matt-lewton9/ME-463-Can-Crusher/C104-005 Panel_twocan_smol_smol200.png

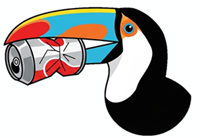
C104-005 Panel_twocan_smol_smol200.png
