matt-lewton9/ME-463-Can-Crusher/PRE-RELEASE DWG/C103-004_PISTON PRE-RELEASE.pdf

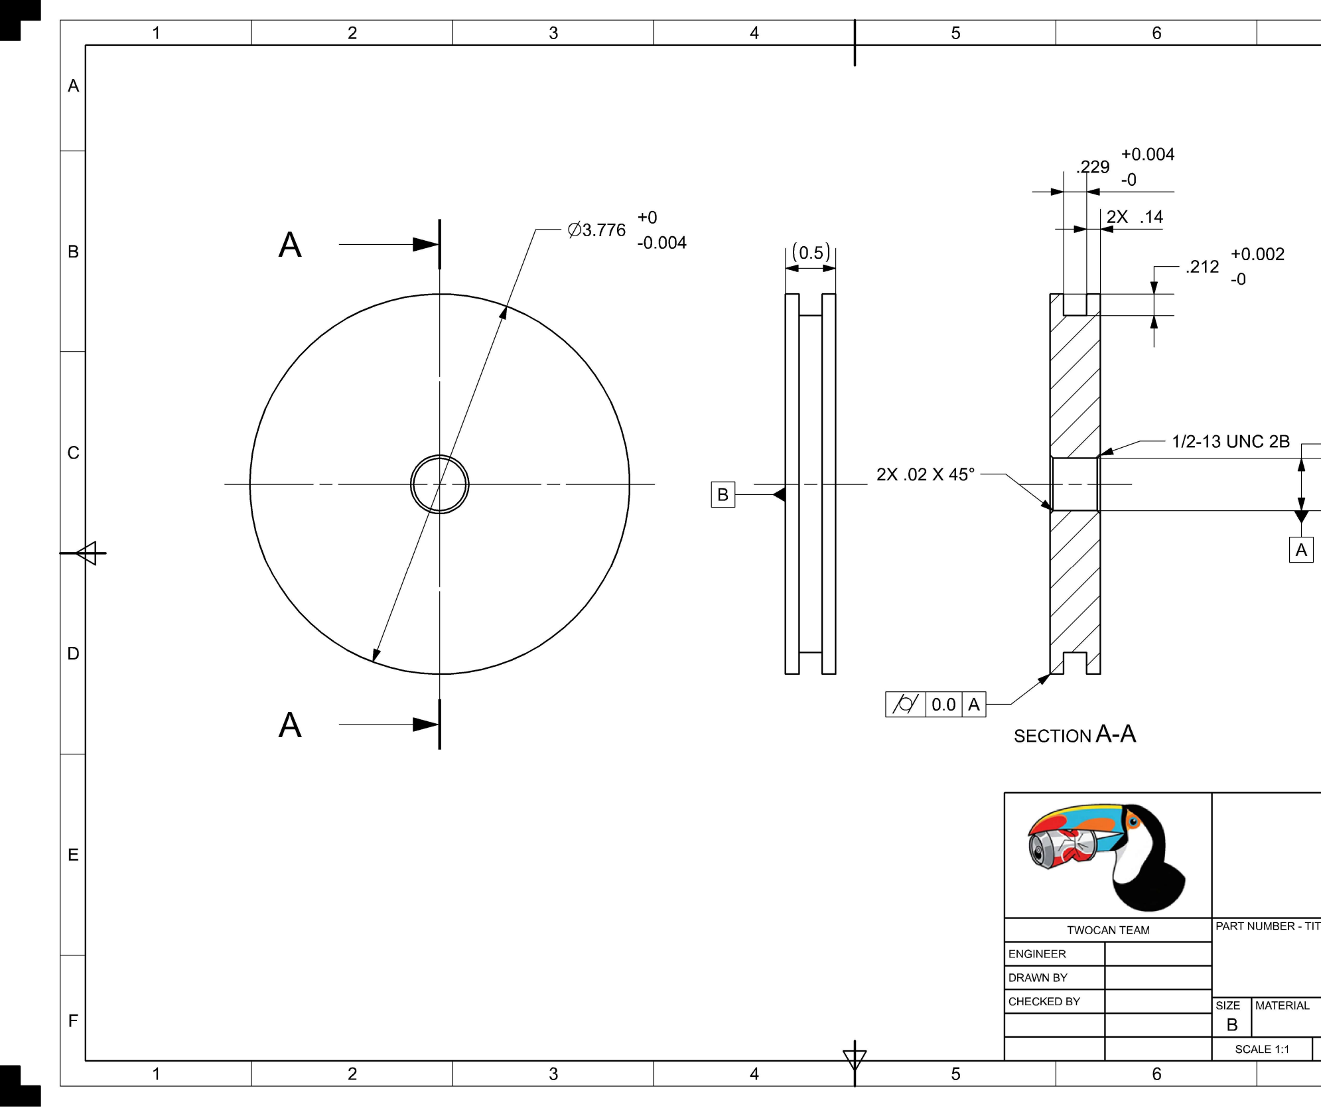
[picture p18: page 1]
