matt-lewton9/ME-463-Can-Crusher/PRE-RELEASE DWG/C104-001 REGULATOR PLATE_dwg1_PRE-RELEASE.pdf

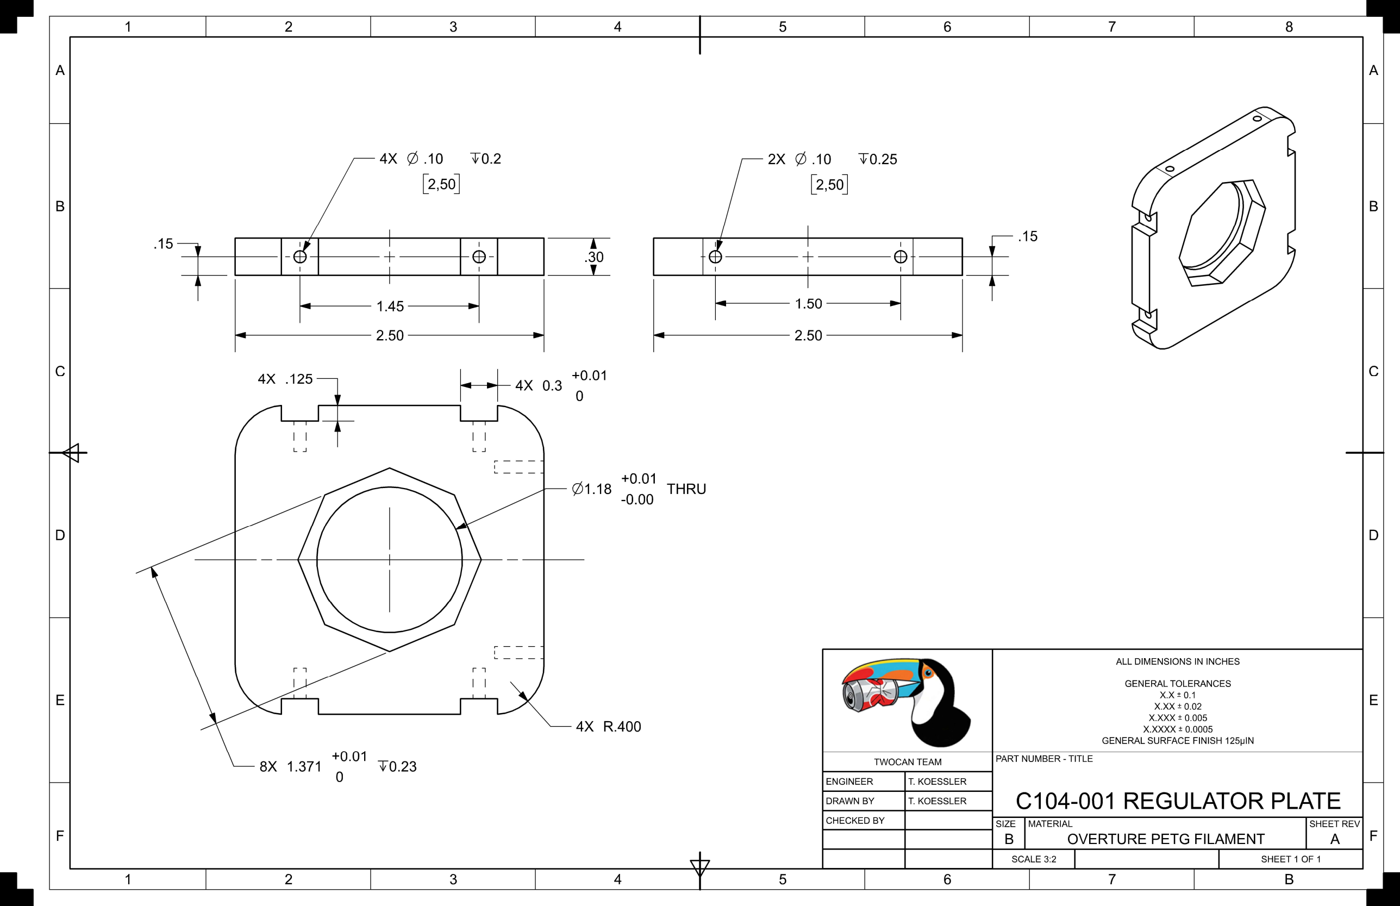
[picture p19: page 1]
