matt-lewton9/ME-463-Can-Crusher/PRE-RELEASE DWG/C104-002 STEPPER PLATE_dwg1_PRE-RELEASE.pdf

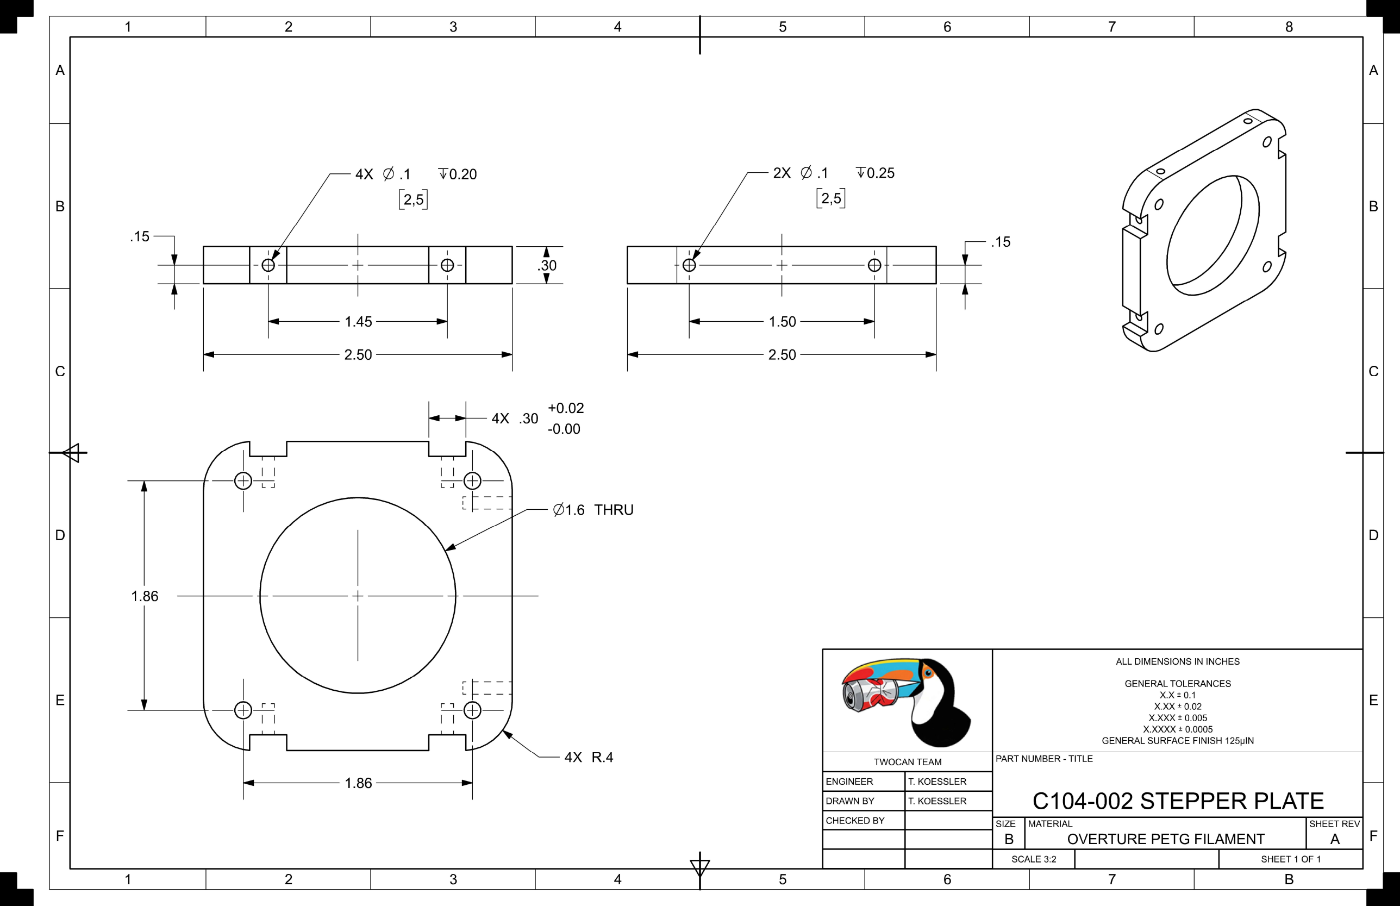
[picture p20: page 1]
