matt-lewton9/ME-463-Can-Crusher/PRE-RELEASE DWG/C104-003 FRAME MONTING_dwg1.pdf

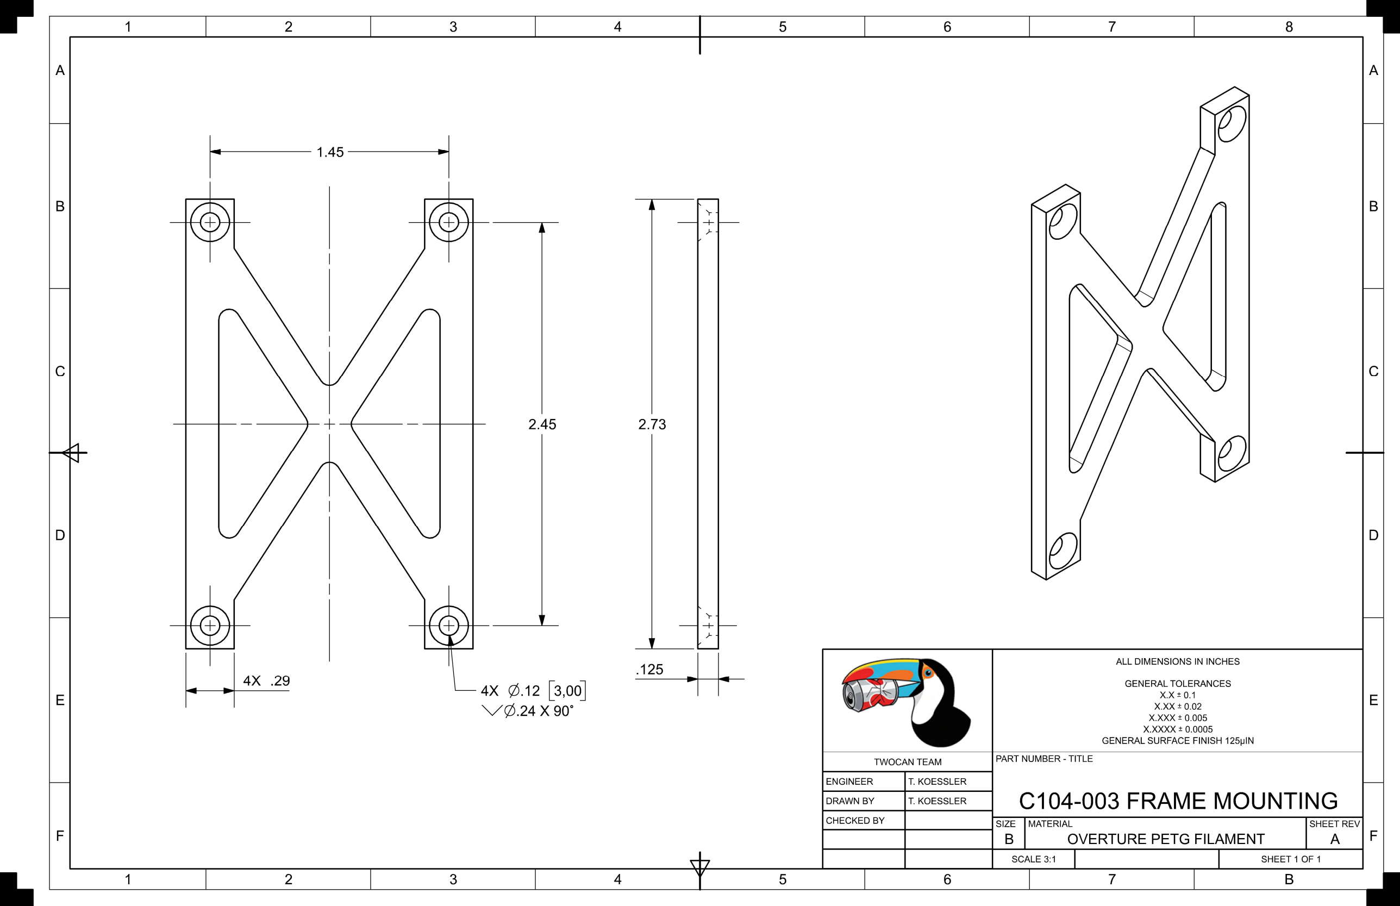
[picture p21: page 1]
