matt-lewton9/ME-463-Can-Crusher/PRE-RELEASE DWG/C104-004 COG_dwg1.pdf

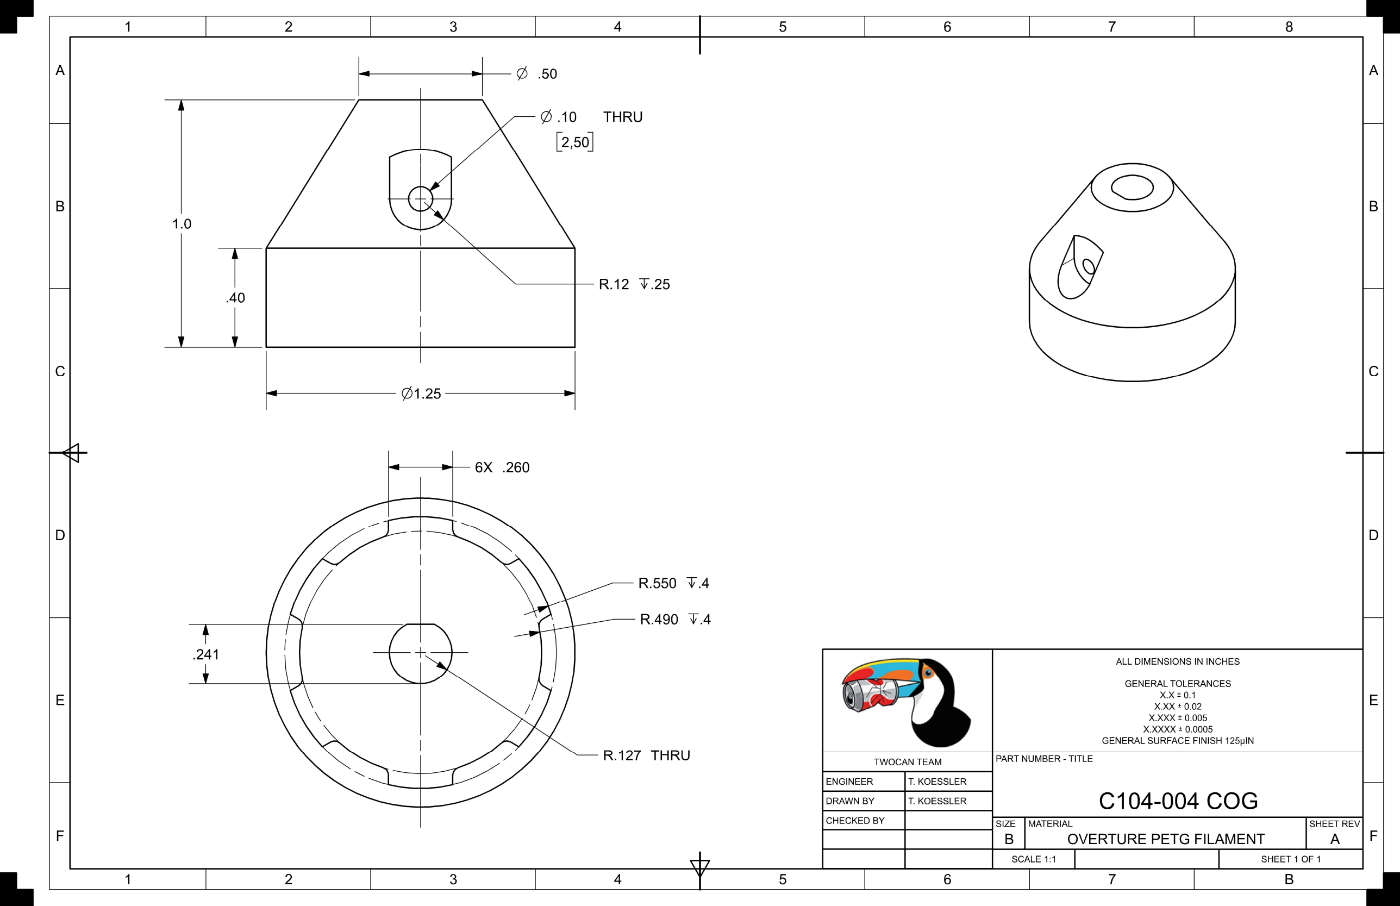
[picture p22: page 1]
