matt-lewton9/ME-463-Can-Crusher/Controller/controller_V3_matlab/FSM_DRAFT/IMG_4139.jpg

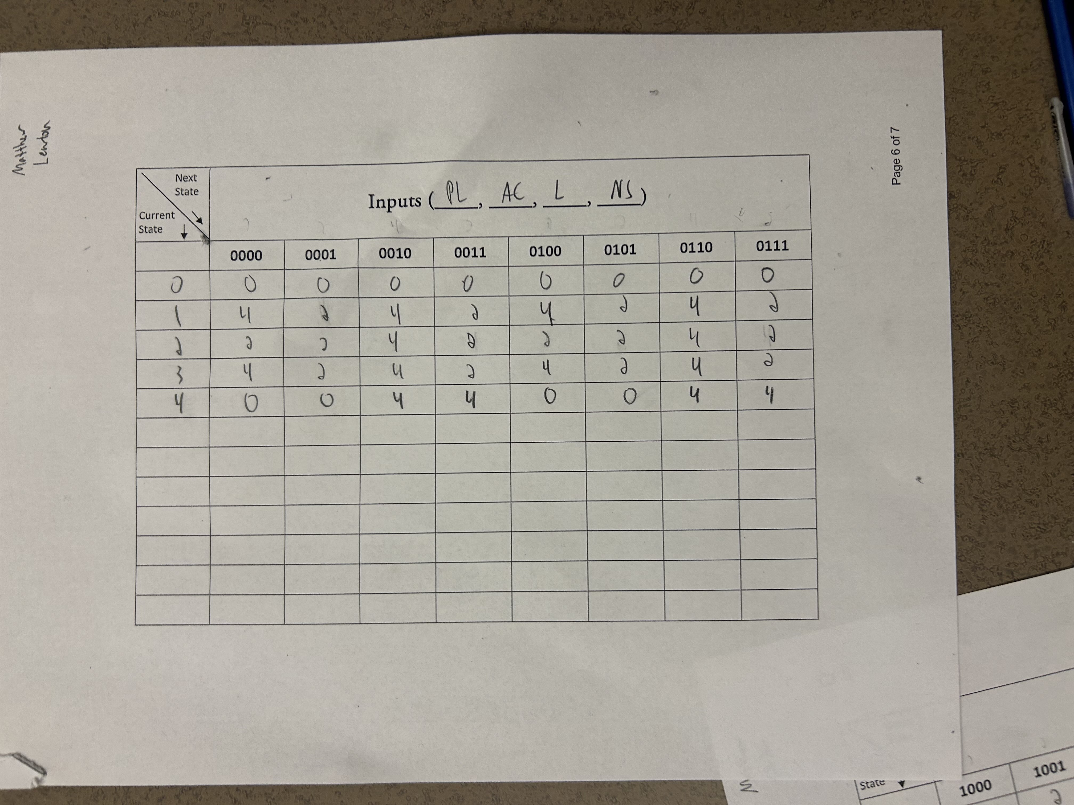
Controller/controller_V3_matlab/FSM_DRAFT/IMG_4139.jpg
