matt-lewton9/ME-463-Can-Crusher/pelim proto/C101-501 BOTTOM STRUCTURE ASSEMBLY.3mf

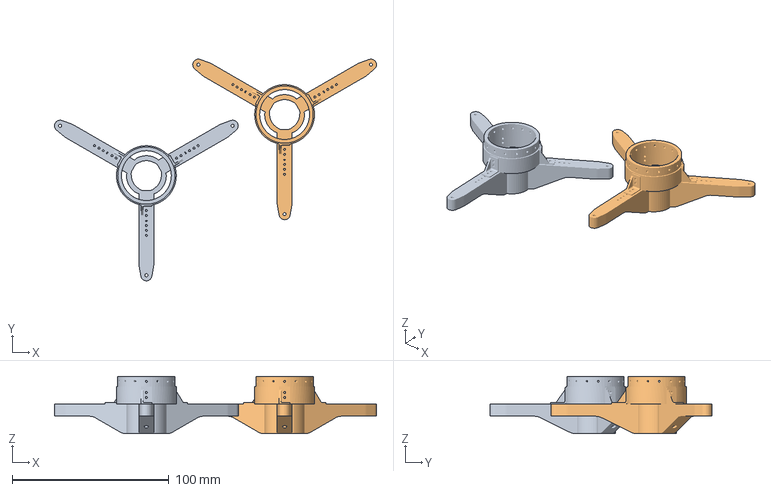
[picture p25: CAD file, 2025-09-25]
pelim proto/C101-501 BOTTOM STRUCTURE ASSEMBLY.3mf
205.2 x 141.3 x 36.5 mm
C101-501 BOTTOM STRUCTURE ASSEMBLY x 2
