matt-lewton9/ME-463-Can-Crusher/pelim proto/C102-501 TOP STRUCTURE ASSEMBLY.3mf

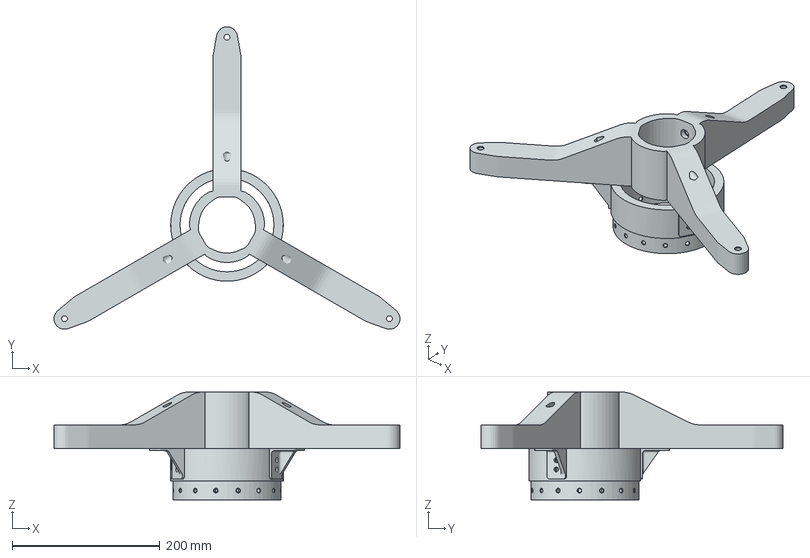
[picture p26: CAD file, 2025-09-25]
pelim proto/C102-501 TOP STRUCTURE ASSEMBLY.3mf
468.4 x 409.5 x 146.0 mm
