matt-lewton9/ME-463-Can-Crusher/MFG_Files/pulley_plates.dxf

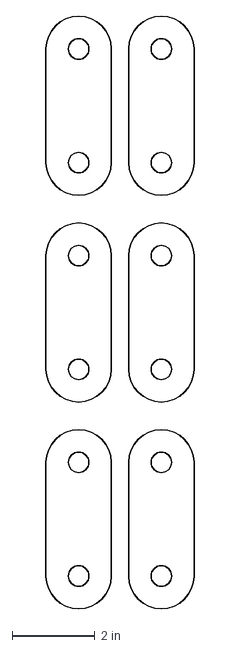
[picture p27: CAD file, 2025-11-15]
MFG_Files/pulley_plates.dxf
3.58 x 14.3 in
