matt-lewton9/ME-463-Can-Crusher/pelim proto/toob.3mf

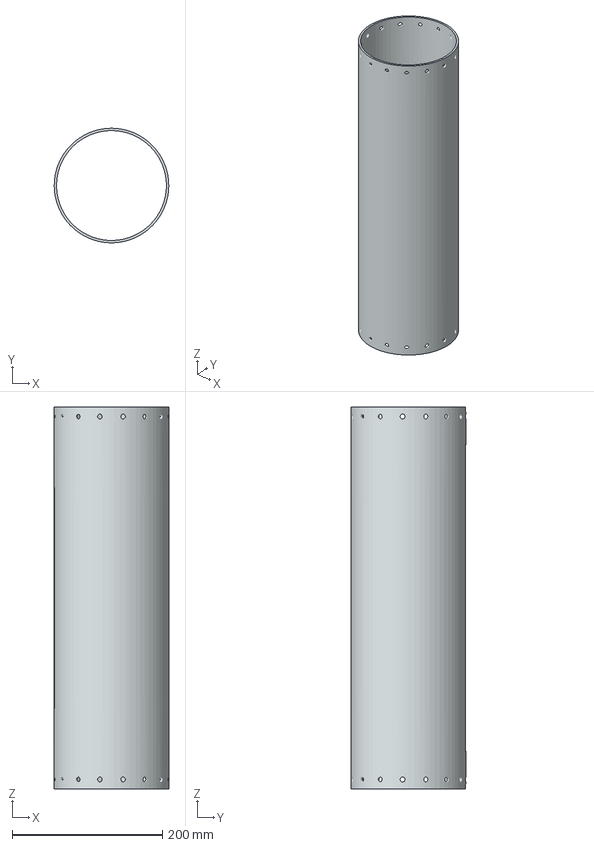
[picture p28: CAD file, 2025-09-25]
pelim proto/toob.3mf
152.4 x 152.3 x 508.0 mm
