matt-lewton9/ME-463-Can-Crusher/STL/C104-004 COG.3mf

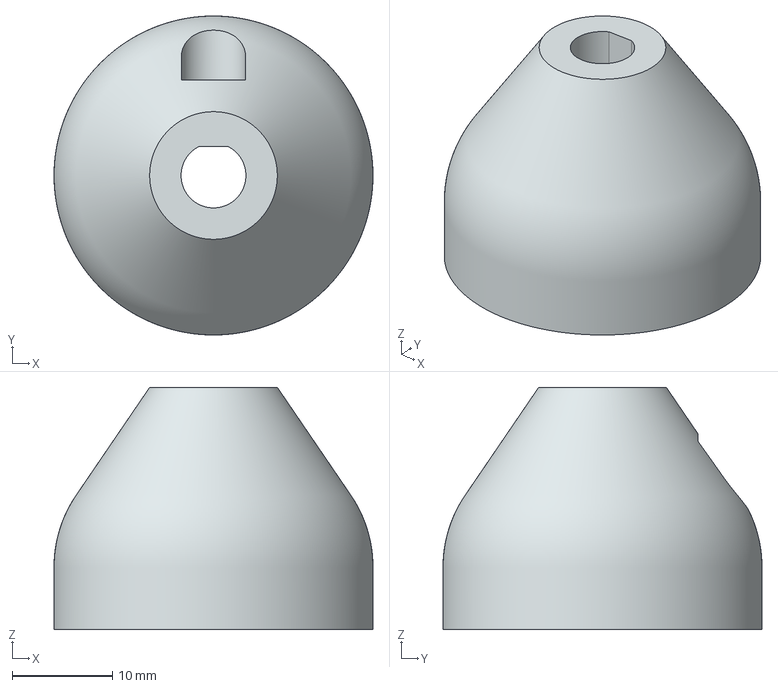
[picture p29: CAD file, 2025-11-19]
STL/C104-004 COG.3mf
31.8 x 31.7 x 24.1 mm
