matt-lewton9/ME-463-Can-Crusher/MFG_Files/R00-003 Customer Jig Connector.3mf

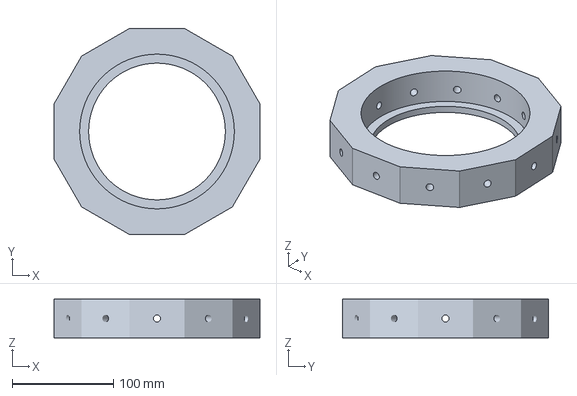
[picture p30: CAD file, 2025-11-15]
MFG_Files/R00-003 Customer Jig Connector.3mf
203.6 x 203.6 x 38.1 mm
