matt-lewton9/ME-463-Can-Crusher/STL/R00-003 Customer Jig Connector.stl

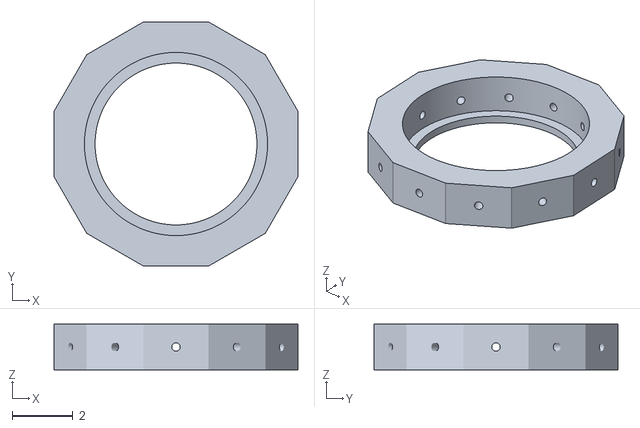
[picture p31: CAD file, 2025-11-15]
STL/R00-003 Customer Jig Connector.stl
8.02 x 8.02 x 1.50
