matt-lewton9/ME-463-Can-Crusher/MFG_Files/STRUT_DXF.dxf

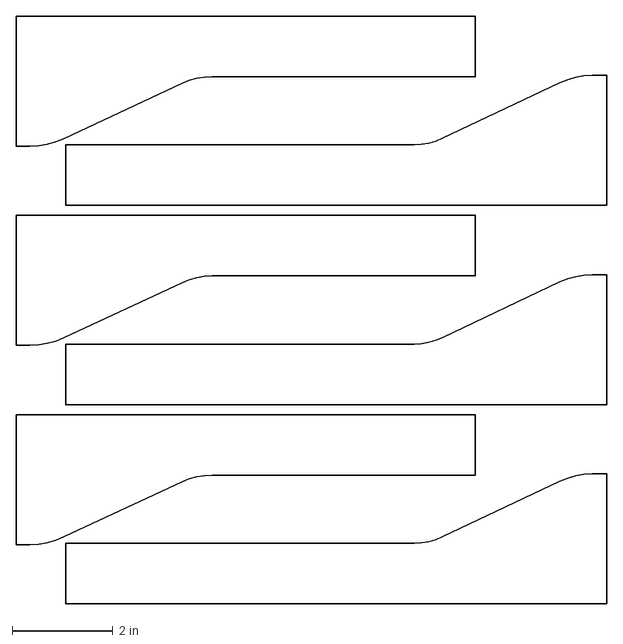
[picture p32: CAD file, 2025-10-31]
MFG_Files/STRUT_DXF.dxf
11.7 x 11.7 in
