matt-lewton9/ME-463-Can-Crusher/STL/C104-001 REGULATOR PLATE_22-5_DEG.stl

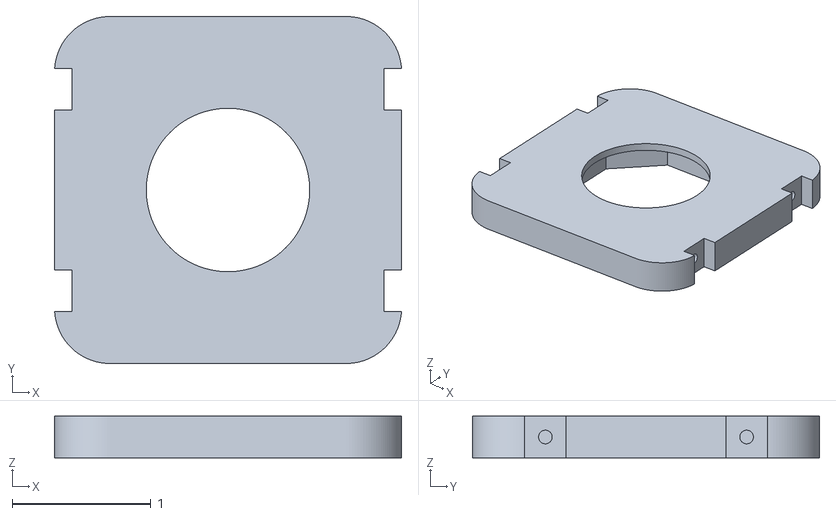
[picture p33: CAD file, 2025-11-05]
STL/C104-001 REGULATOR PLATE_22-5_DEG.stl
2.50 x 2.50 x 0.3
