matt-lewton9/ME-463-Can-Crusher/STL/C104-003 FRAME MOUNTING.stl

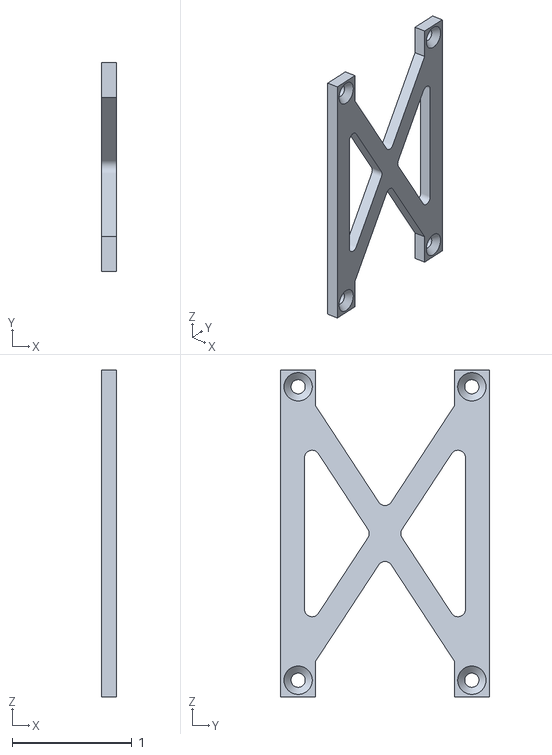
[picture p34: CAD file, 2025-11-05]
STL/C104-003 FRAME MOUNTING.stl
0.125 x 1.74 x 2.73
