matt-lewton9/ME-463-Can-Crusher/STL/C104-002 STEPPER PLATE.stl

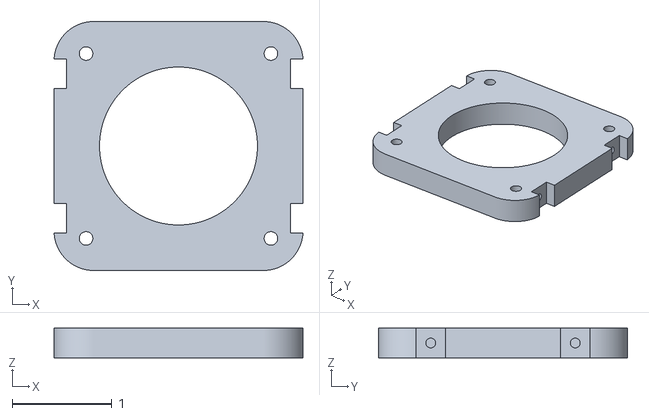
[picture p35: CAD file, 2025-11-02]
STL/C104-002 STEPPER PLATE.stl
2.50 x 2.50 x 0.3
