matt-lewton9/ME-463-Can-Crusher/COTS Bodies/23HS22-2804S-Nema 23 Stepper Motor.STEP

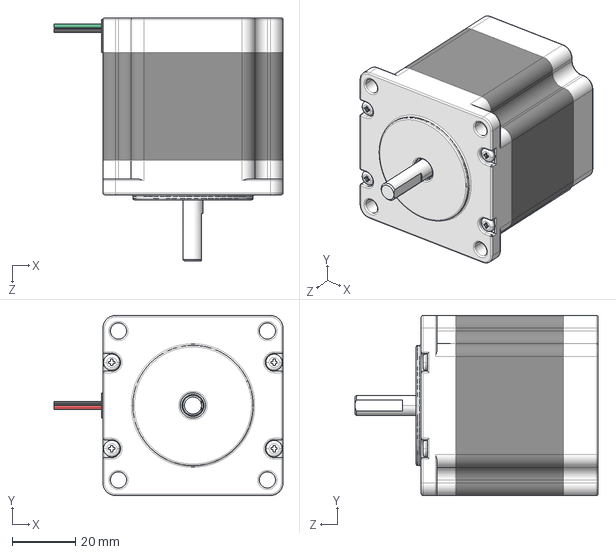
[picture p36: CAD file, 2025-10-09]
COTS Bodies/23HS22-2804S-Nema 23 Stepper Motor.STEP
72.5 x 57.0 x 77.0 mm
