matt-lewton9/ME-463-Can-Crusher/COTS Bodies/17HS15-1504S-Nema 17 Stepper Motor.STEP

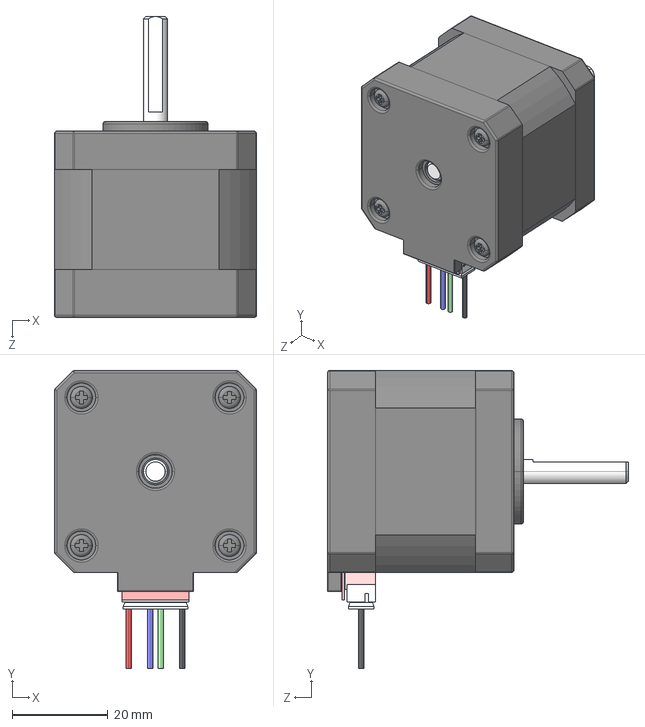
[picture p37: CAD file, 2025-09-29]
COTS Bodies/17HS15-1504S-Nema 17 Stepper Motor.STEP
42.3 x 62.4 x 63.0 mm
