matt-lewton9/ME-463-Can-Crusher/COTS Bodies/92196A268_18-8 Stainless Steel Socket Head Screw.STEP

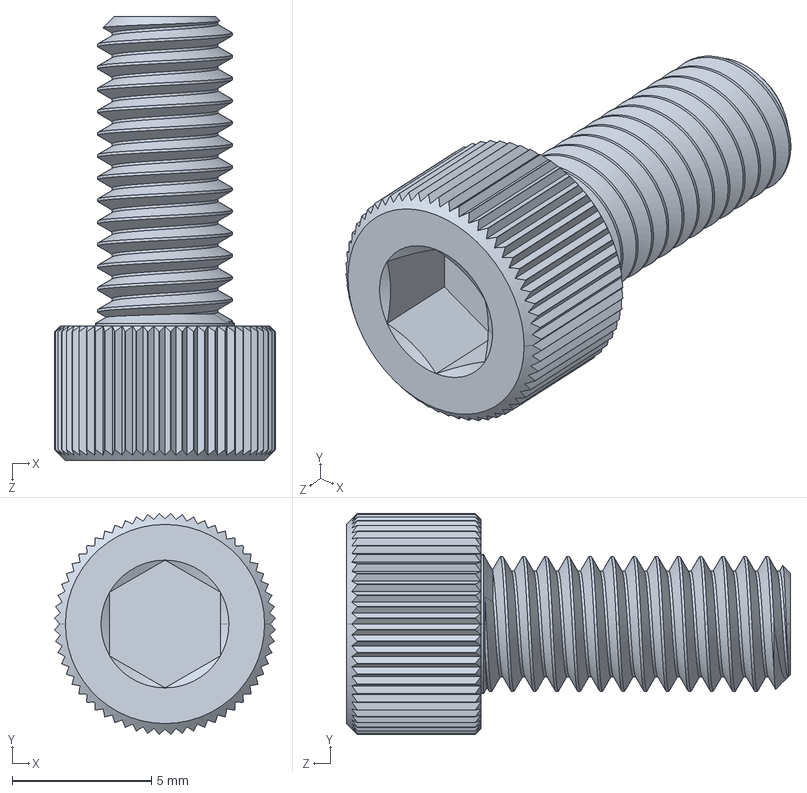
[picture p38: CAD file, 2025-10-15]
COTS Bodies/92196A268_18-8 Stainless Steel Socket Head Screw.STEP
7.93 x 7.93 x 15.9 mm
