matt-lewton9/ME-463-Can-Crusher/94846A209_NUT-1-2-13_THIN.STEP

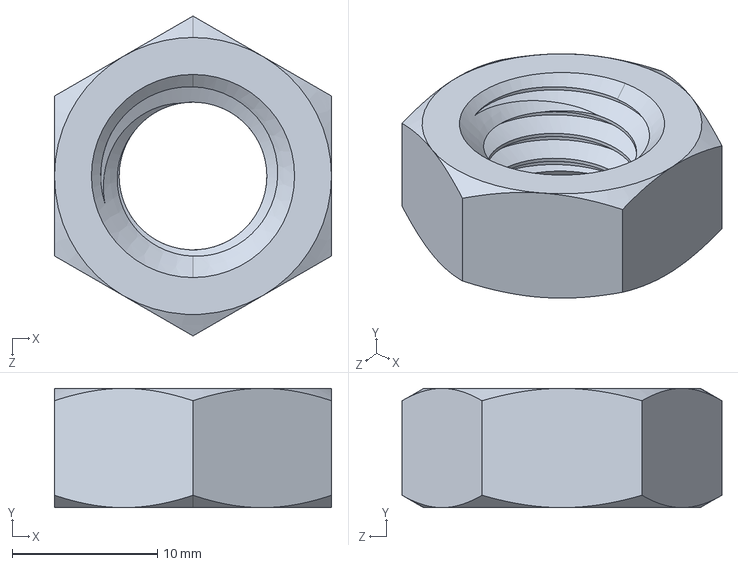
[picture p39: CAD file, 2025-10-22]
94846A209_NUT-1-2-13_THIN.STEP
19.1 x 8.20 x 22.0 mm
