matt-lewton9/ME-463-Can-Crusher/COTS Bodies/92010A118_Passivated 18-8 Stainless Steel Phillips Flat Head Screw.STEP

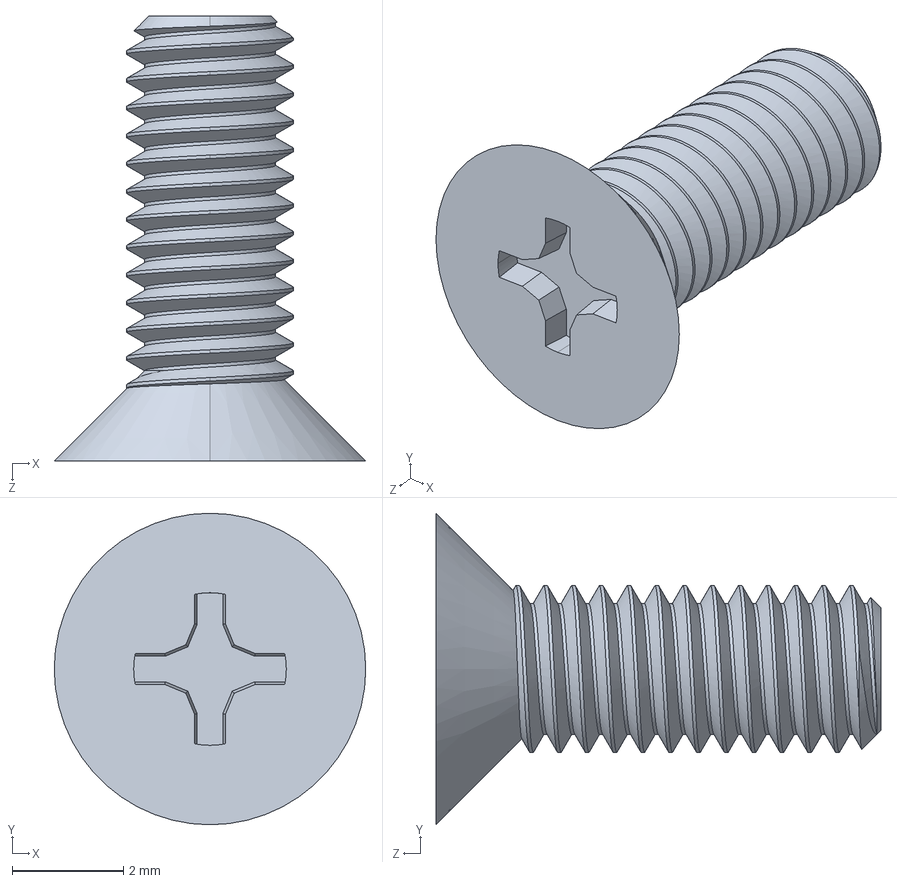
[picture p40: CAD file, 2025-10-15]
COTS Bodies/92010A118_Passivated 18-8 Stainless Steel Phillips Flat Head Screw.STEP
5.60 x 5.60 x 8.00 mm
