matt-lewton9/ME-463-Can-Crusher/(list of files, cad)

Other CAD files:
C104-005 Panel.dwg
STL/C104-001 REGULATOR PLATE_0_DEG.stl
8-24_SPHERICAL_ROD.prt
94846A207-thin-jam-nut.prt
C100-000 LAYOUT.prt
C100-501 CAN CRUSHER ASSEMBLY.prt
C101-000 BOTTOM LAYOUT.prt
C101-001 STRUT.prt
C101-001 STRUT_dwg1.prt
C101-001M10 STRUT WATERJET.prt
C101-001M10 STRUT.prt
C101-002 HUB.prt
C101-002 HUB_dwg1.prt
C101-501 BOTTOM STRUCTURE ASSEMBLY.prt
C102-000 TOP LAYOUT.prt
C102-001 TOP STRUT.prt
C102-001 TOP STRUT_dwg1.prt
C102-501 TOP STRUCTURE ASSEMBLY.prt
C103-000 ACTUATOR LAYOUT.prt
C103-001 CYLINDER TOP CAP.prt
C103-002 CYLINDER WALL PRE-RELEASE.prt
C103-002 CYLINDER WALL.prt
C103-003 CYLINDER BOTTOM CAP.prt
C103-004 CYLINDER PISTON.prt
C103-004 PISTON PRE-RELEASE.prt
C103-005 CYLINDER SHAFT.prt
C103-005 CYLINDER SHAFT_dwg.prt
C103-006 CABLE NUT.prt
C103-006 MANIFOLD.prt
C103-006 MANIFOLD_PRE-RELEASE.prt
C103-501 ACTUATOR ASSEMBLY.prt
C104-000 FLUIDS PANEL LAYOUT.prt
C104-001 REGULATOR PLATE.prt
C104-001 REGULATOR PLATE_dwg1.prt
C104-002 STEPPER PLATE.prt
C104-002 STEPPER PLATE_dwg1.prt
C104-003 FRAME MOUNTING.prt
C104-003 FRAME MOUNTING_dwg1.prt
C104-004 COG.prt
C104-004 COG_dwg1.prt
C104-005 Panel.prt
C104-006 Manifold.prt
C104-007 NC TO MANIFOLD TUBE.prt
C104-008 MANIFOLD TO RV1.prt
C104-009 NC VALVE.prt
C104-010 MANIFOLD TO RV2.prt
C104-011 MANIFOLD TO RV3.prt
C104-501 FLUIDS PANEL ASSEMBLY.prt
C105-000 CUSTOMER HARDWARE LAYOUT.prt
C105-001 CUSTOMER AIRFRAME.prt
C105-001 CUSTOMER AIRFRAME_dwg1.prt
C105-002 CUSTOMER CONNECTOR.prt
C105-002 CUSTOMER CONNECTOR_dwg1.prt
C105-003 CONNECTOR BRACKET.prt
C105-003 CONNECTOR BRACKET_dwg1.prt
C105-501 CUSTOMER HARDWARE ASSEMBLY.prt
C106-000 PULLEY CHAIN LAYOUT.prt
C106-001 PULLEY.prt
C106-001 PULLEY_dwg1.prt
C106-002 PULLEY PLATE.prt
C106-002 PULLEY PLATE_dwg1.prt
C106-003 PULLEY BUSHING.prt
C106-004 CABLE.prt
C106-501 PULLEY CHAN ASSEMBLY.prt
C107-000 ESTOP BOX LAYOUT.prt
C107-001 ESTOP LID.prt
C107-001 ESTOP LID_dwg1.prt
C107-002 ESTOP BOX.prt
C107-002 ESTOP BOX_dwg1.prt
C107-501 ESTOP BOX ASSEMBLY.prt
C108-000 PT BOX LAYOUT.prt
C109-000 SG BOX LAYOUT.prt
C110-000 DRIVER 8020 MOUNT.prt
COTS Bodies/3014T491_Steel Eyebolt with Shoulder - for Lifting.STEP
COTS Bodies/5905K502_Needle-Roller Bearing.STEP
COTS Bodies/60645K161_Ball Joint Rod End.STEP
COTS Bodies/8947T18_Oval-Shaped Threaded Connecting Link.STEP
COTS Bodies/90128A242__1-4-20_Zinc-Plated Alloy Steel Socket Head Screw.STEP
COTS Bodies/90128A365_1-4-28_Zinc-Plated Alloy Steel Socket Head Screw.STEP
COTS Bodies/90128A844_1-2-20_Zinc-Plated Alloy Steel Socket Head Screw.STEP
COTS Bodies/92844A147_1-2_Stainless Steel Washer for Soft Material.STEP
COTS Bodies/94744A516_1-4_WASHER_Zinc-Plated Steel Washer for Soft Material.STEP
COTS Bodies/94846A210_1-2-20_JAM_NUT_Medium-Strength Steel Thin Hex Nut.STEP
COTS Bodies/94846A210_NO THREADS_Medium-Strength Steel Thin Hex Nut.STEP
COTS Bodies/98306A951_1004-1045 0.5in Carbon Steel Clevis Pin.STEP
COTS Bodies/C104-008 Tube4NCValveToManifold.prt
FW-LOCK-NUT.prt
MCM-3014T491_1-2-14_EYE_BOLT.prt
MCM-94846A209 1-2-13 JAM NUT.prt
MCM-94846A209_1-2-20 JAM NUT.prt
MCM_3494T11_THIMBLE.prt
MCM_5905K502_NEEDLE_BEARING.prt
MCM_60645K16_1-2_SPHERICAL_ROD_END.prt
MCM_8947T18_QUICK_LINK.prt
MCM_90128A242_1-4-20 SOCKET HEAD.prt
MCM_90128A365_1-4-28_SOCKET_HEAD.prt
MCM_90128A844_1-2-20_SOCKET_HEAD.prt
MCM_91251A346_10-32_7_8.prt
MCM_92196A268_10-32_7-16_SOCKET_HEAD_SCREW.prt
MCM_92196A268_M3-8_PHILLIPS_SCREW.prt
MCM_92844A147_1-2_WASHER.prt
MCM_92865A250_PNE_MAIN_BOLT.prt
MCM_94744A516_1-4+WASHER.prt
MCM_94744A516_1-4_WASHER.prt
MCM_95505A601_PNE_MAIN_NUT.prt
MCM_96144A256_10-32_1.5_Length Screw.prt
MCM_98023A115_PNE_MAIN_WASHER.prt
MCM_98306A951_1-2_CLEVIS PIN.prt
PRE-RELEASE DWG/C103-002 CYLINDER WALL PRE-RELEASE.prt
PRE-RELEASE DWG/C103-004 PISTON PRE-RELEASE.prt
PRE-RELEASE DWG/C103-006 MANIFOLD_PRE-RELEASE.prt
R00-003 Customer Jig Connector.prt
R00-01R Regulator.prt
R00-02R union.prt
R101 BOT STR FEA EXPORT.prt
R102 TOP STR FEA EXPORT.prt
R103 INTEGRATED FEA EXPORT.prt
R201 Pneumatic FEA Assembly.prt
SO_23HS22-2804S_NEMA23.prt
STL/C104-004 COG.stl
TEMPLATE.prt
YW-CN(-N).prt
YW-Exx(R).prt
YW1B-V4-BODY.prt
