matt-lewton9/ME-463-Can-Crusher/RELEASED DWG/E100-001 ELECTRICAL SCHEMATIC.pdf

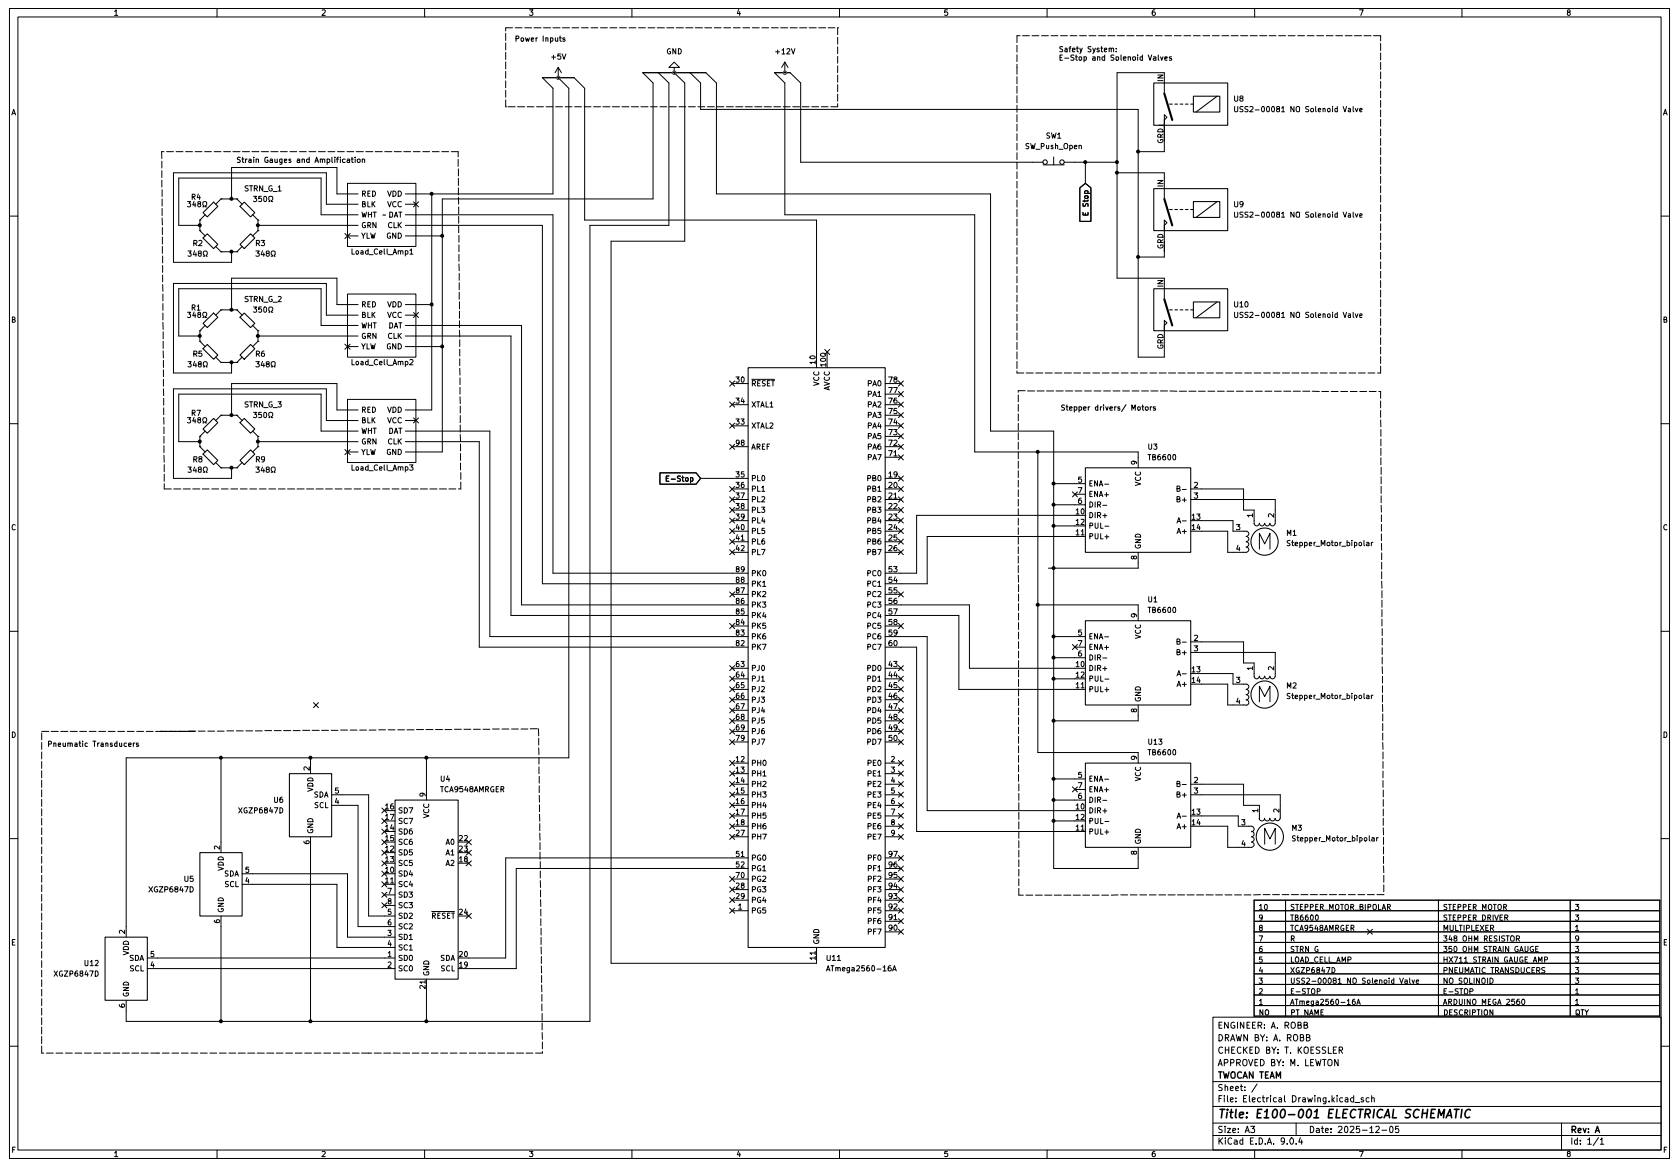
[picture p41: page 1]
