matt-lewton9/ME-463-Can-Crusher/PRE-RELEASE DWG/C107-501 ESTOP BOX ASSEMBLY_PRE-RELEASE.pdf

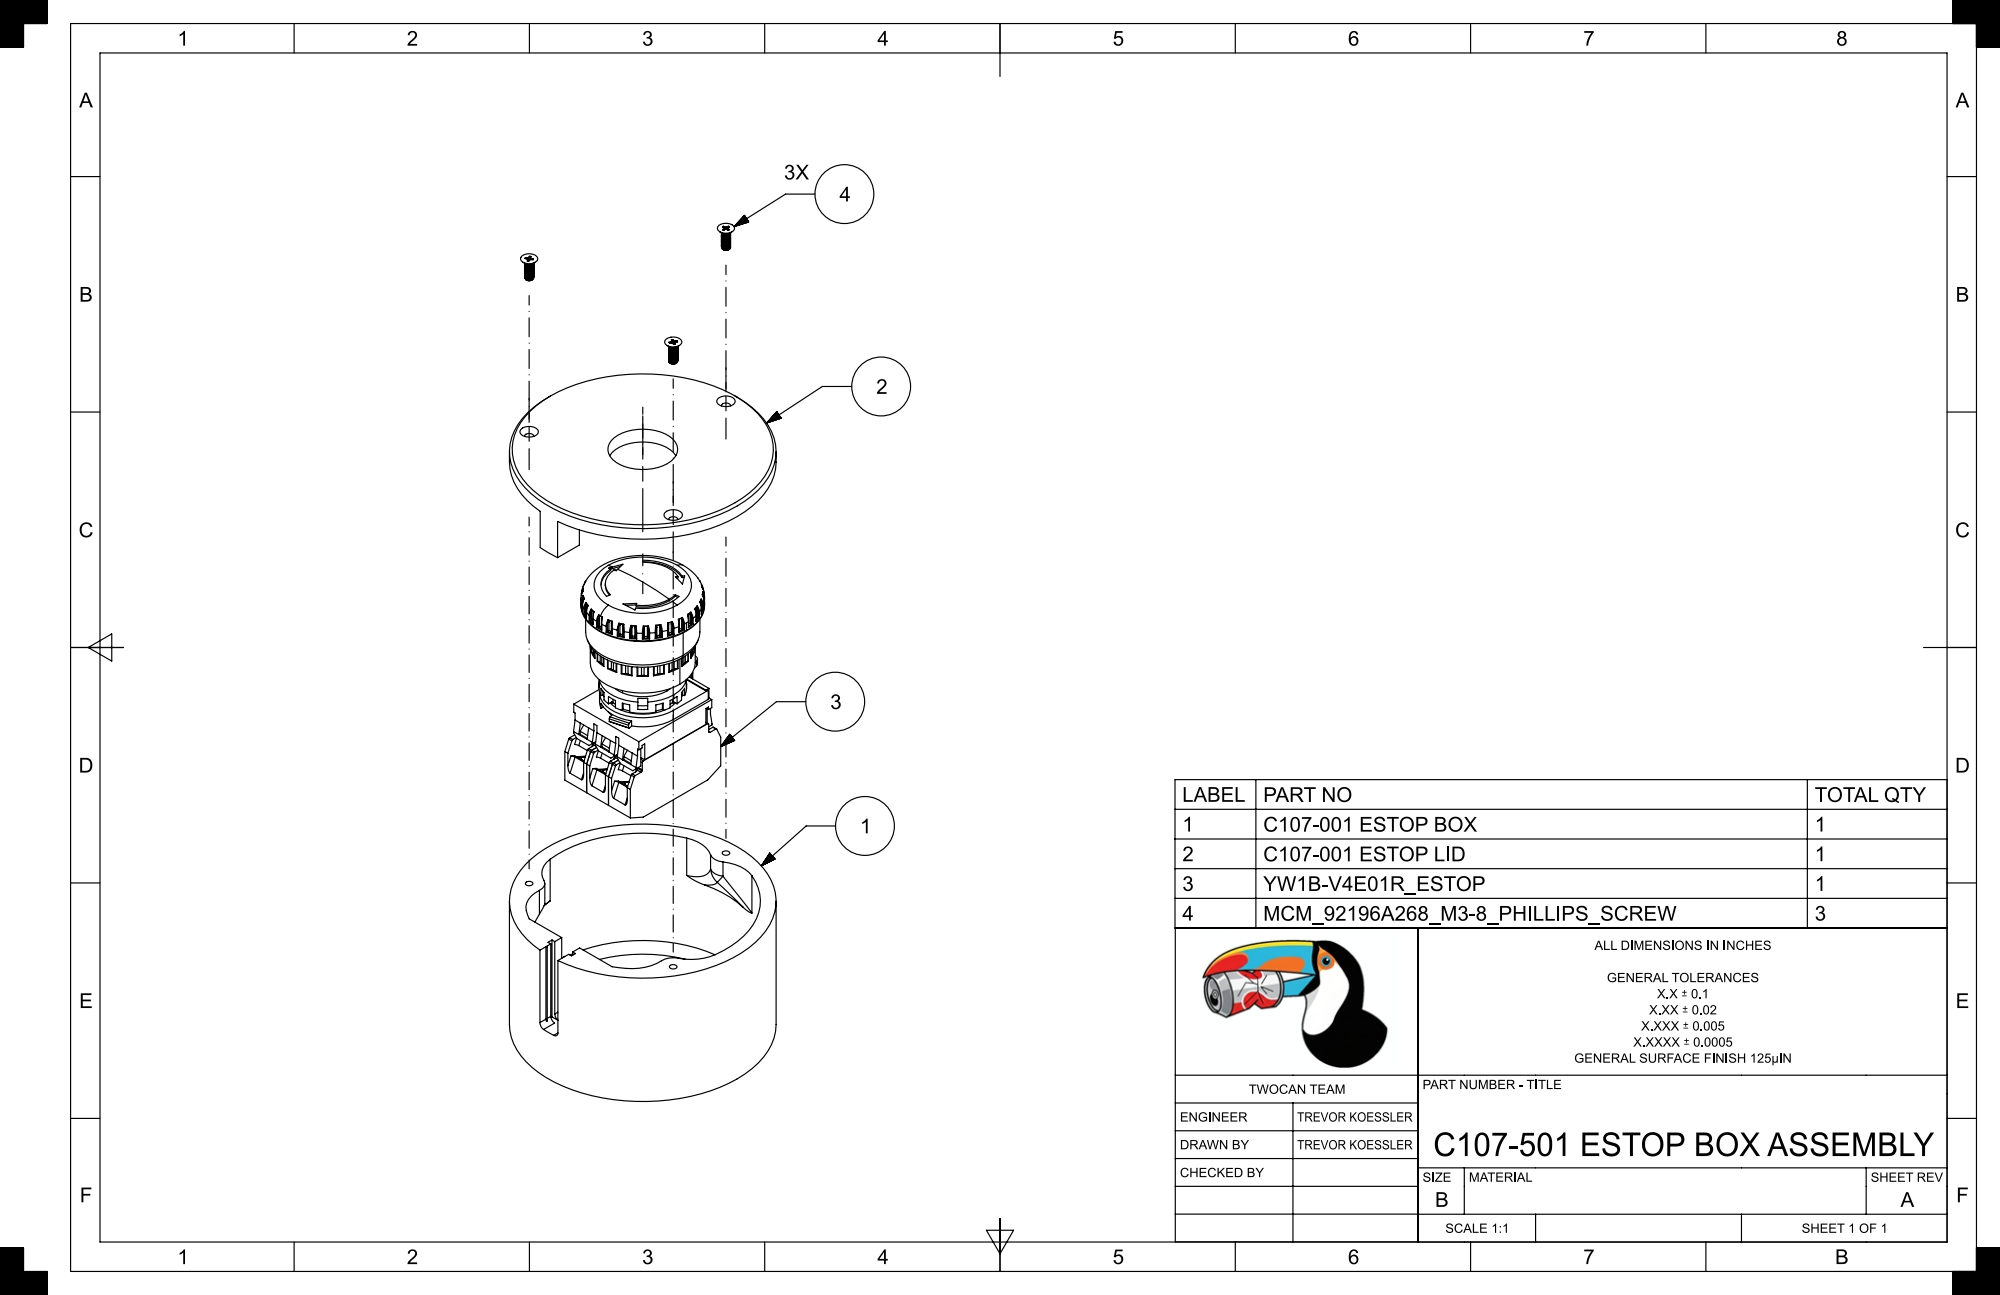
[picture p42: page 1]
