matt-lewton9/ME-463-Can-Crusher/RELEASED DWG/C100-501 CAN CRUSHER ASSEMBLY.pdf

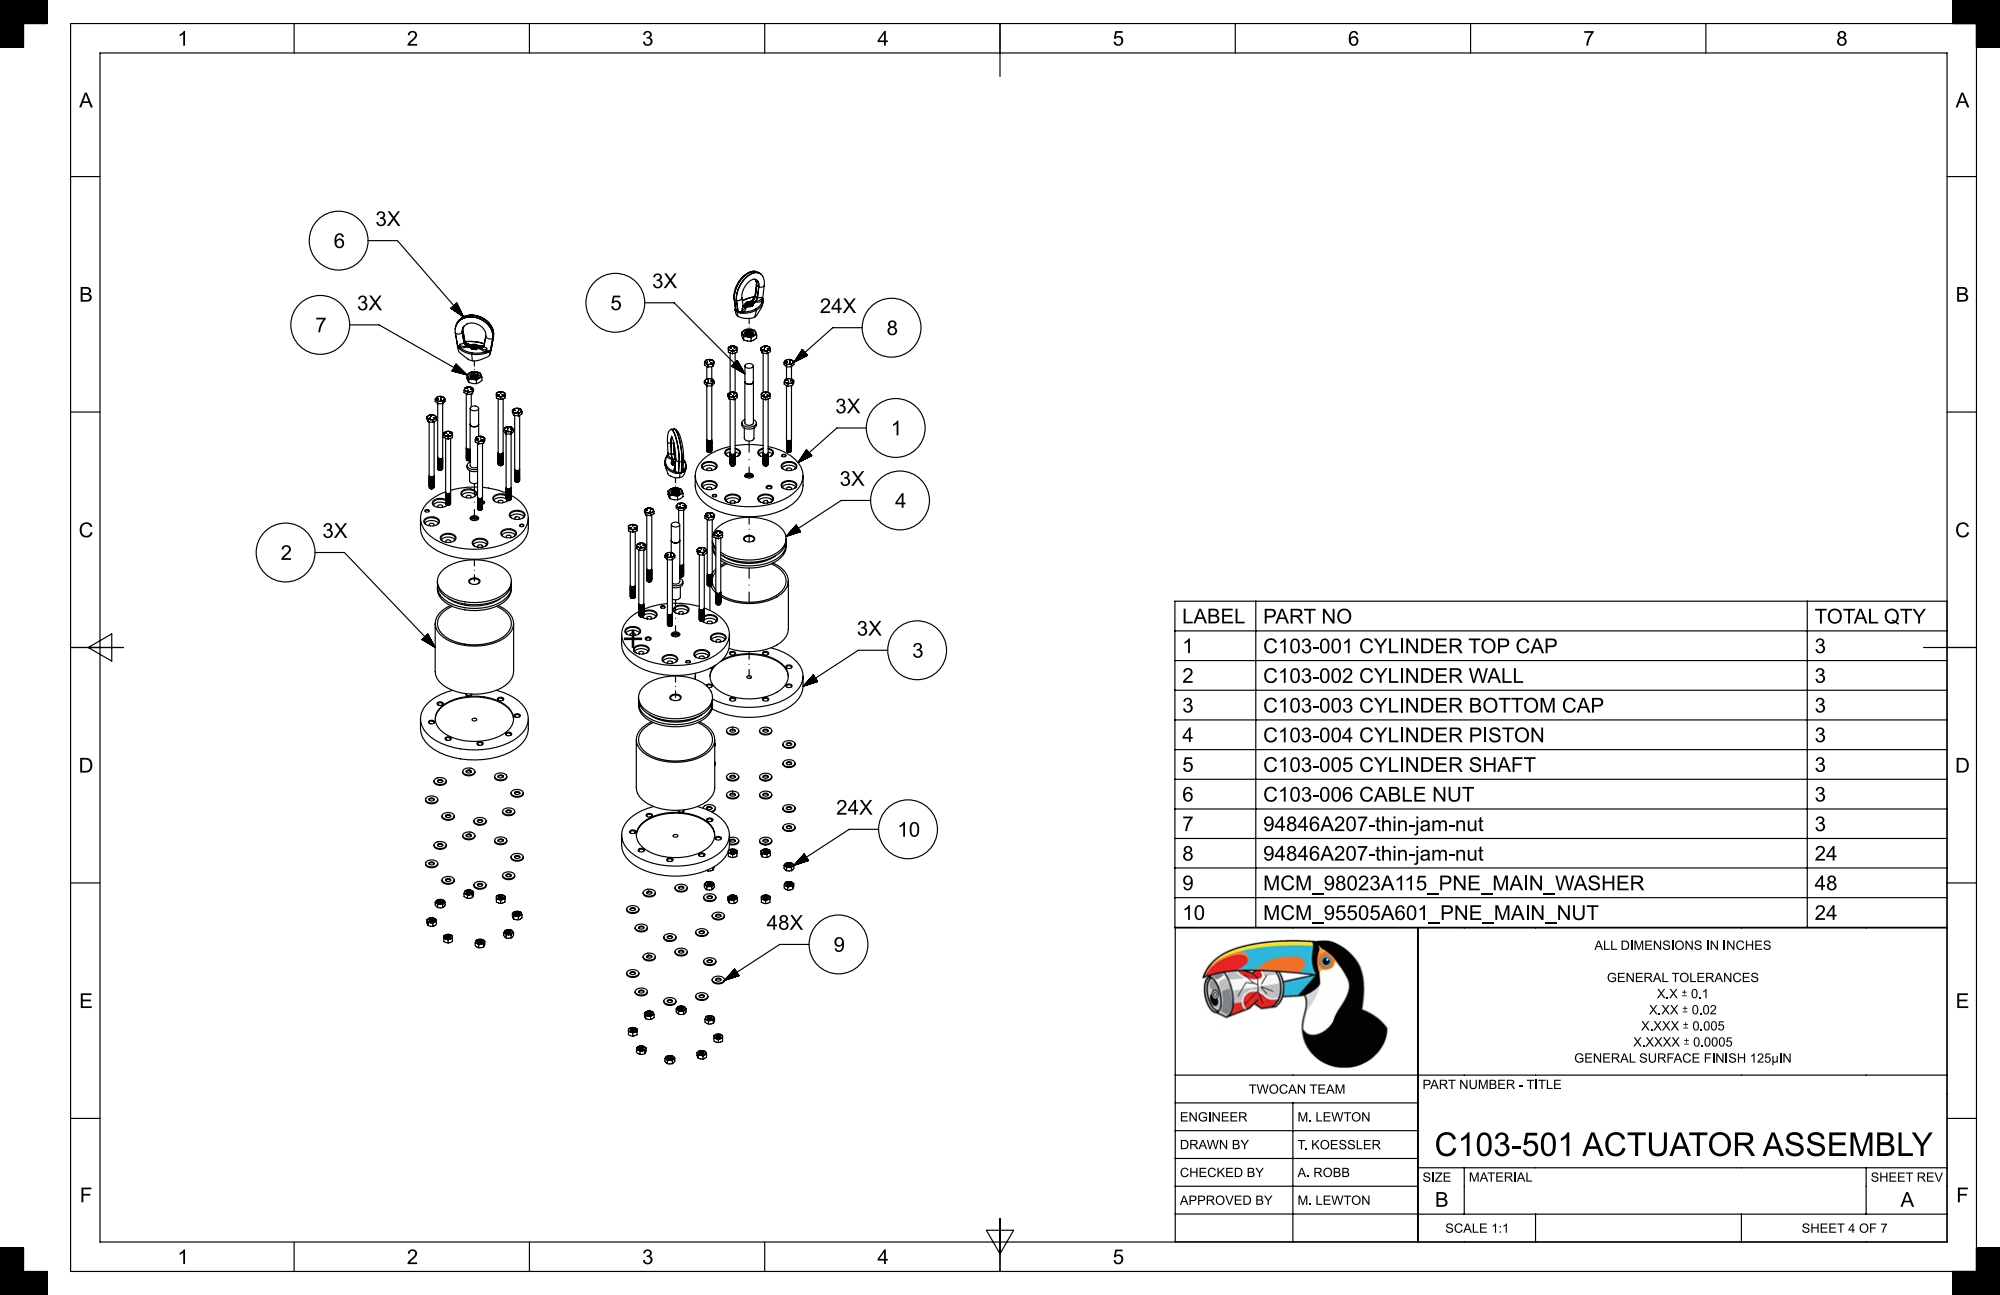
[picture p43: page 1]

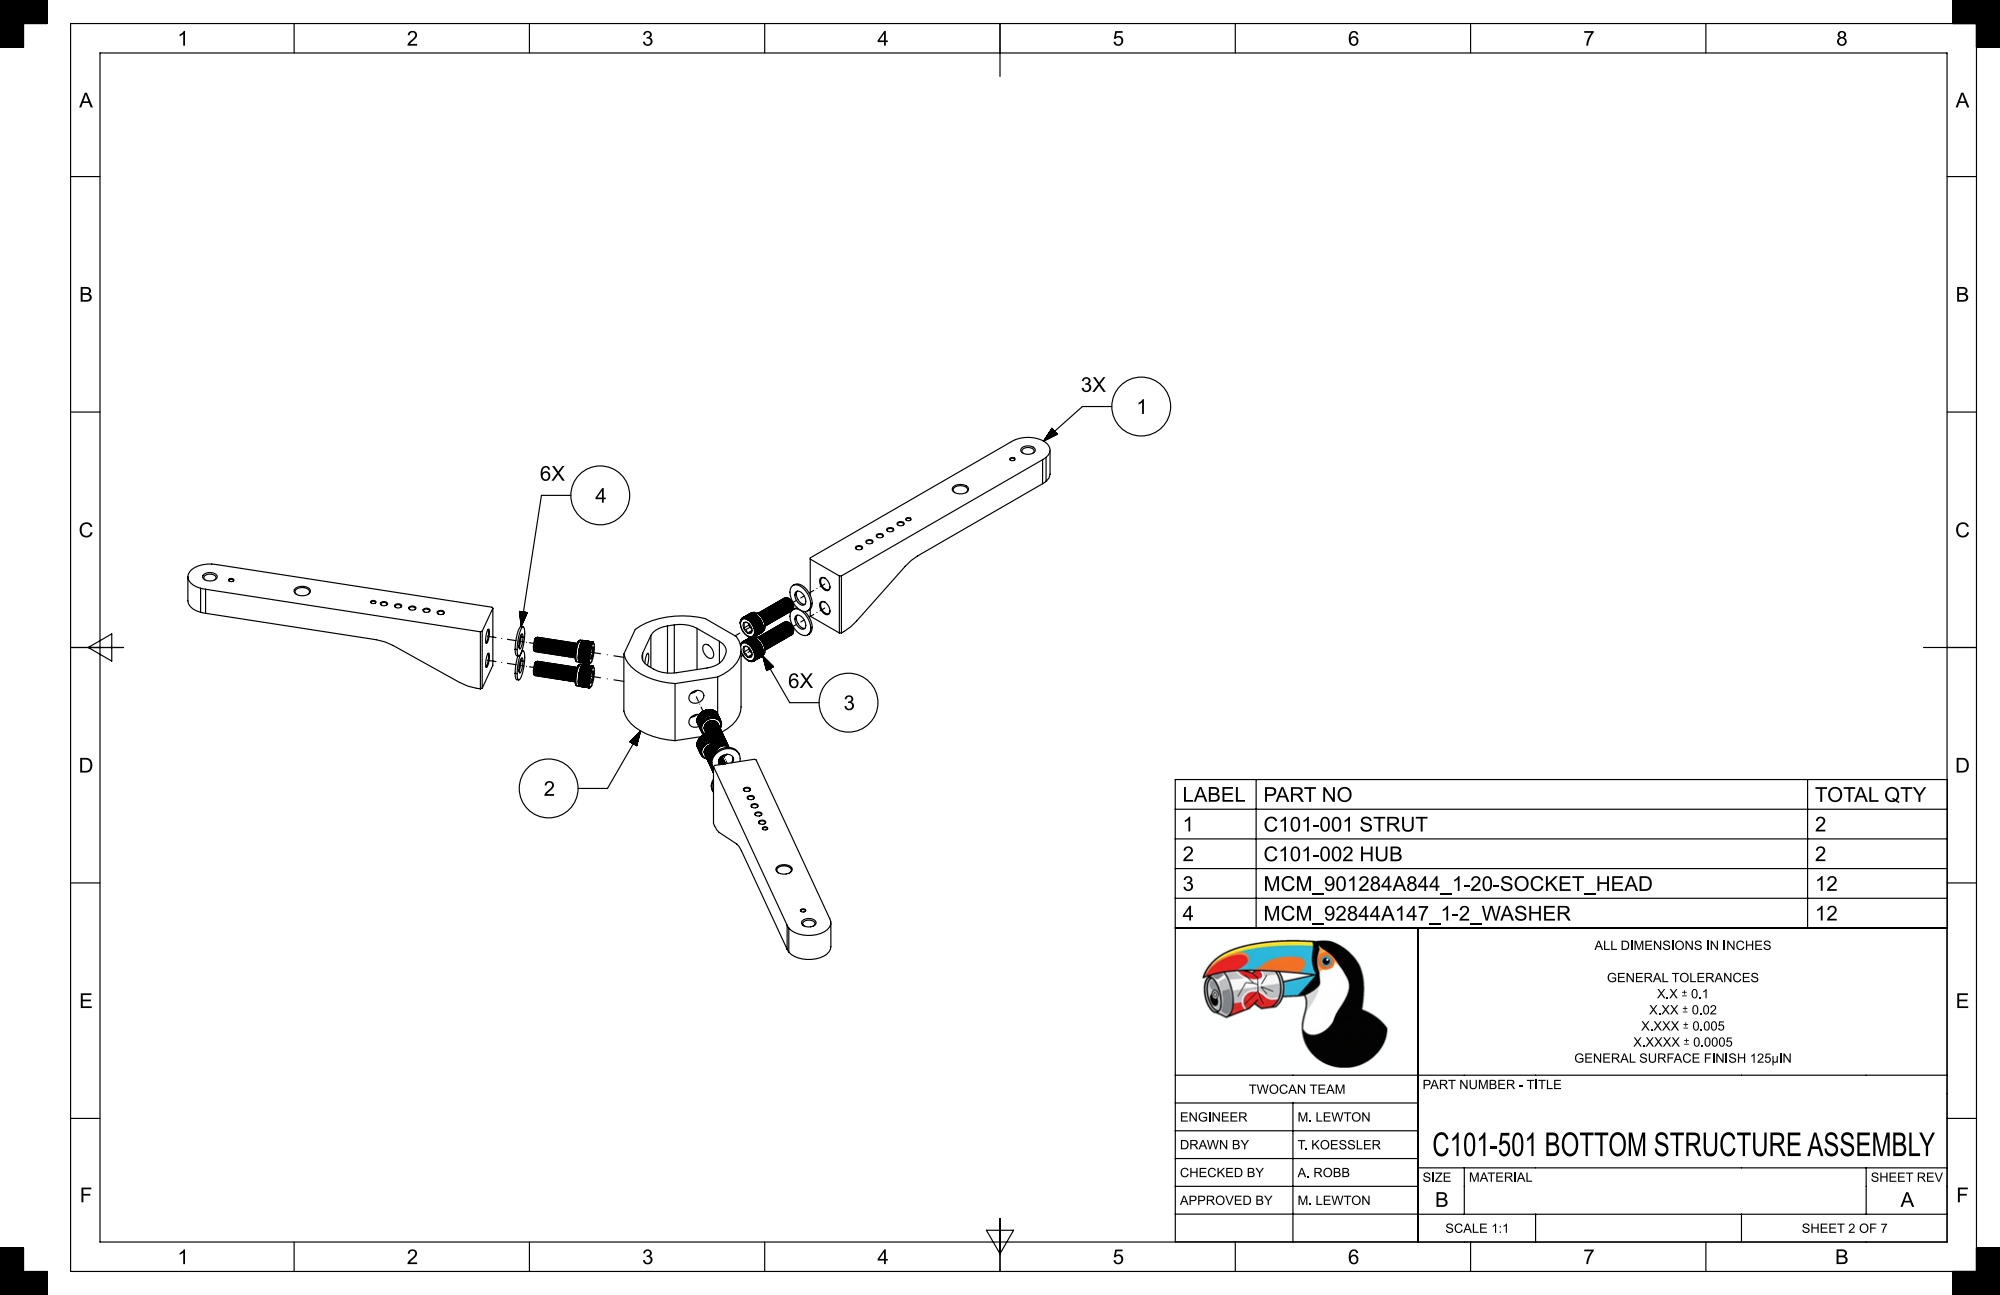
[picture p44: page 2]

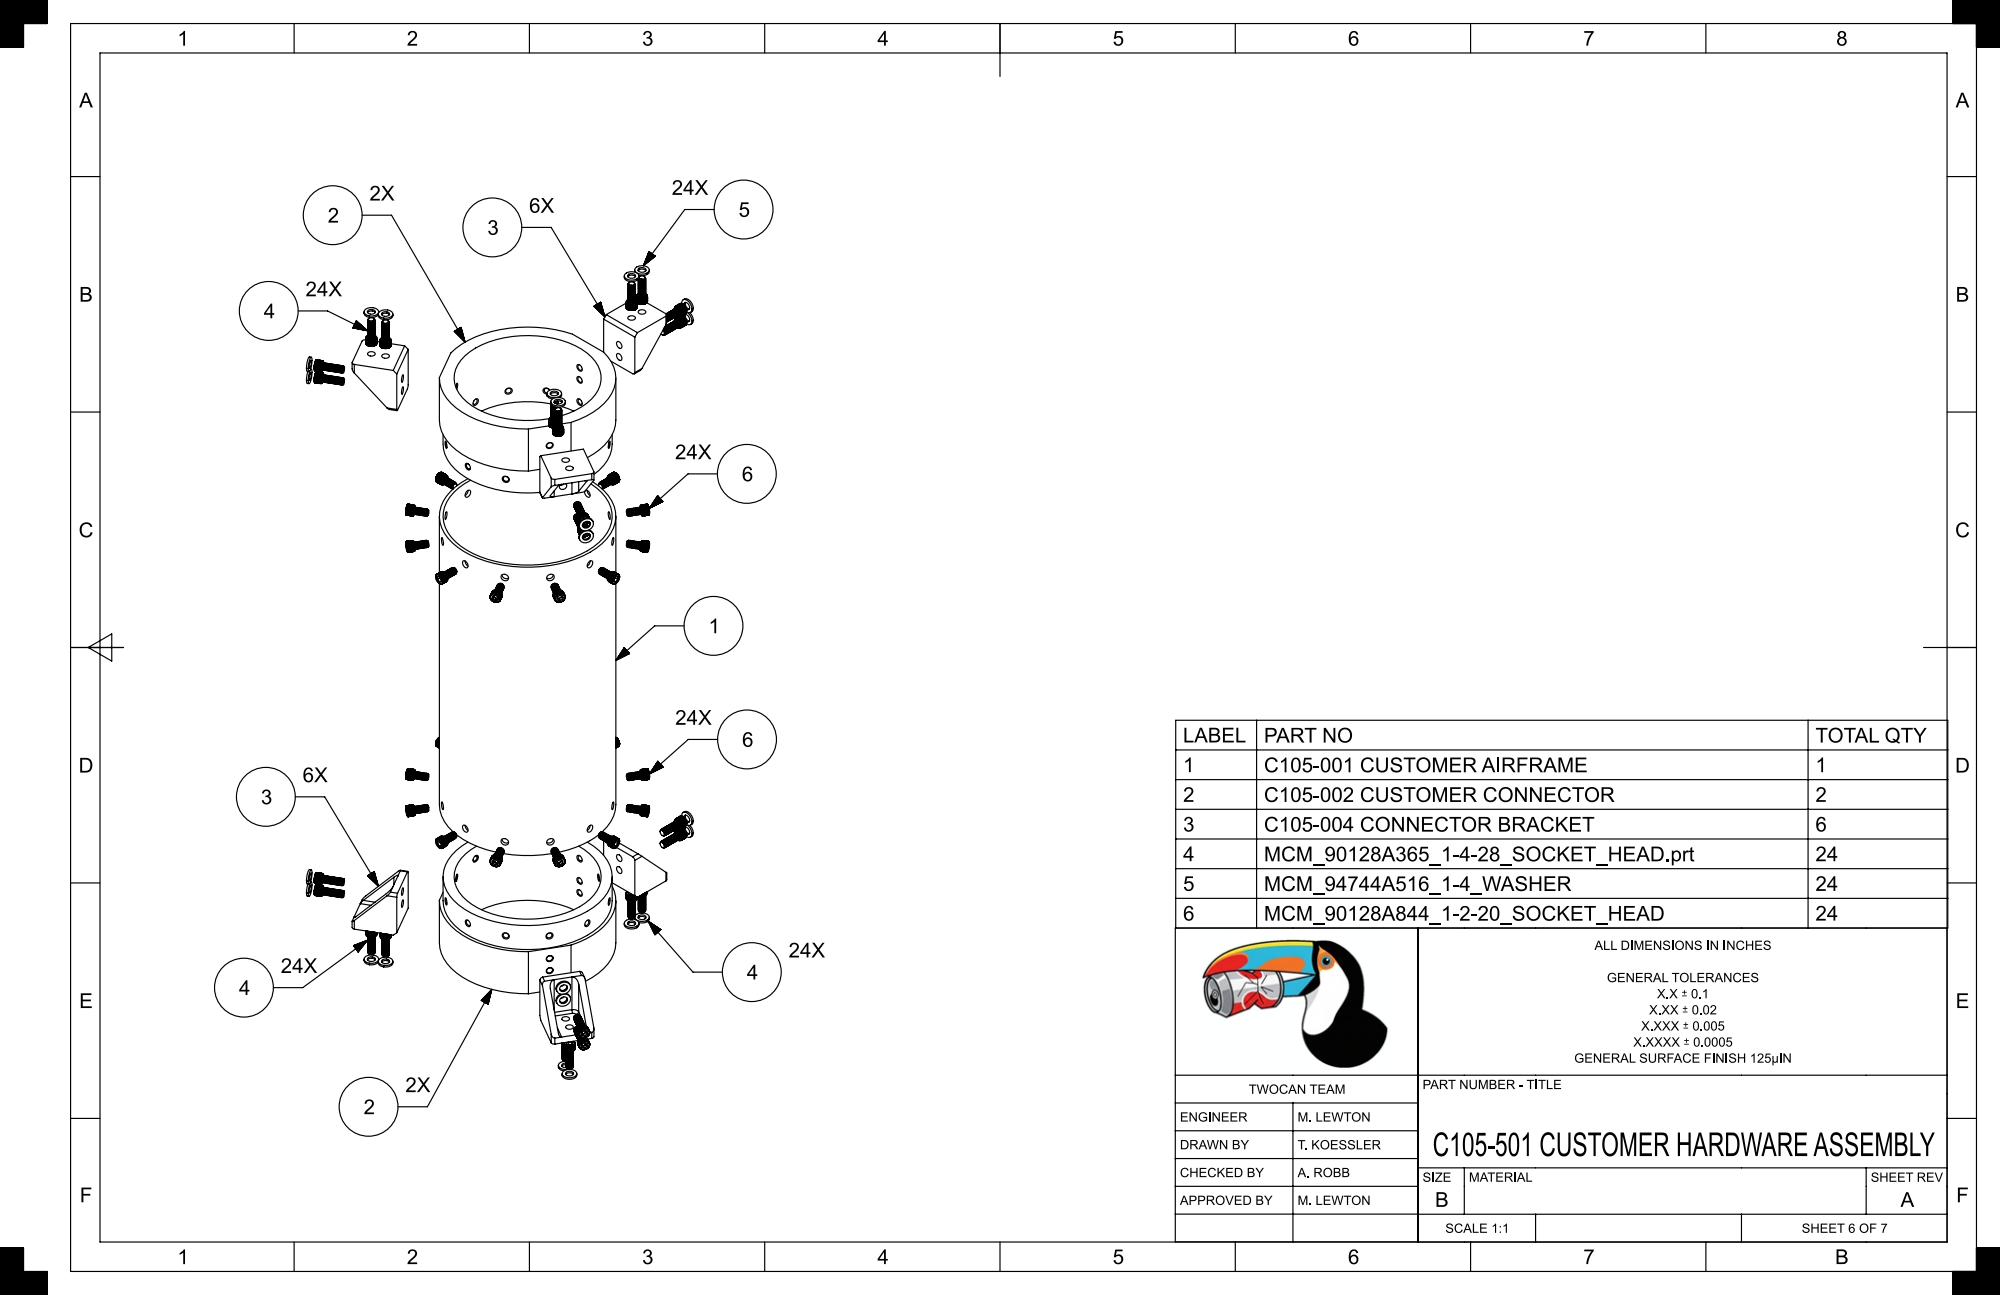
[picture p45: page 3]

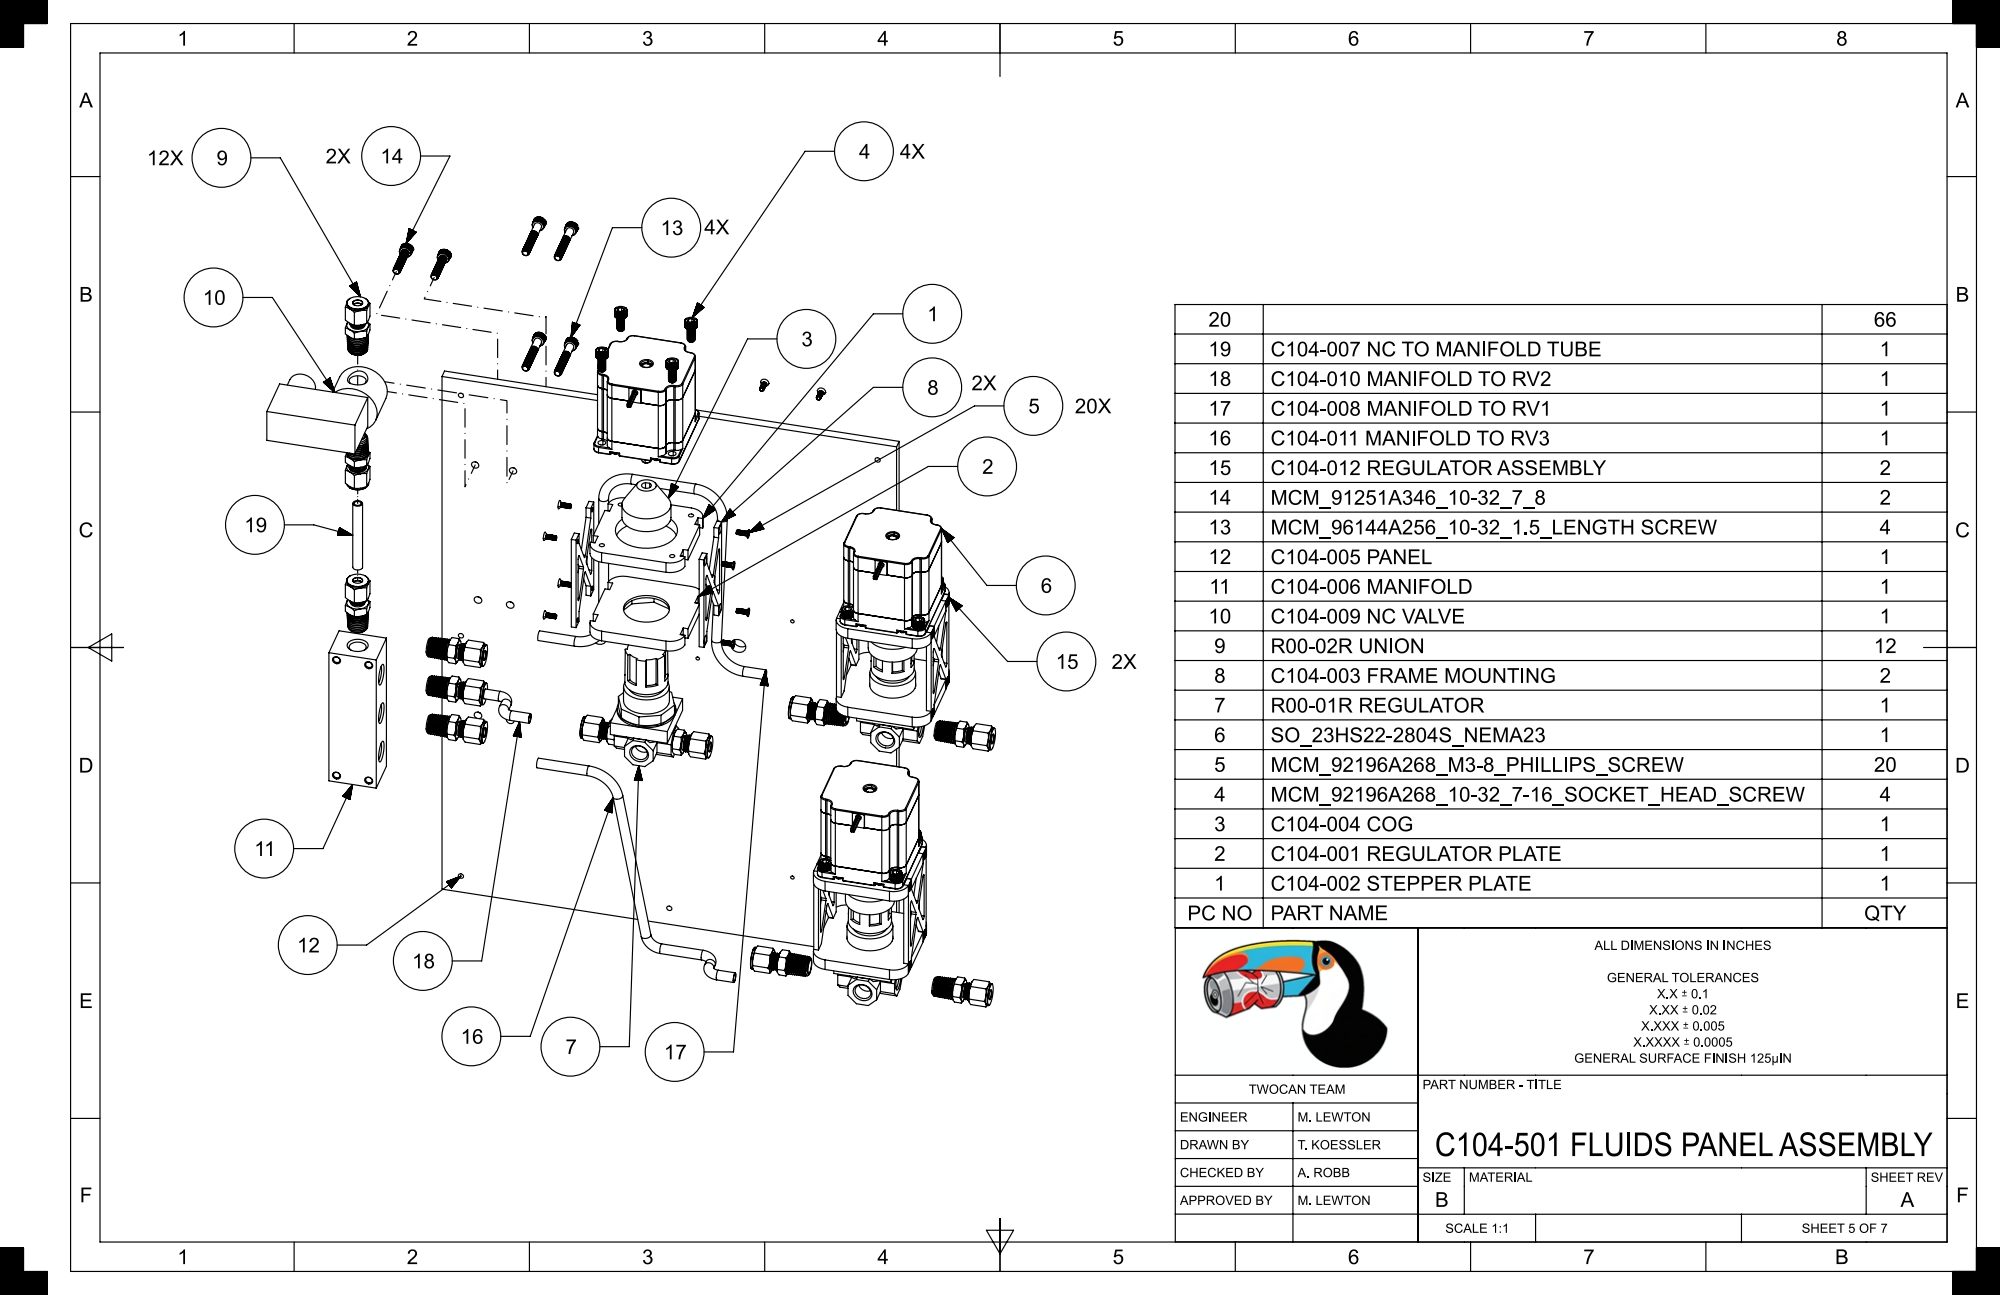
[picture p46: page 4]

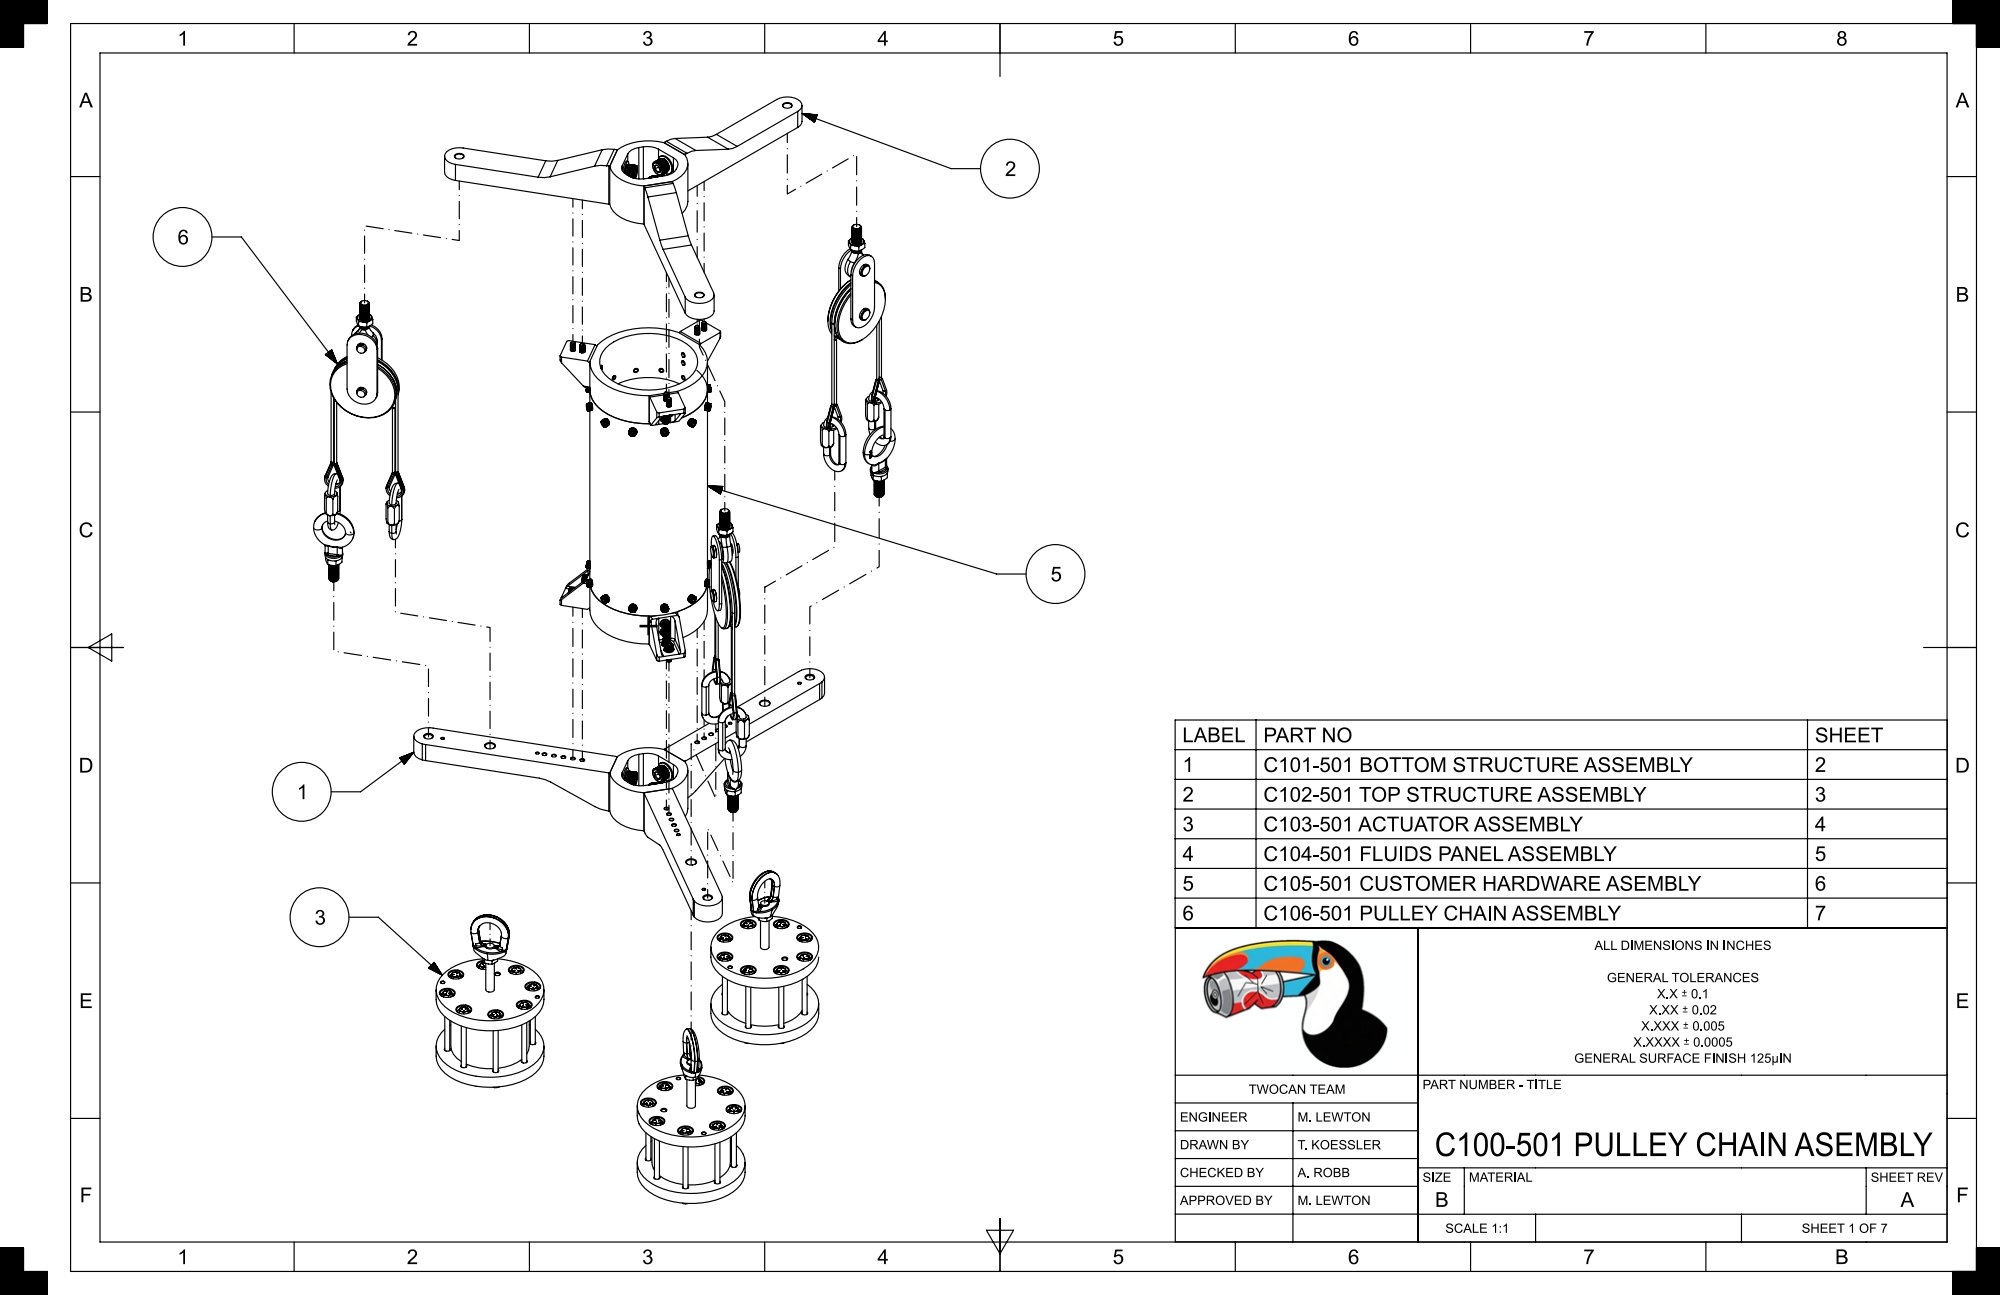
[picture p47: page 5]

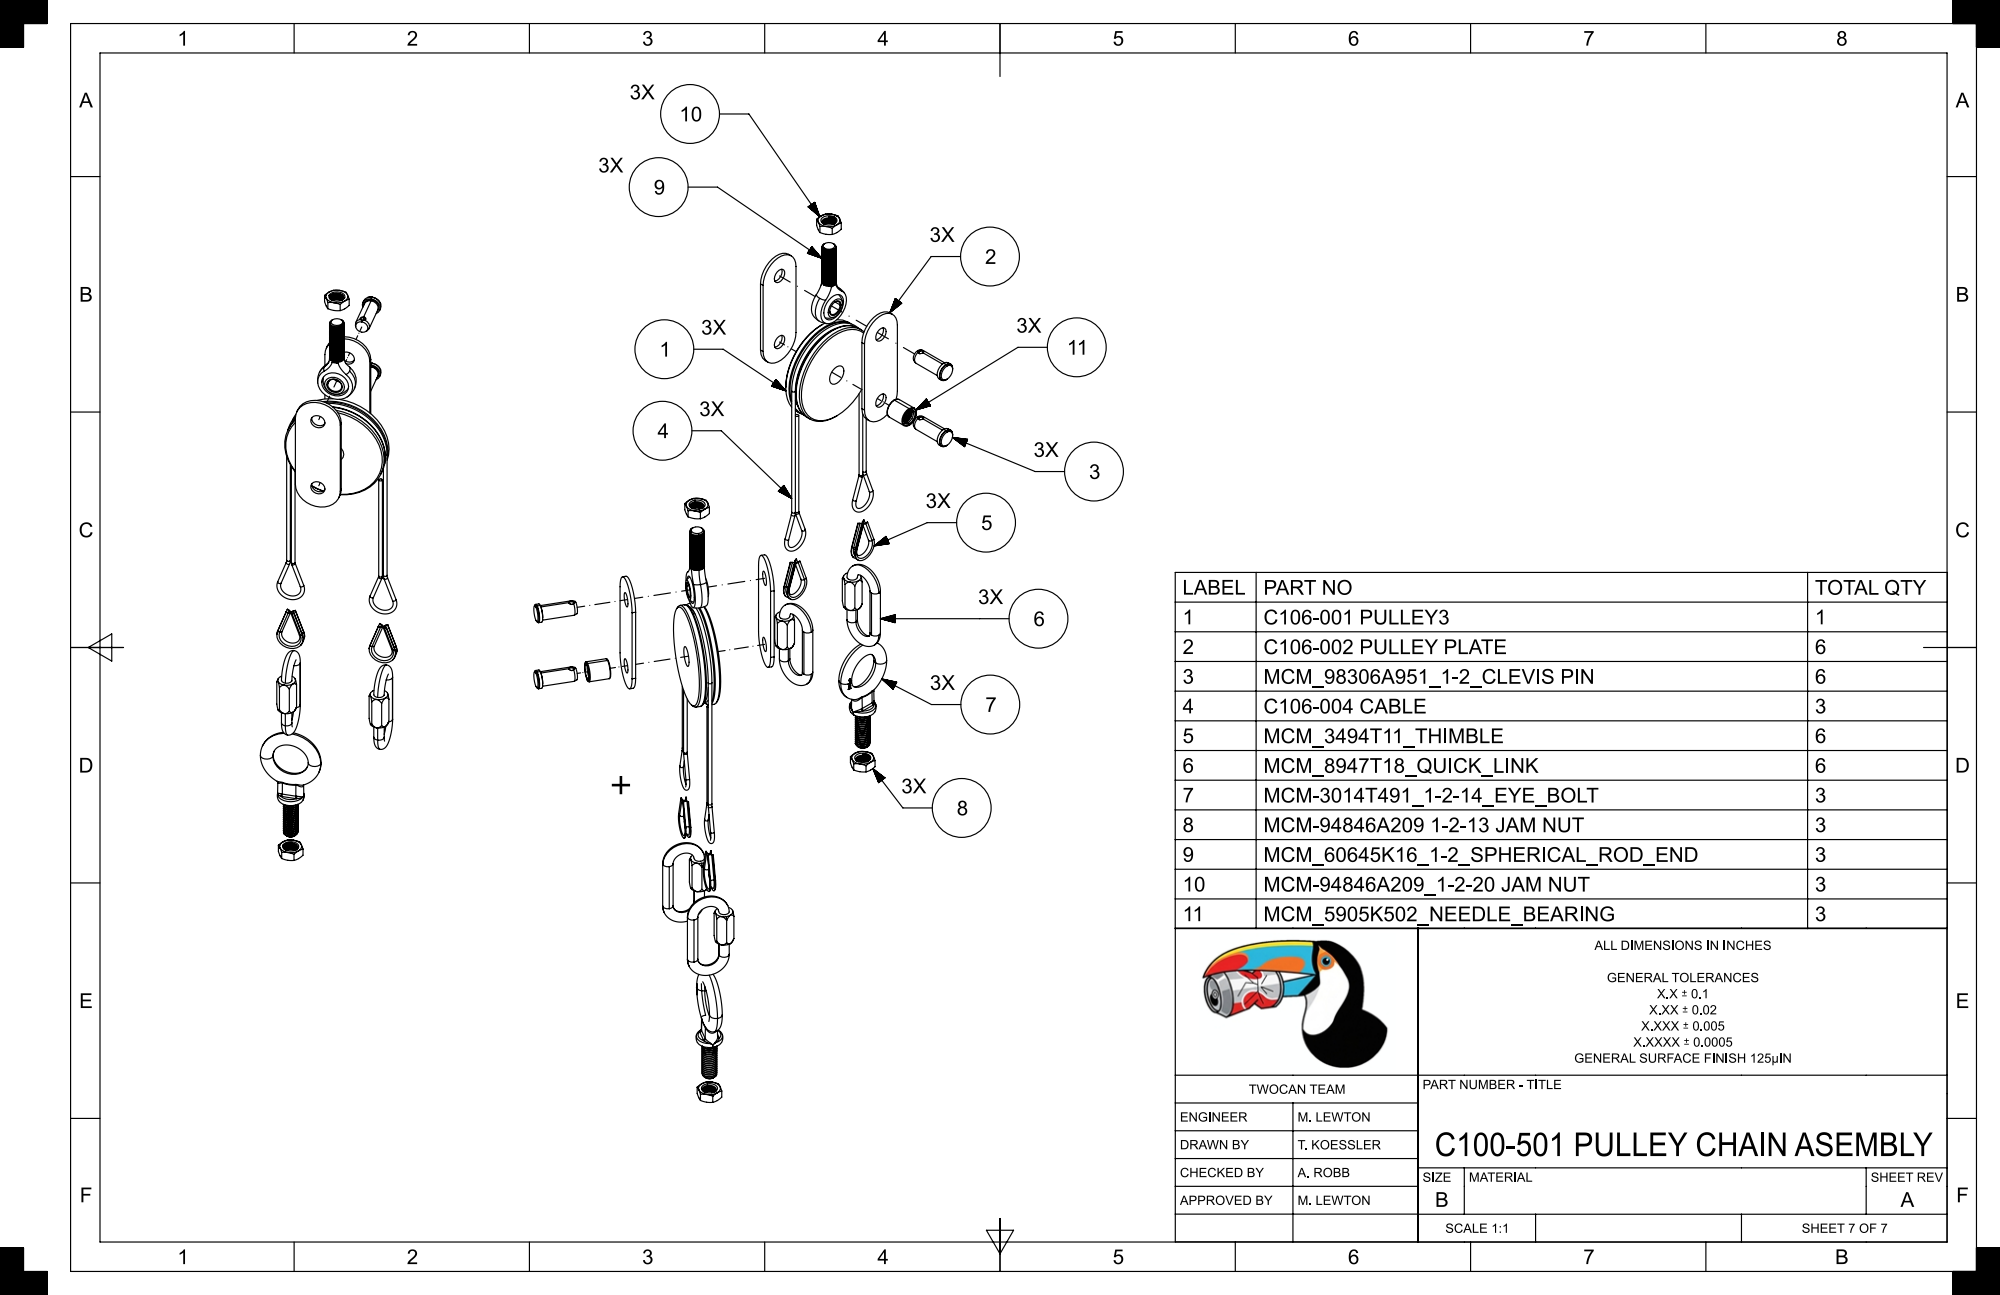
[picture p48: page 6]

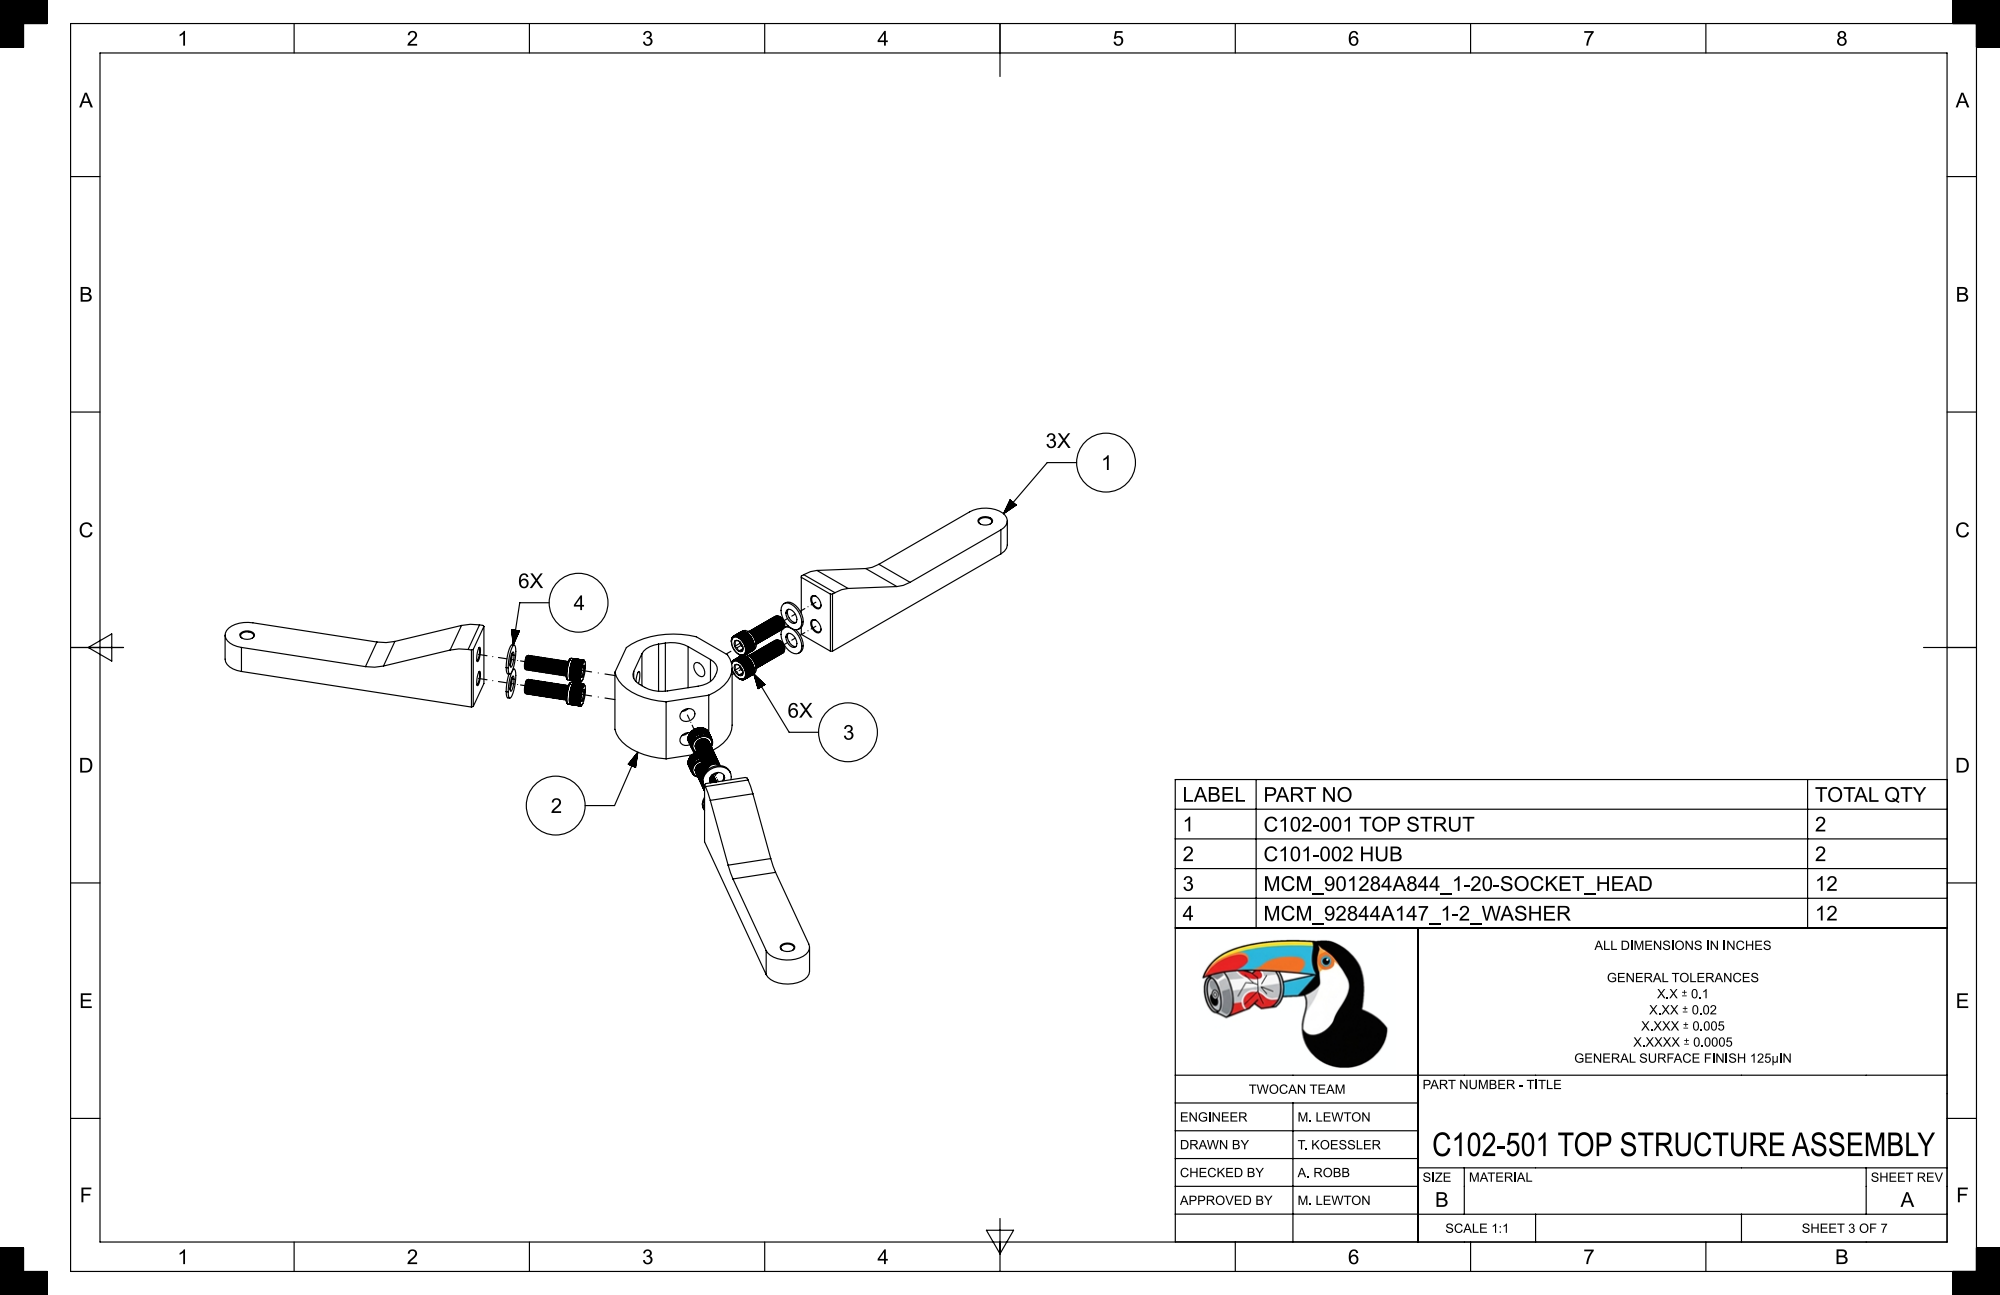
[picture p49: page 7]
