matt-lewton9/ME-463-Can-Crusher/RELEASED DWG/C107-501 ESTOP BOX ASSEMBLY.pdf

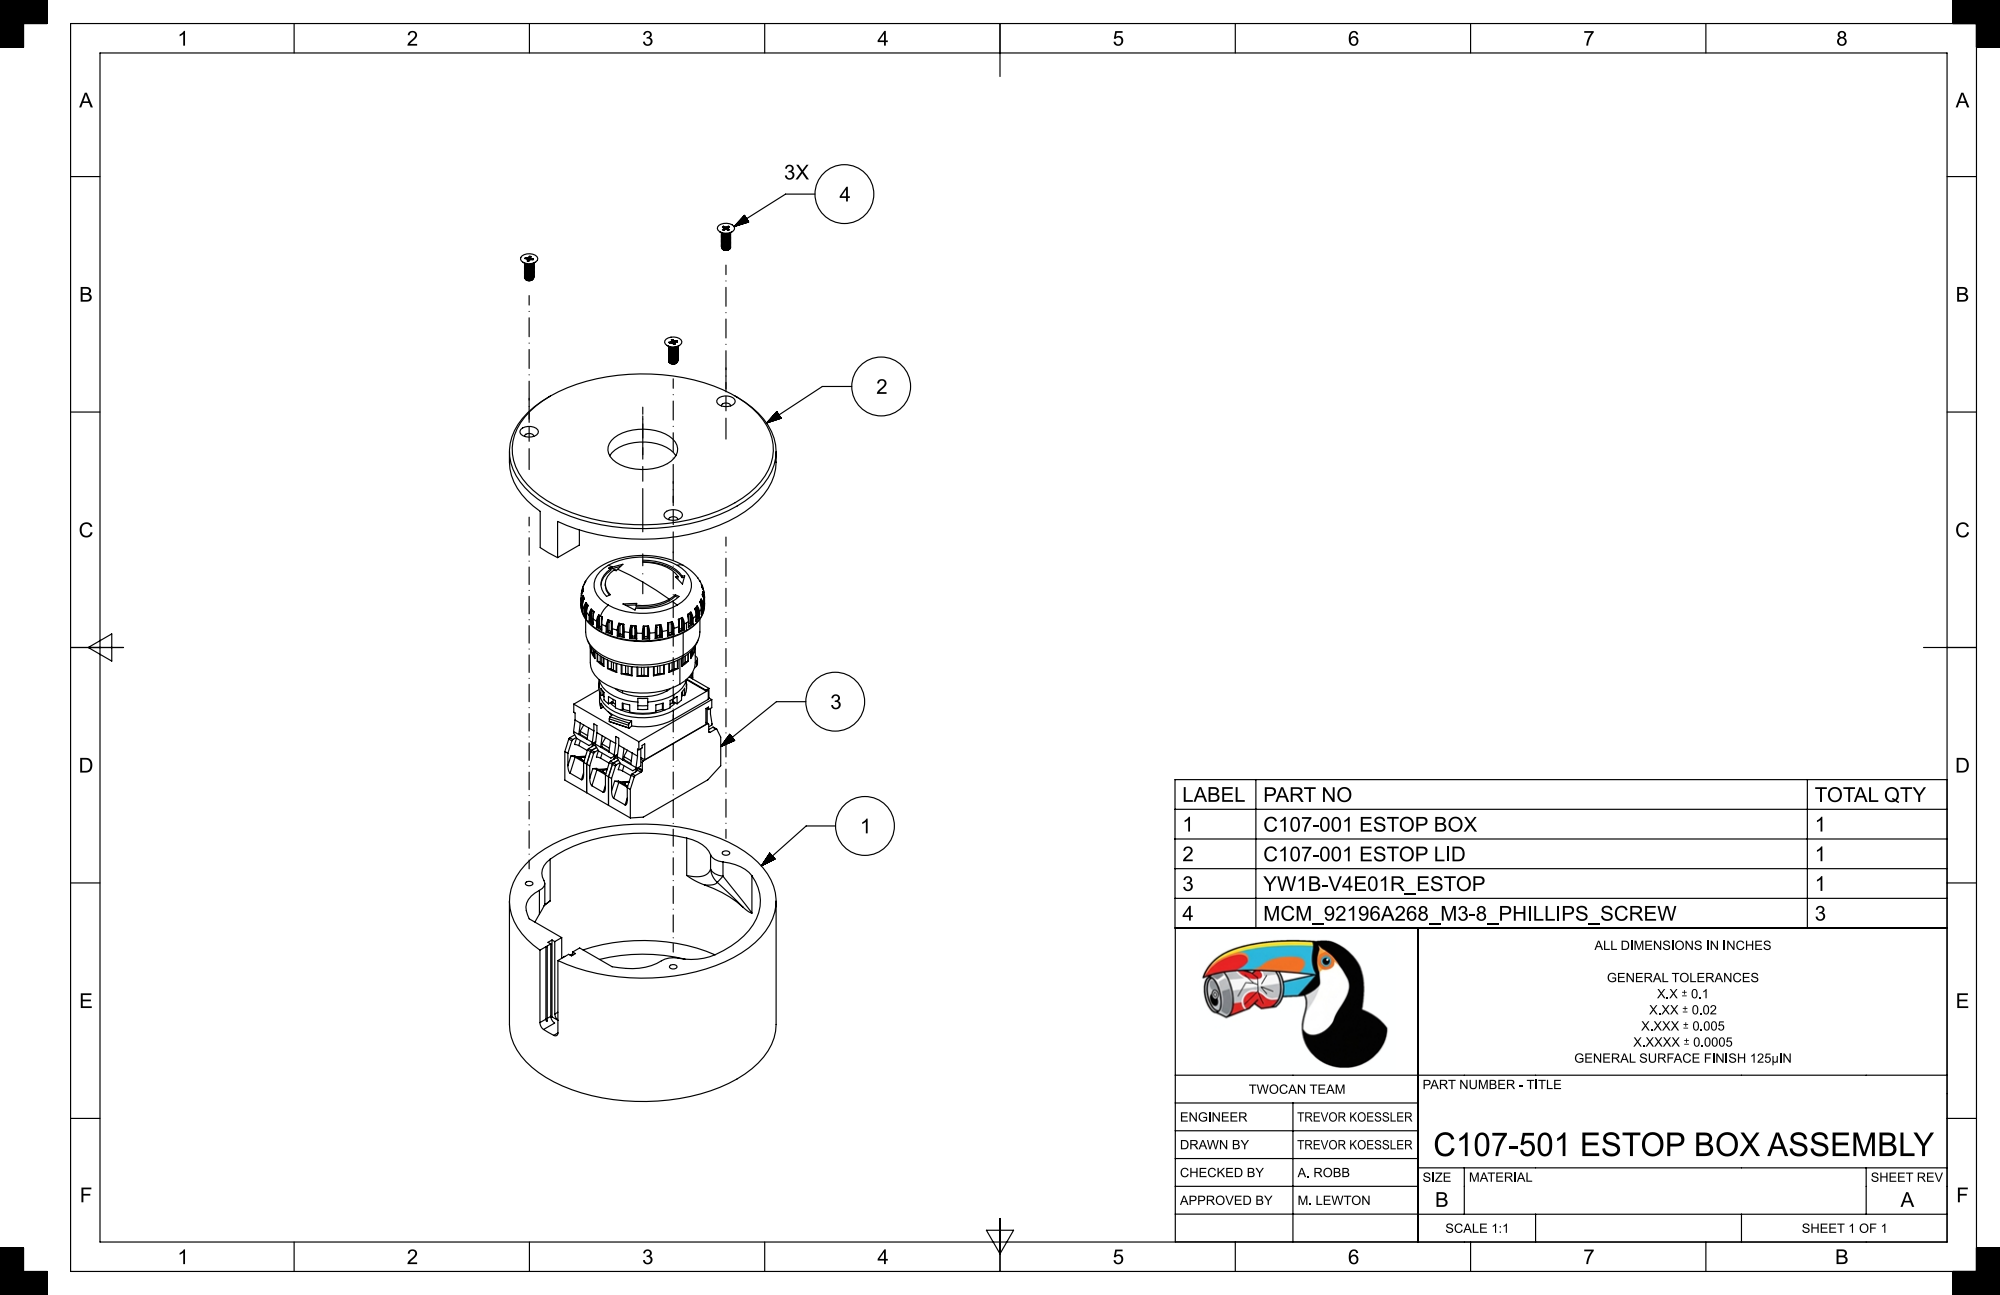
[picture p50: page 1]
