matt-lewton9/ME-463-Can-Crusher/PRE-RELEASE DWG/E100-001 ELECTRICAL SCHEMATIC.pdf

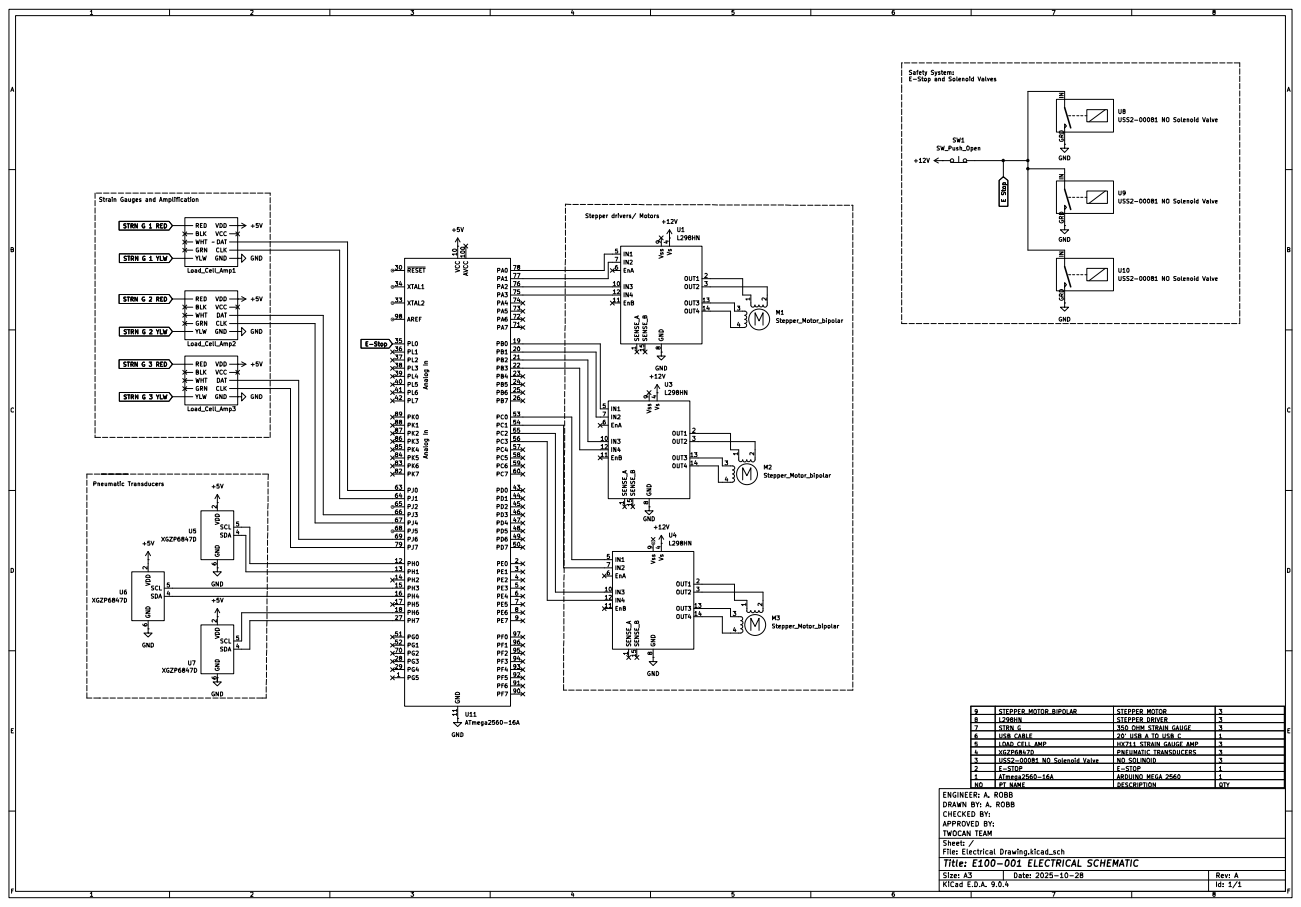
[picture p57: page 1]
