matt-lewton9/ME-463-Can-Crusher/RELEASED DWG/C103-001 CYLINDER TOP CAP.pdf

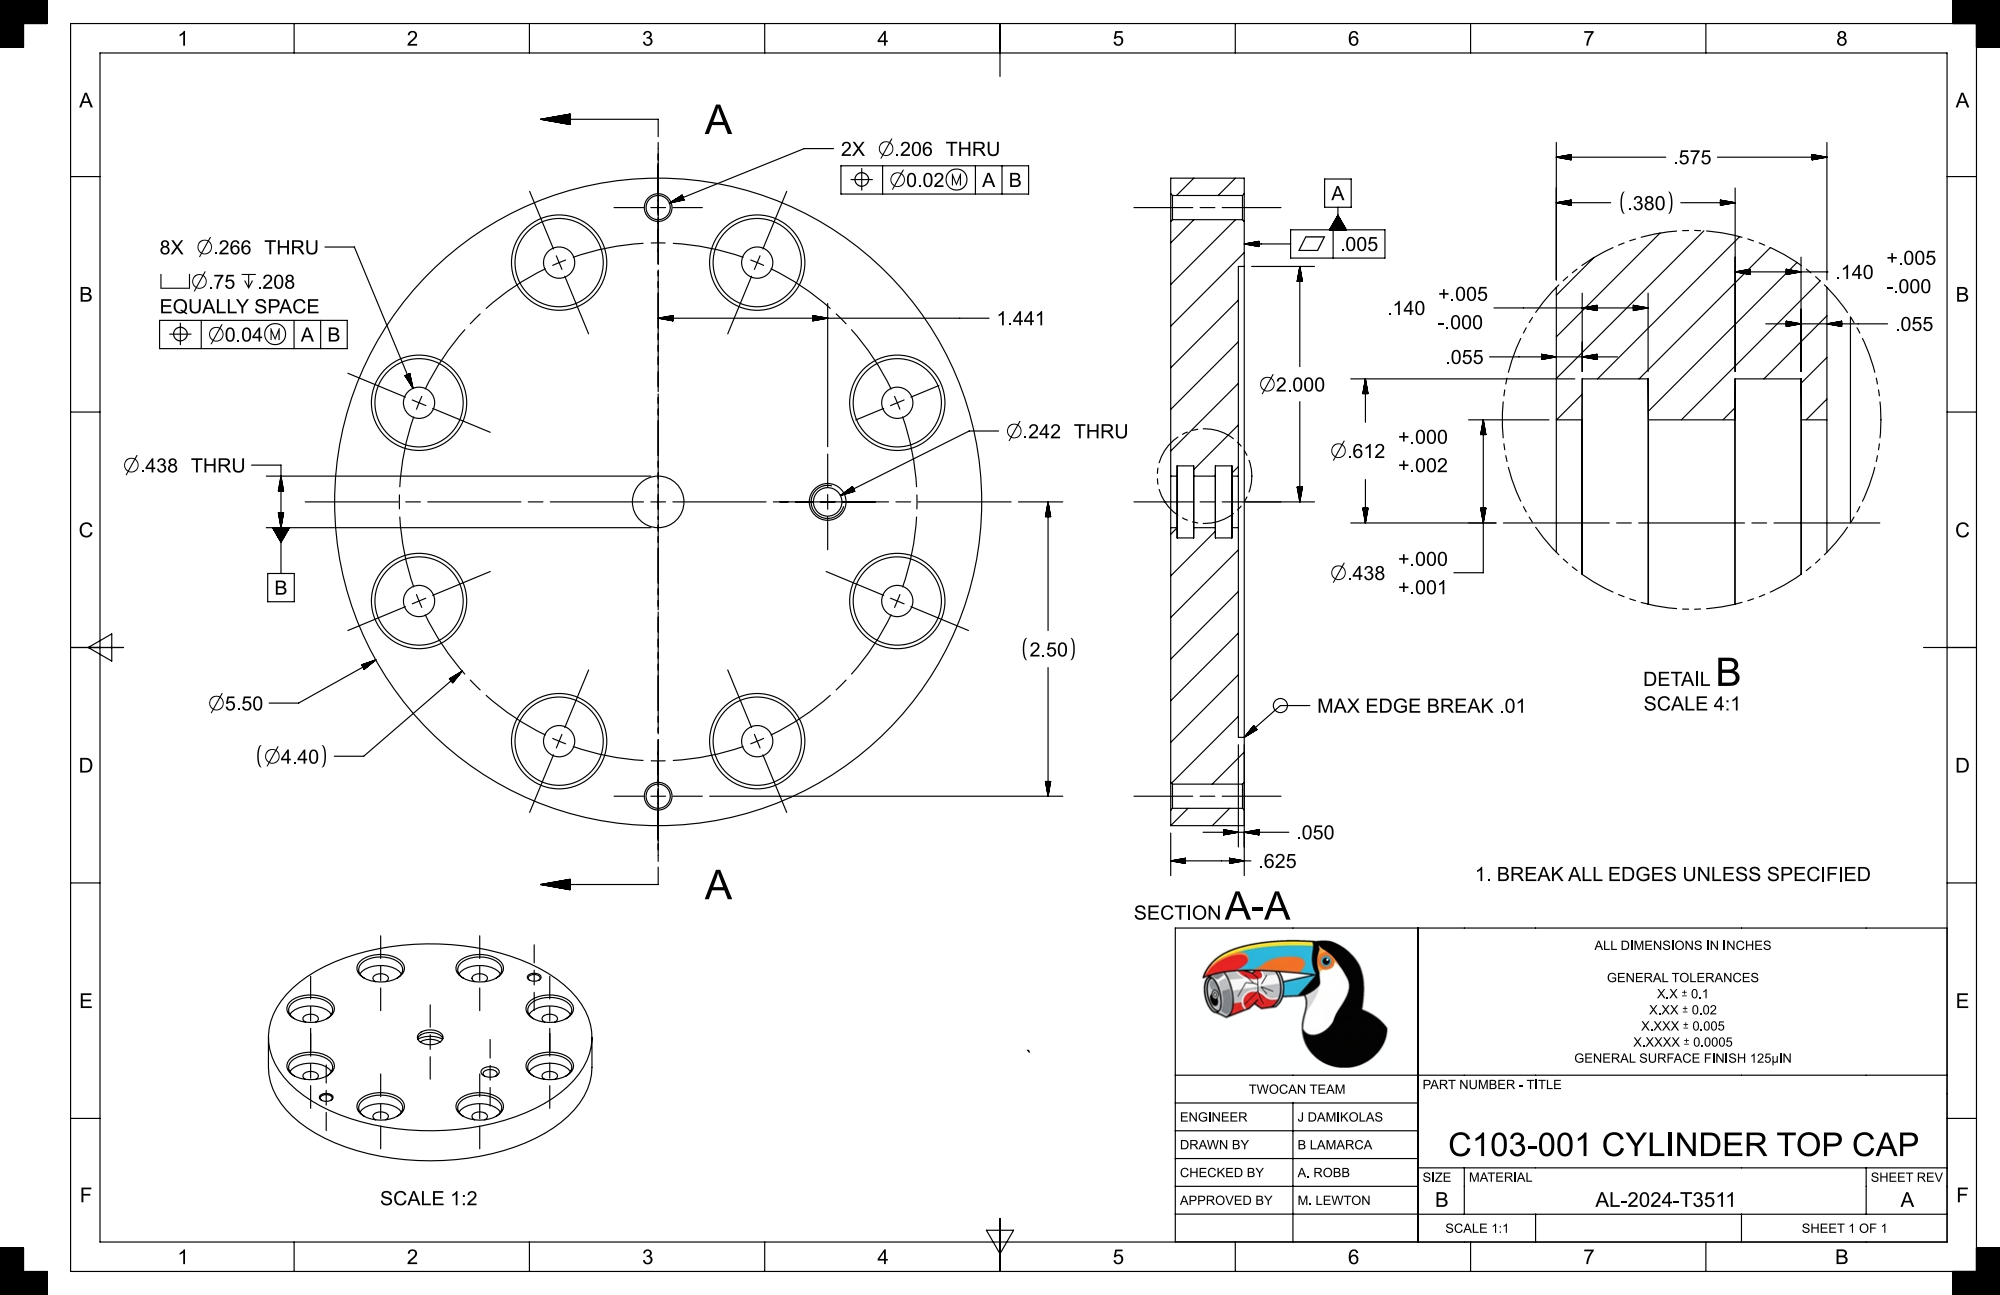
[picture p58: page 1]
