matt-lewton9/ME-463-Can-Crusher/RELEASED DWG/C103-002 CYLINDER WALL.pdf

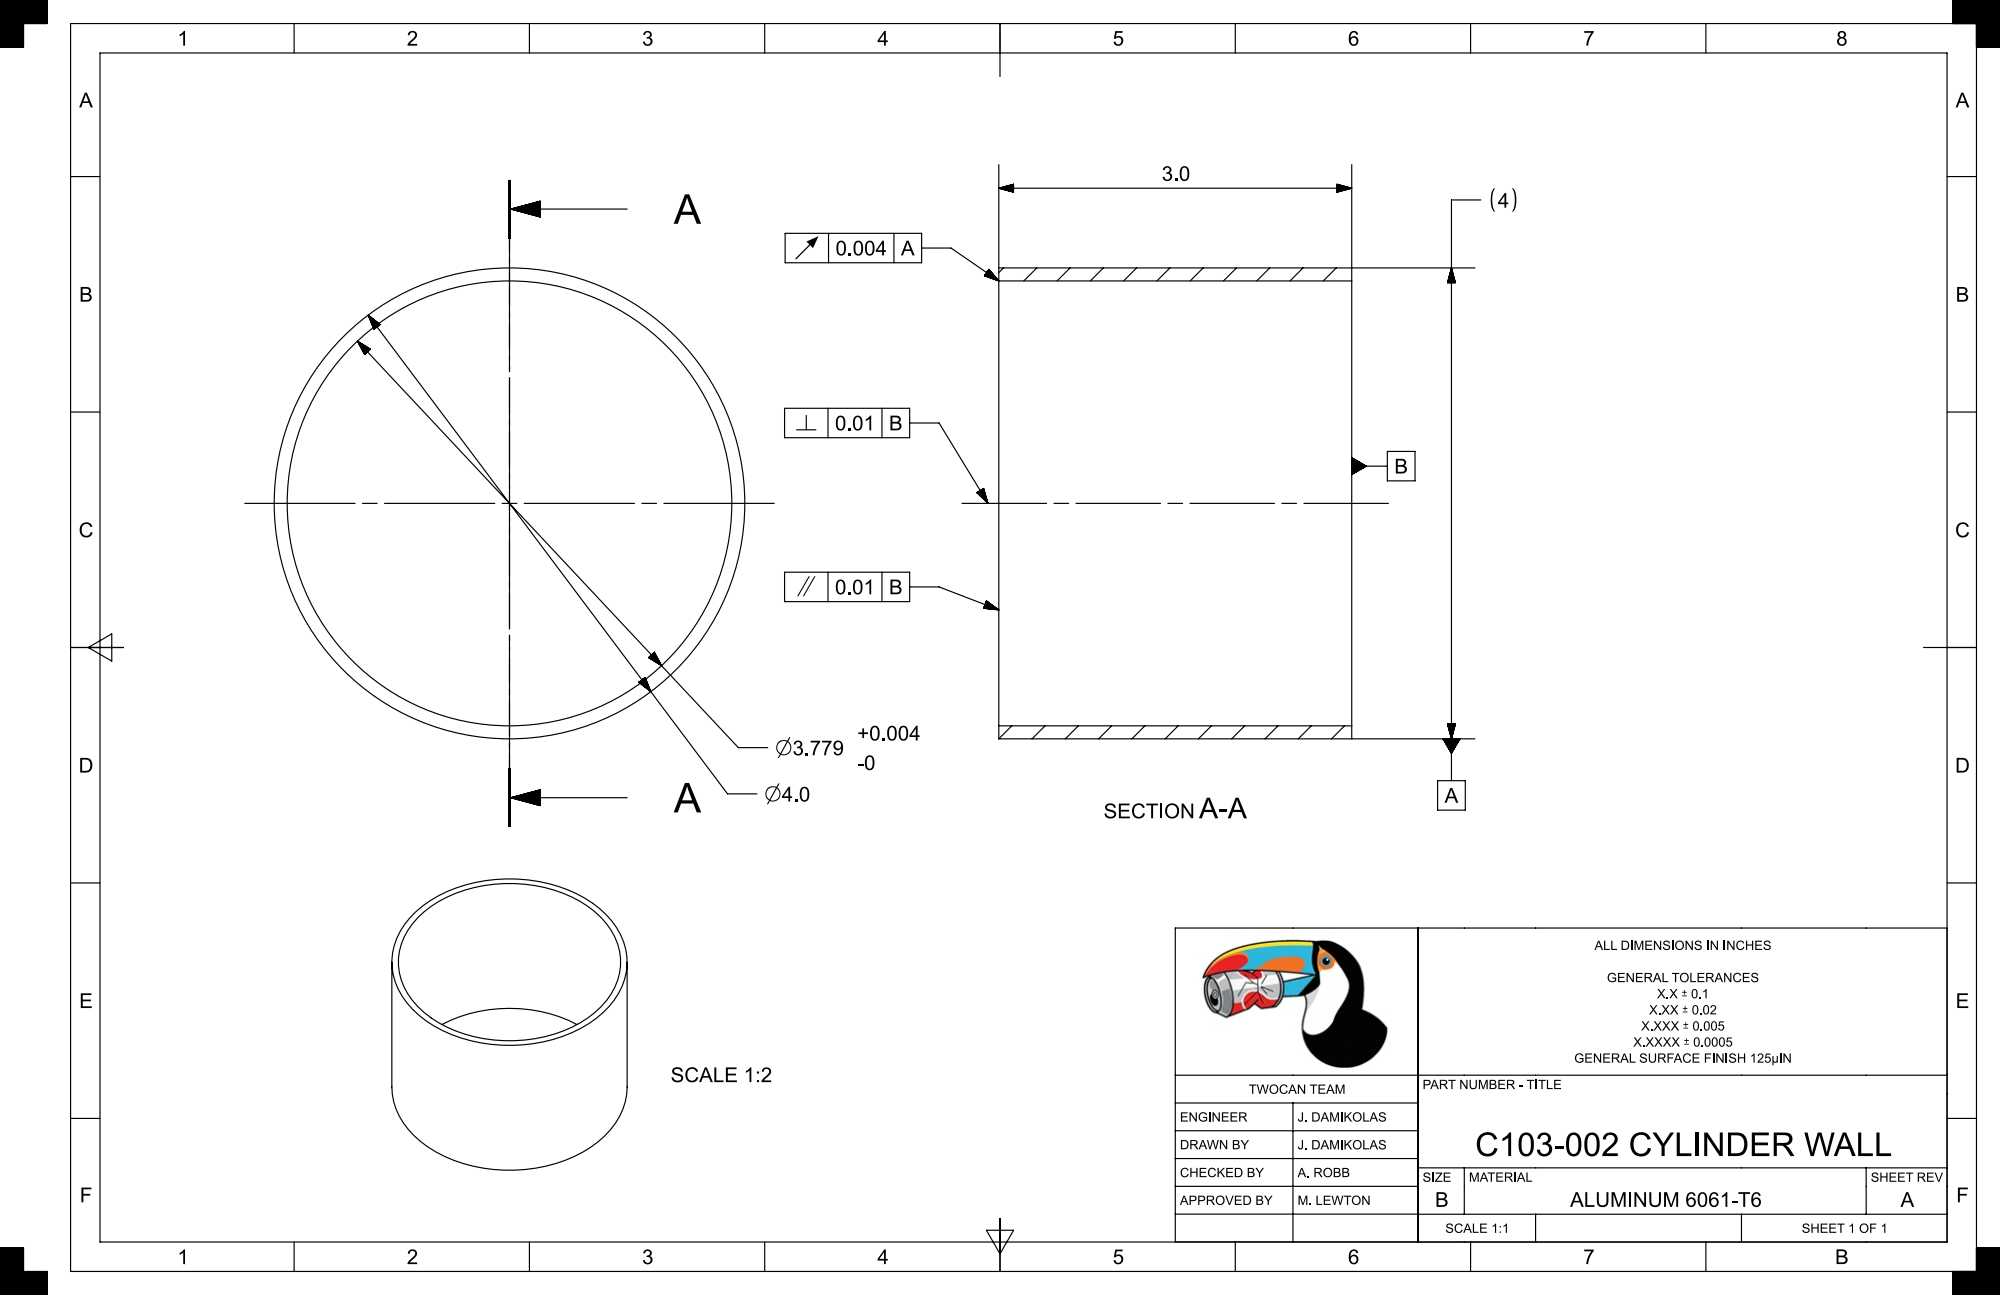
[picture p59: page 1]
