matt-lewton9/ME-463-Can-Crusher/RELEASED DWG/C103-003 CYLINDER BOTTOM CAP.pdf

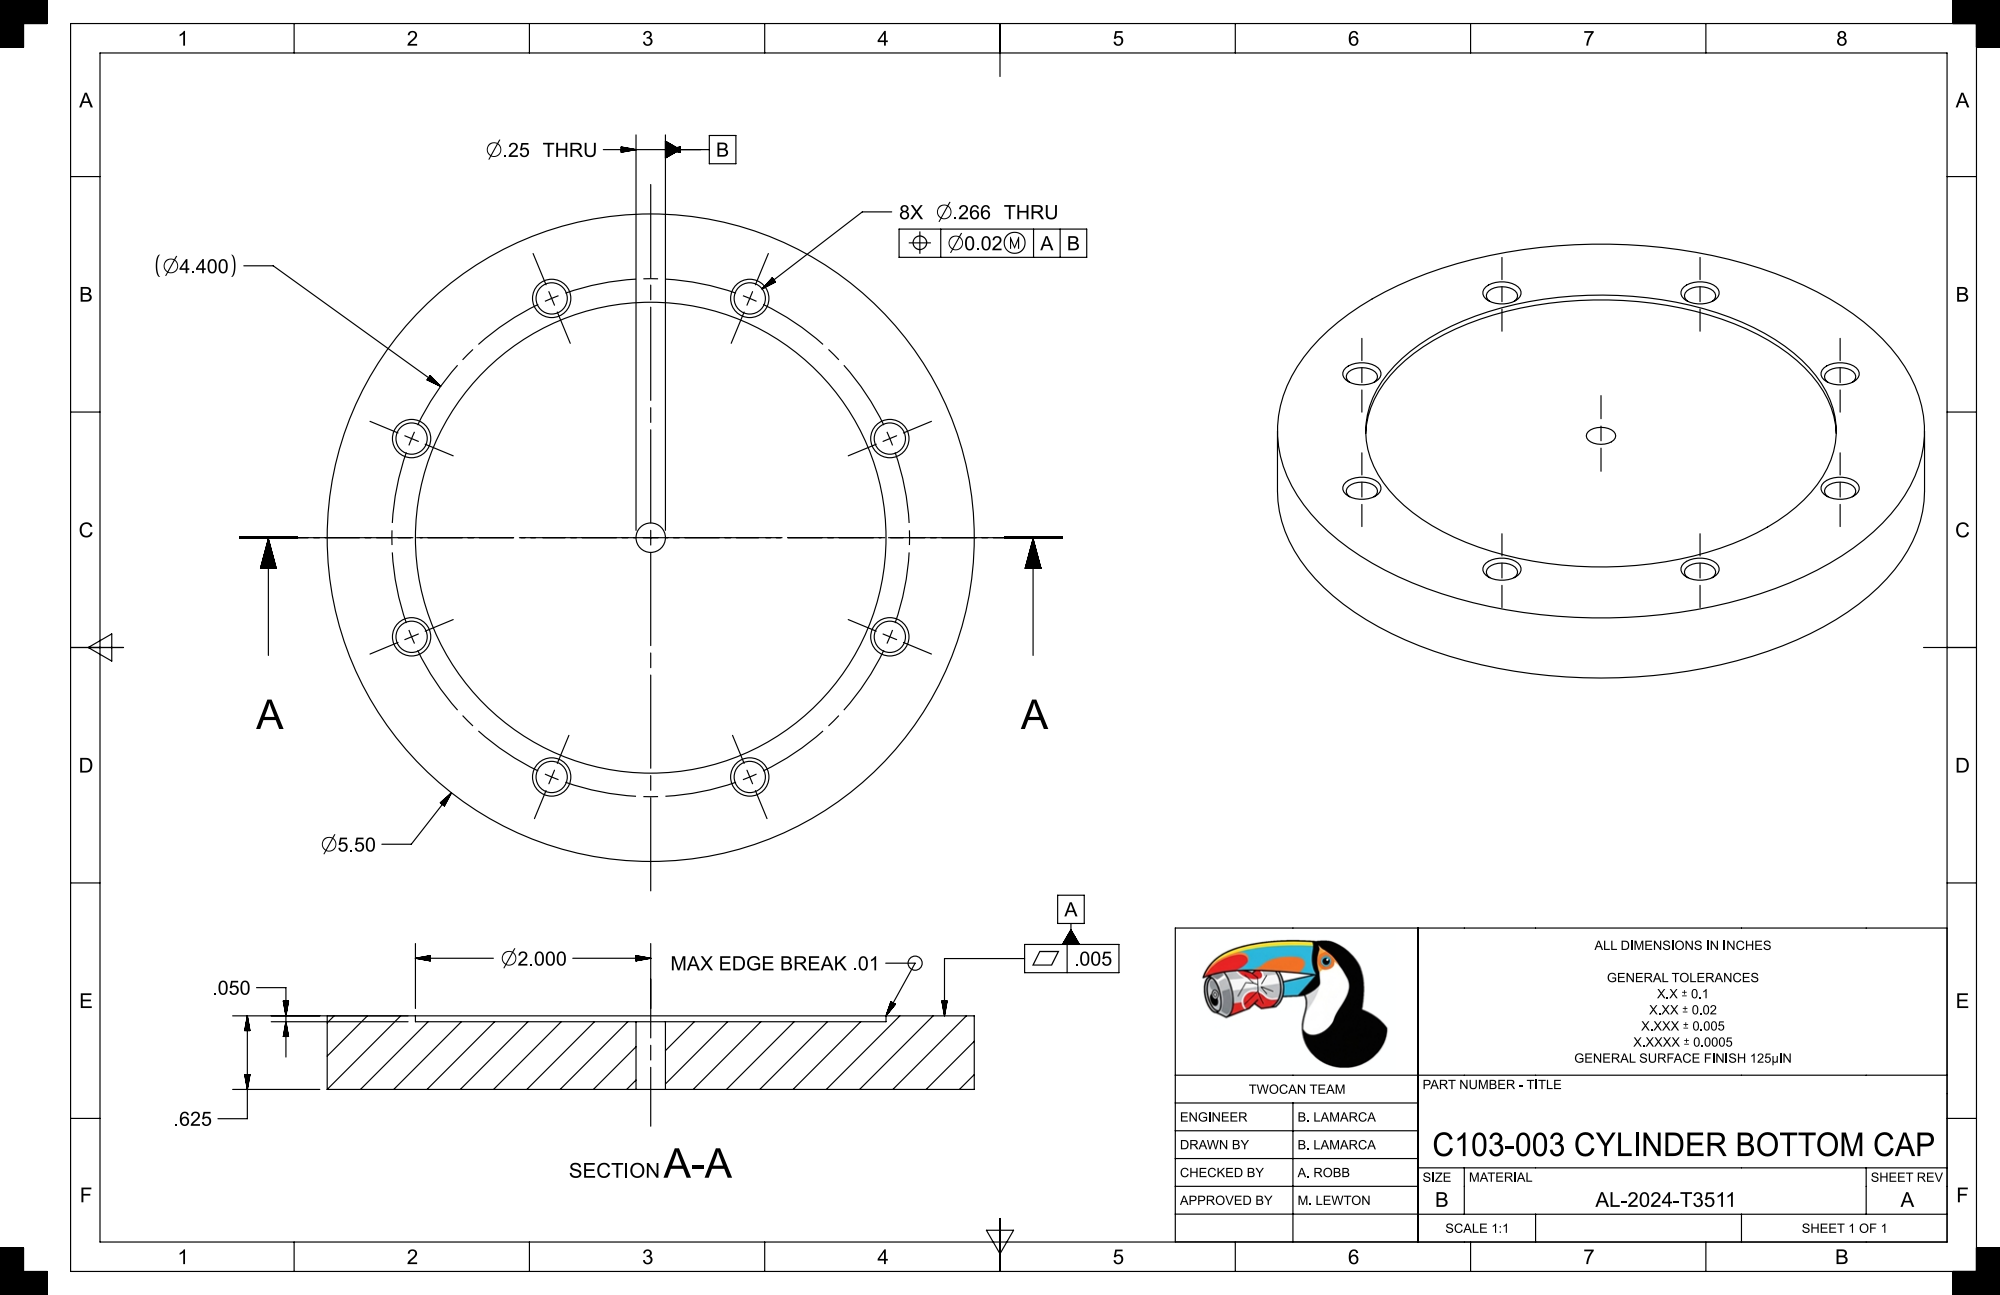
[picture p60: page 1]
