matt-lewton9/ME-463-Can-Crusher/RELEASED DWG/C103-004 PISTON.pdf

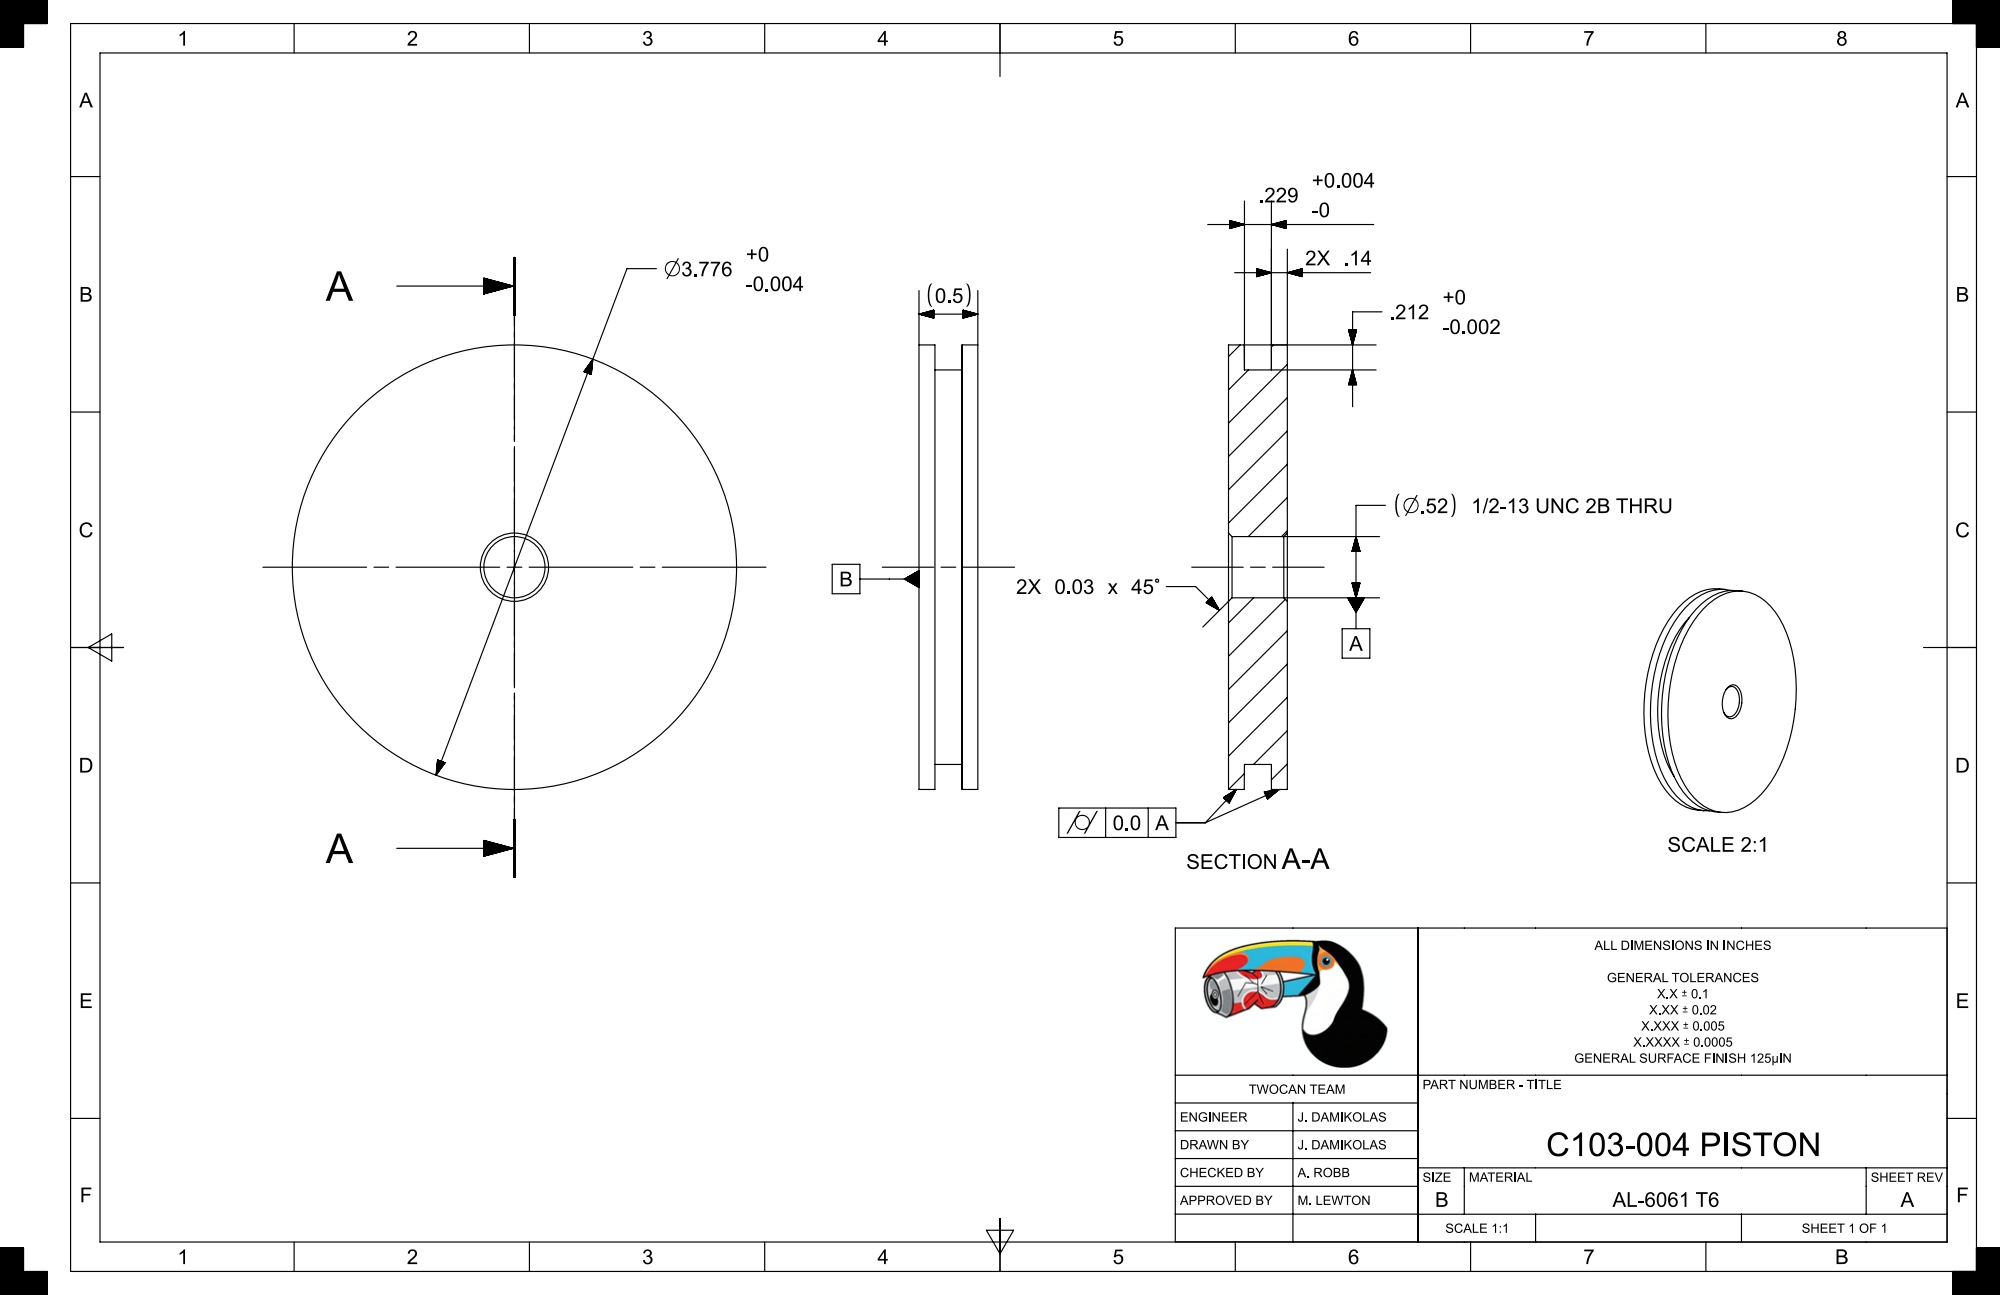
[picture p61: page 1]
