matt-lewton9/ME-463-Can-Crusher/RELEASED DWG/C103-005 CYLINDER SHAFT.pdf

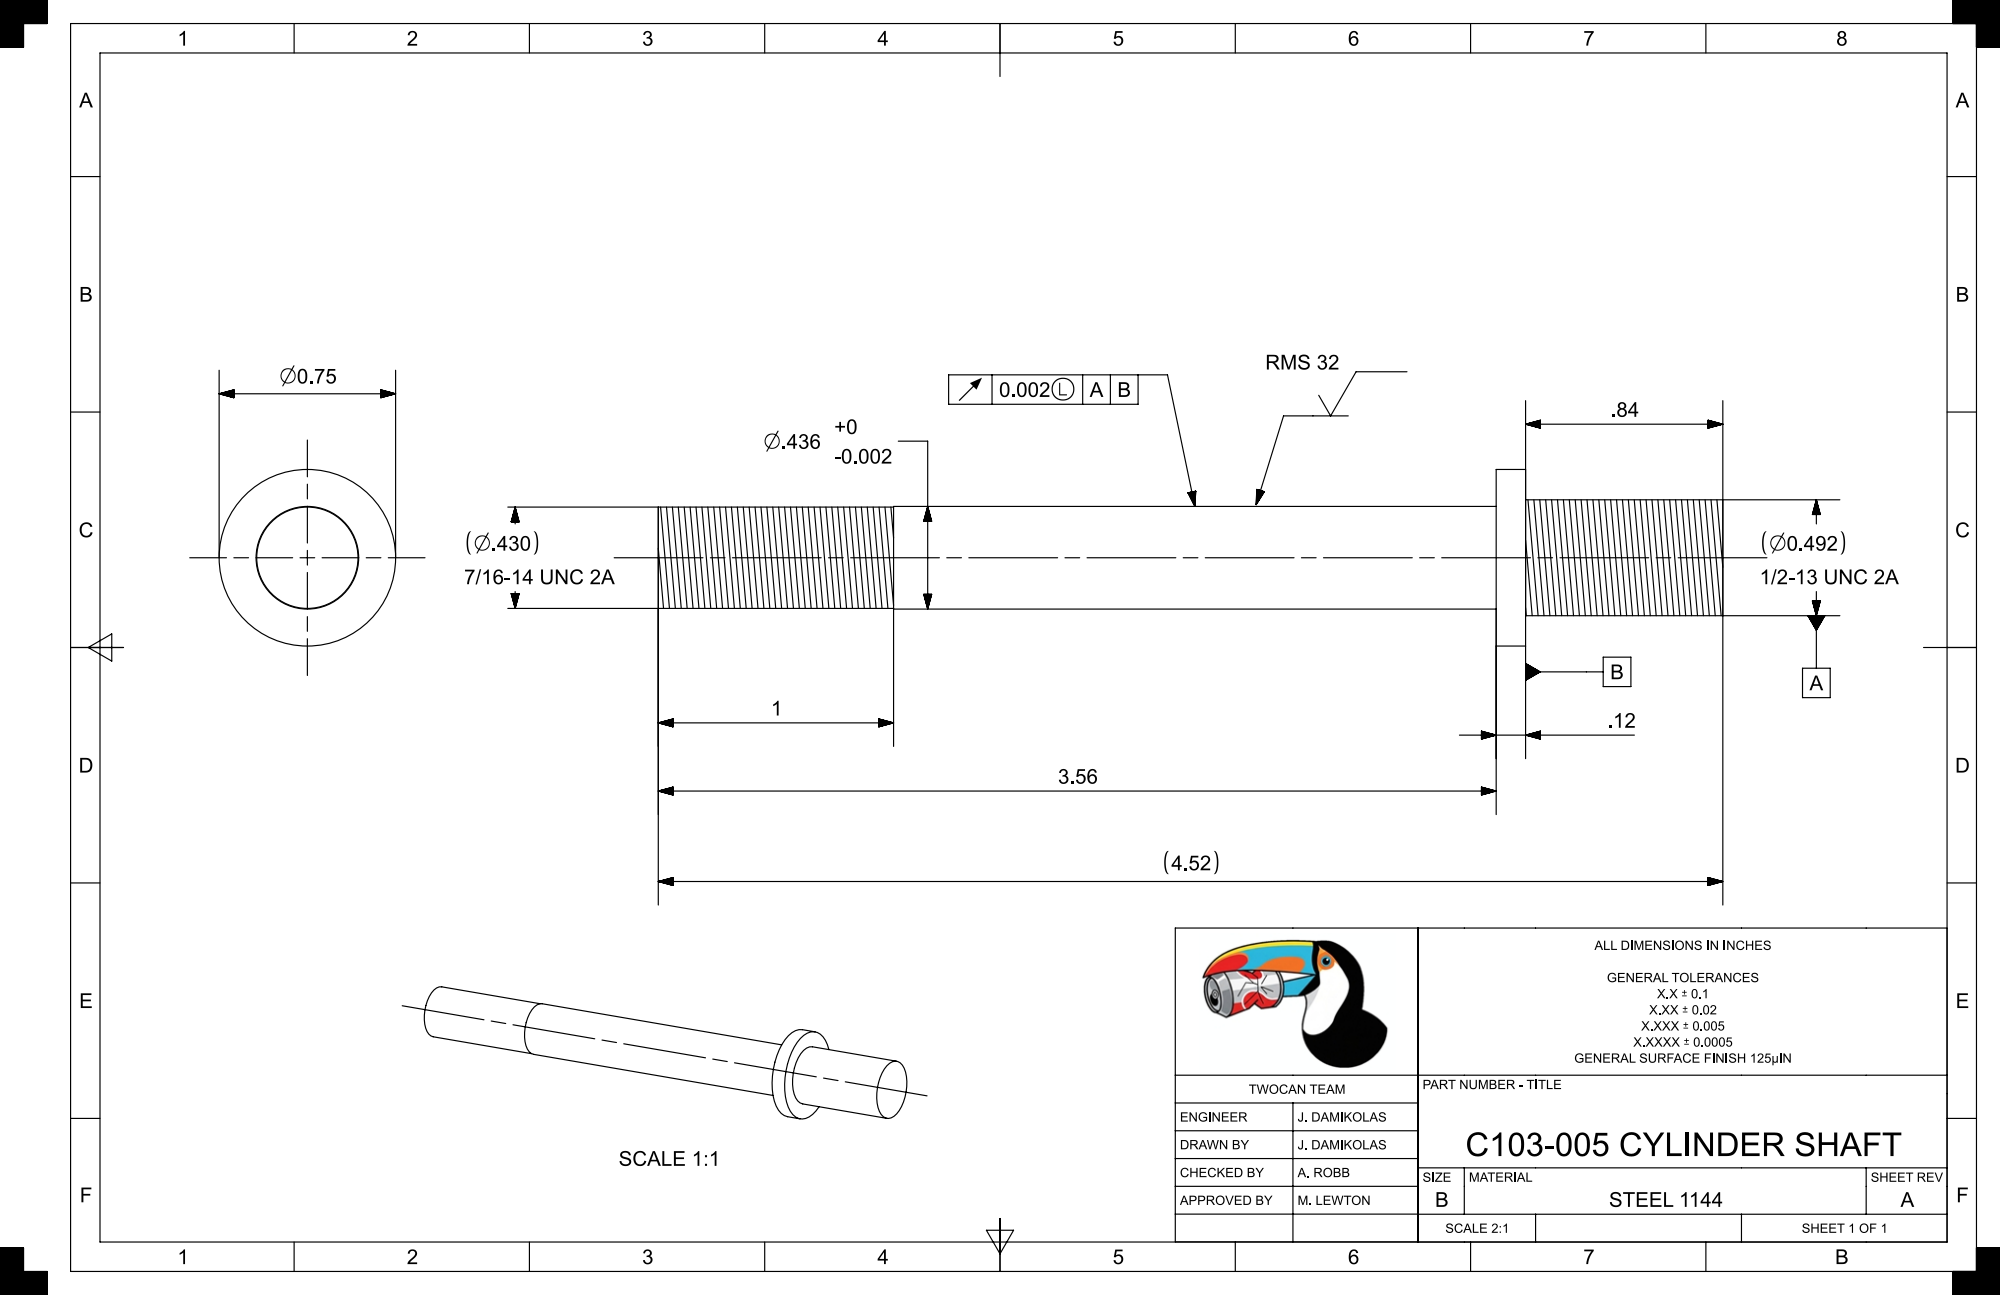
[picture p62: page 1]
