matt-lewton9/ME-463-Can-Crusher/RELEASED DWG/C103-006 MANIFOLD.pdf

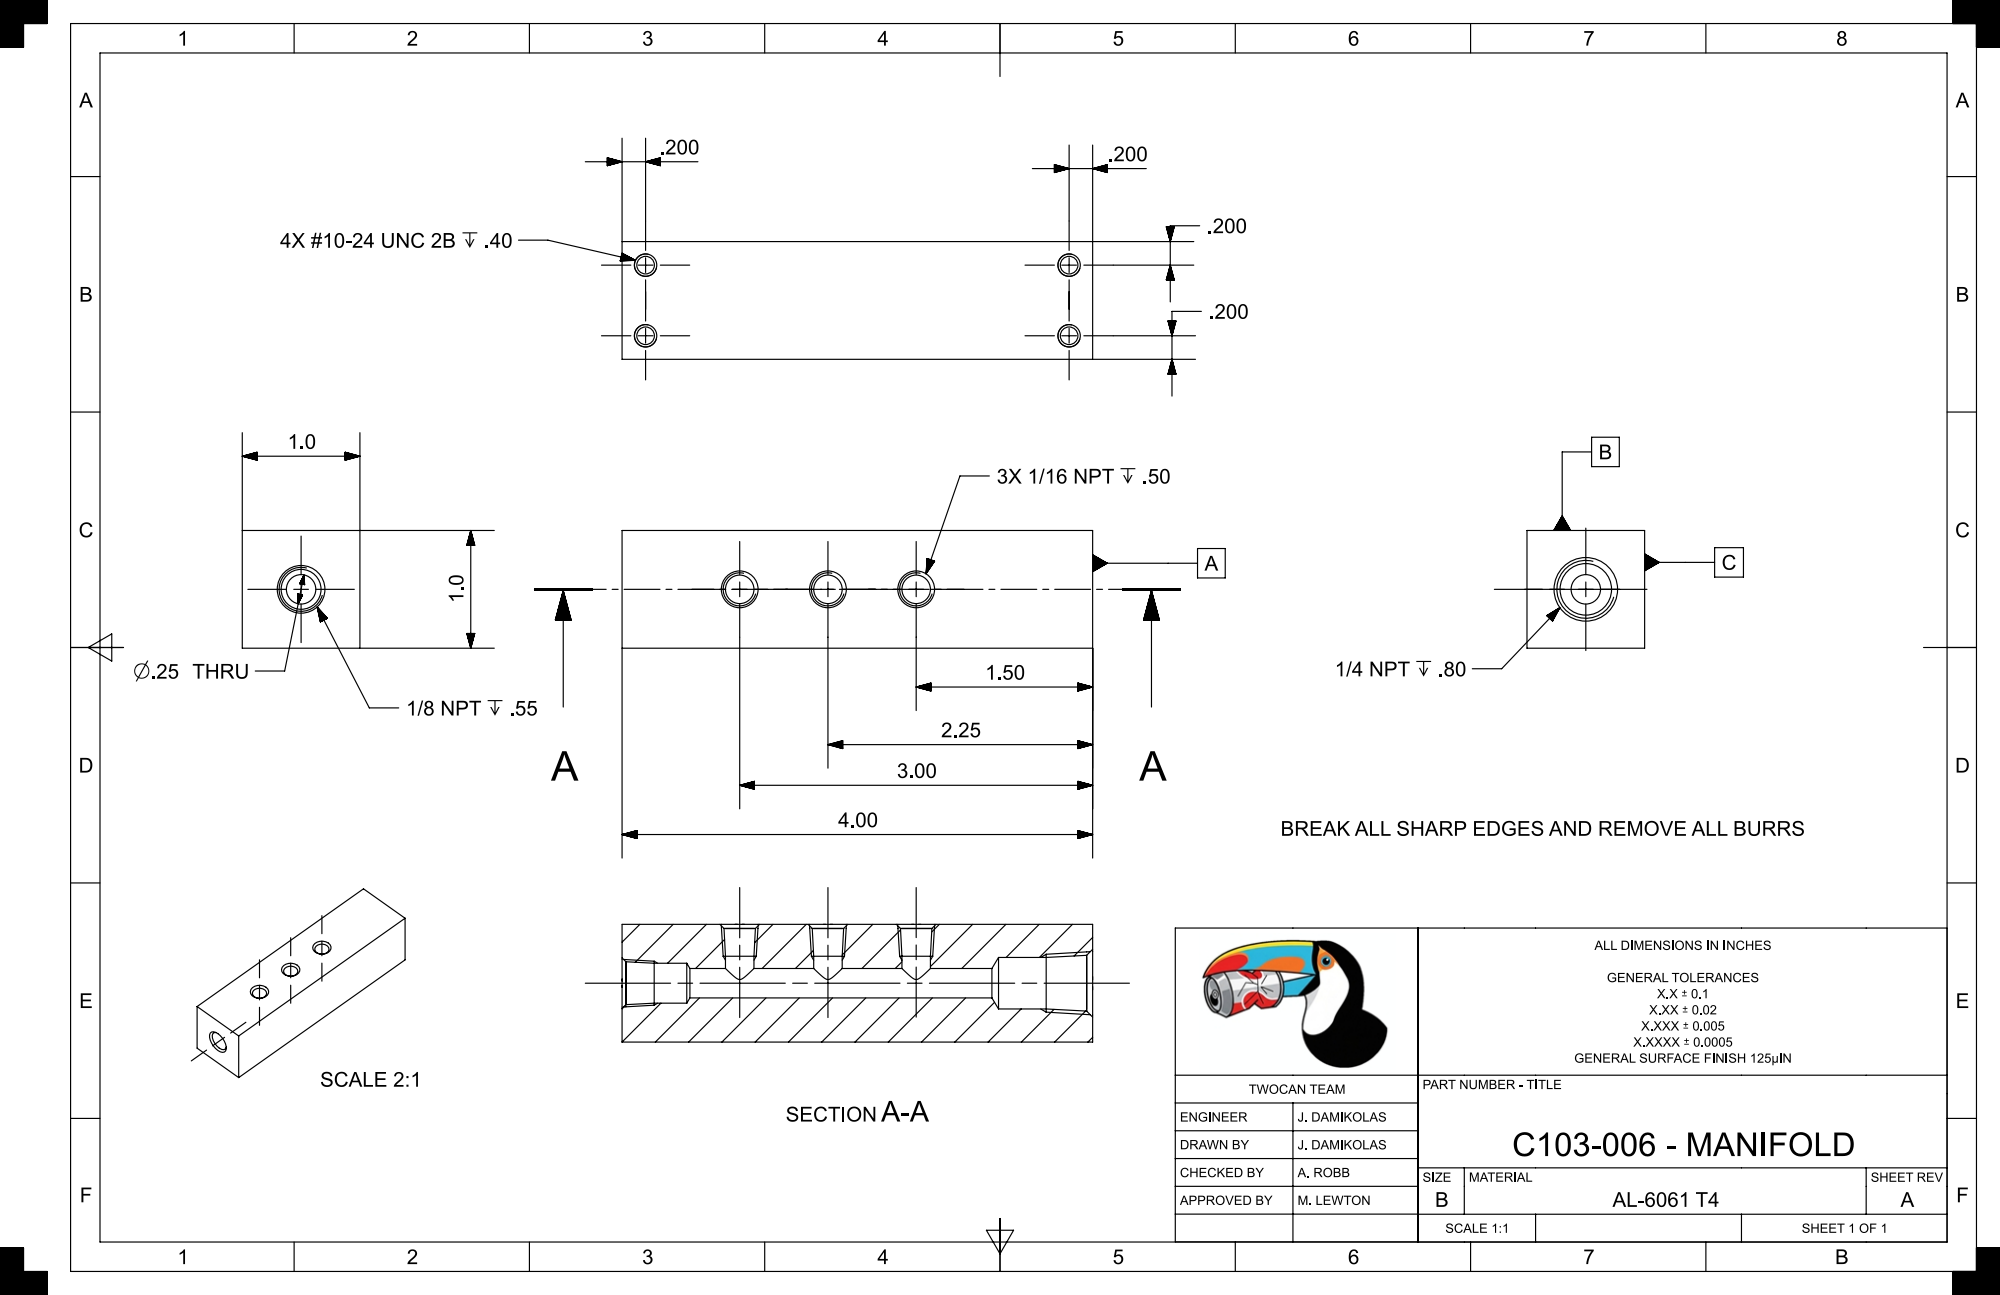
[picture p63: page 1]
