matt-lewton9/ME-463-Can-Crusher/RELEASED DWG/C104-001 REGULATOR PLATE.pdf

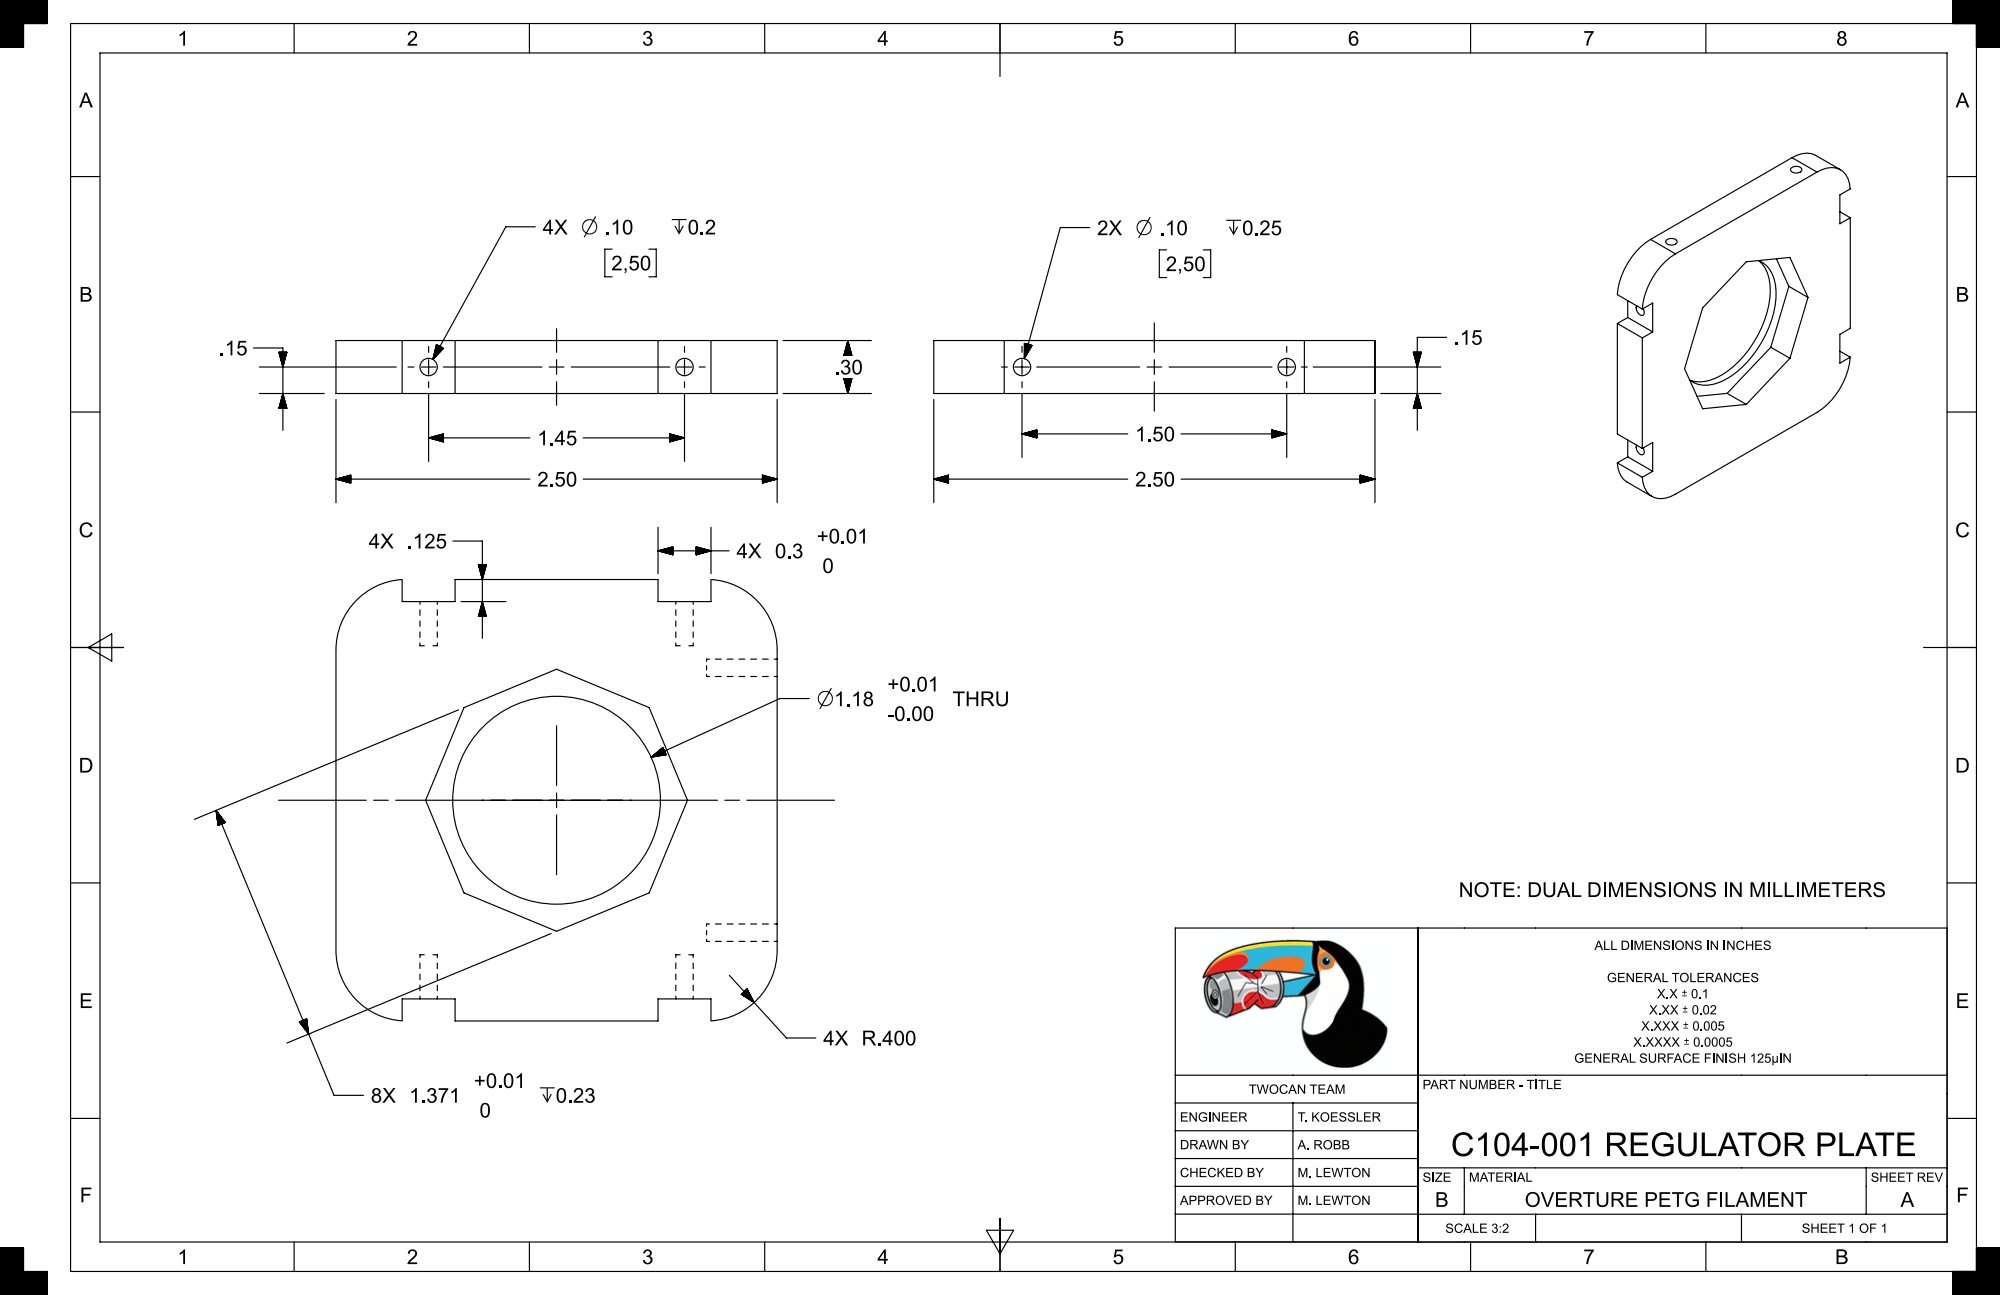
[picture p64: page 1]
