matt-lewton9/ME-463-Can-Crusher/RELEASED DWG/C104-002 STEPPER PLATE.pdf

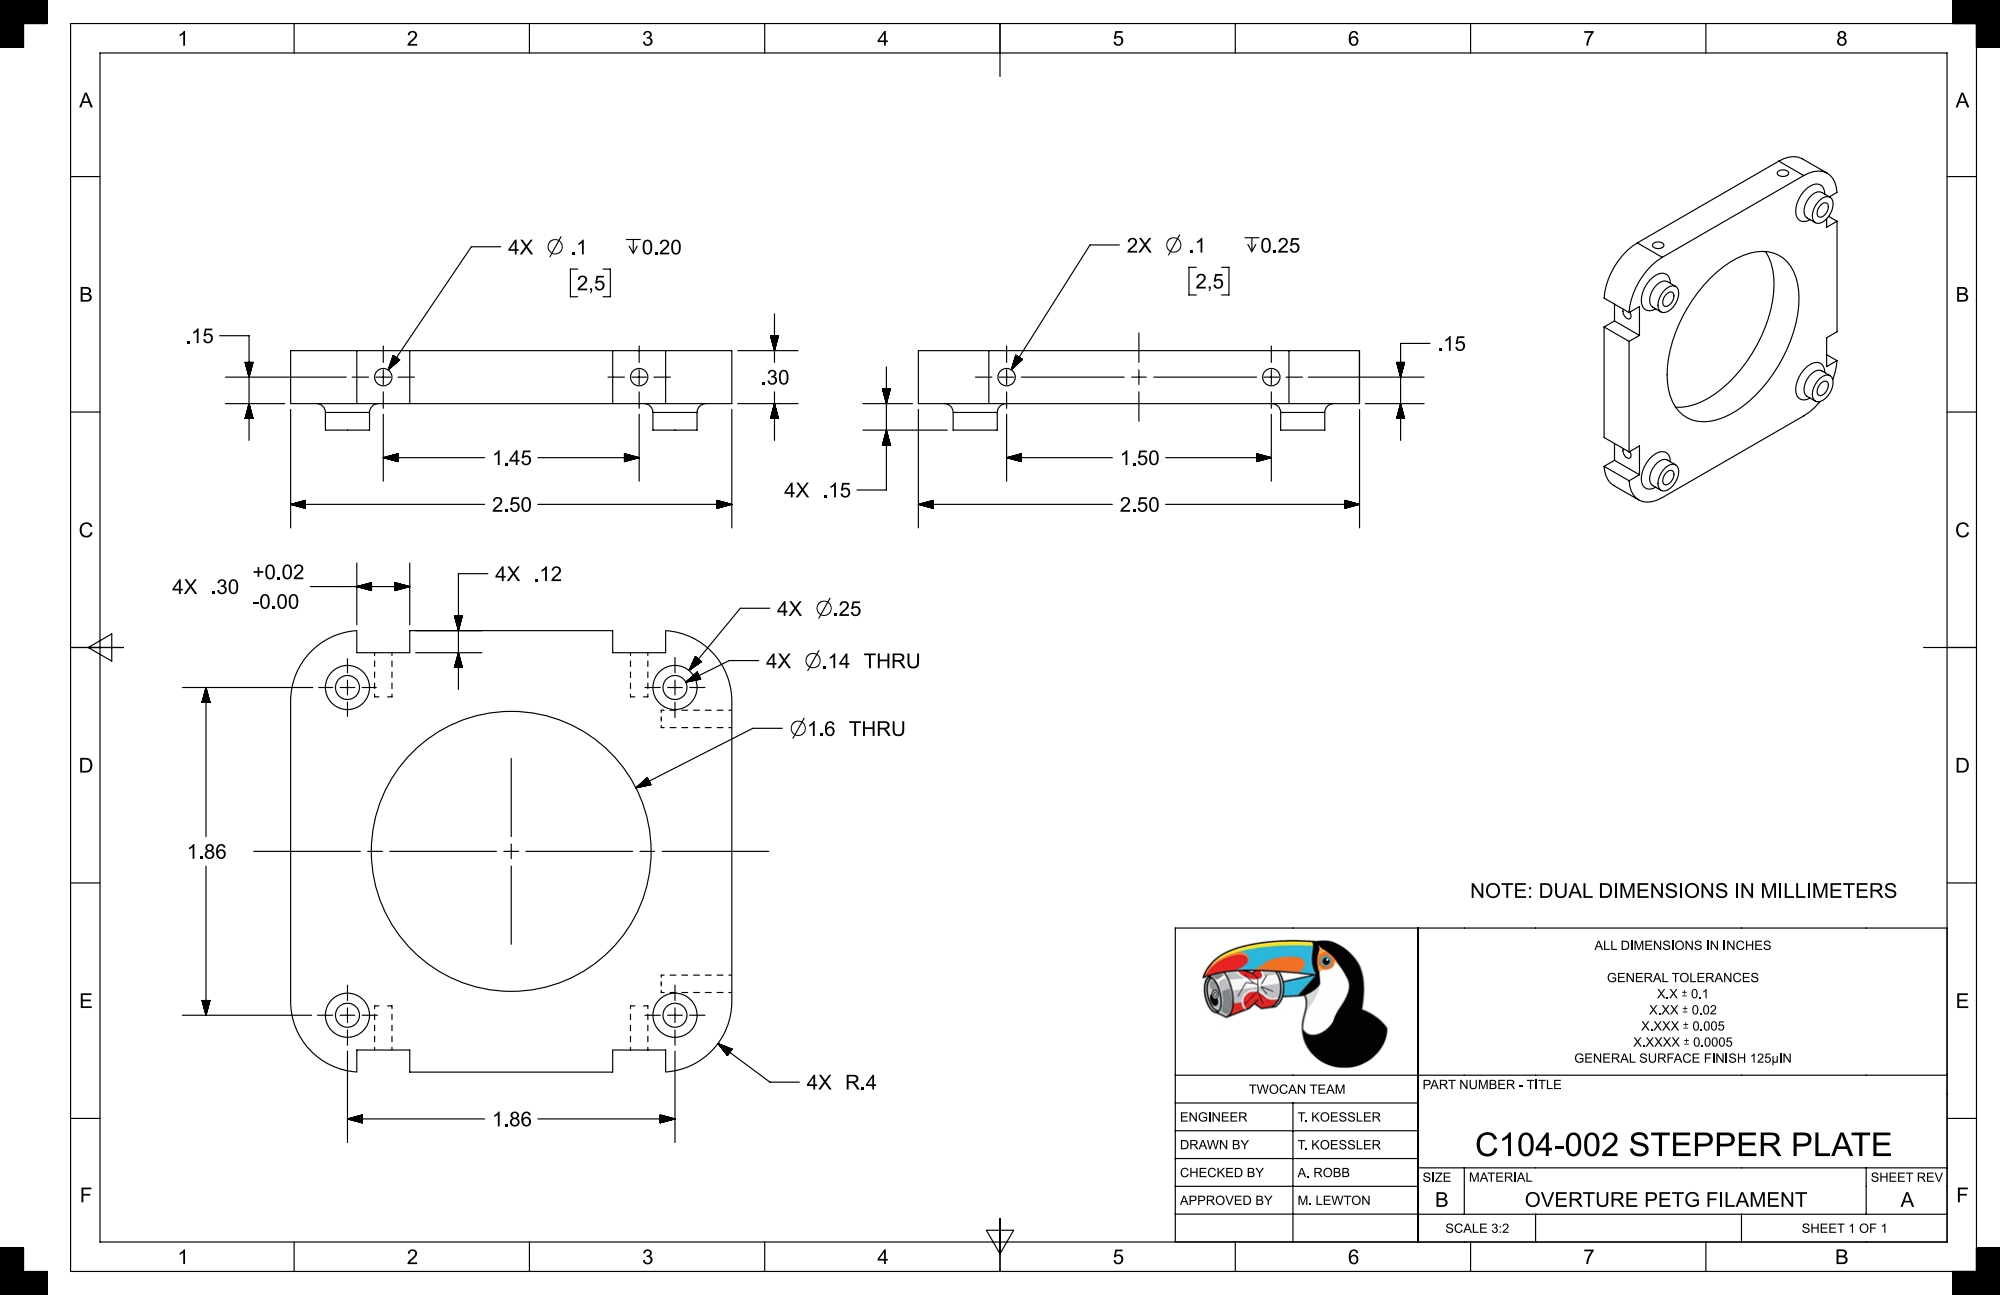
[picture p65: page 1]
