matt-lewton9/ME-463-Can-Crusher/RELEASED DWG/C104-003 FRAME MOUNTING.pdf

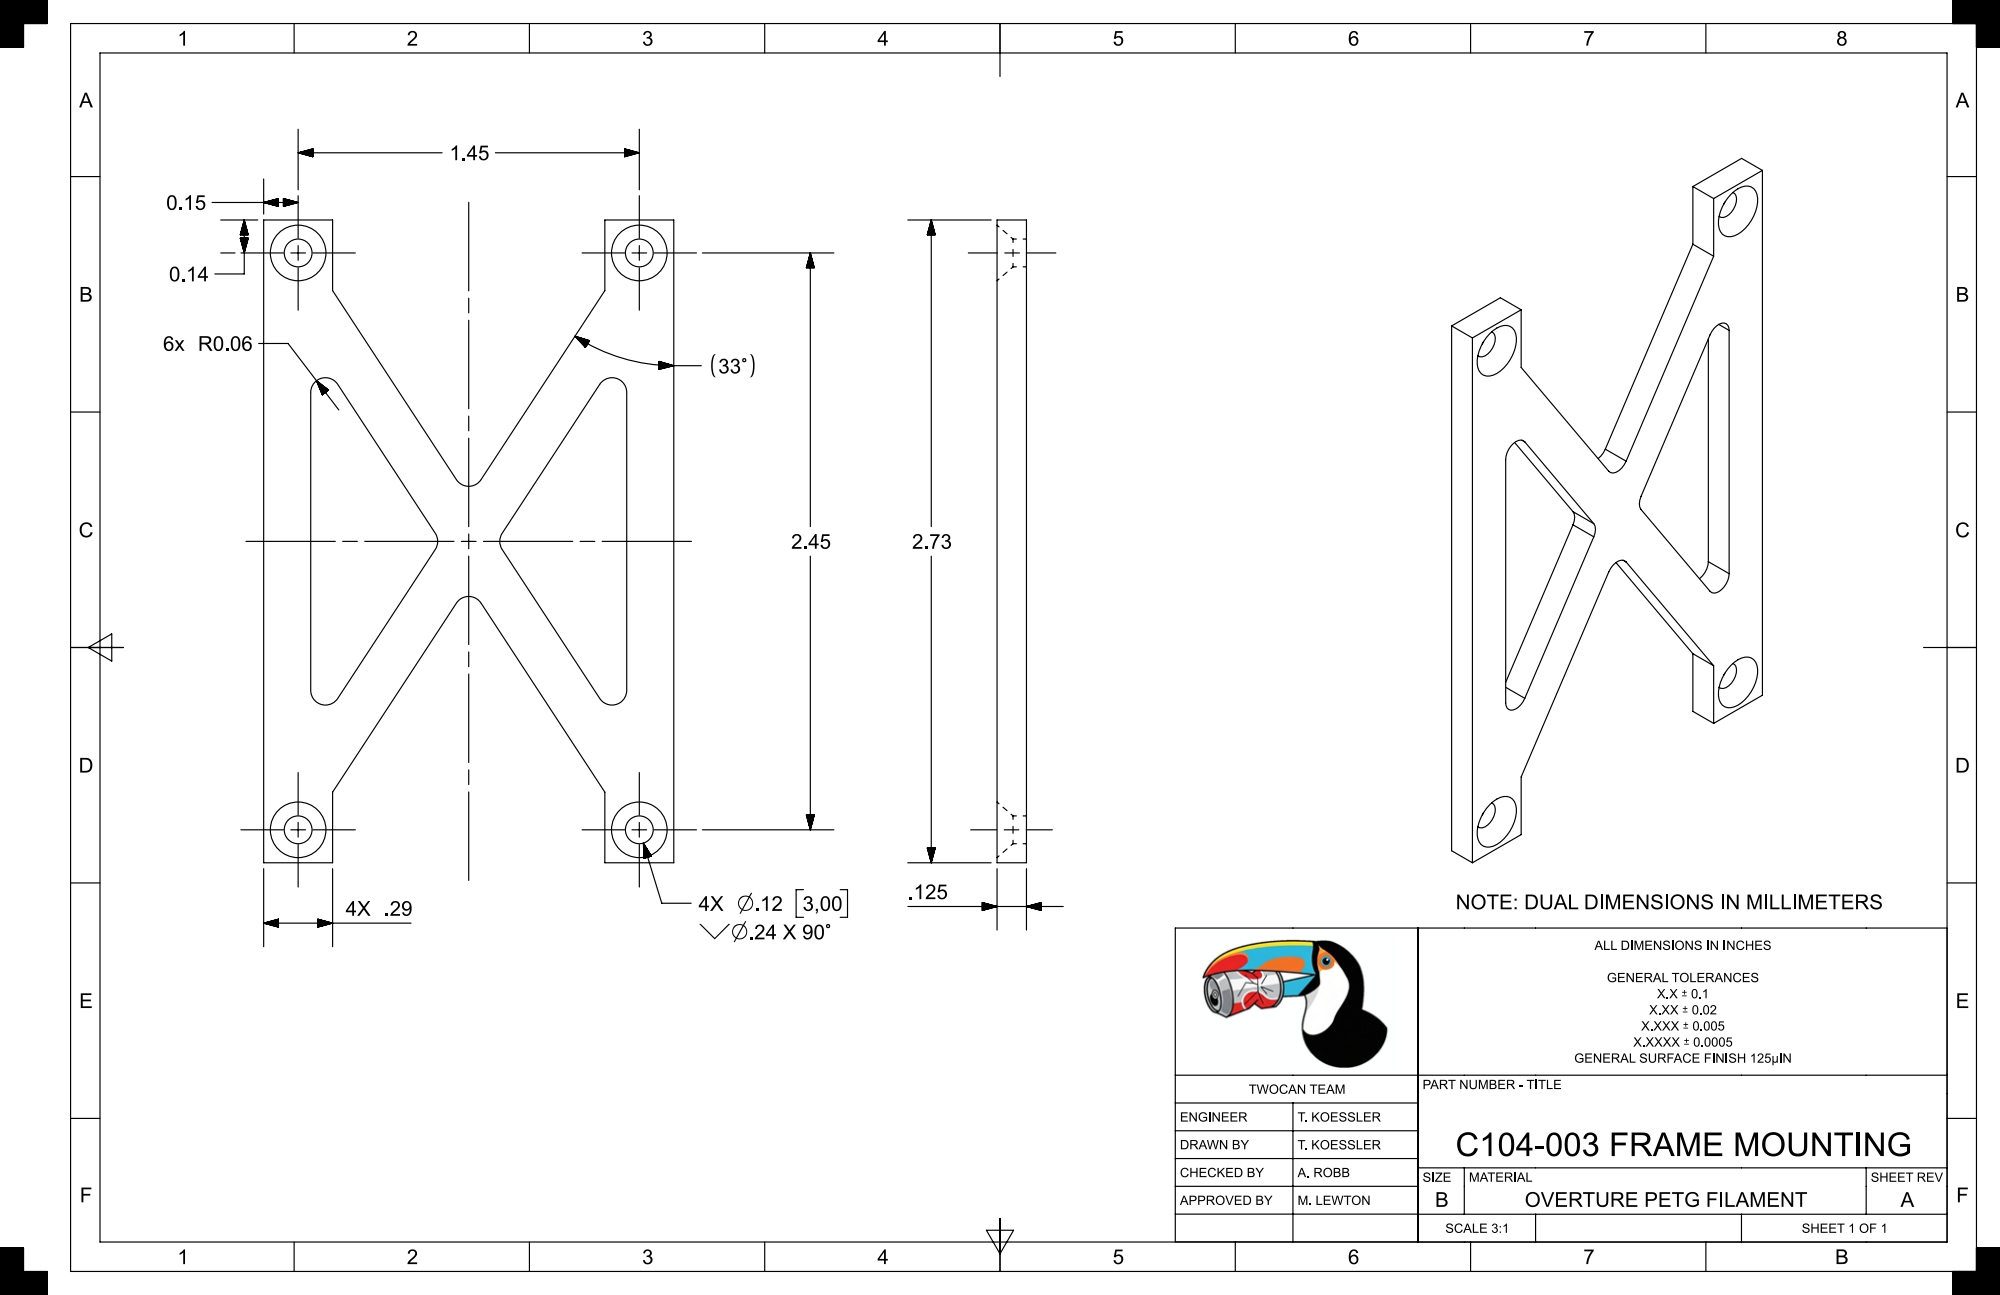
[picture p66: page 1]
