matt-lewton9/ME-463-Can-Crusher/RELEASED DWG/C104-004 COG.pdf

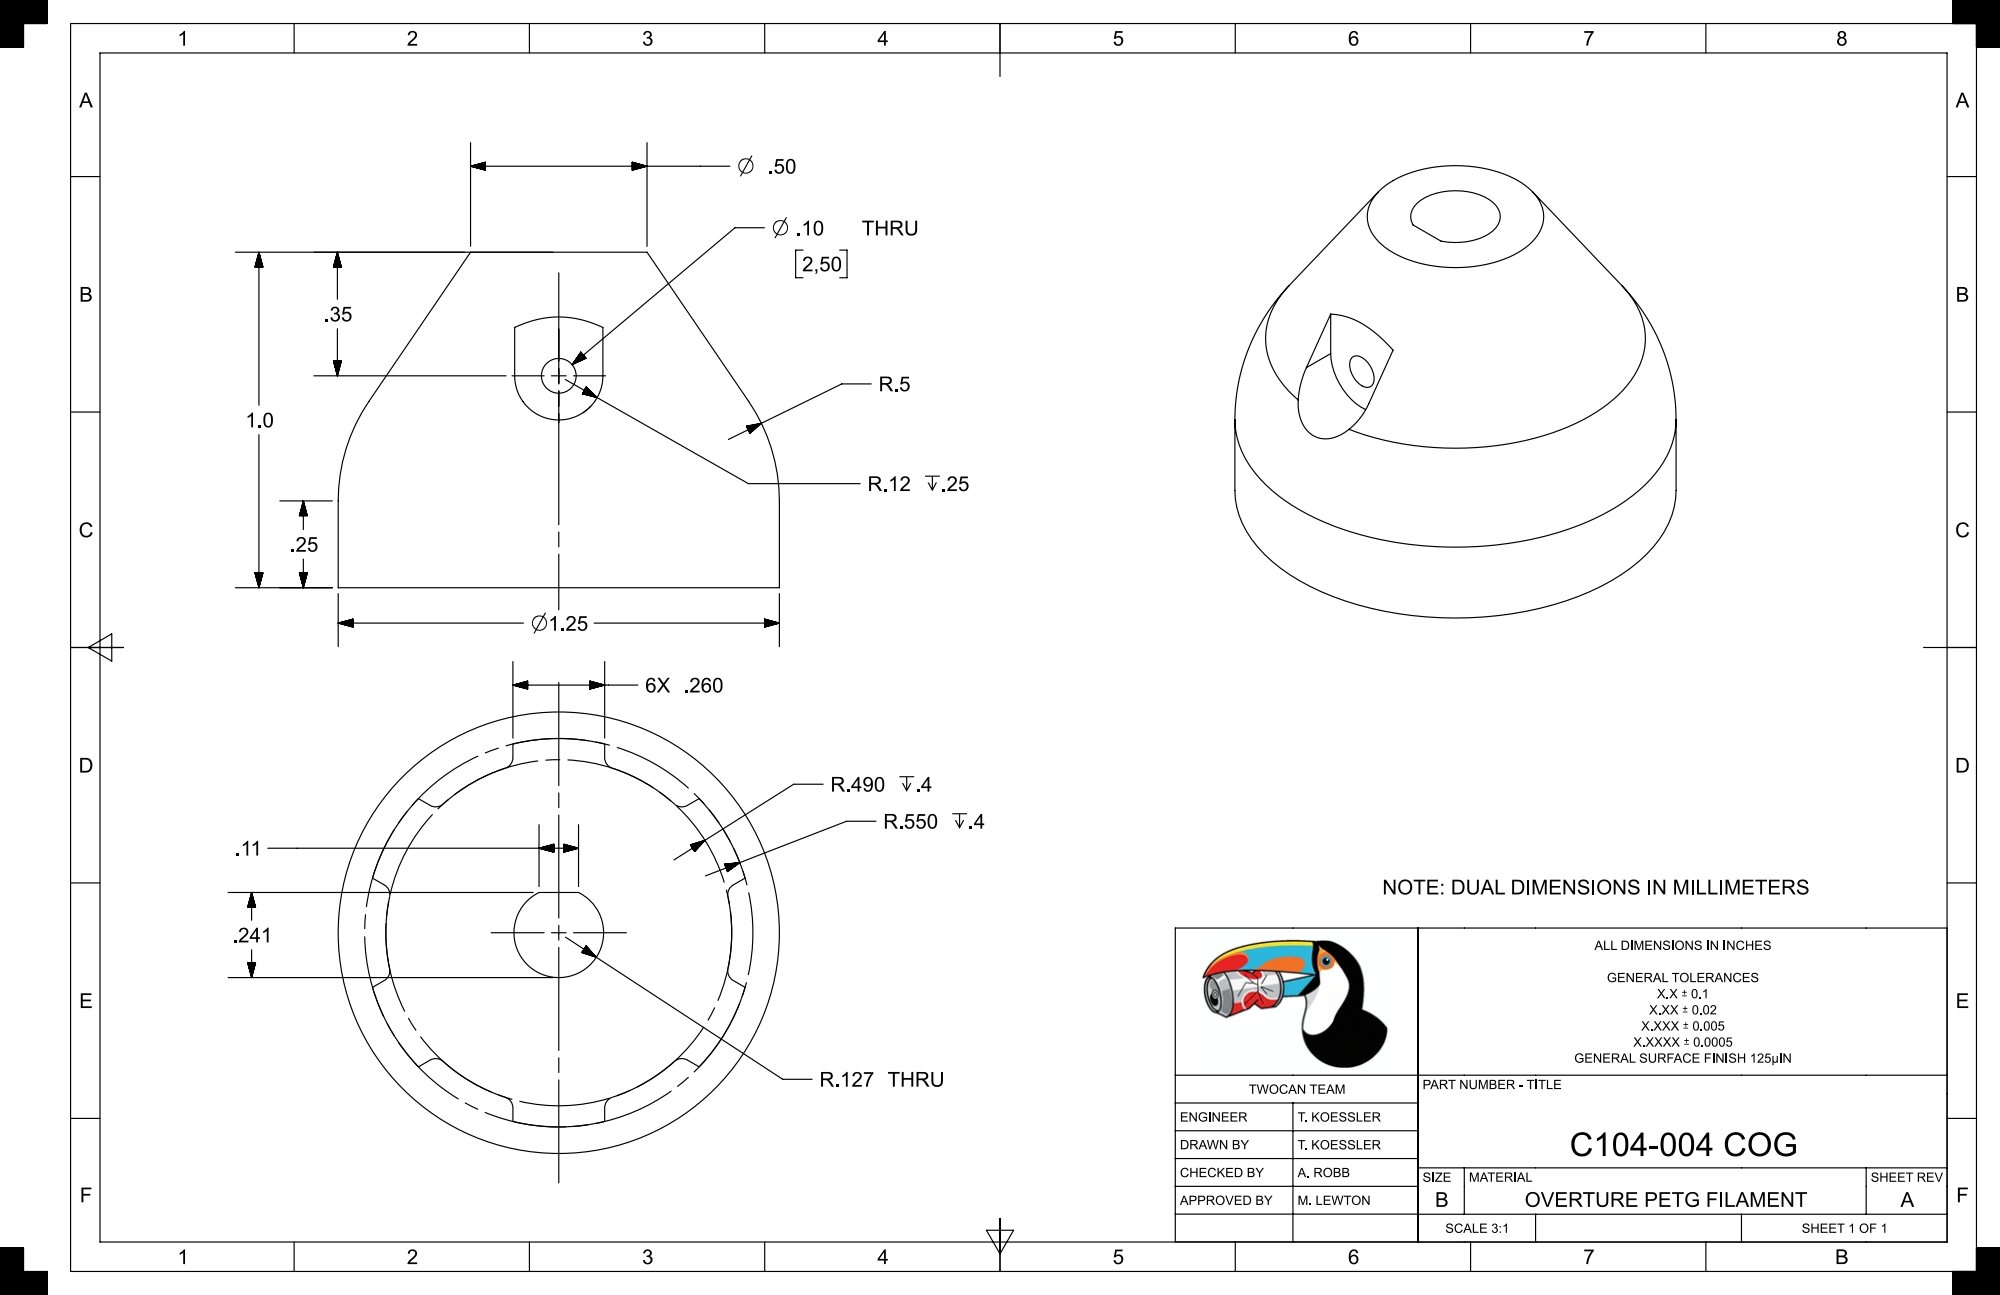
[picture p67: page 1]
