matt-lewton9/ME-463-Can-Crusher/RELEASED DWG/C104-005 PANEL.pdf

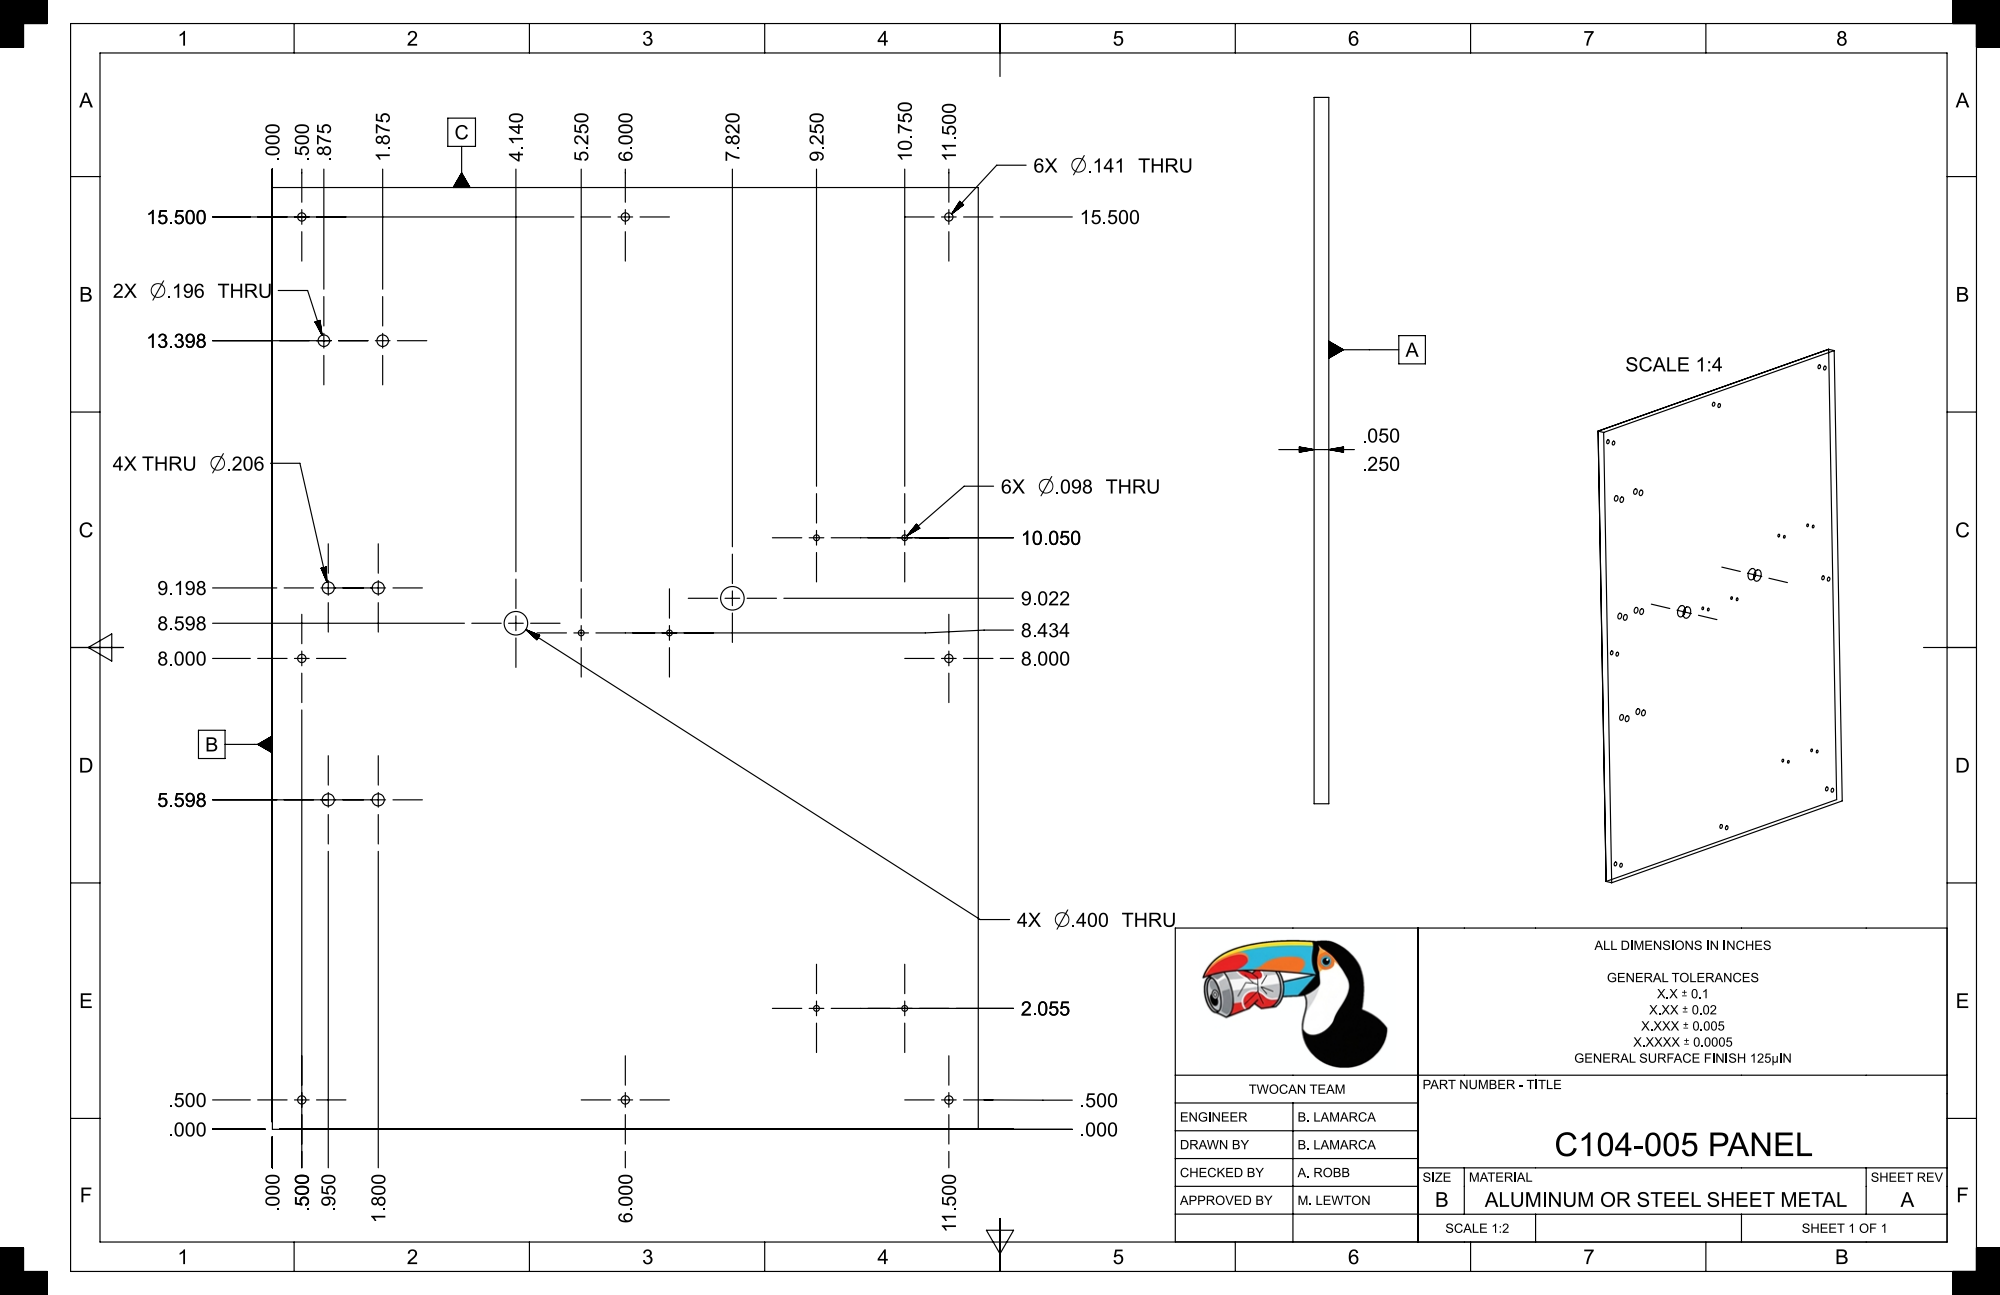
[picture p68: page 1]
