matt-lewton9/ME-463-Can-Crusher/RELEASED DWG/C107-001 ESTOP LID.pdf

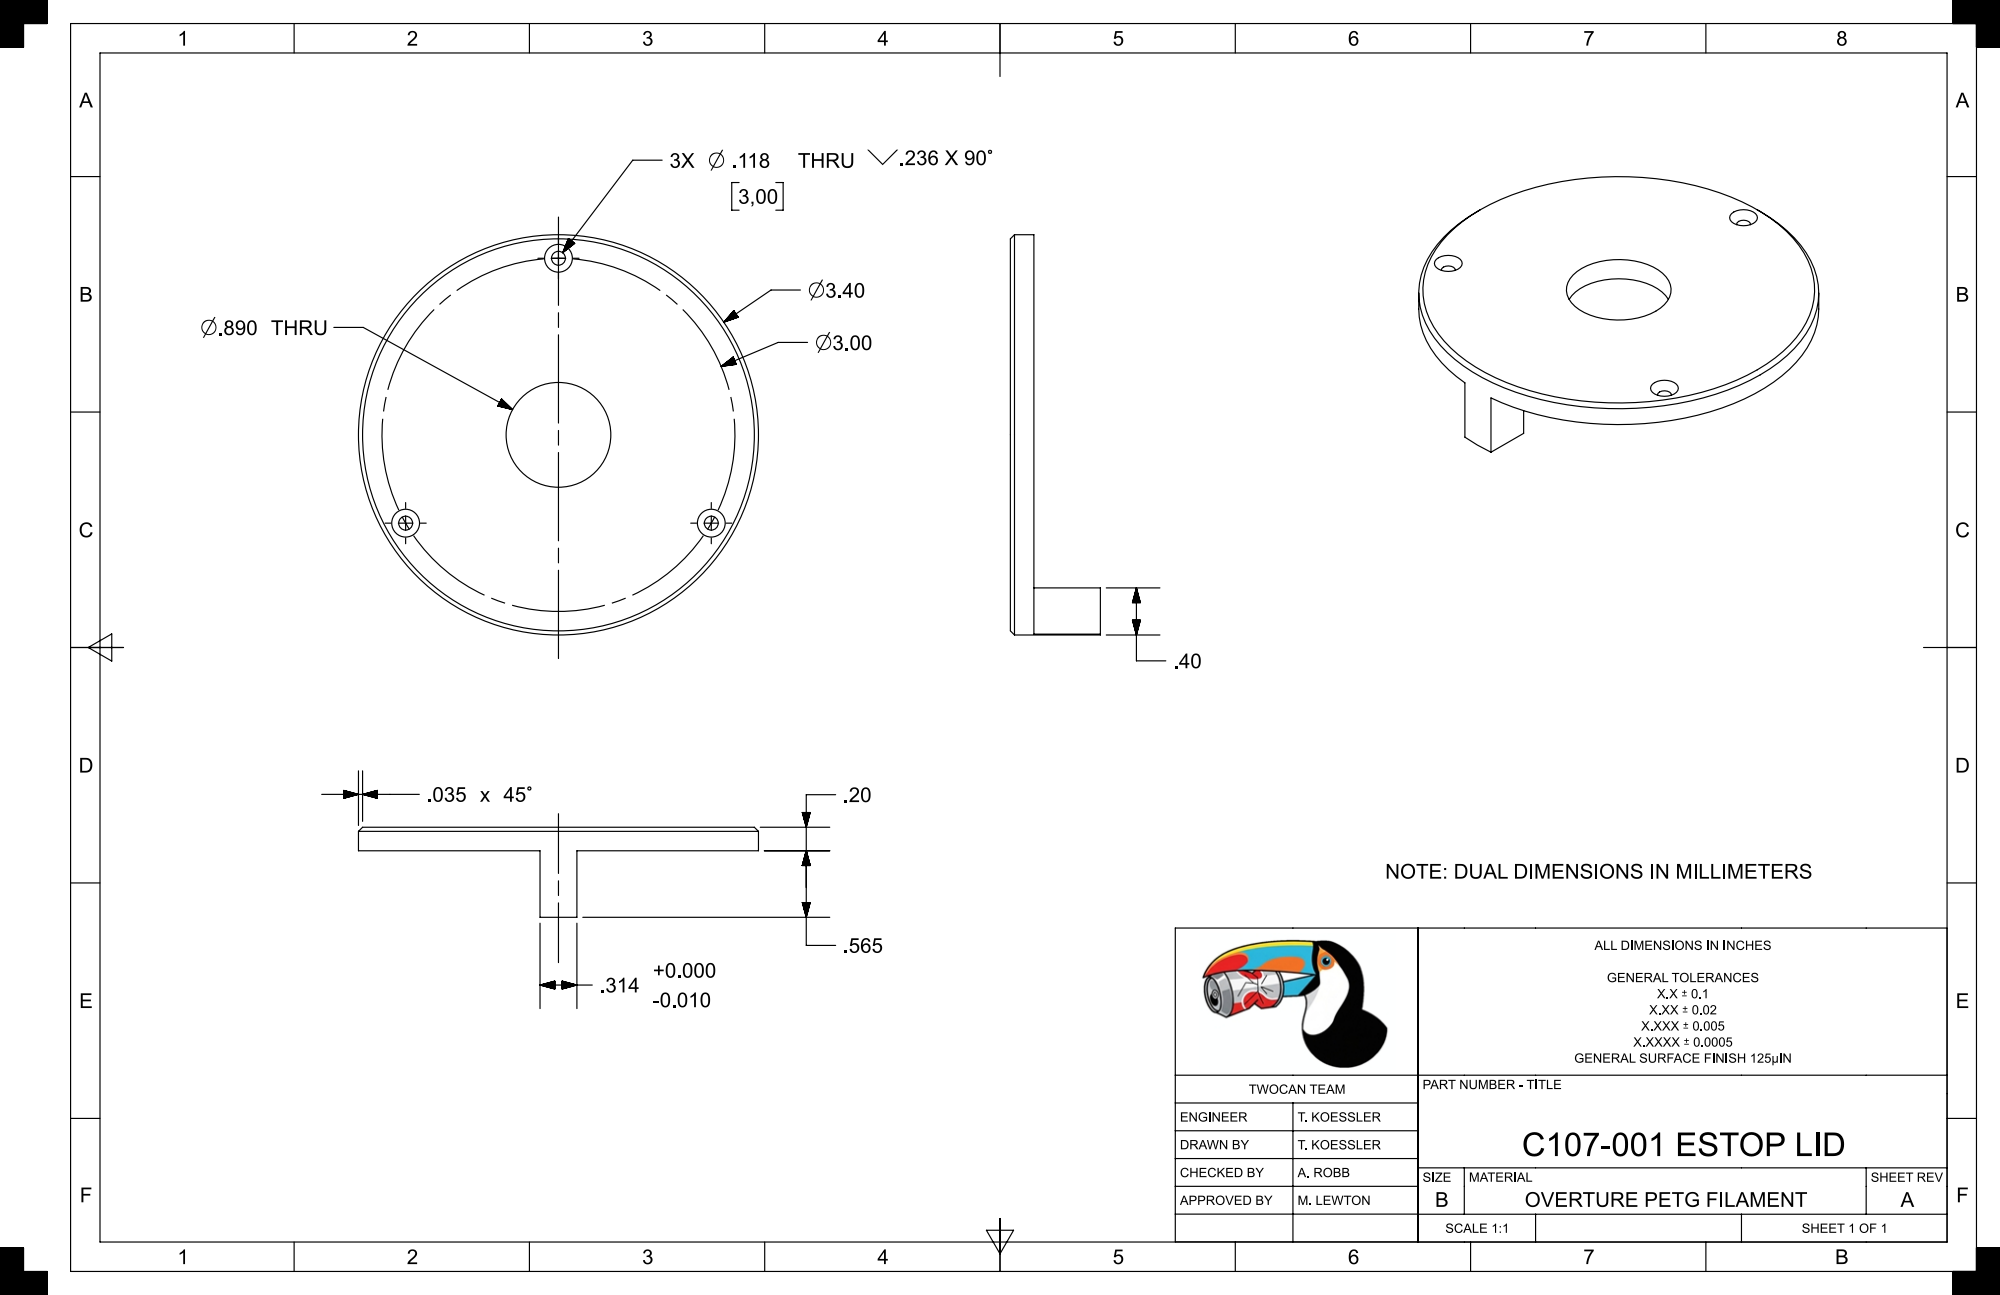
[picture p69: page 1]
