matt-lewton9/ME-463-Can-Crusher/RELEASED DWG/C107-002 ESTOP BOX.pdf

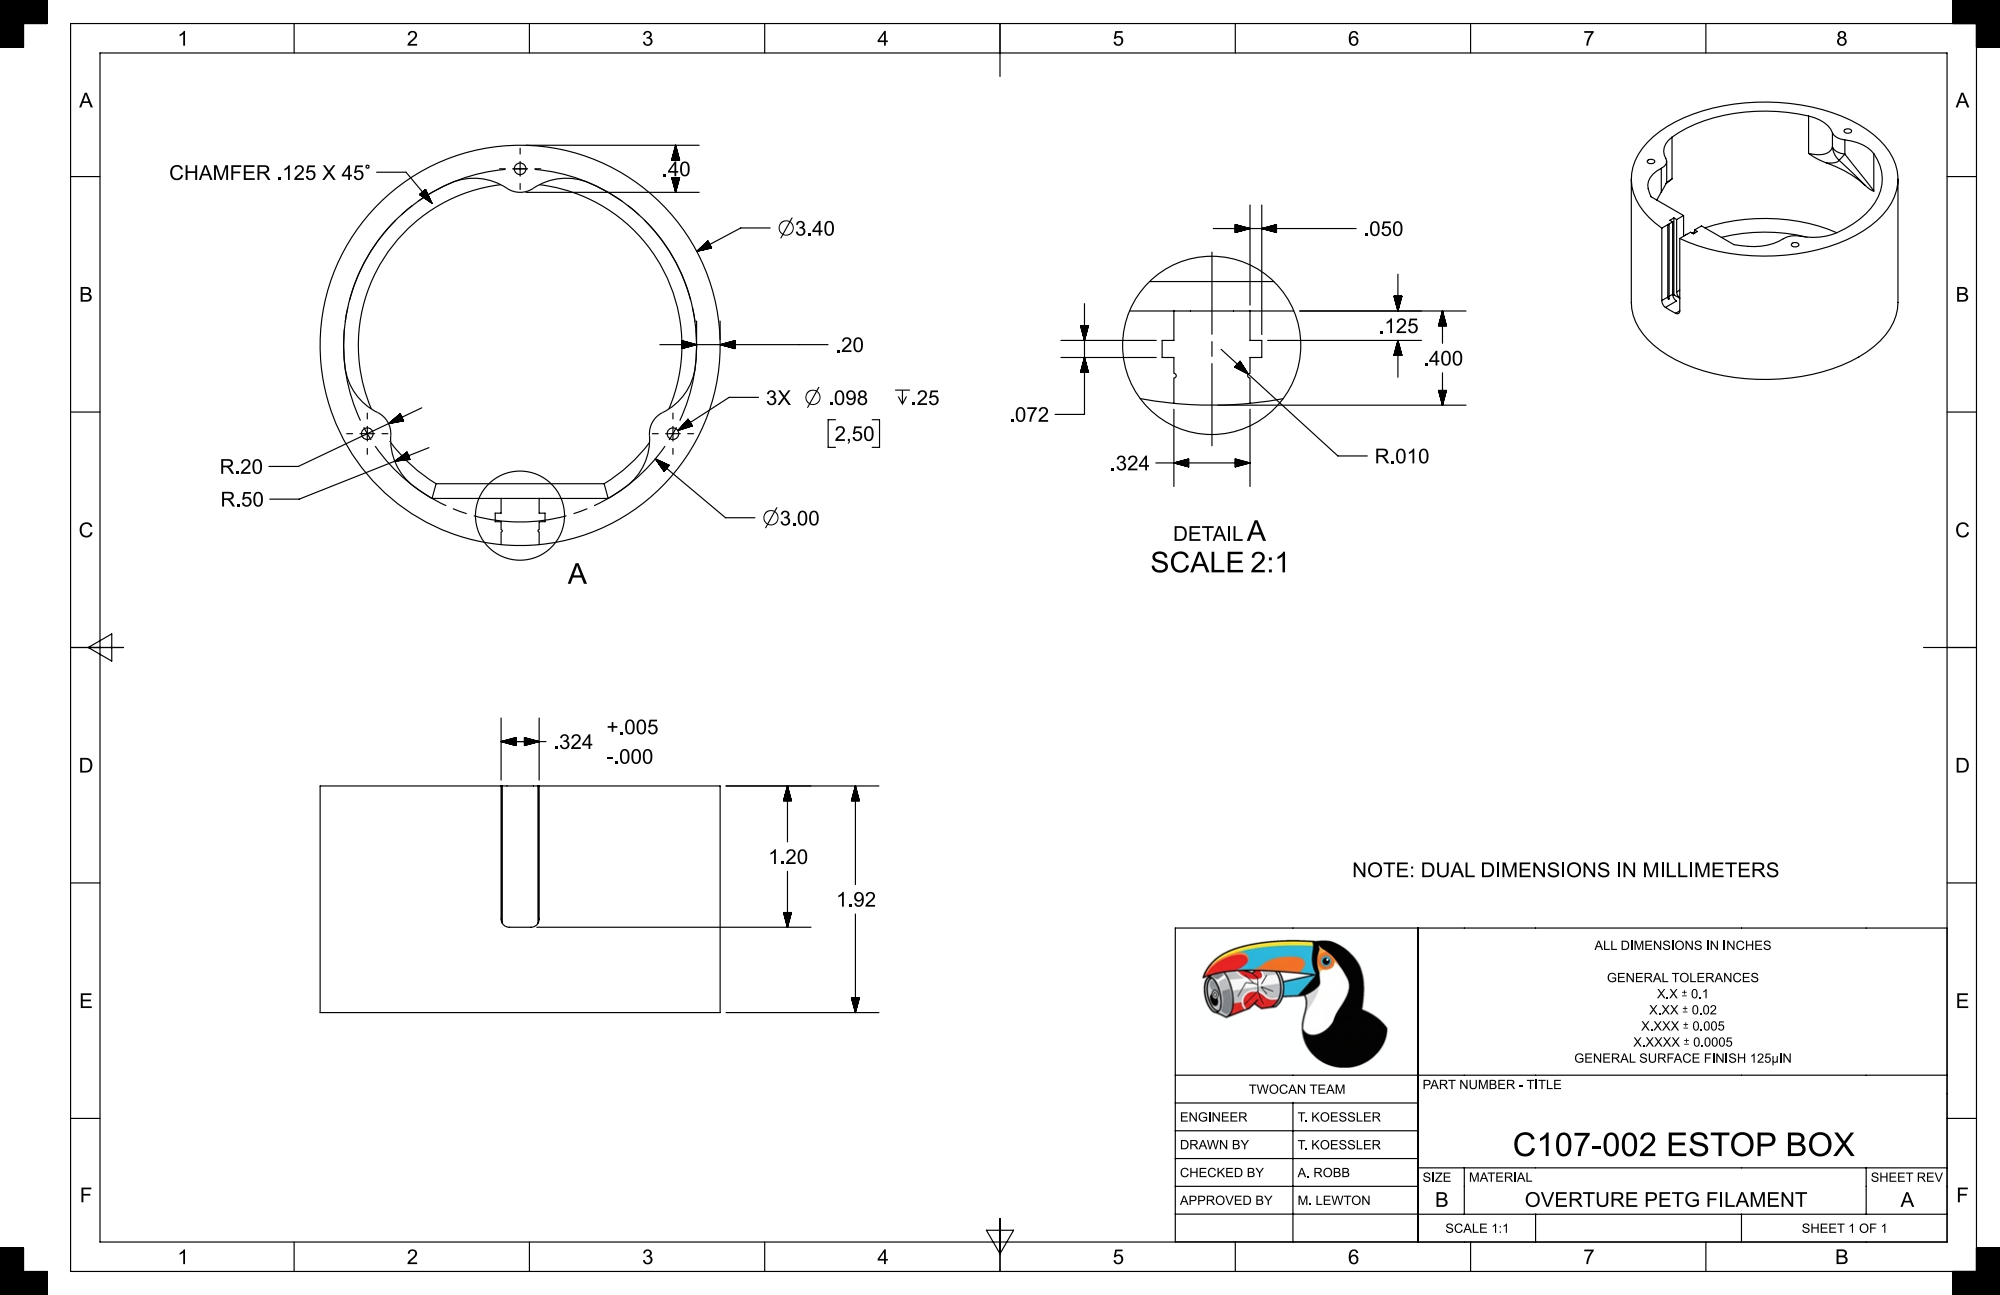
[picture p70: page 1]
