matt-lewton9/ME-463-Can-Crusher/PRE-RELEASE DWG/C107-001 ESTOP LID_PRE-RELEASE.pdf

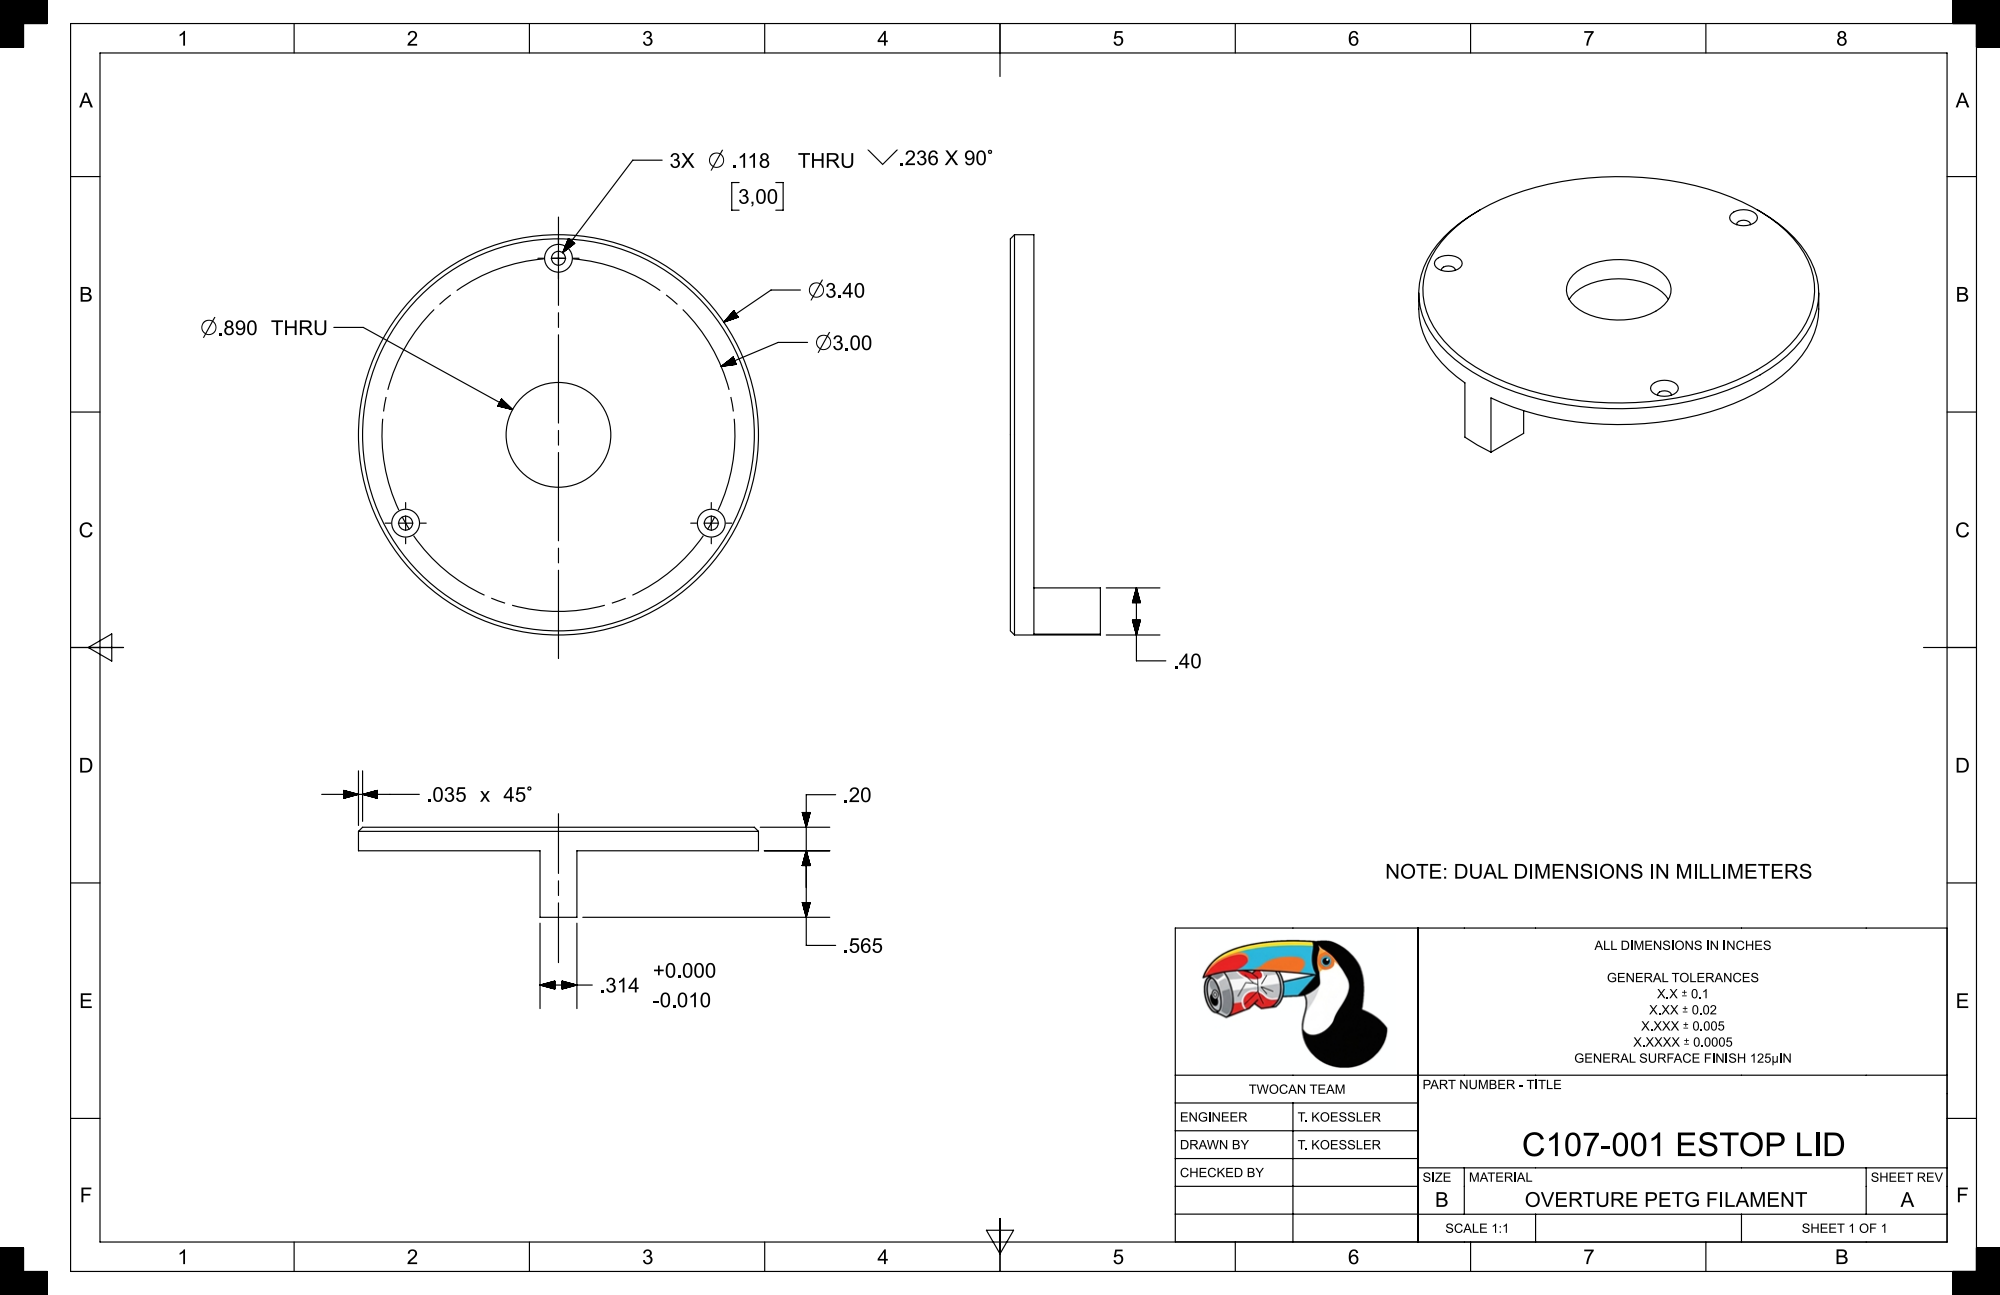
[picture p71: page 1]
