matt-lewton9/ME-463-Can-Crusher/PRE-RELEASE DWG/C107-002 ESTOP BOX PRE-RELEASE.pdf

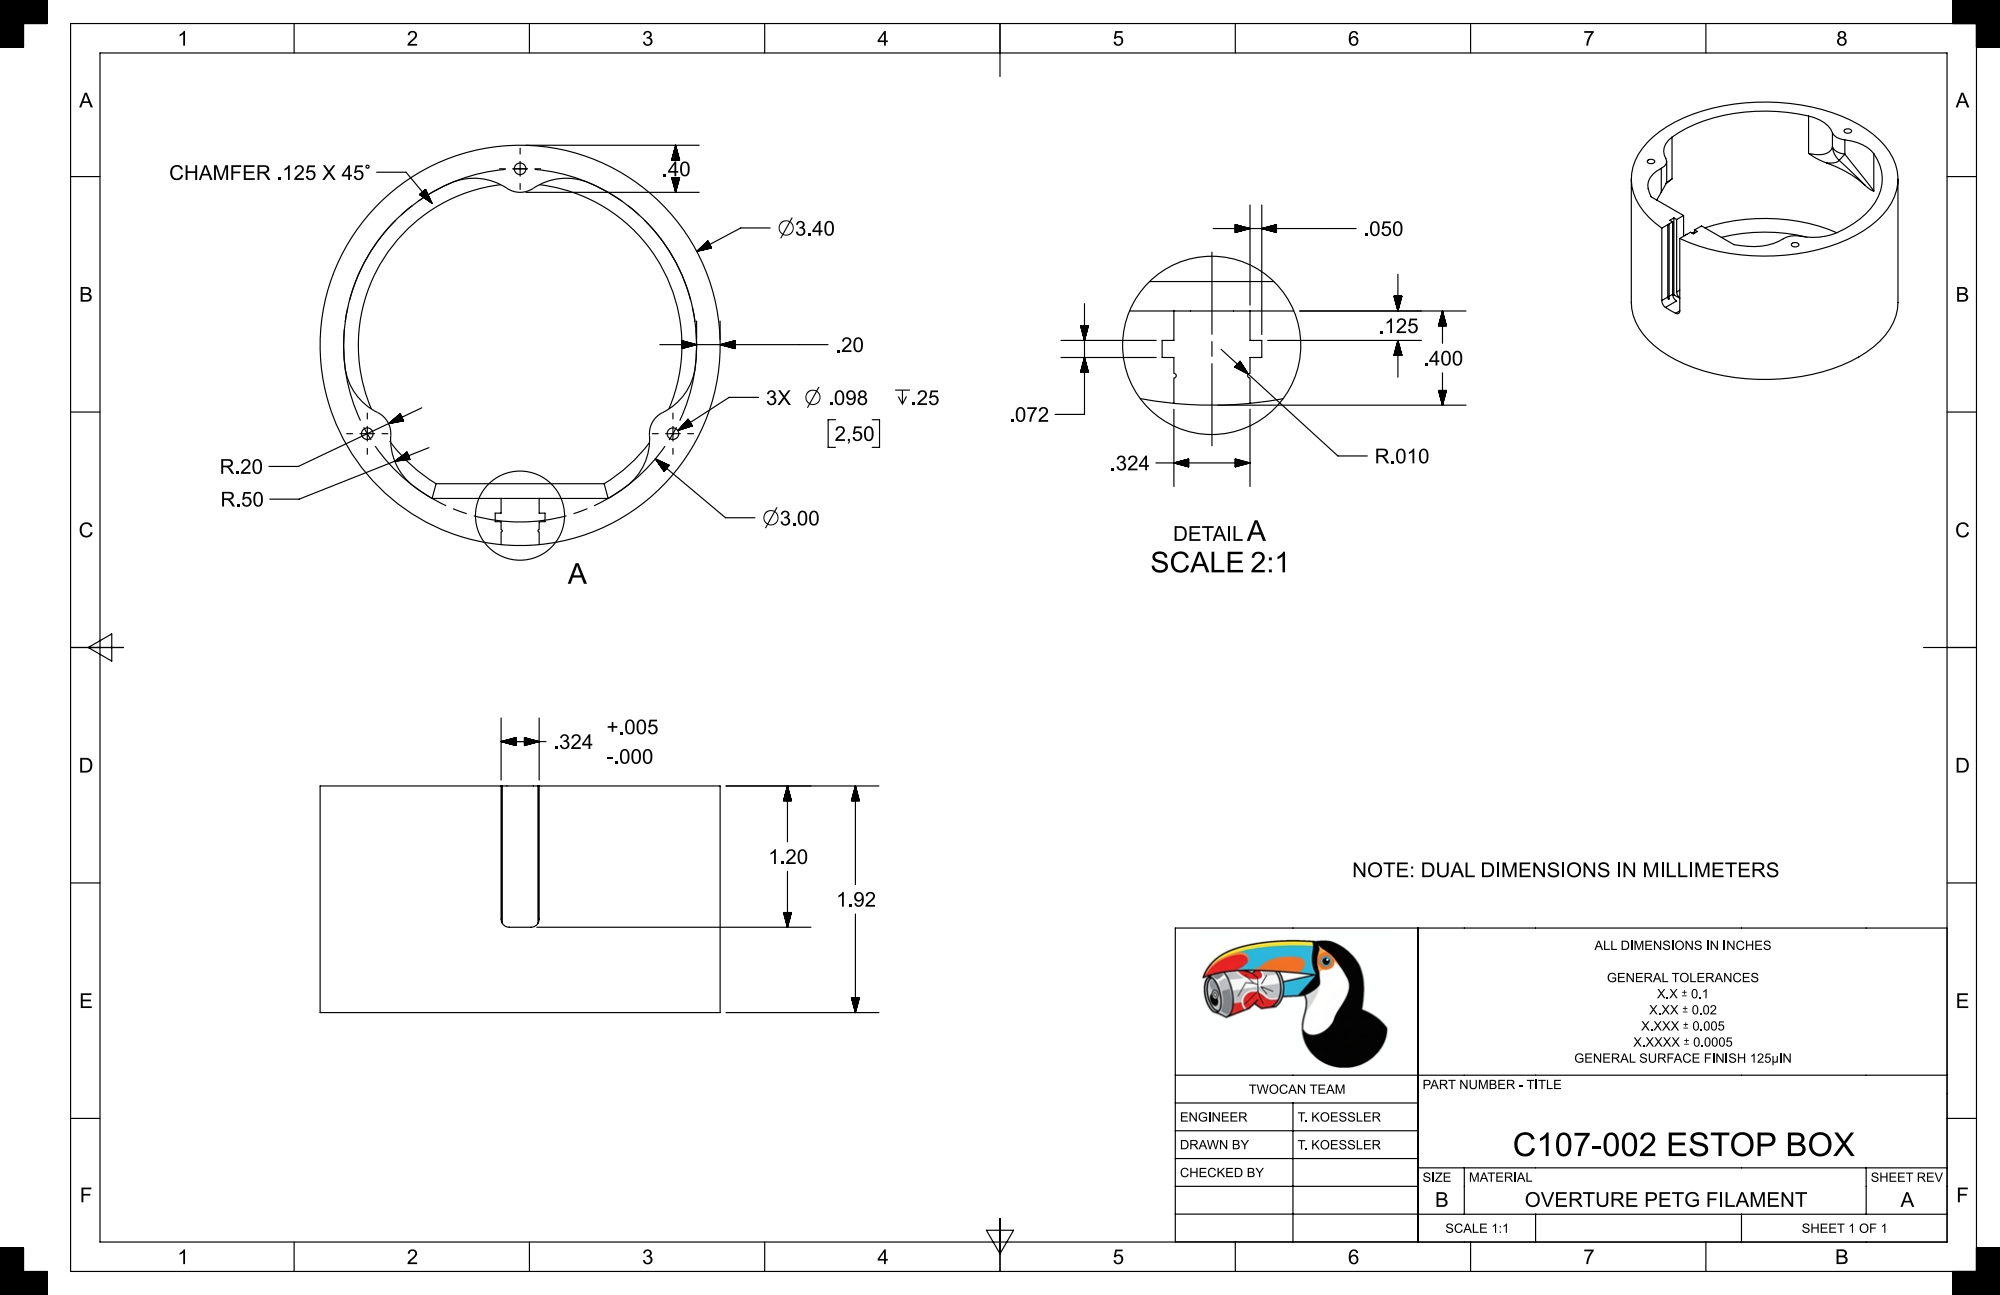
[picture p72: page 1]
