matt-lewton9/ME-463-Can-Crusher/PRE-RELEASE DWG/C103-002 CYLINDER WALL PRE-RELEASE.pdf

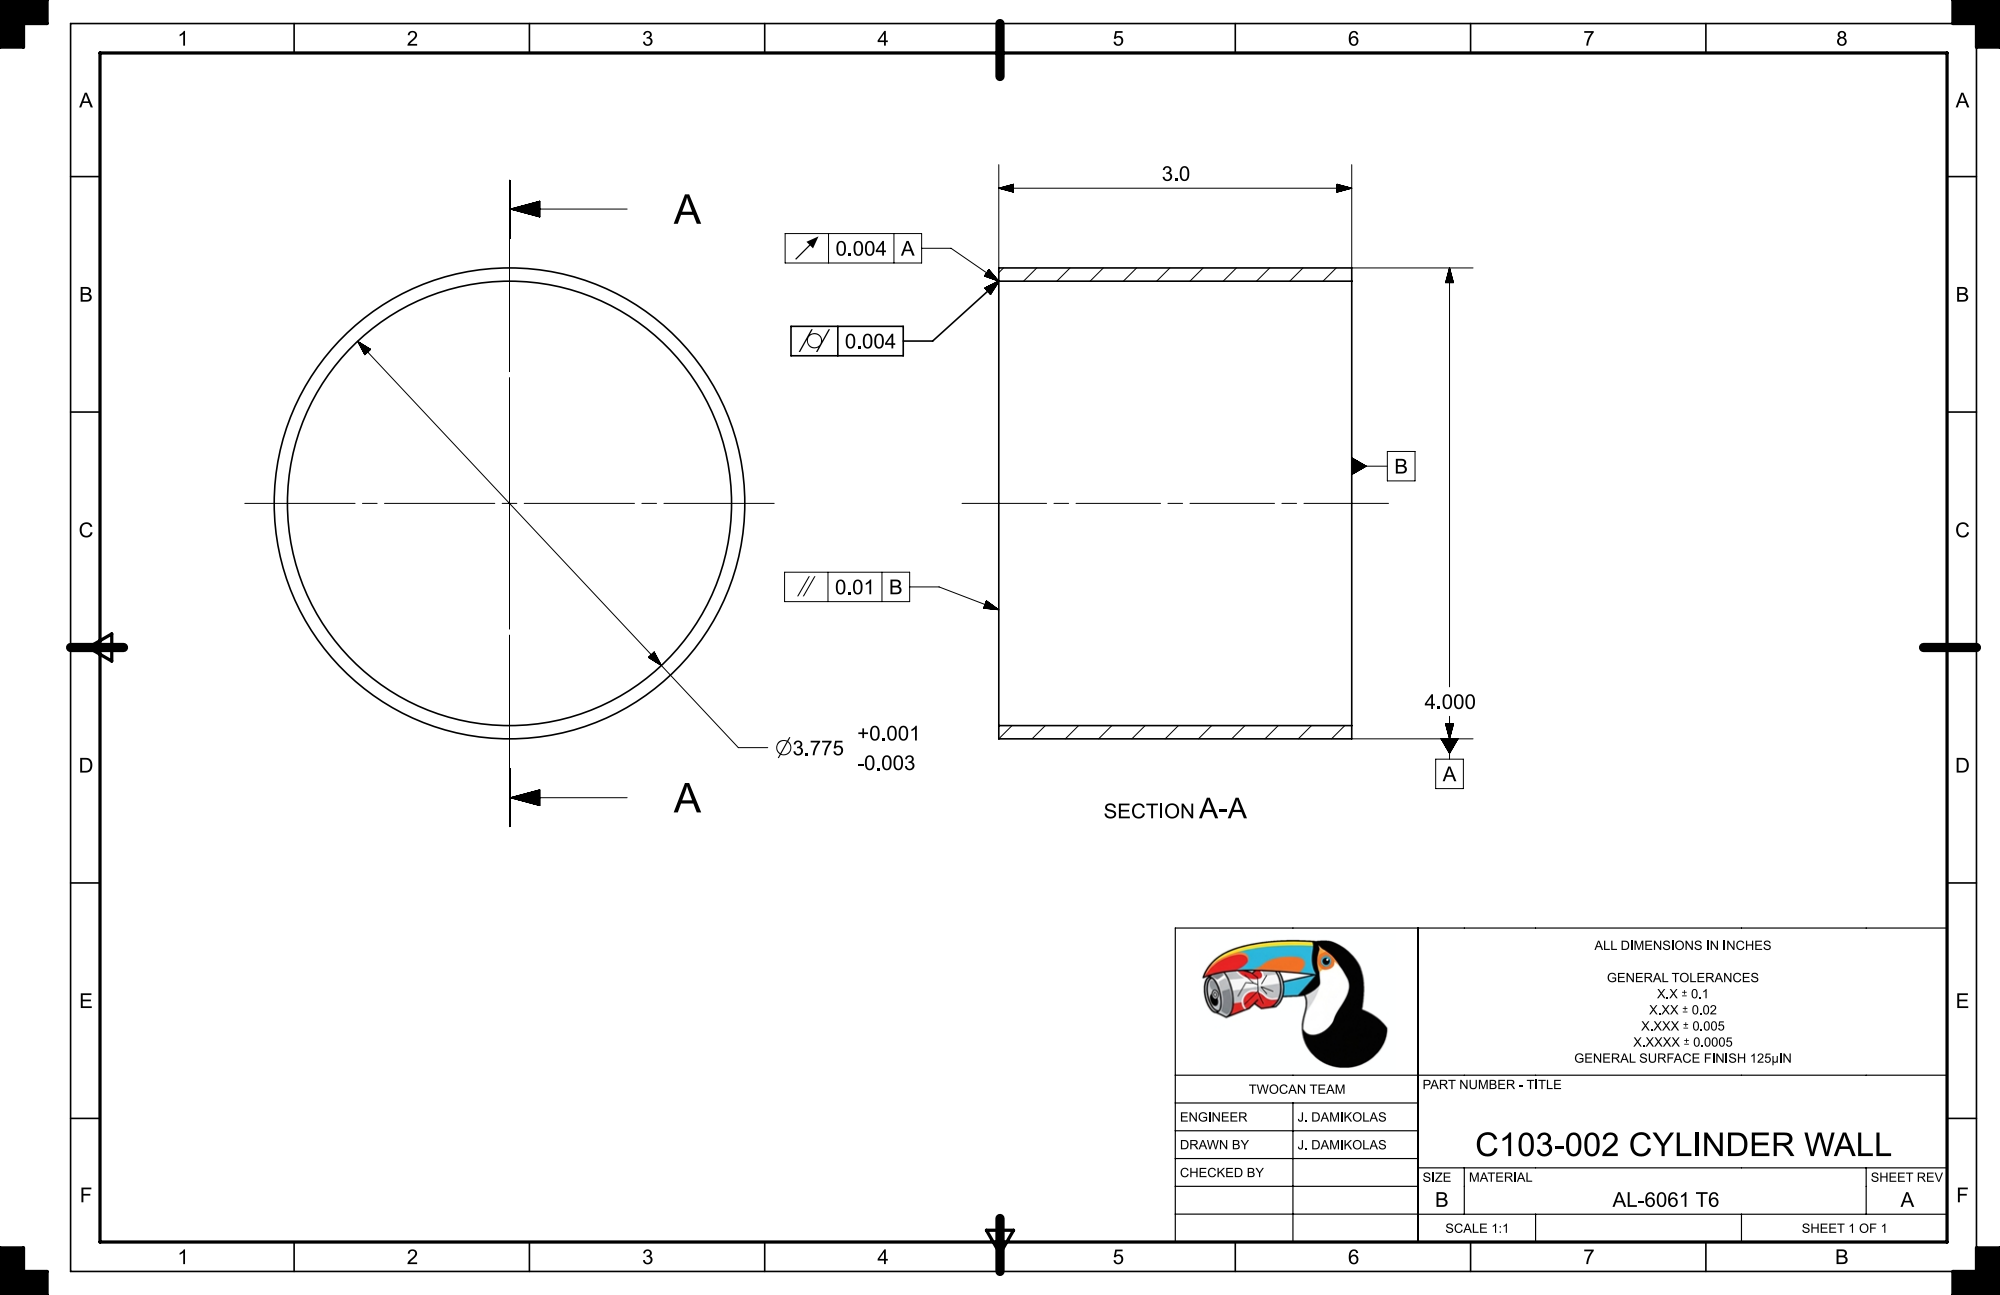
[picture p73: page 1]
