matt-lewton9/ME-463-Can-Crusher/PRE-RELEASE DWG/C103-004 PISTON PRE-RELEASE.pdf

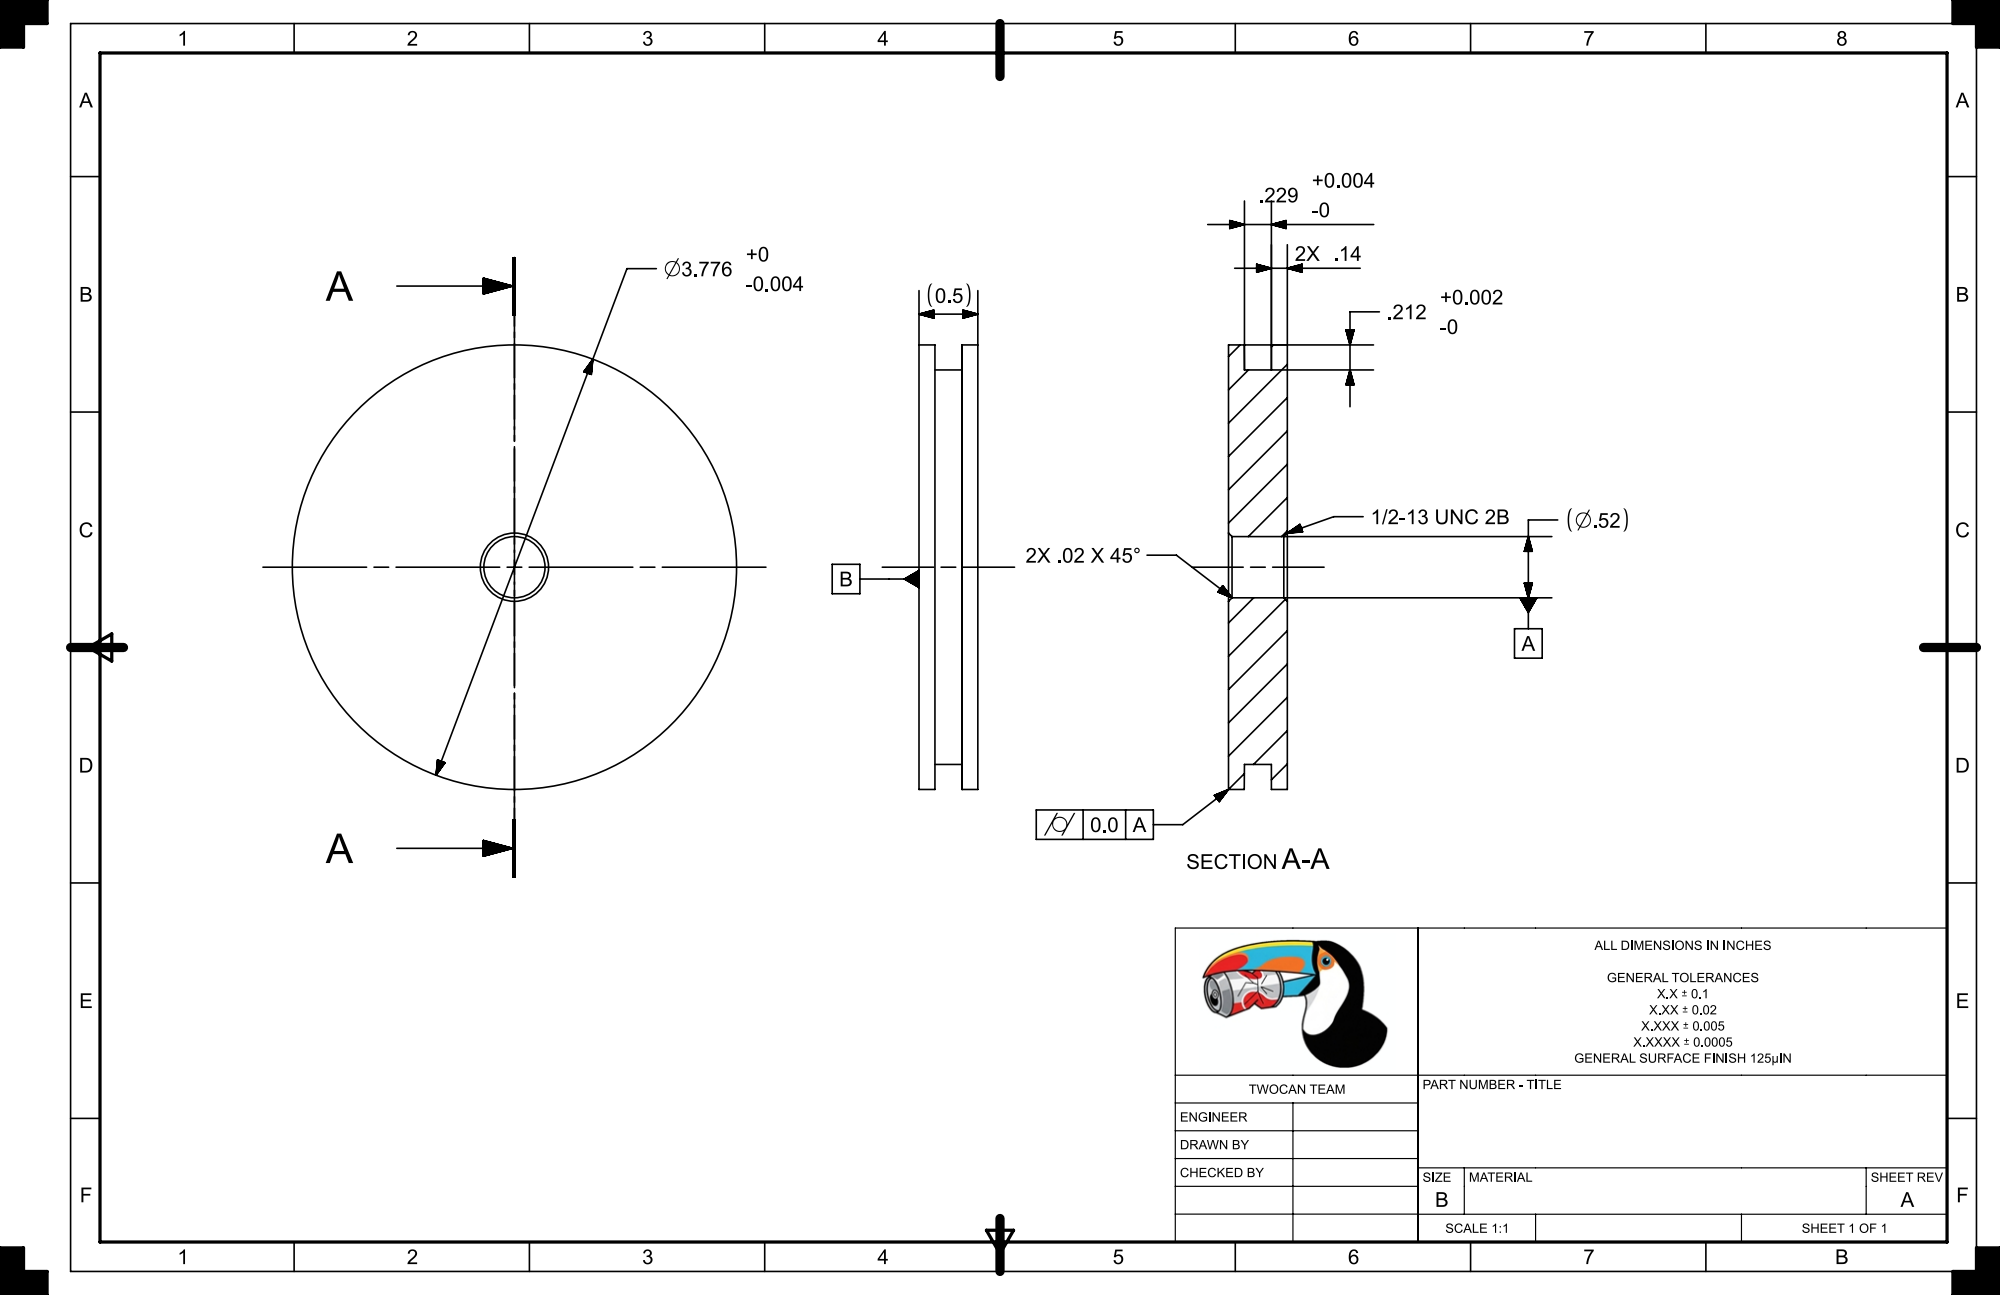
[picture p74: page 1]
