matt-lewton9/ME-463-Can-Crusher/PRE-RELEASE DWG/C103-006 MANIFOLD_PRE-RELEASE.pdf

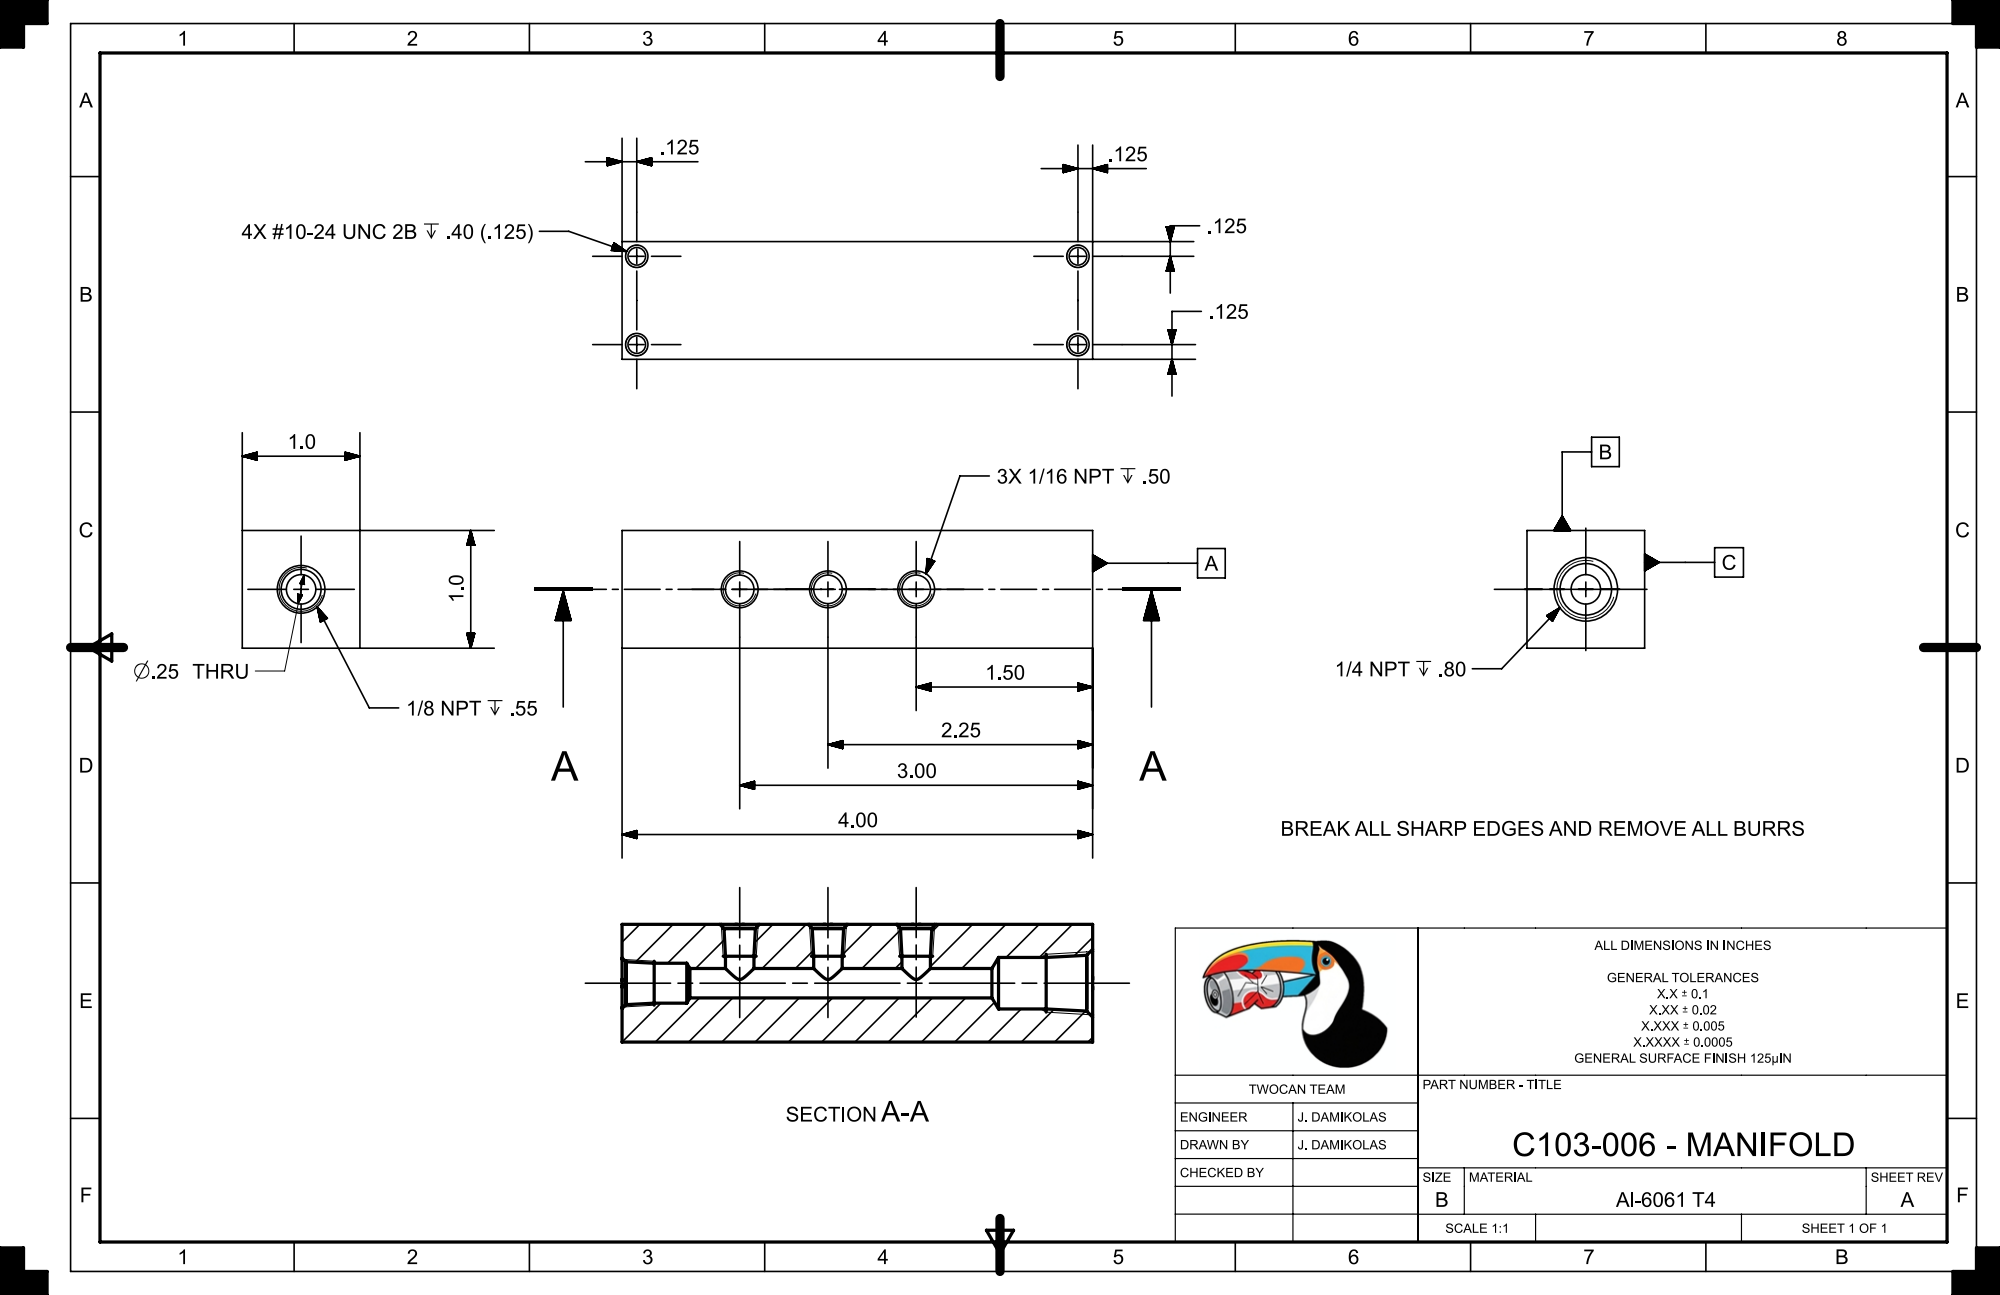
[picture p75: page 1]
