matt-lewton9/ME-463-Can-Crusher/RELEASED DWG/C106-001 PULLEY.pdf

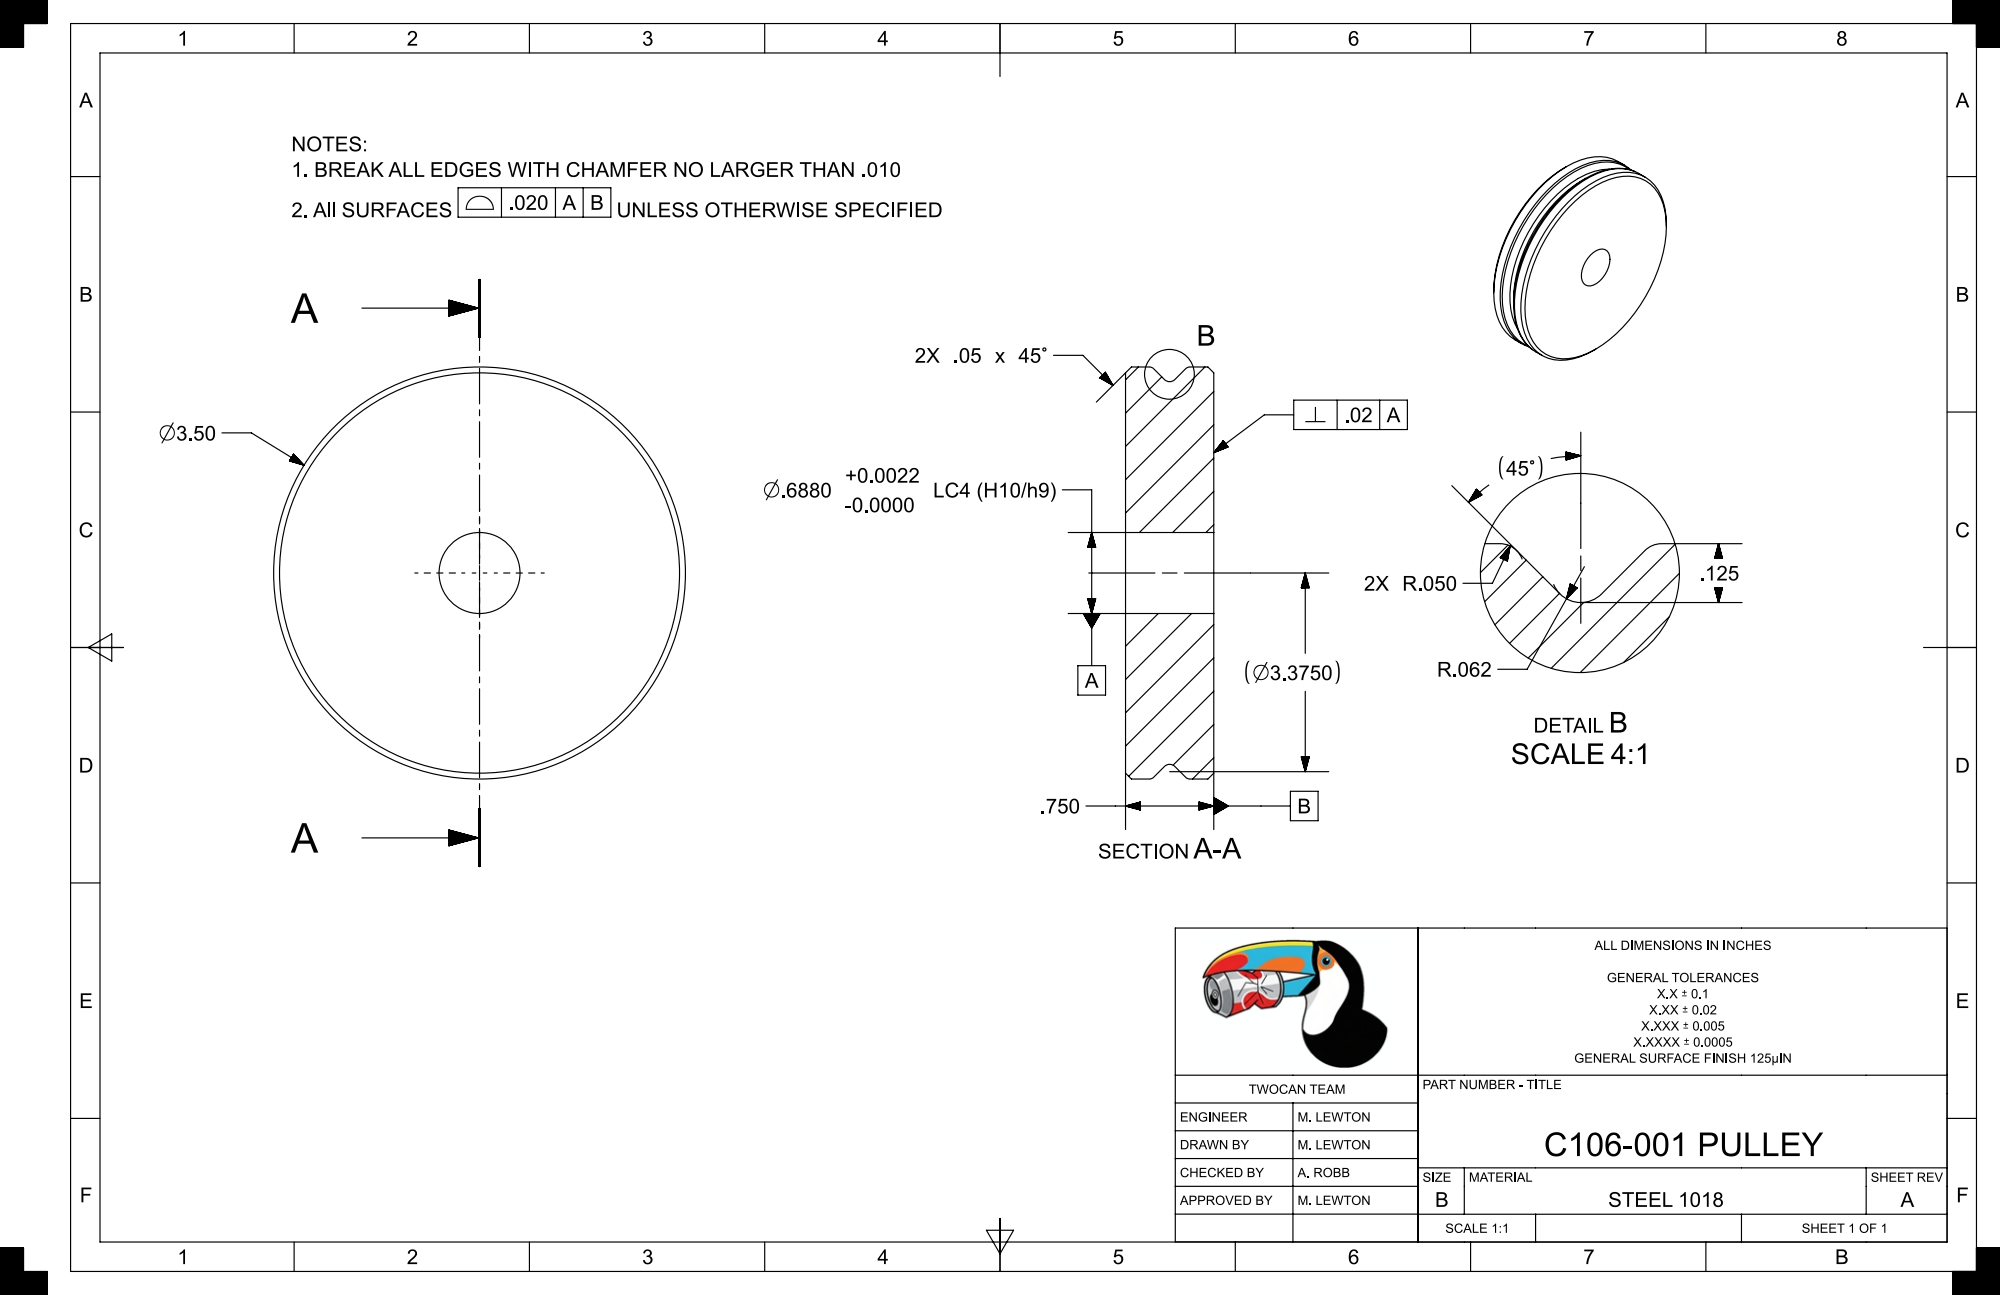
[picture p76: page 1]
