matt-lewton9/ME-463-Can-Crusher/PRE-RELEASE DWG/C104-005 PANEL.pdf

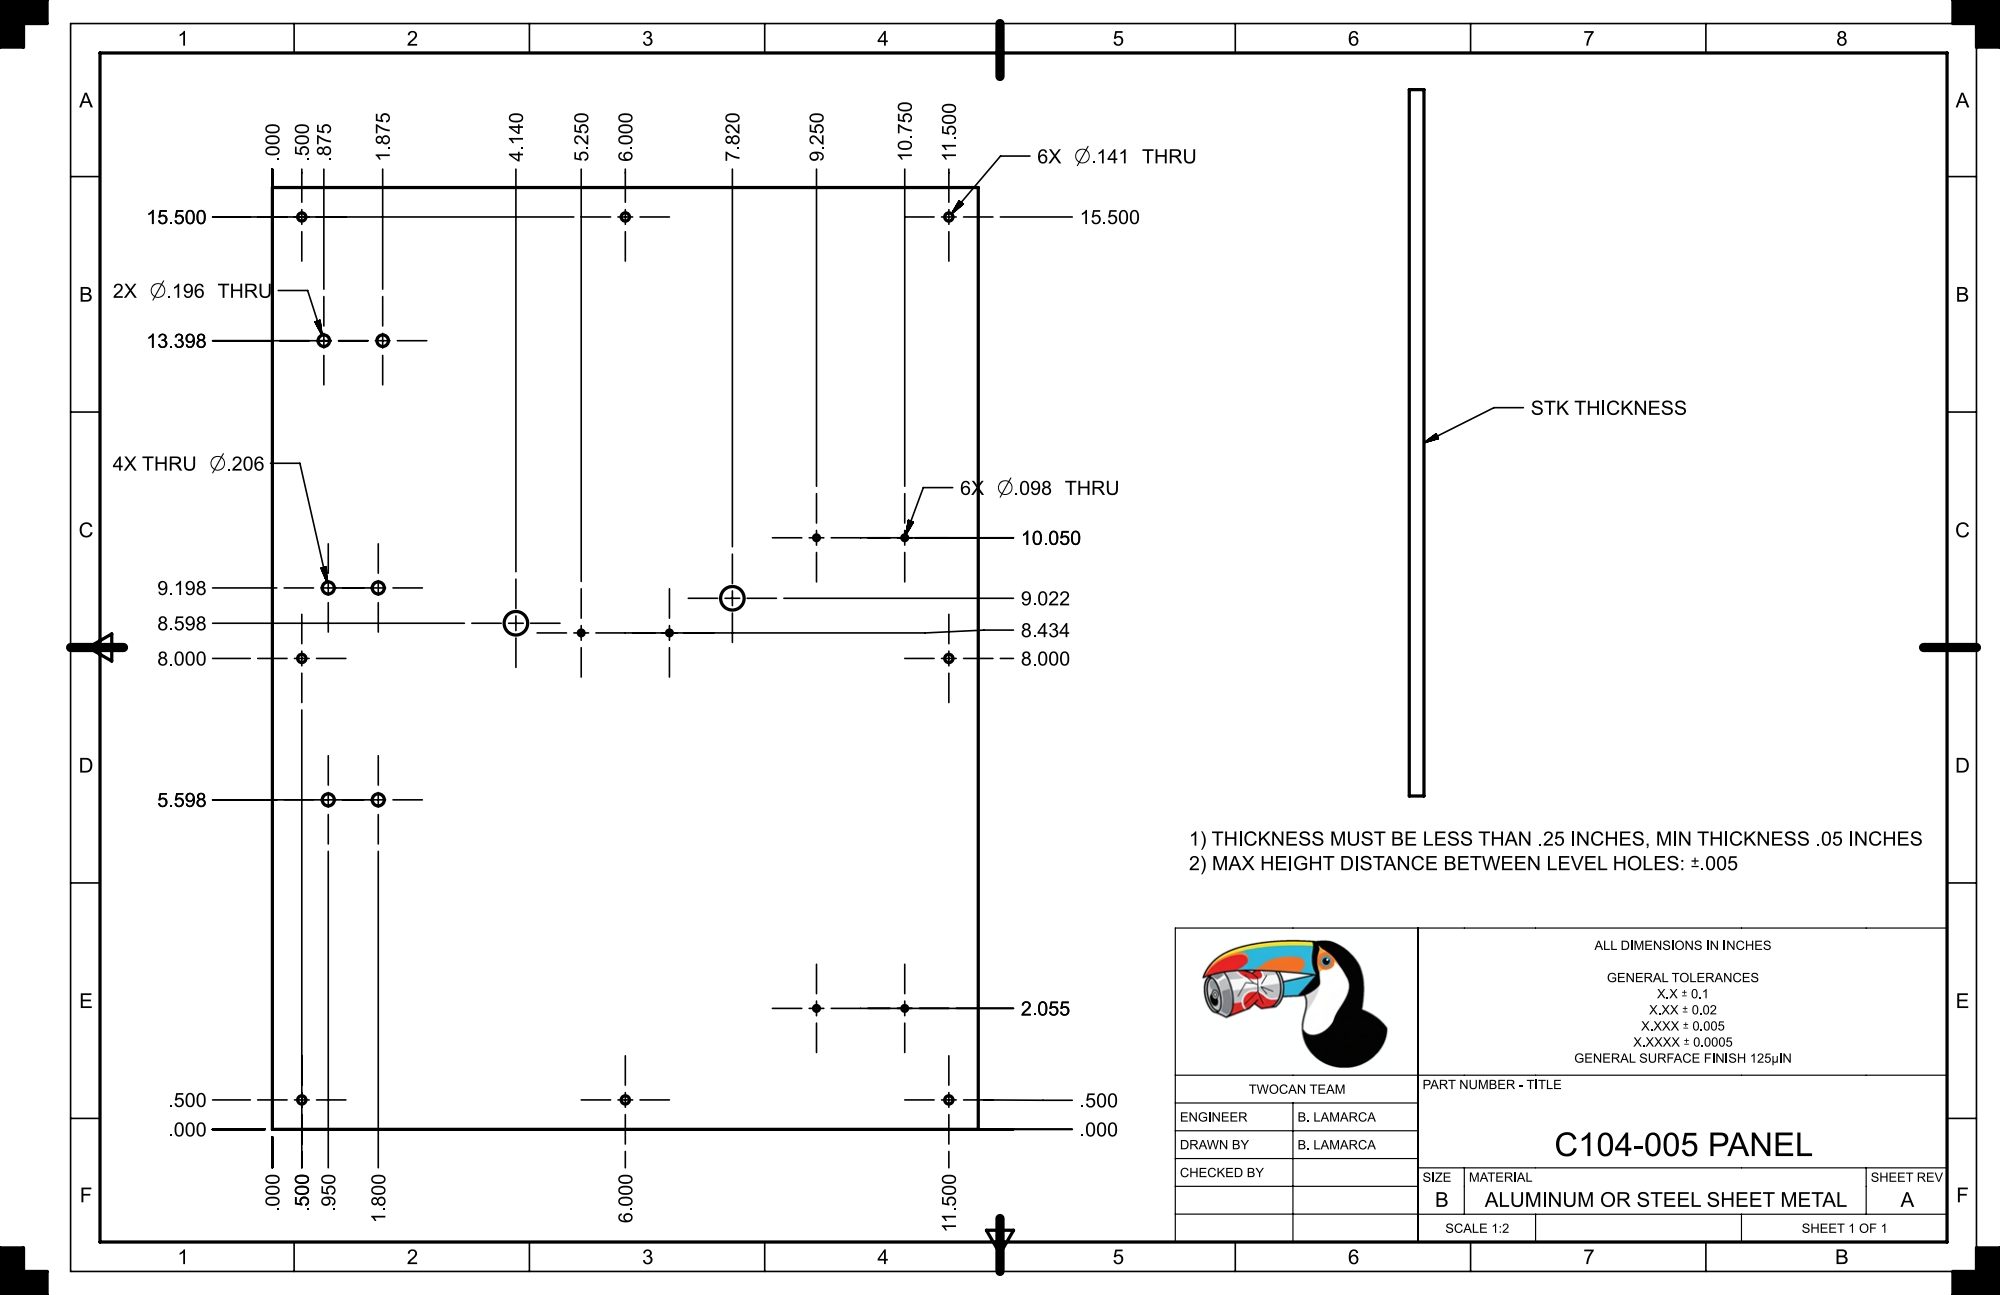
[picture p77: page 1]
