matt-lewton9/ME-463-Can-Crusher/RELEASED DWG/C101-002 HUB.pdf

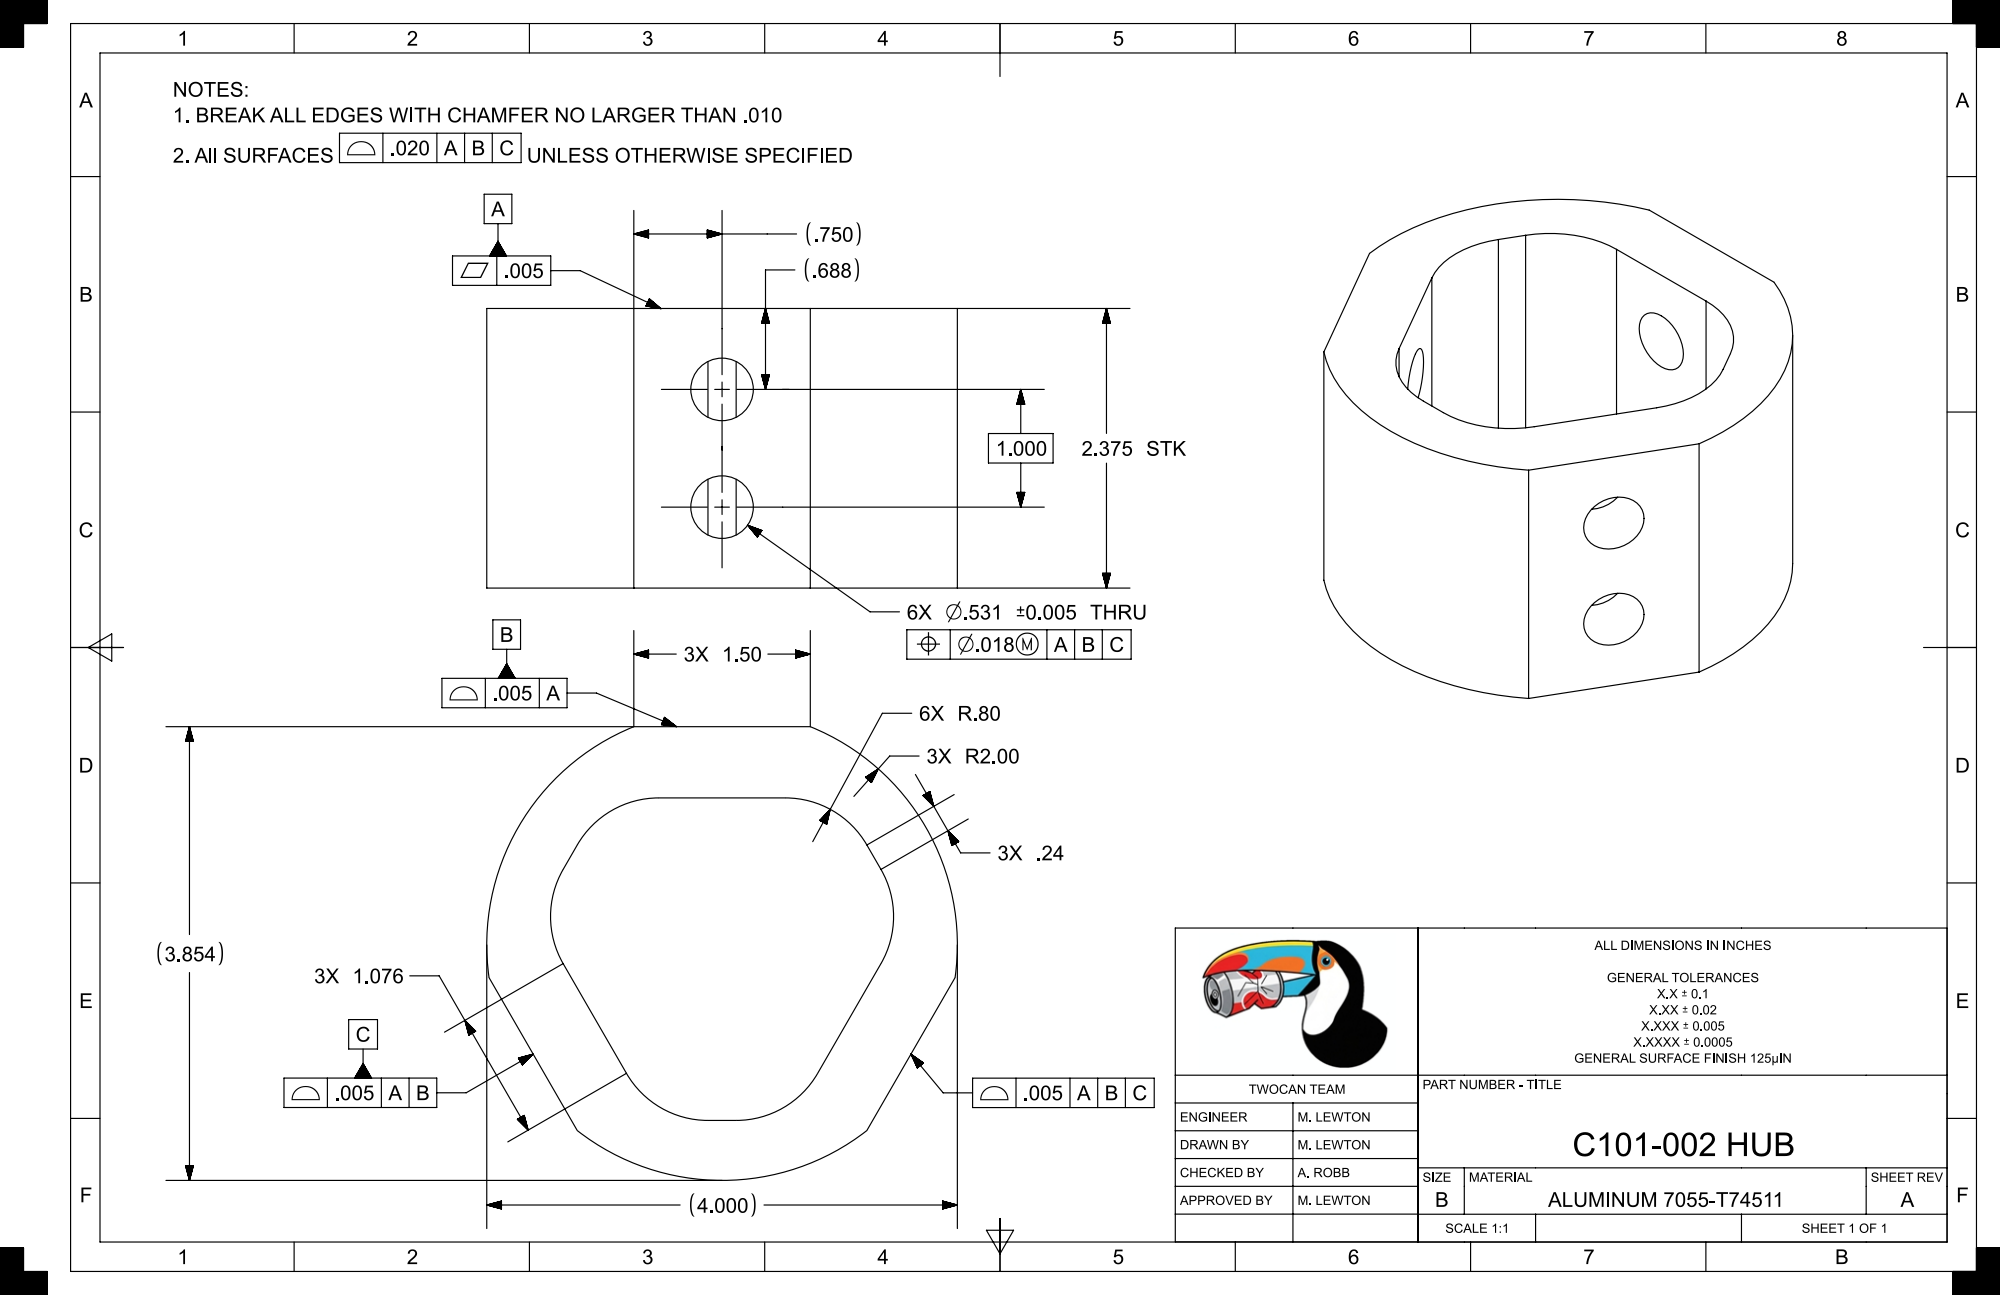
[picture p78: page 1]
