matt-lewton9/ME-463-Can-Crusher/RELEASED DWG/C106-002 PULLEY PLATE.pdf

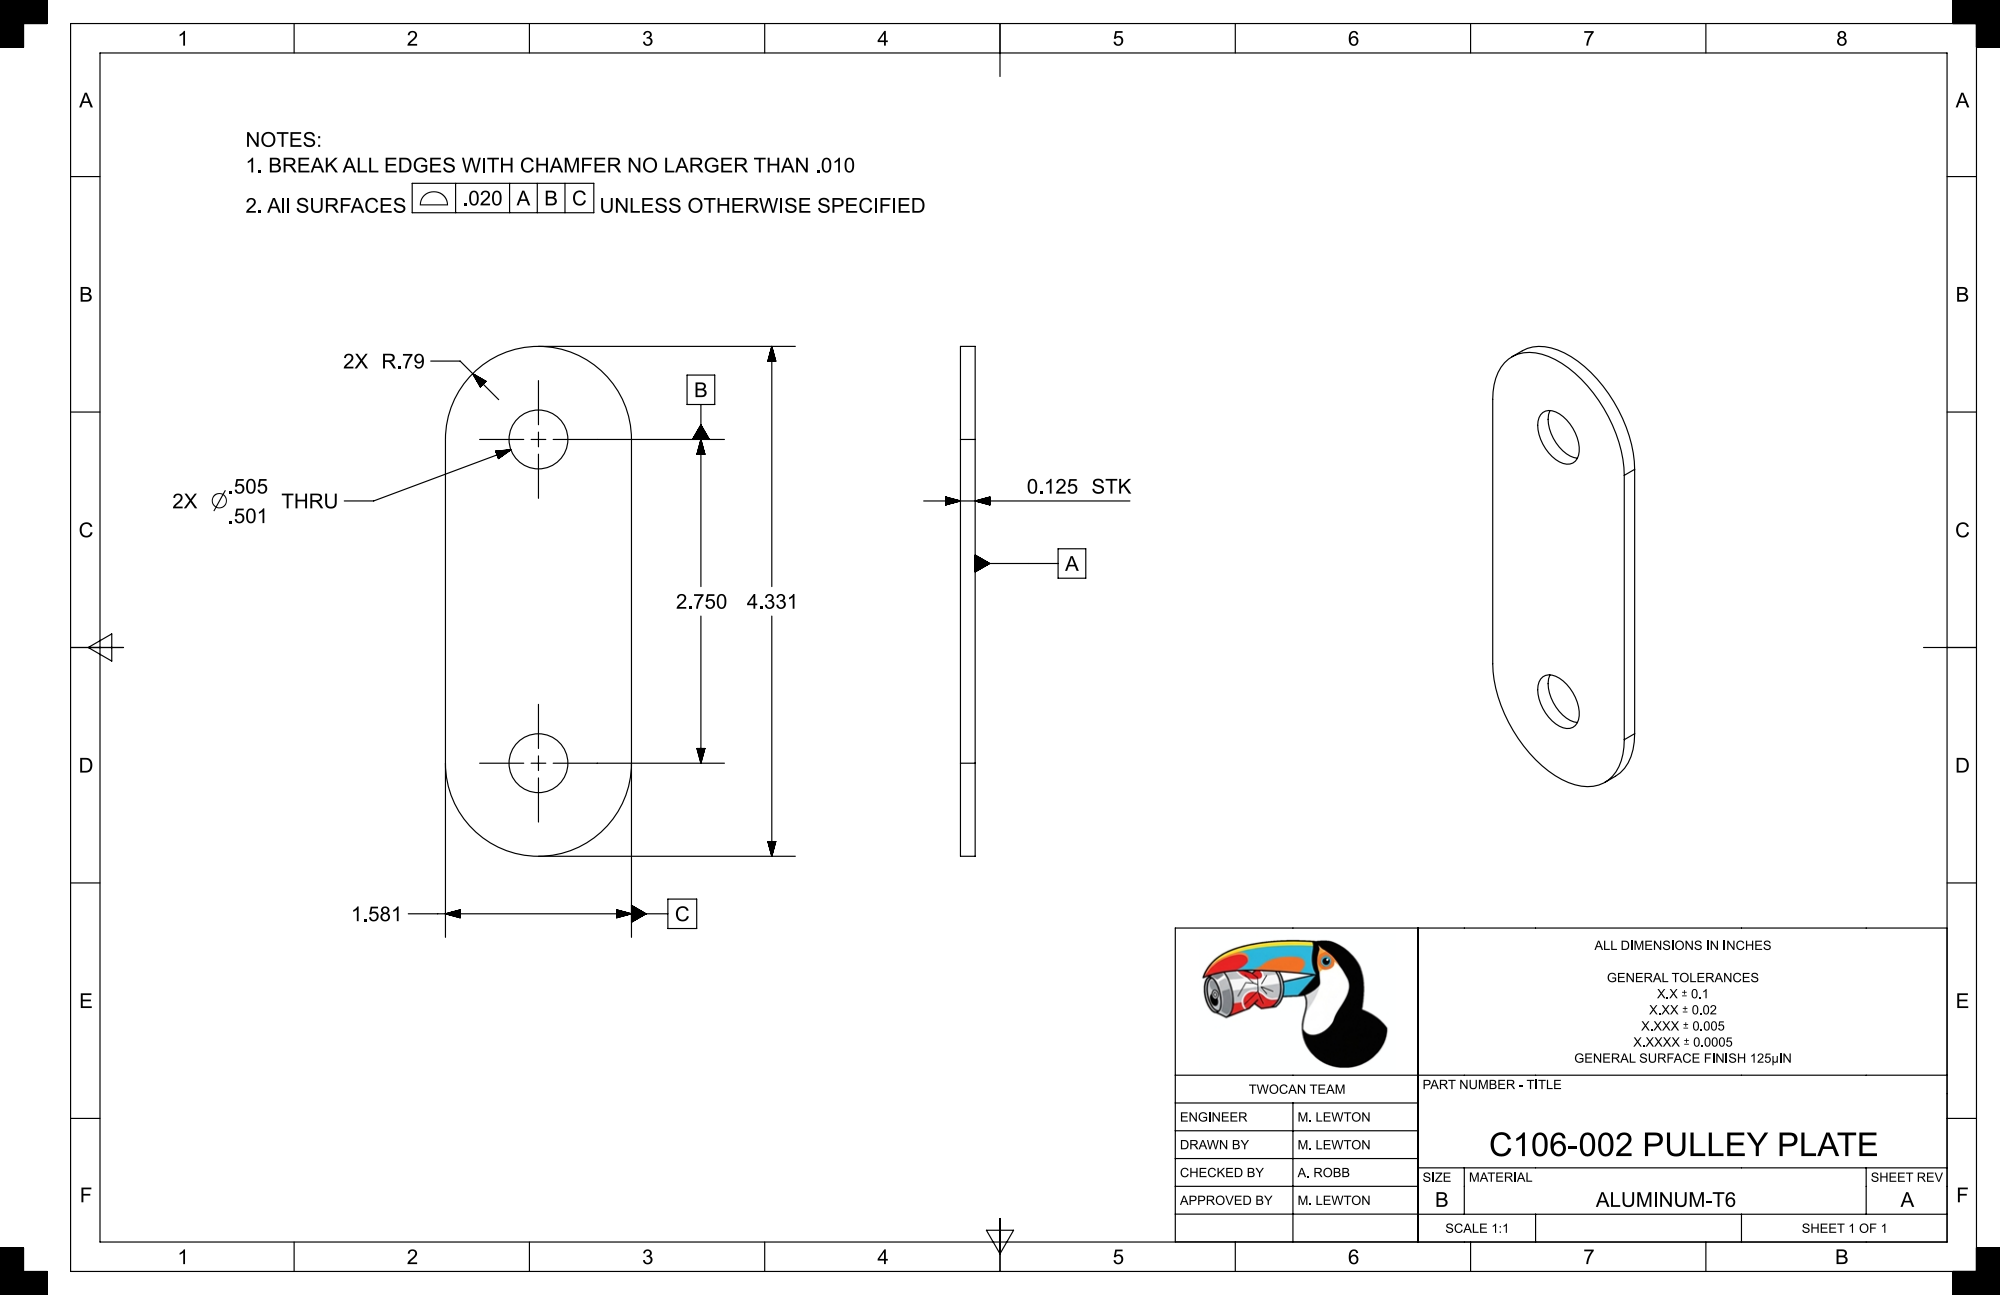
[picture p79: page 1]
