matt-lewton9/ME-463-Can-Crusher/RELEASED DWG/C105-003 CONNECTOR BRACKET.pdf

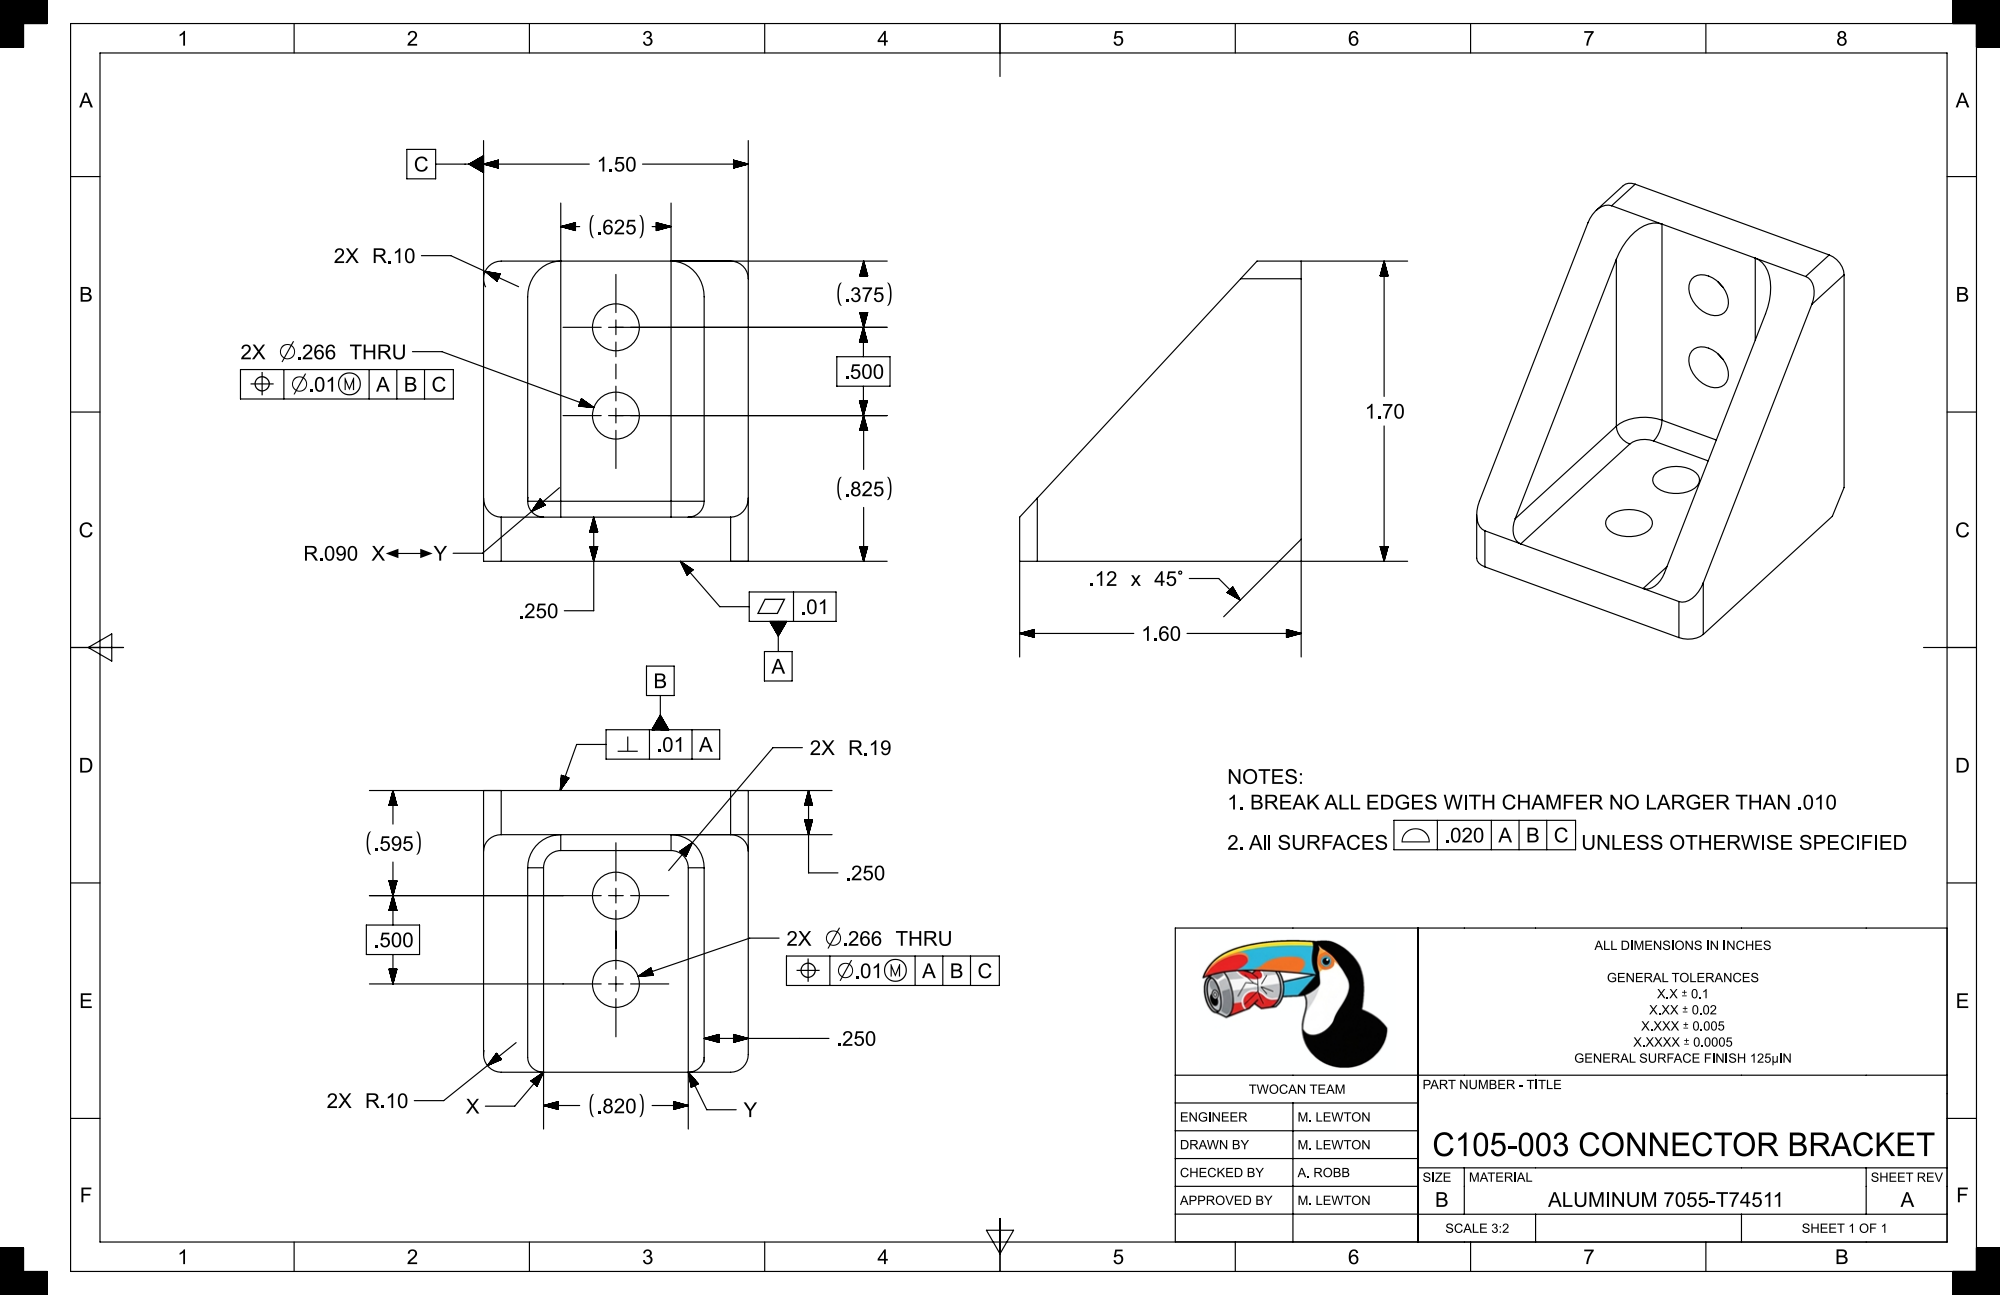
[picture p80: page 1]
