matt-lewton9/ME-463-Can-Crusher/RELEASED DWG/C105-002 CUSTOMER CONNECTOR.pdf

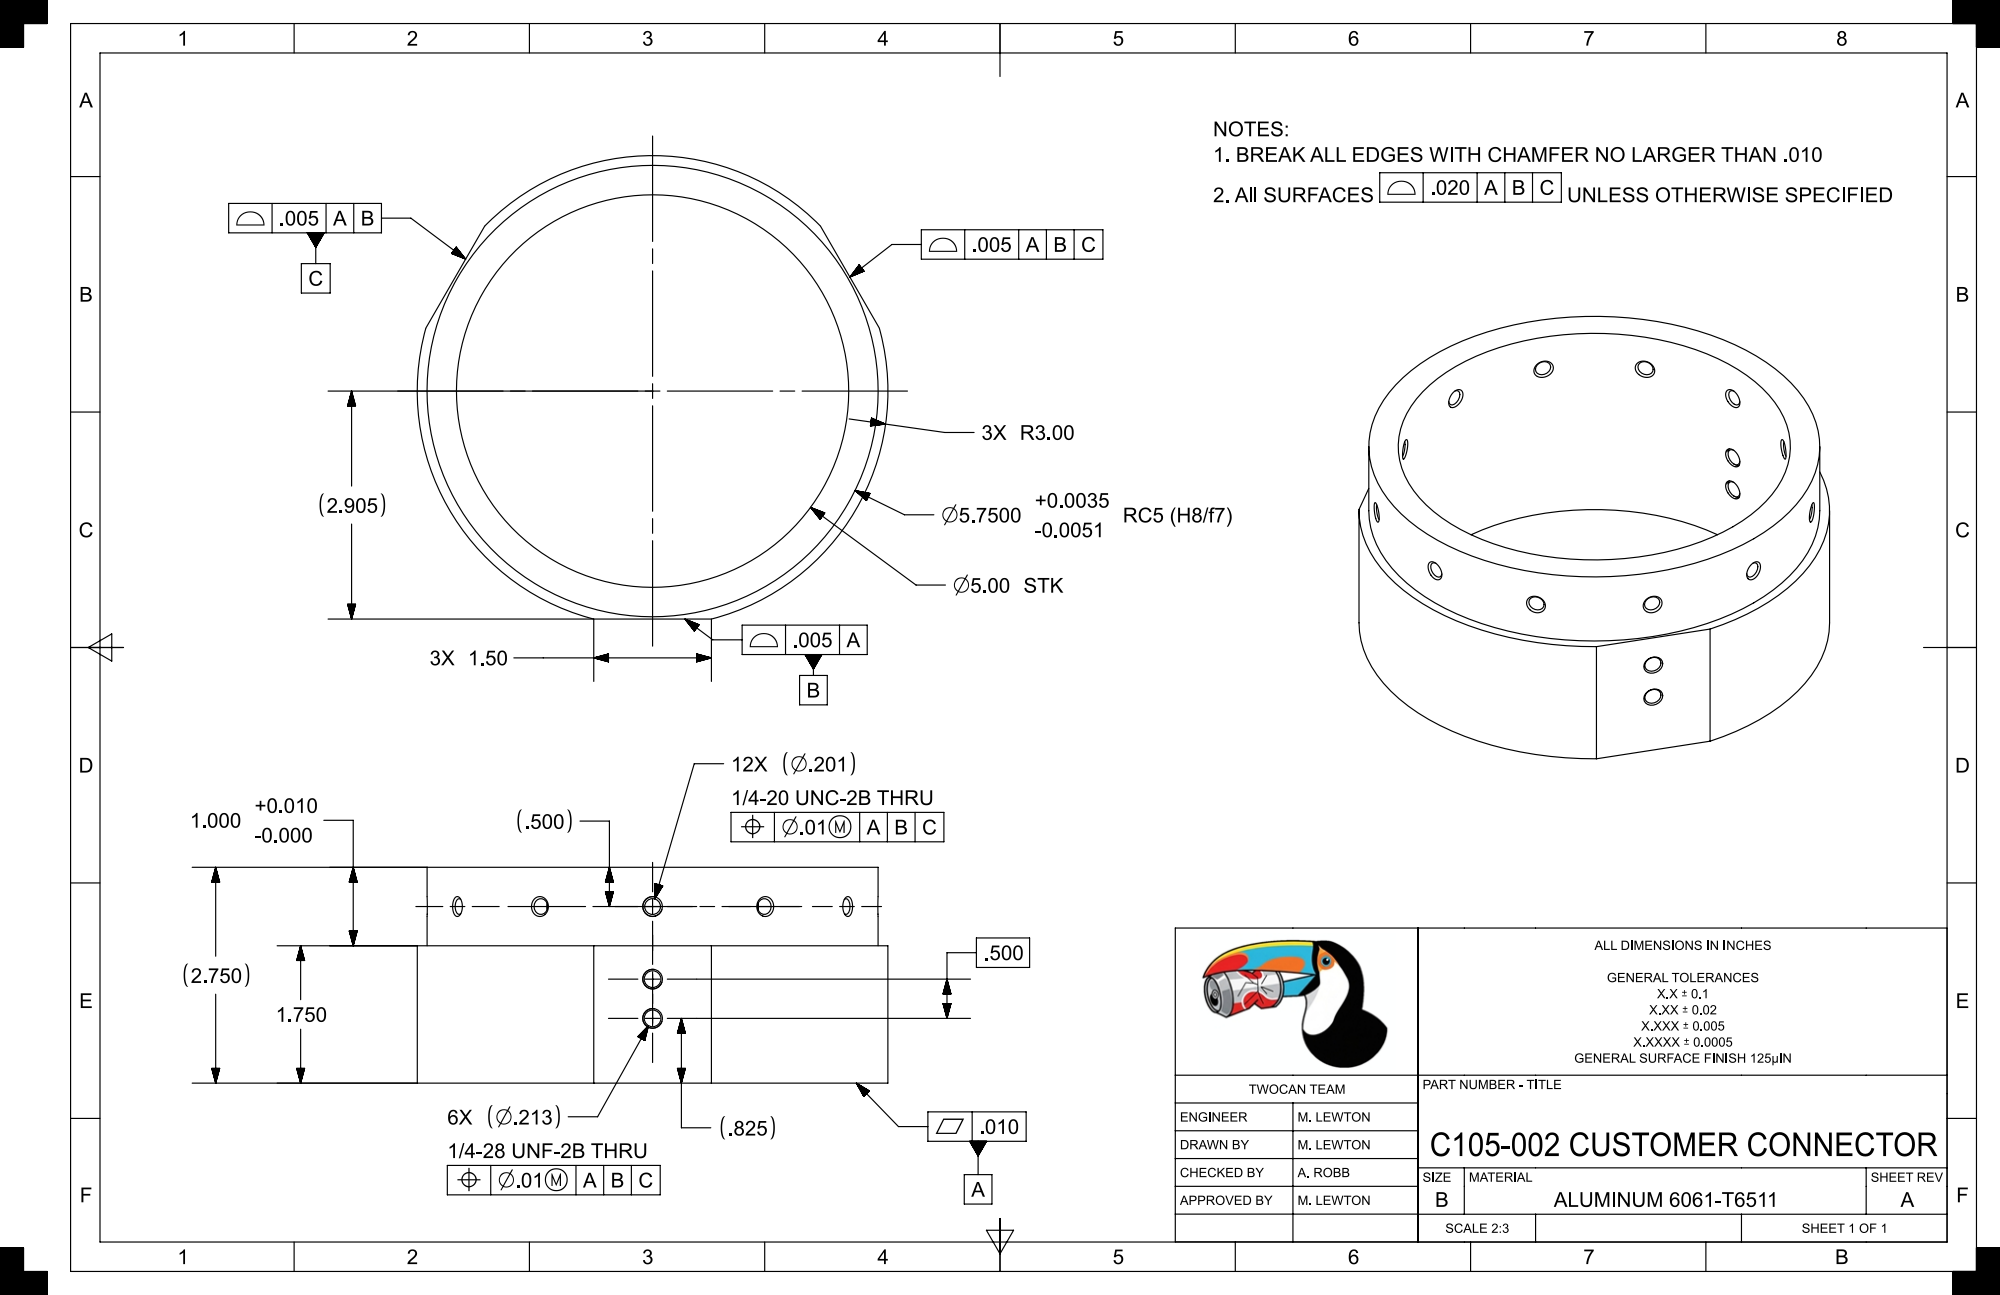
[picture p81: page 1]
