matt-lewton9/ME-463-Can-Crusher/RELEASED DWG/C105-001 CUSTOMER AIRFRAME.pdf

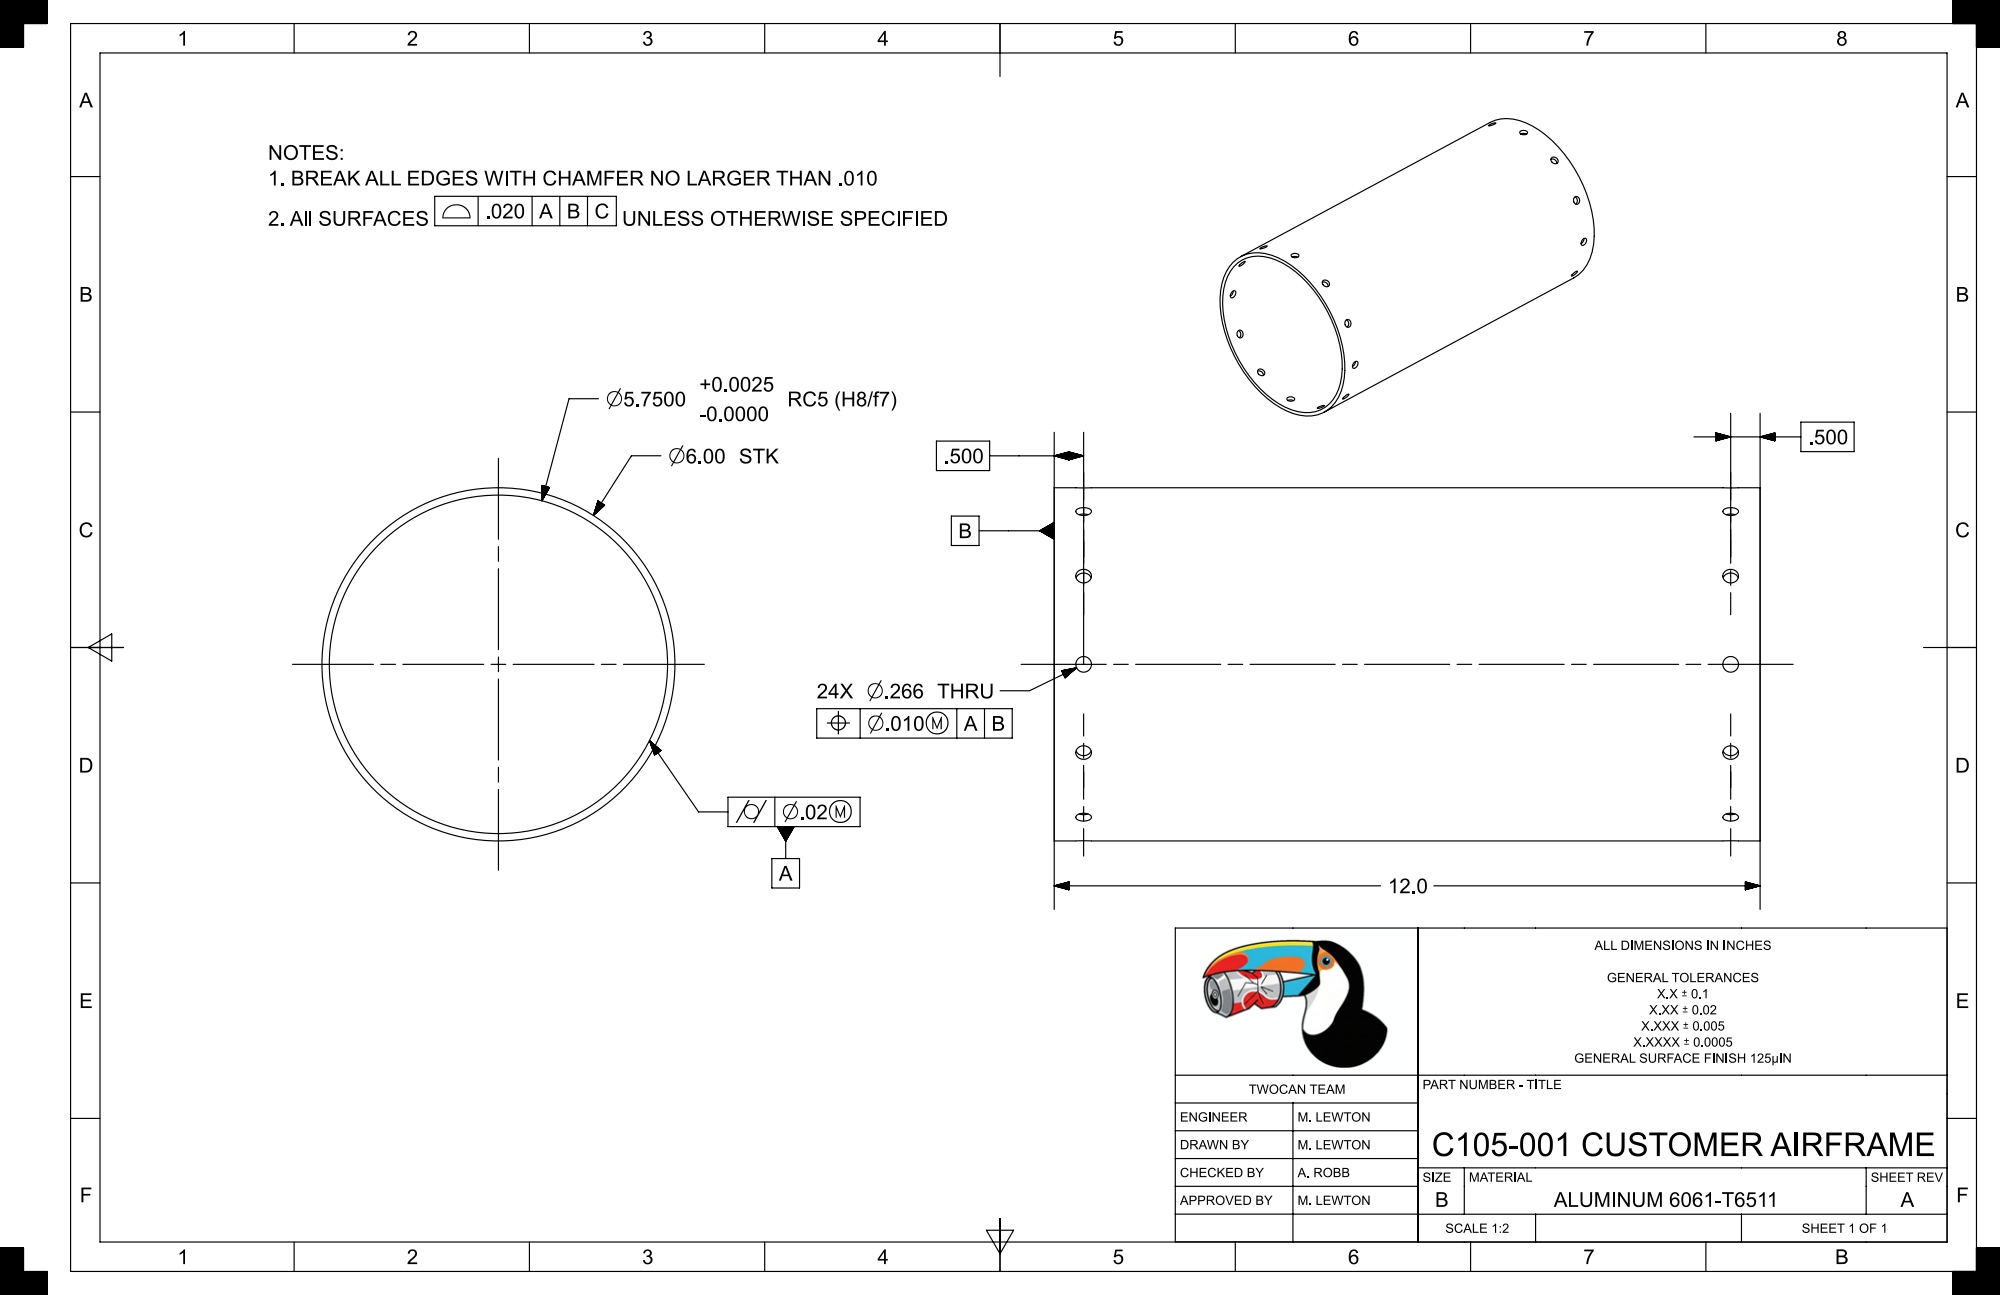
[picture p82: page 1]
