matt-lewton9/ME-463-Can-Crusher/RELEASED DWG/C102-001 TOP STRUT.pdf

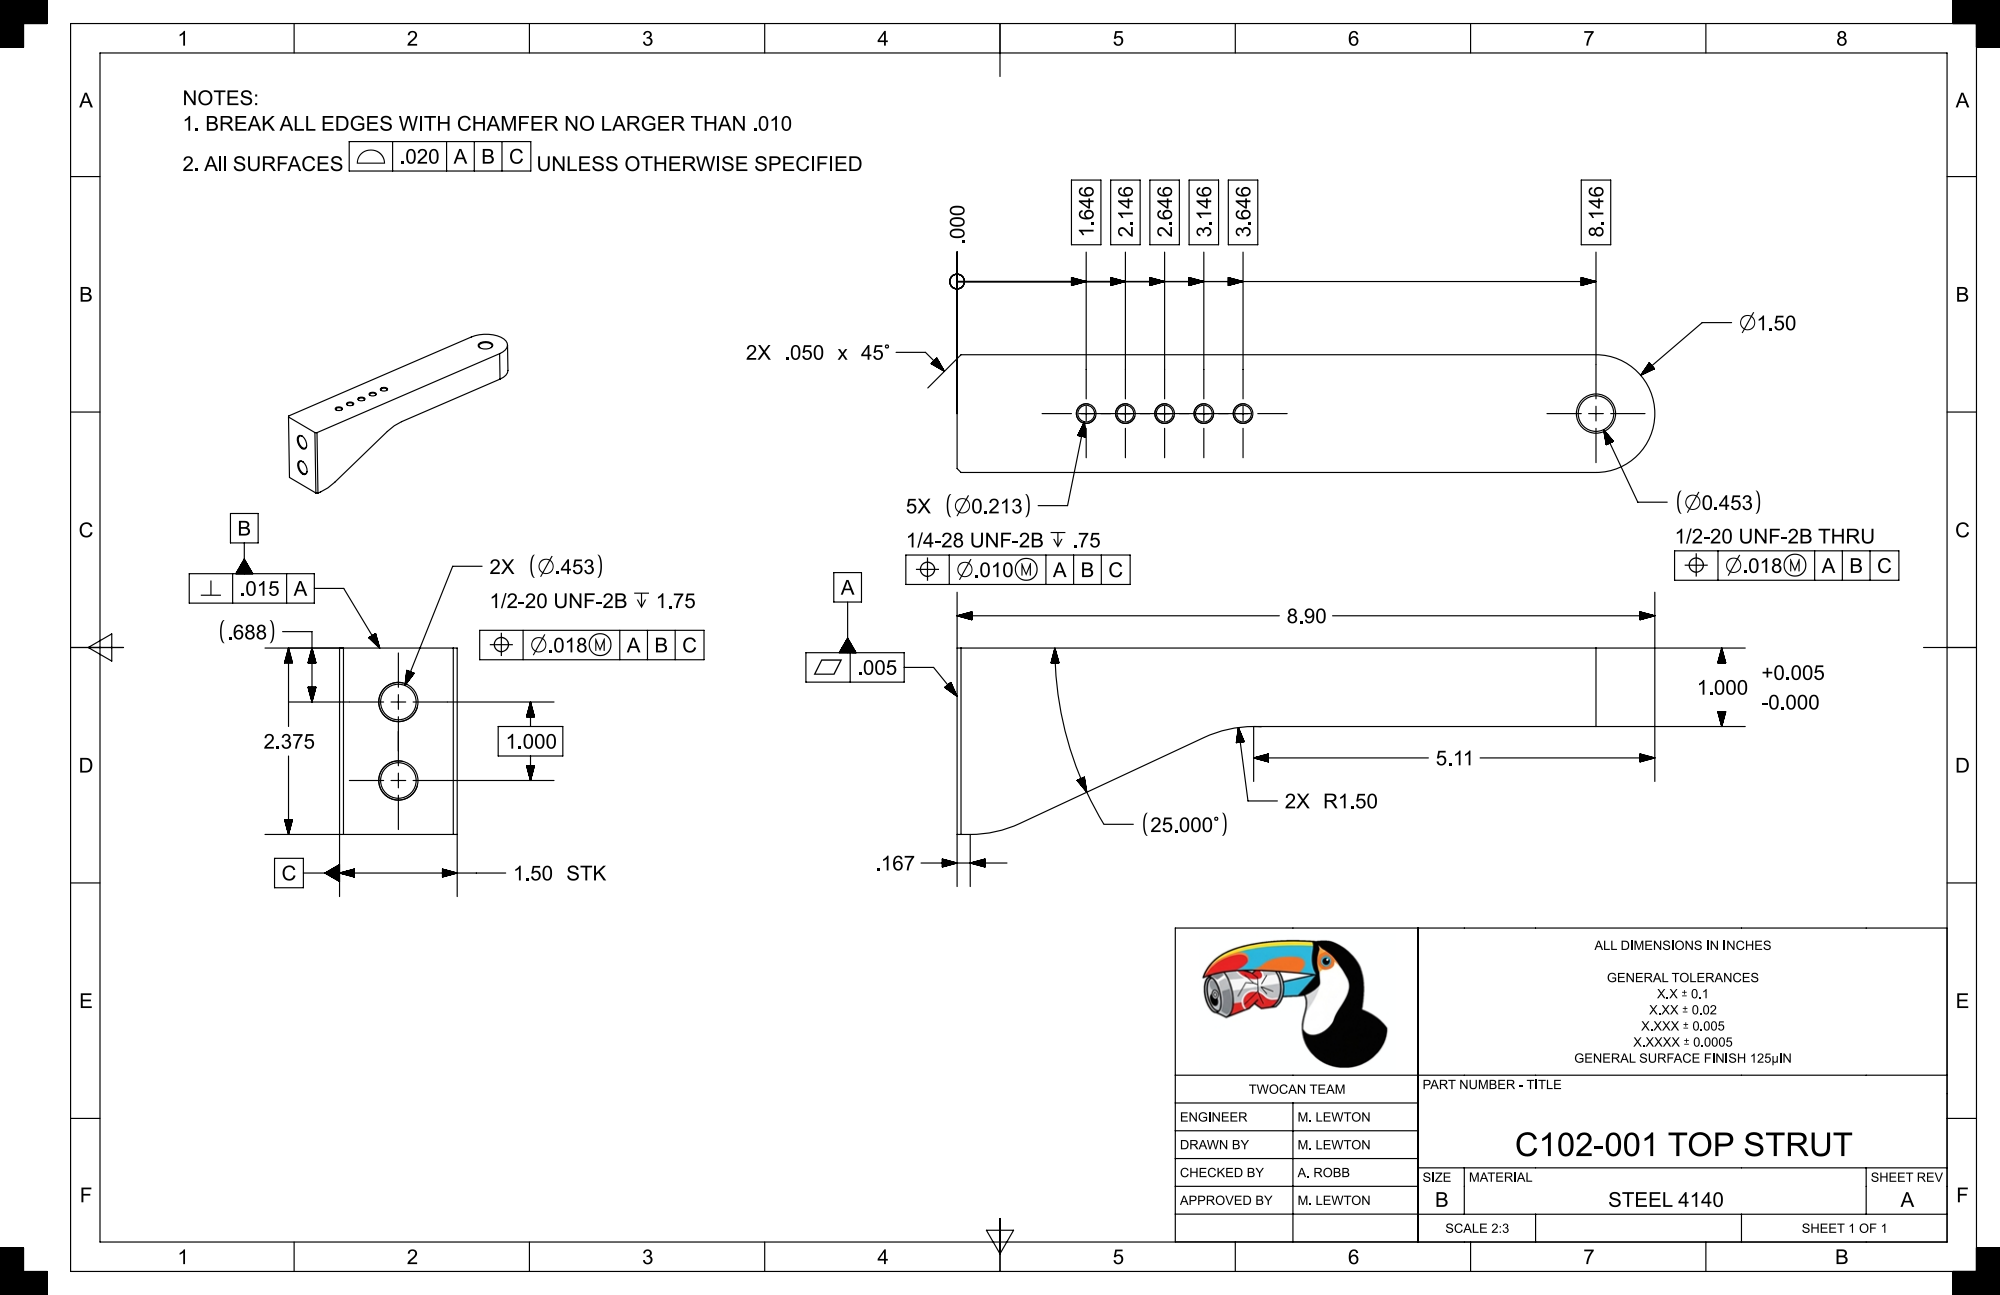
[picture p83: page 1]
