matt-lewton9/ME-463-Can-Crusher/RELEASED DWG/C101-001 STRUT.pdf

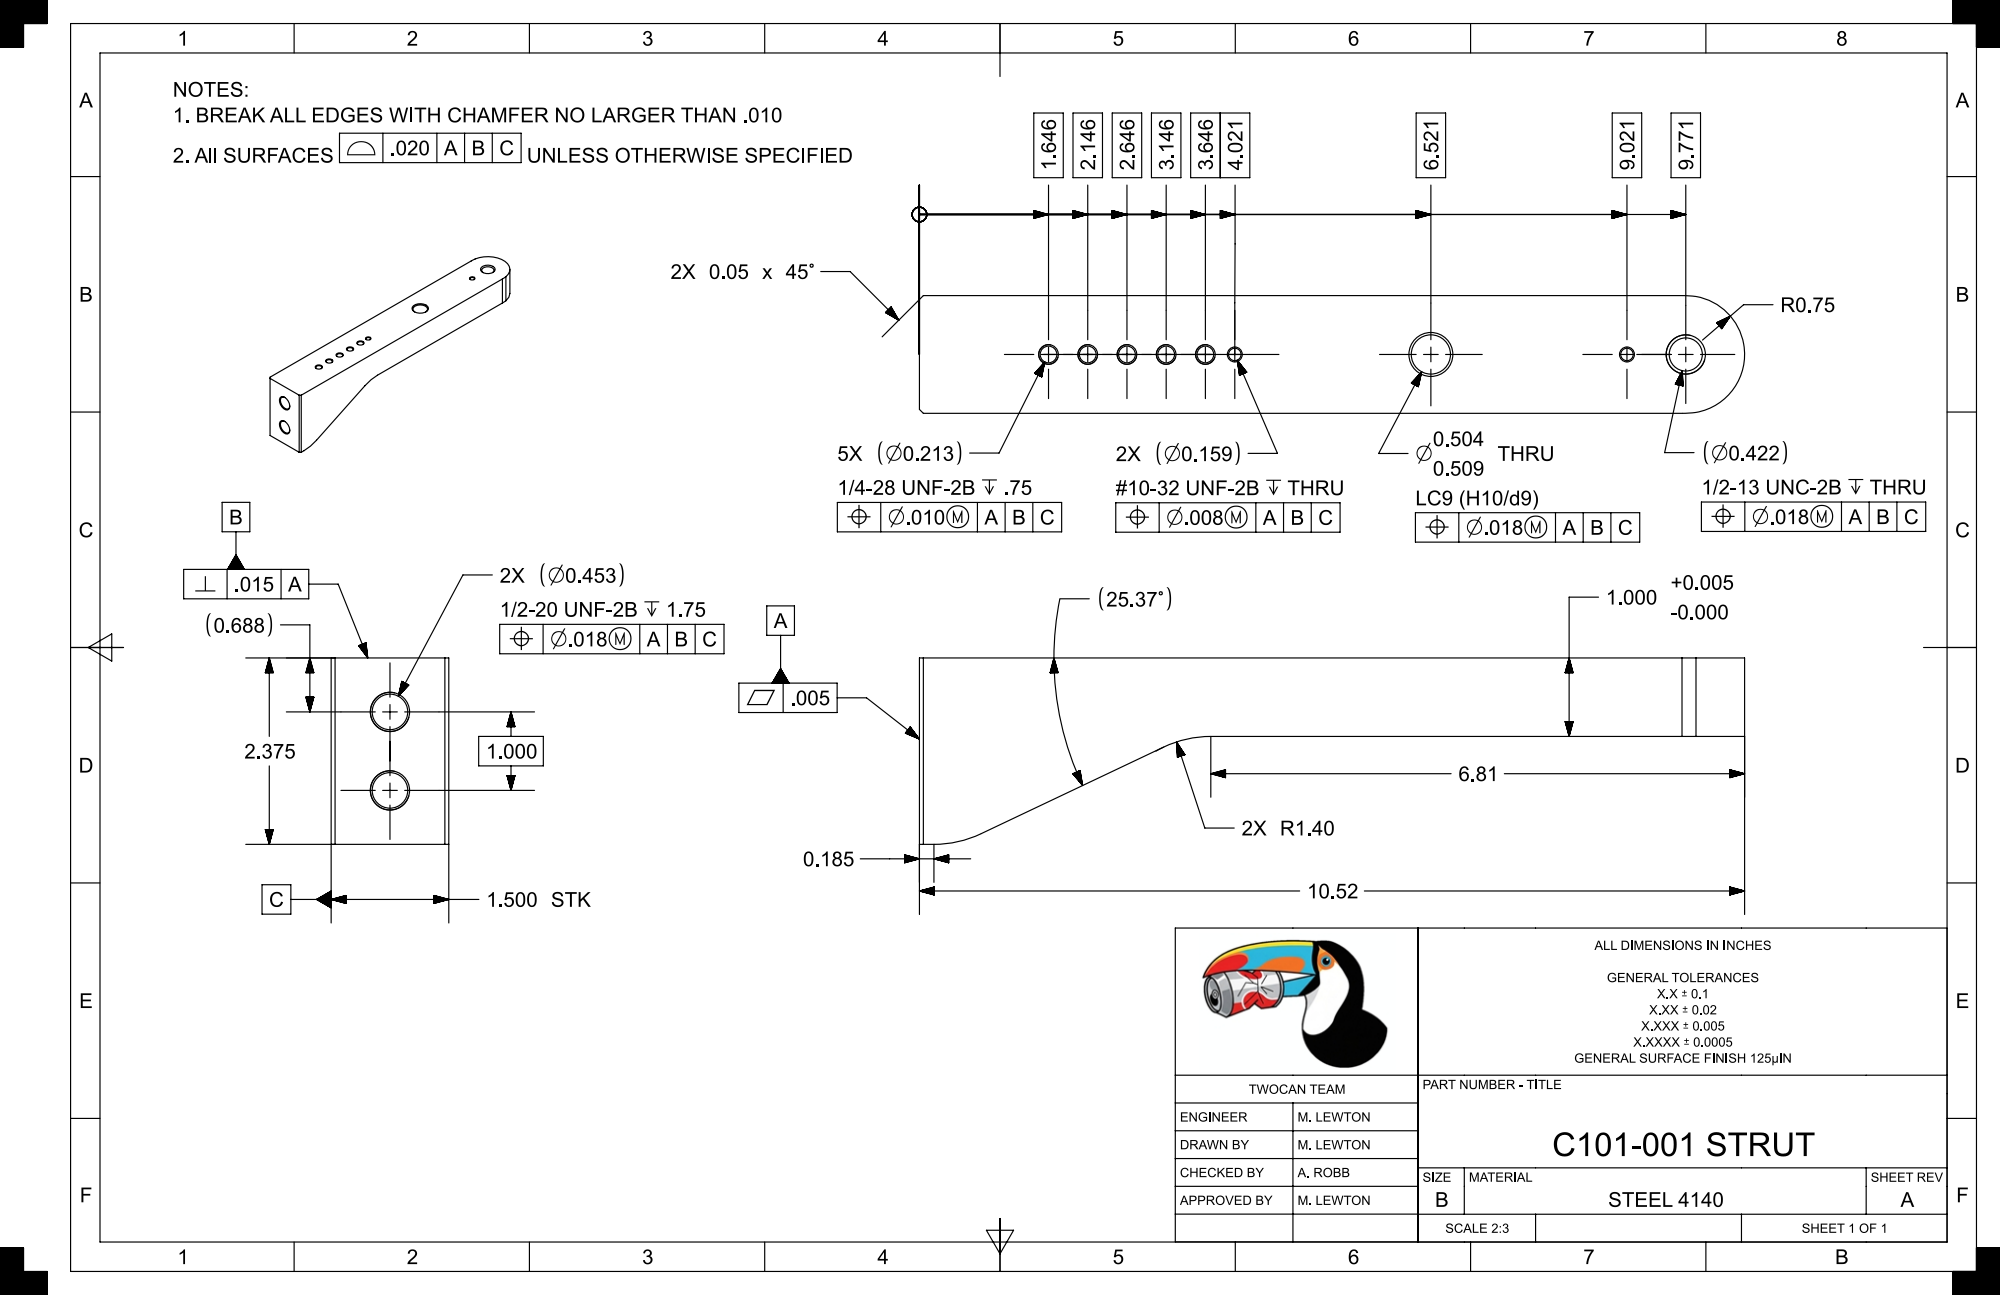
[picture p84: page 1]
