matt-lewton9/ME-463-Can-Crusher/PRE-RELEASE DWG/C103-005 CYLINDER SHAFT_dwg_PRE-RELEASE.pdf

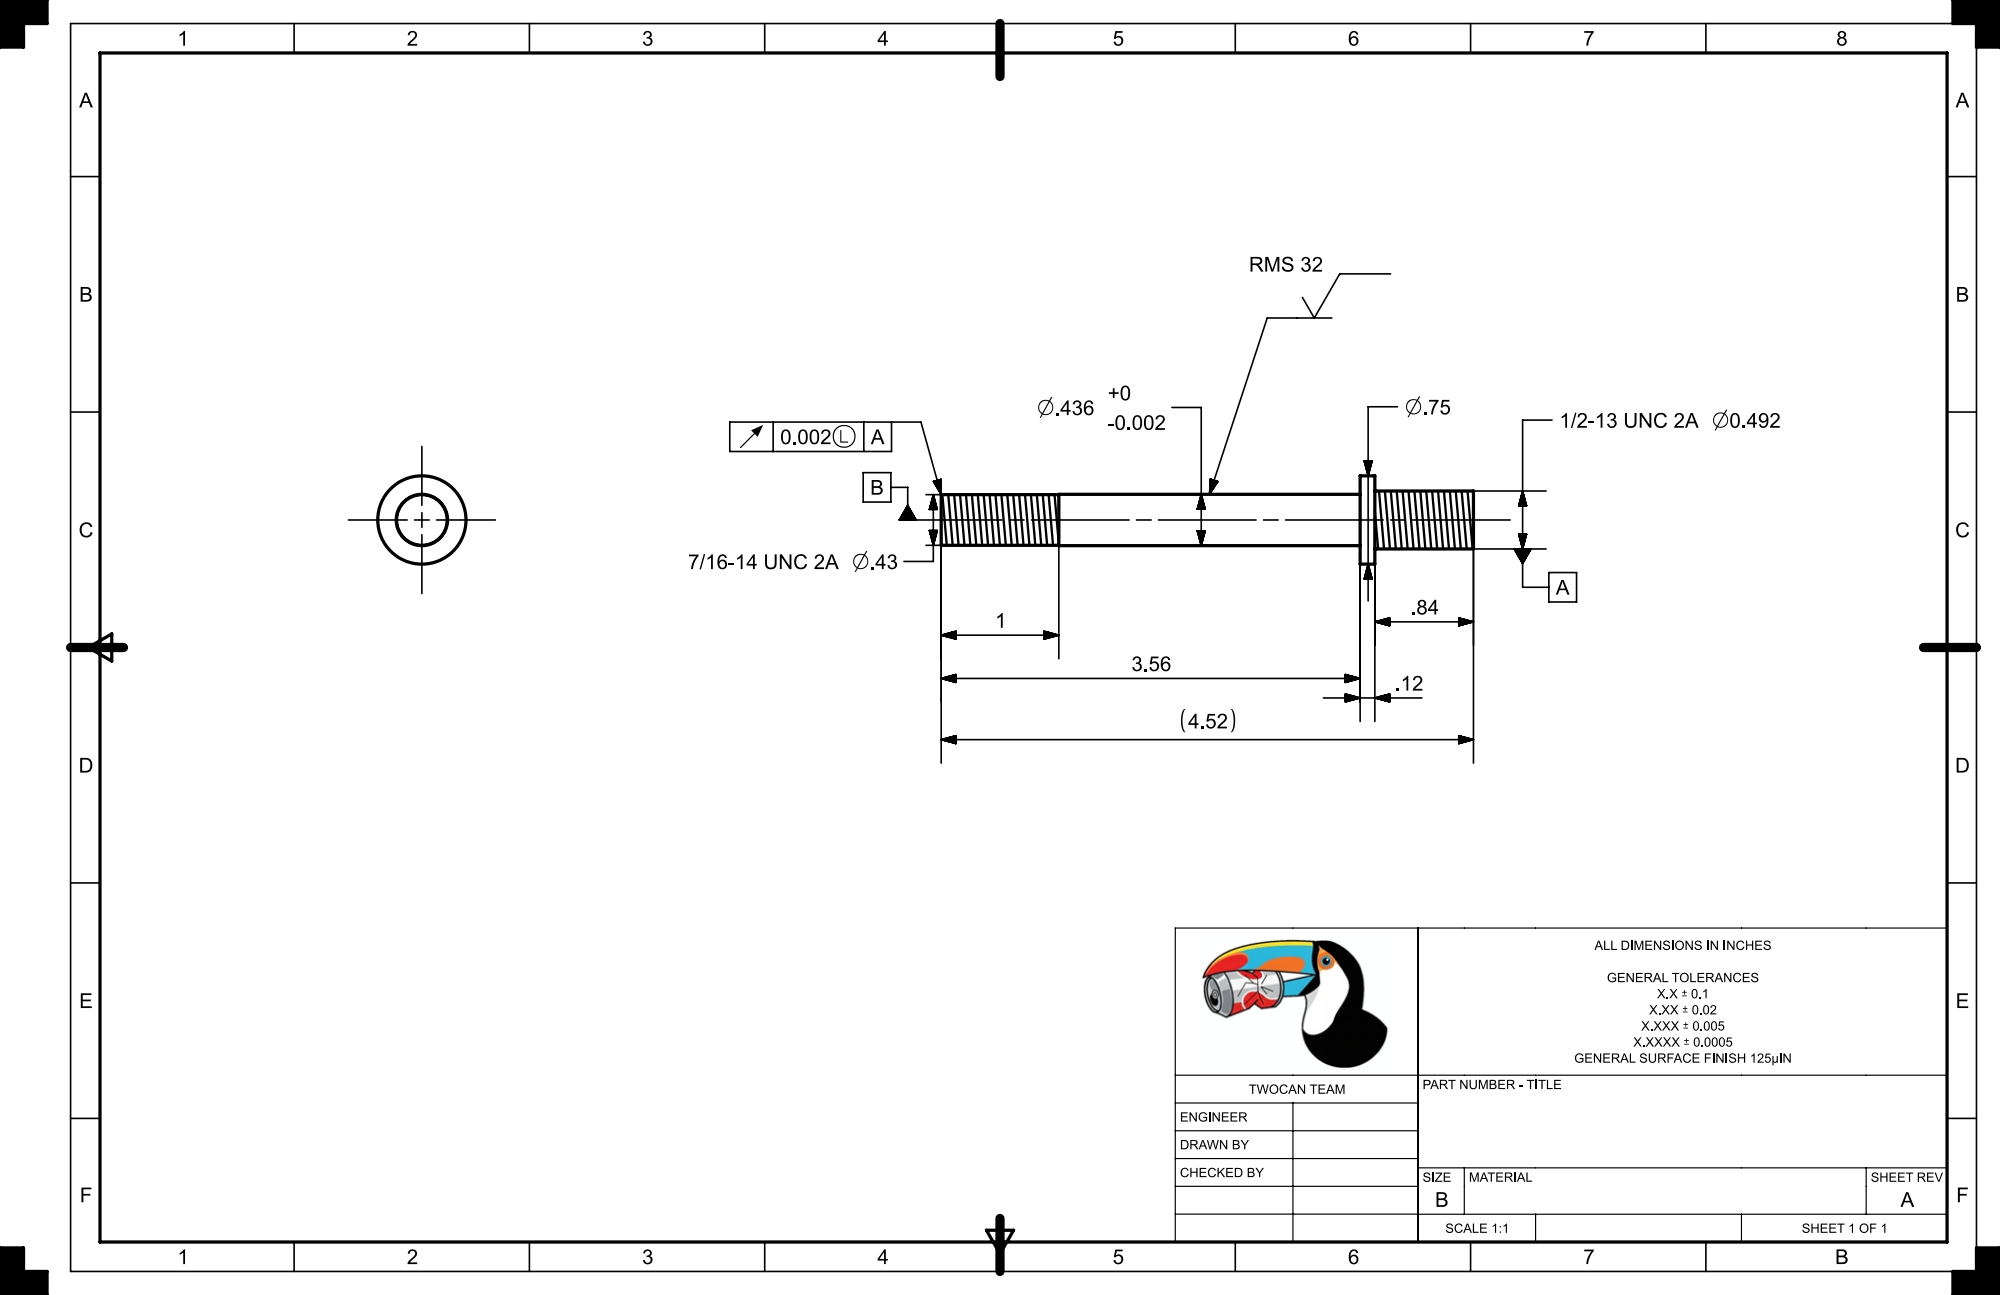
[picture p85: page 1]
