matt-lewton9/ME-463-Can-Crusher/PRE-RELEASE DWG/C103-001 CYLINDER TOP CAP.pdf

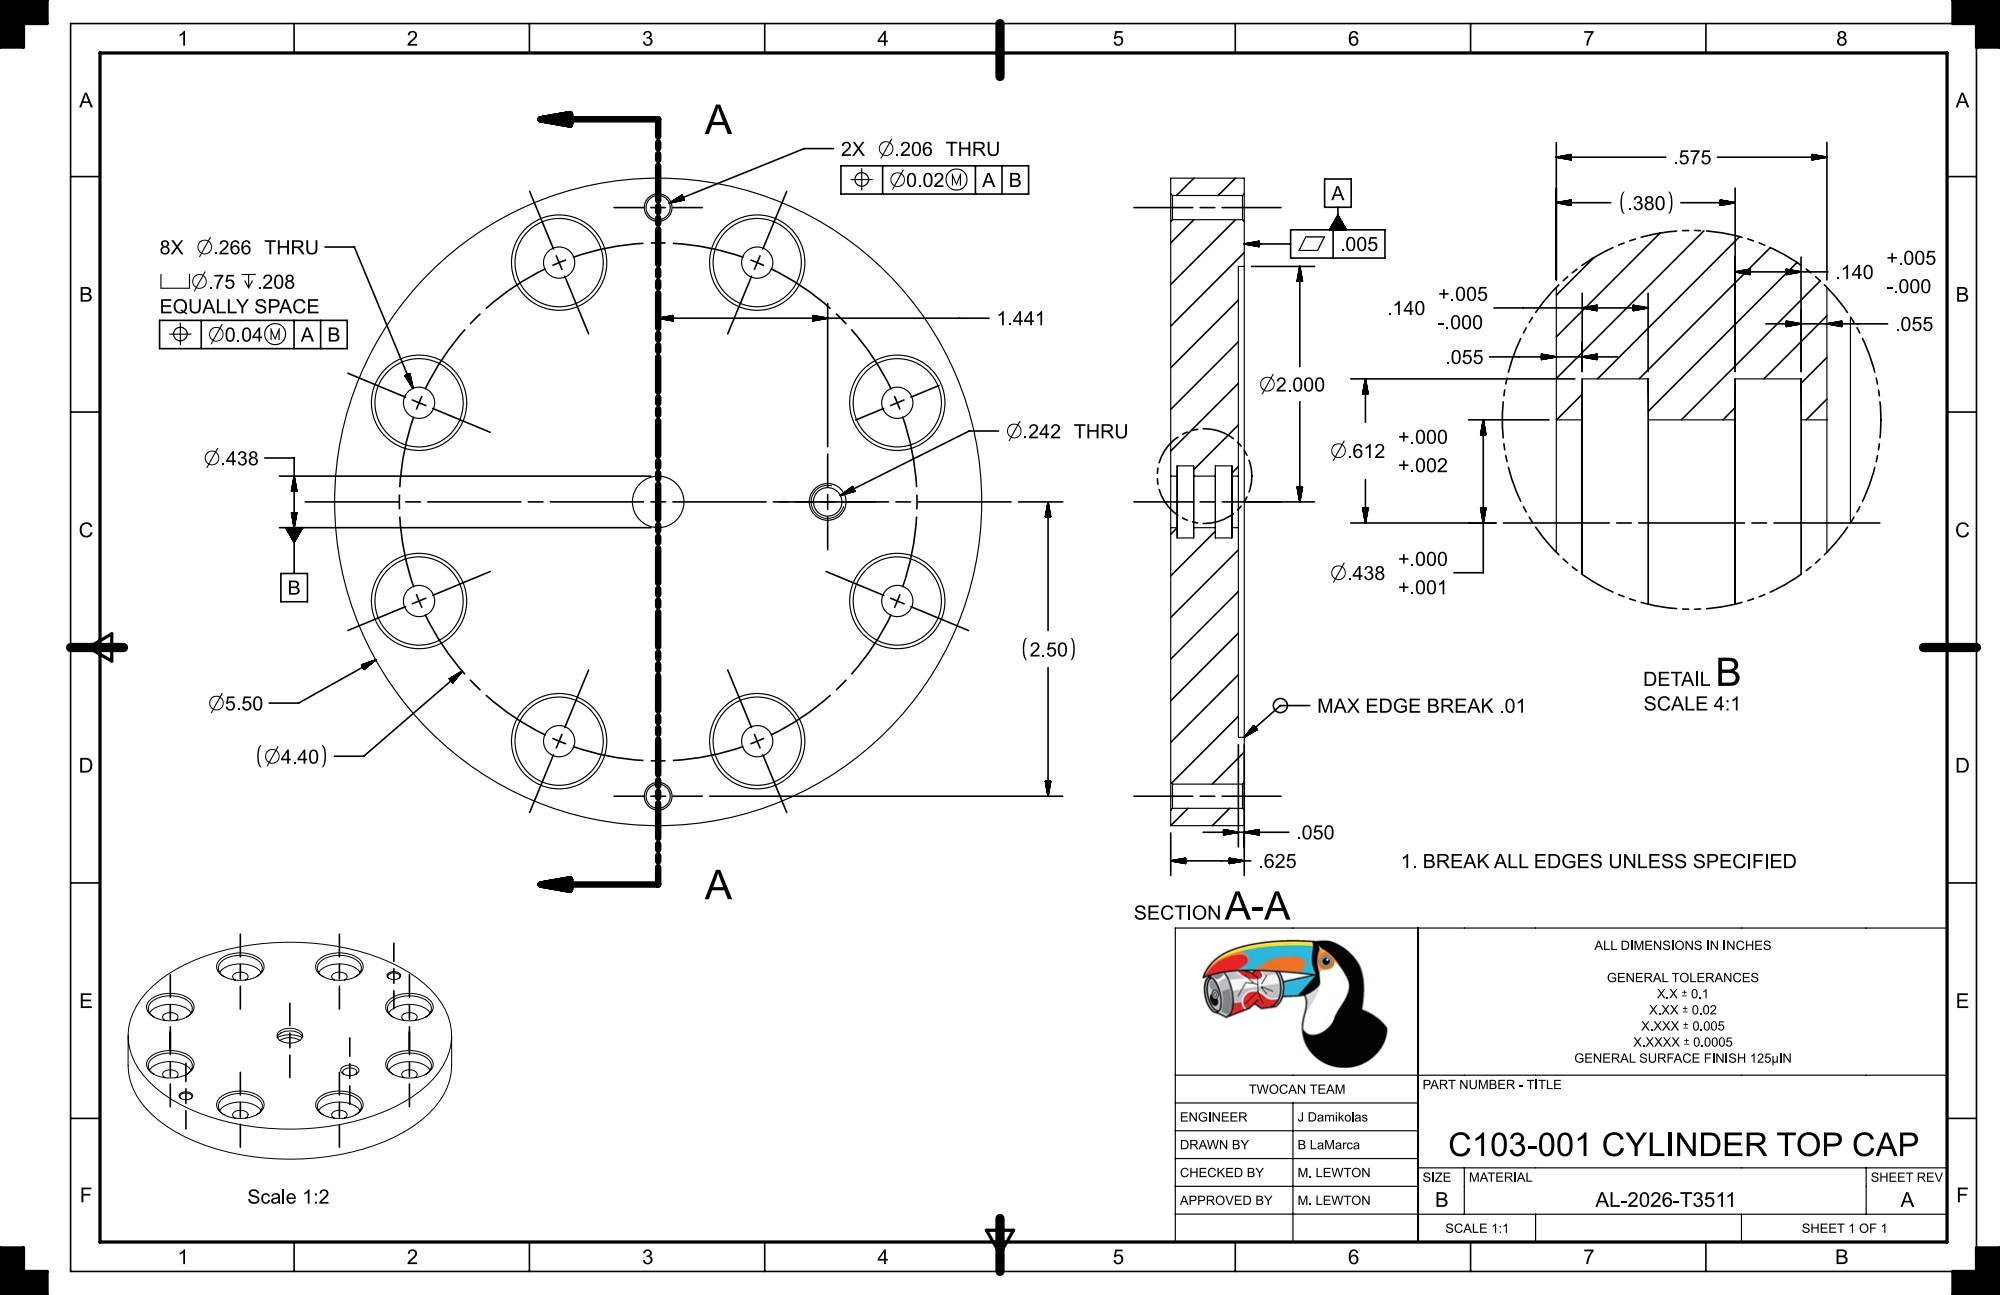
[picture p86: page 1]
