matt-lewton9/ME-463-Can-Crusher/PRE-RELEASE DWG/C101-001 STRUT_dwg1_PRE-RELEASE.pdf

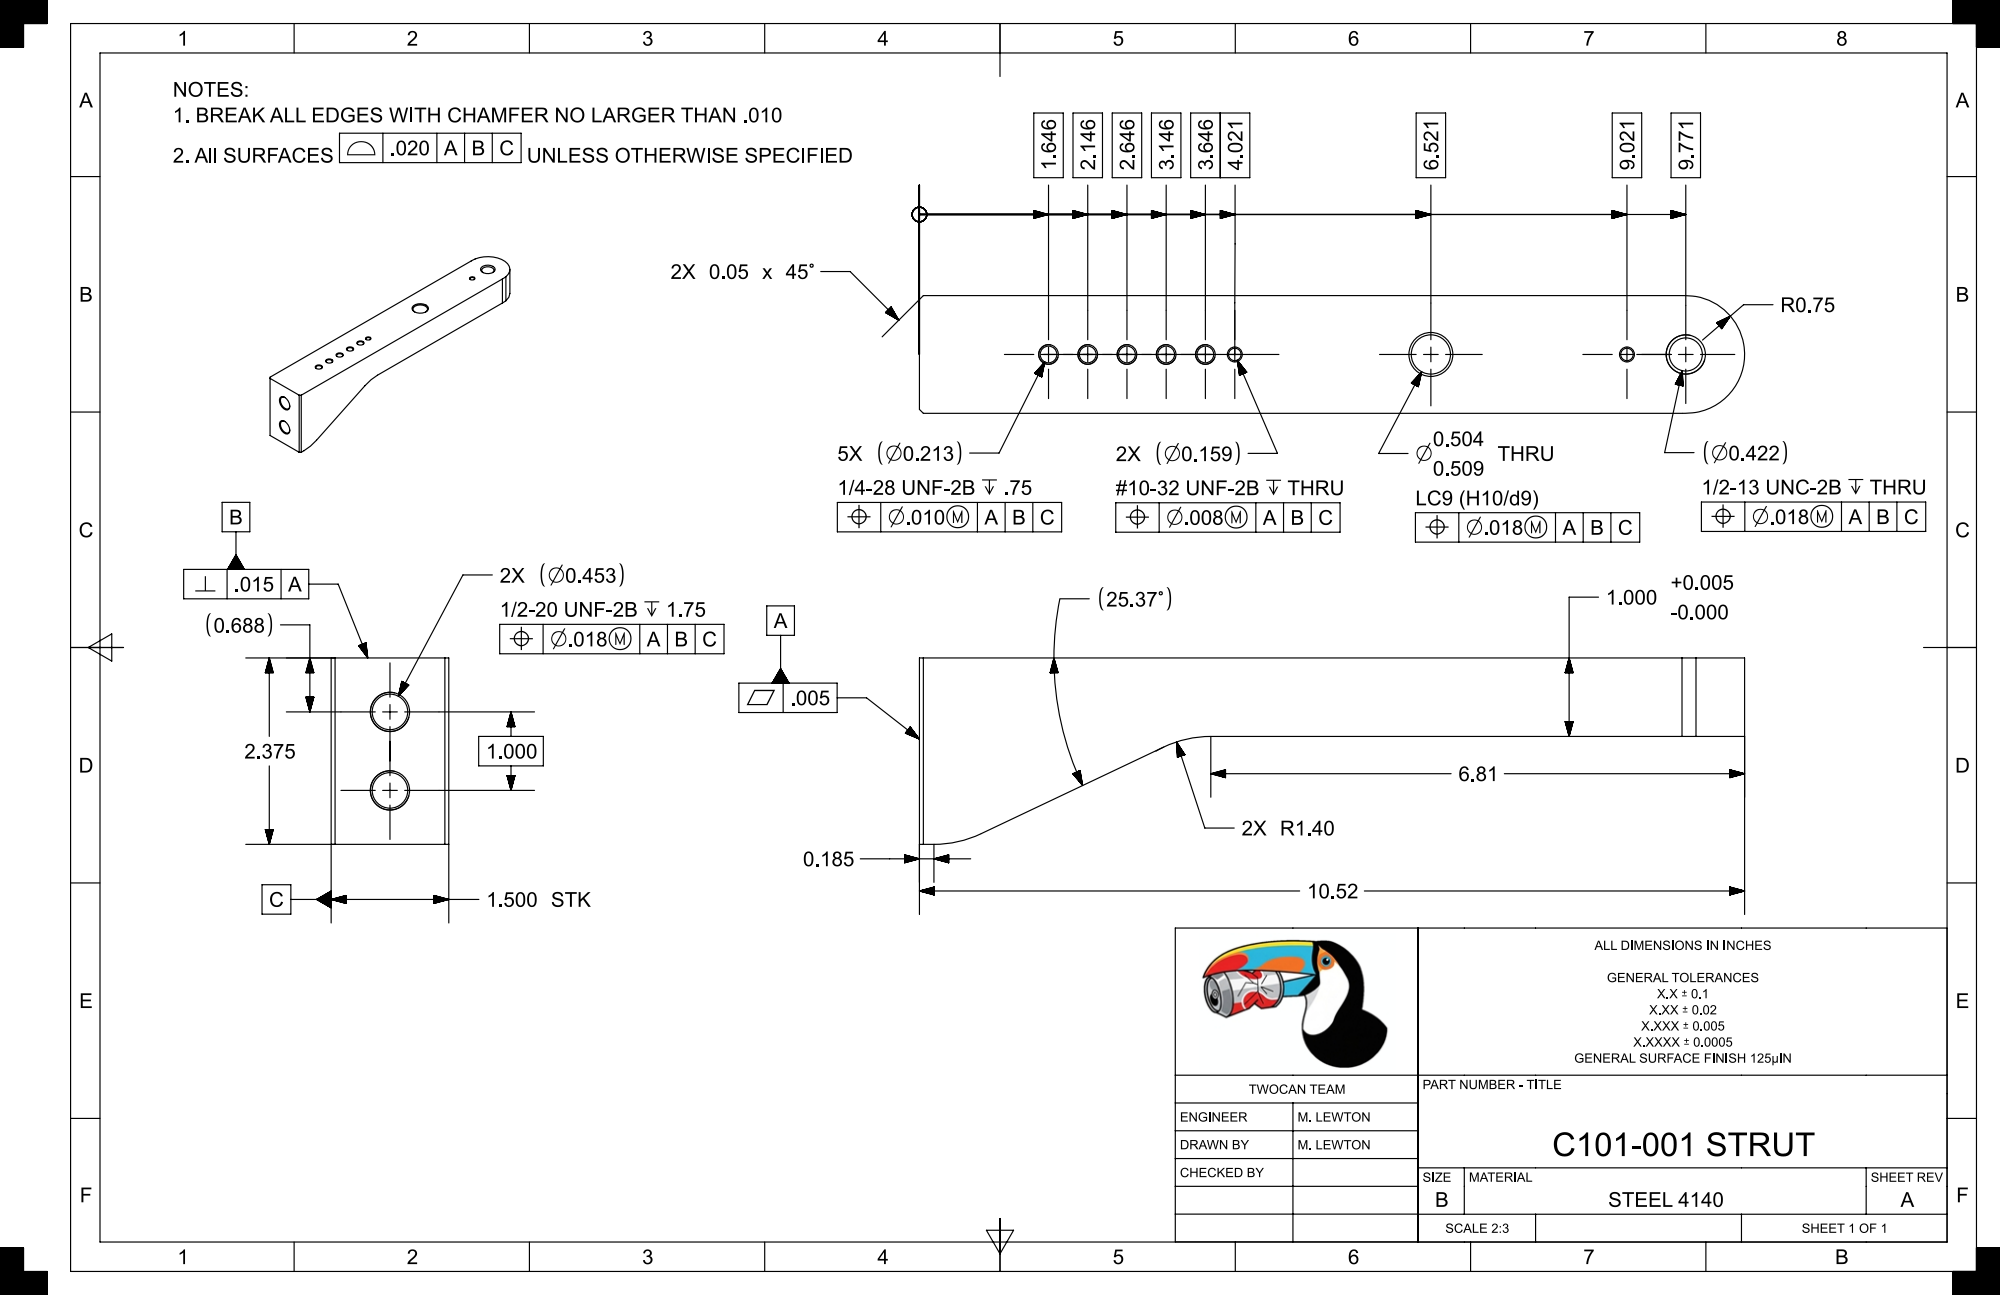
[picture p87: page 1]
