matt-lewton9/ME-463-Can-Crusher/PRE-RELEASE DWG/C101-002 HUB_dwg1_PRE-RELEASE.pdf

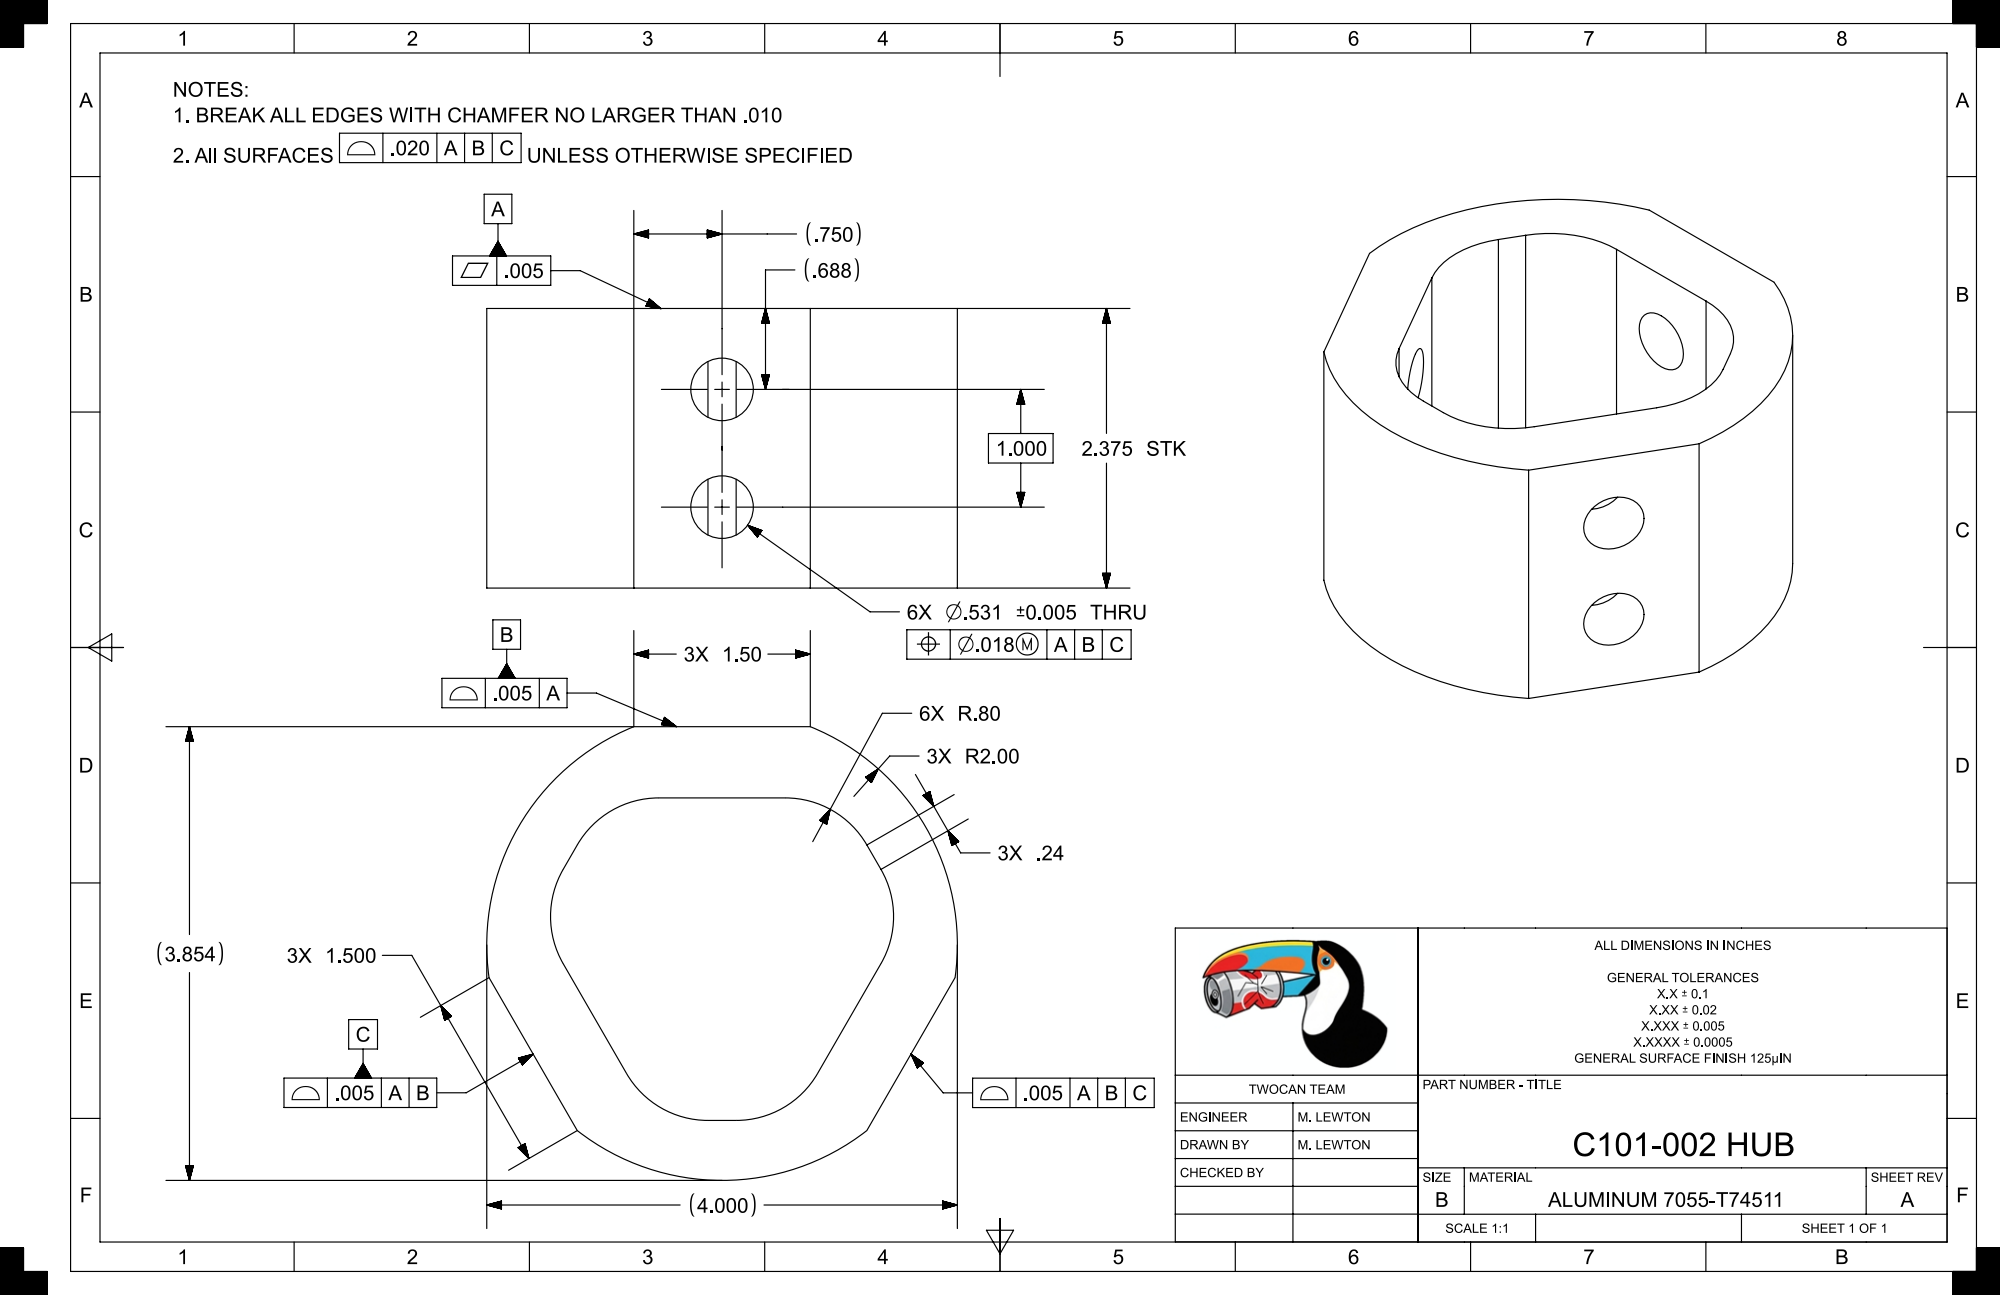
[picture p88: page 1]
