matt-lewton9/ME-463-Can-Crusher/PRE-RELEASE DWG/C102-001 TOP STRUT_dwg1_PRE-RELEASE.pdf

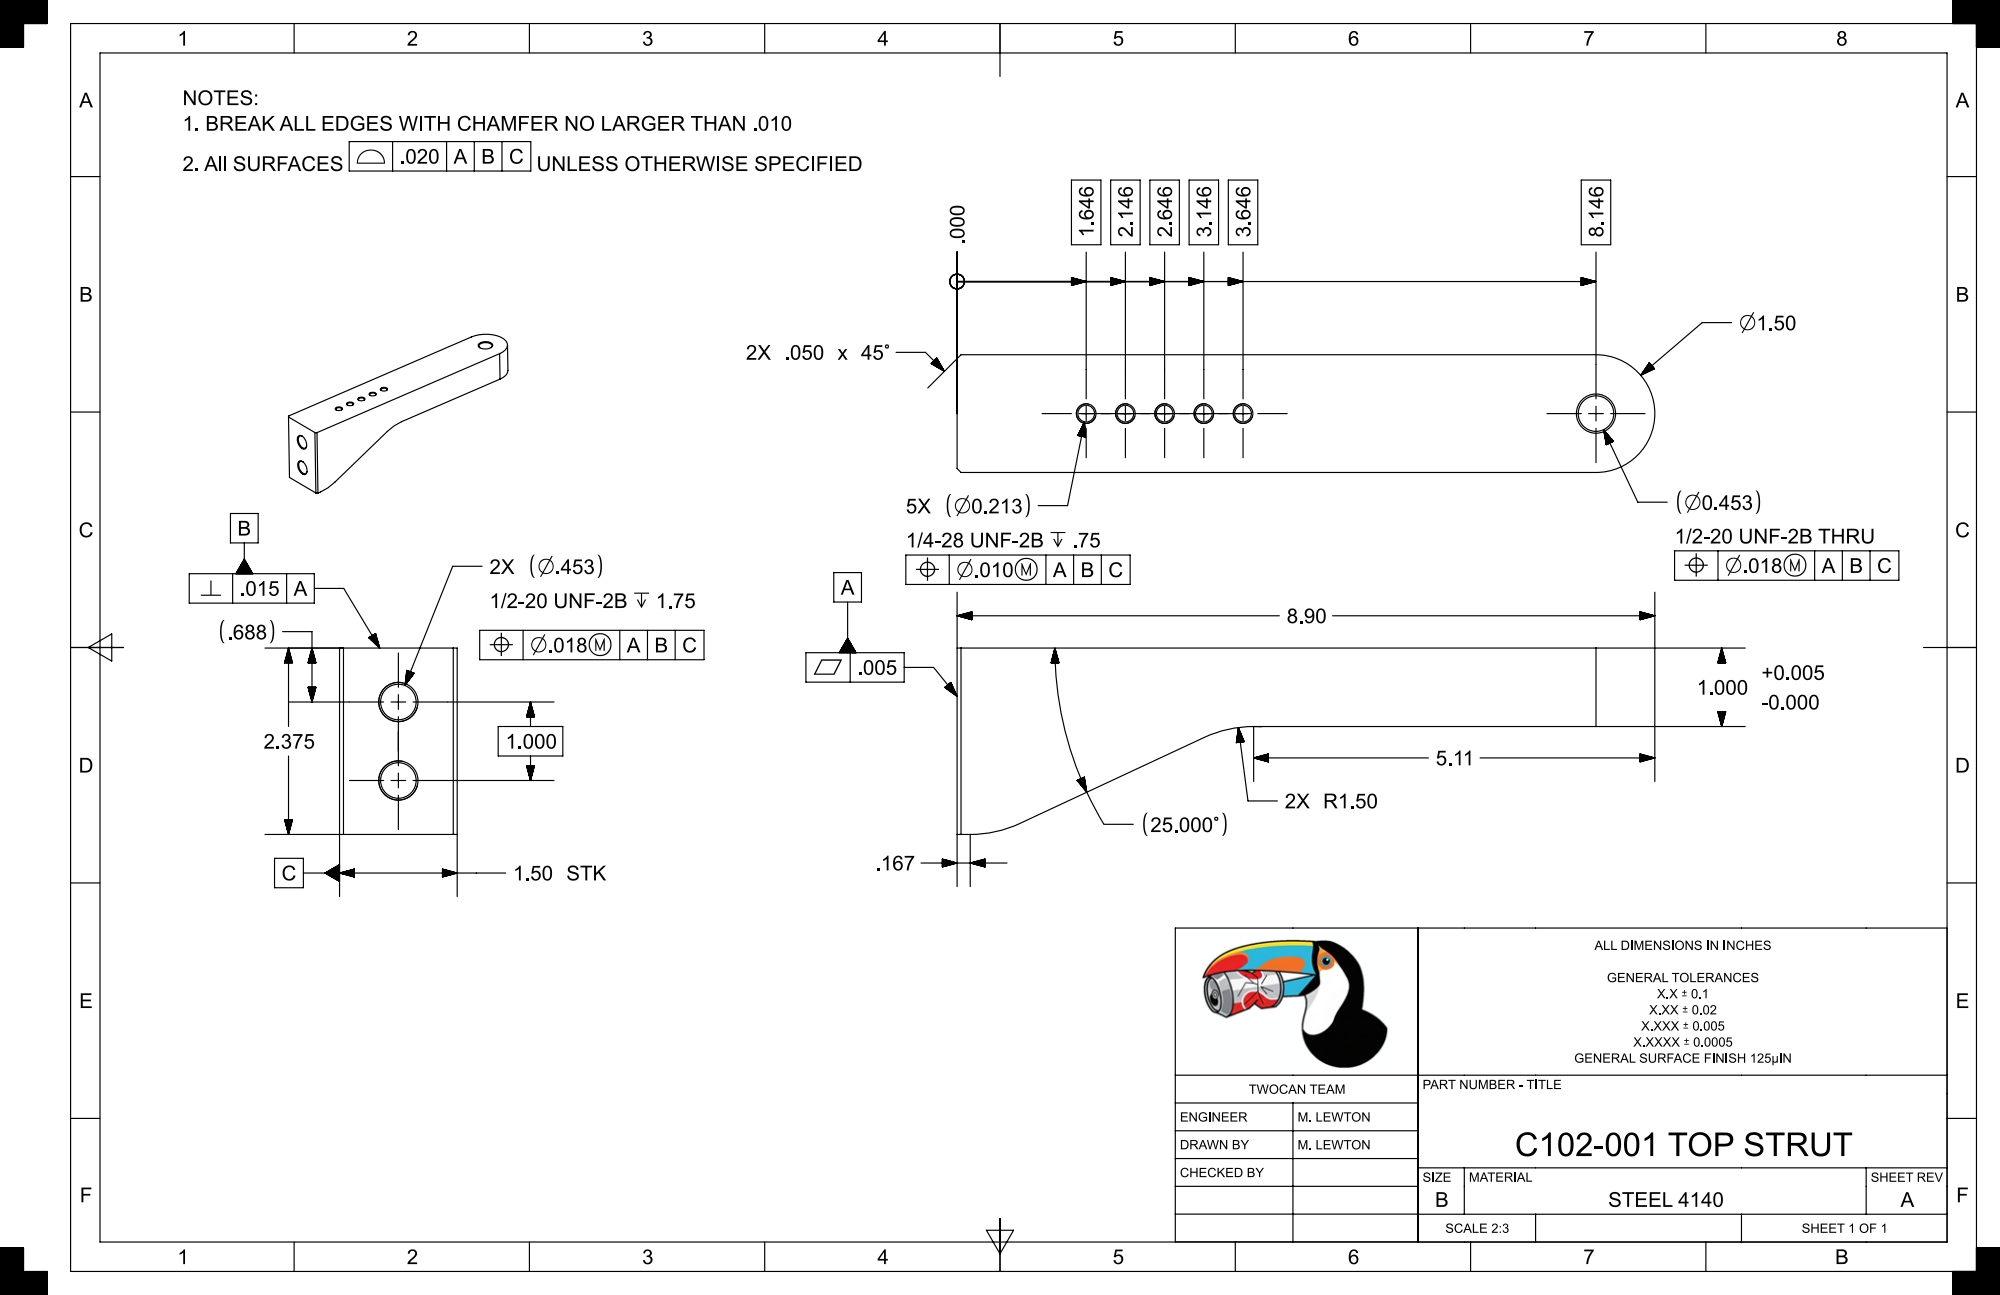
[picture p89: page 1]
