matt-lewton9/ME-463-Can-Crusher/PRE-RELEASE DWG/C105-001 CUSTOMER AIRFRAME_dwg1_PRE-RELEASE.pdf

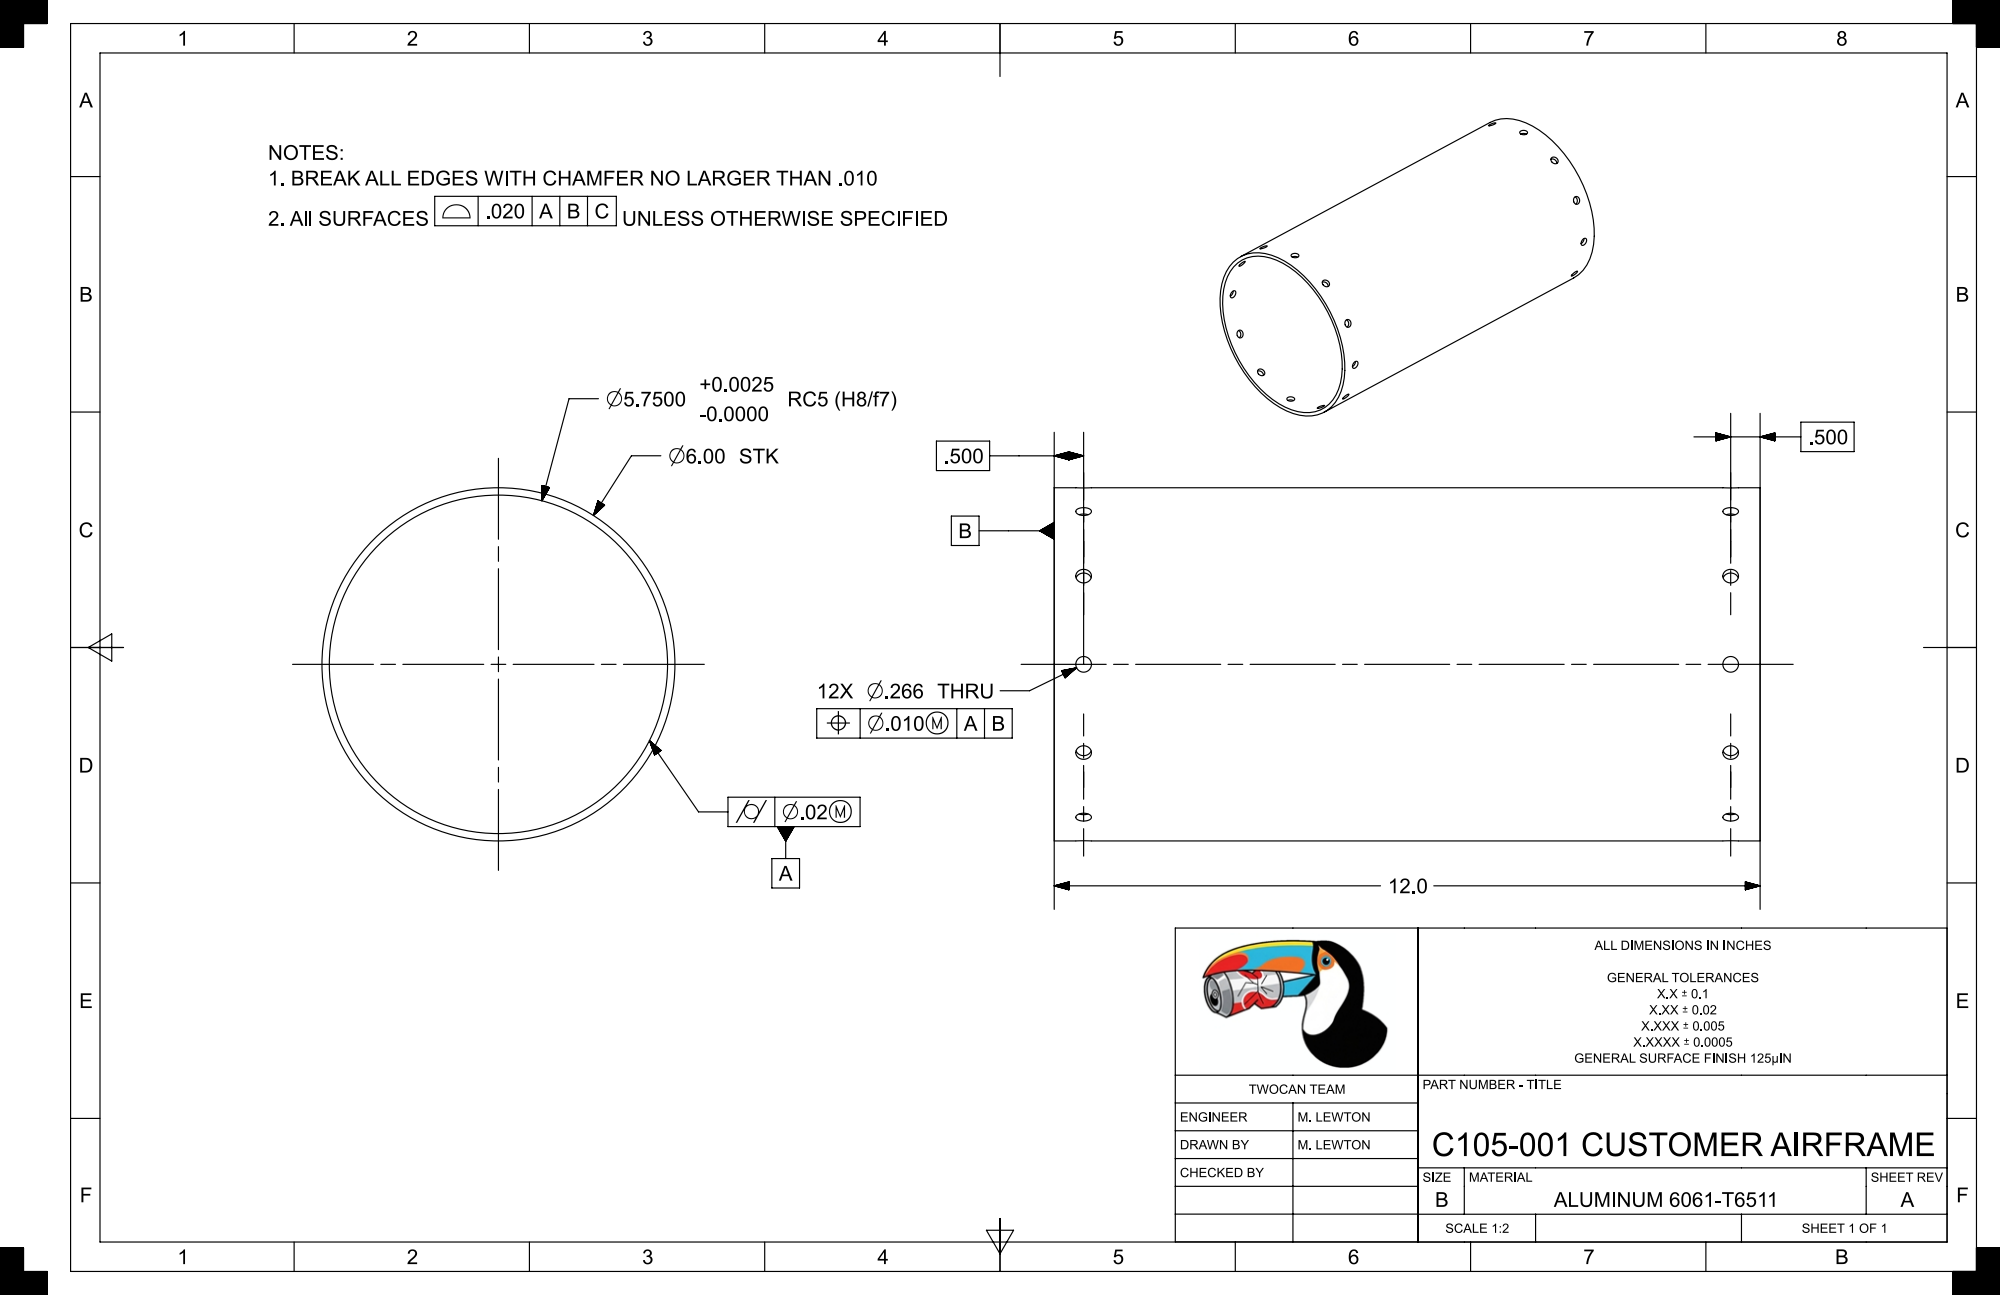
[picture p90: page 1]
