matt-lewton9/ME-463-Can-Crusher/PRE-RELEASE DWG/C105-002 CUSTOMER CONNECTOR_dwg1_PRE-RELEASE.pdf

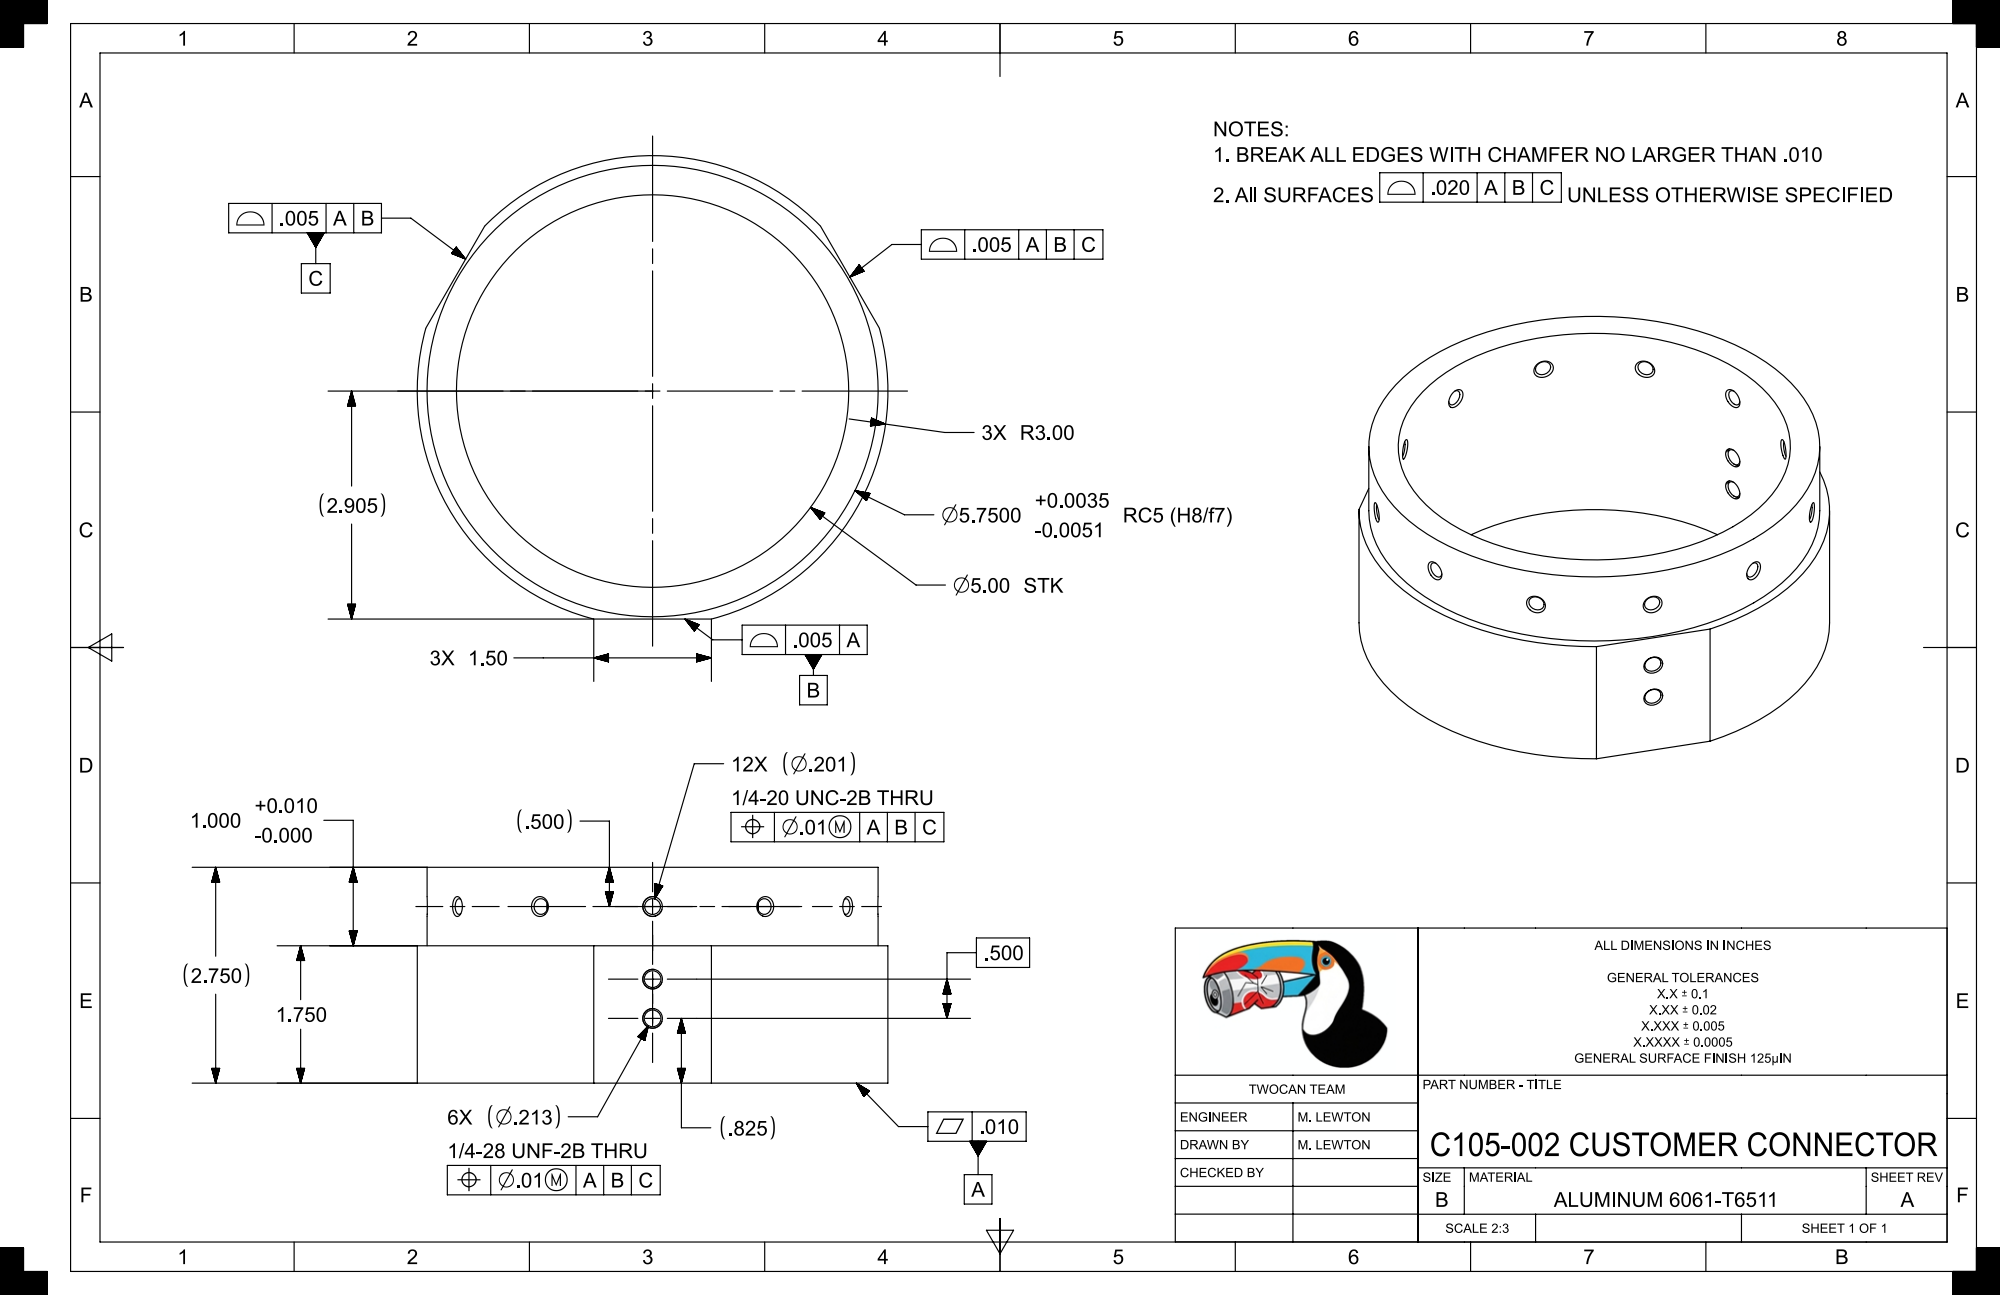
[picture p91: page 1]
