matt-lewton9/ME-463-Can-Crusher/PRE-RELEASE DWG/C105-003 CONNECTOR BRACKET_dwg1_PRE-RELEASE.pdf

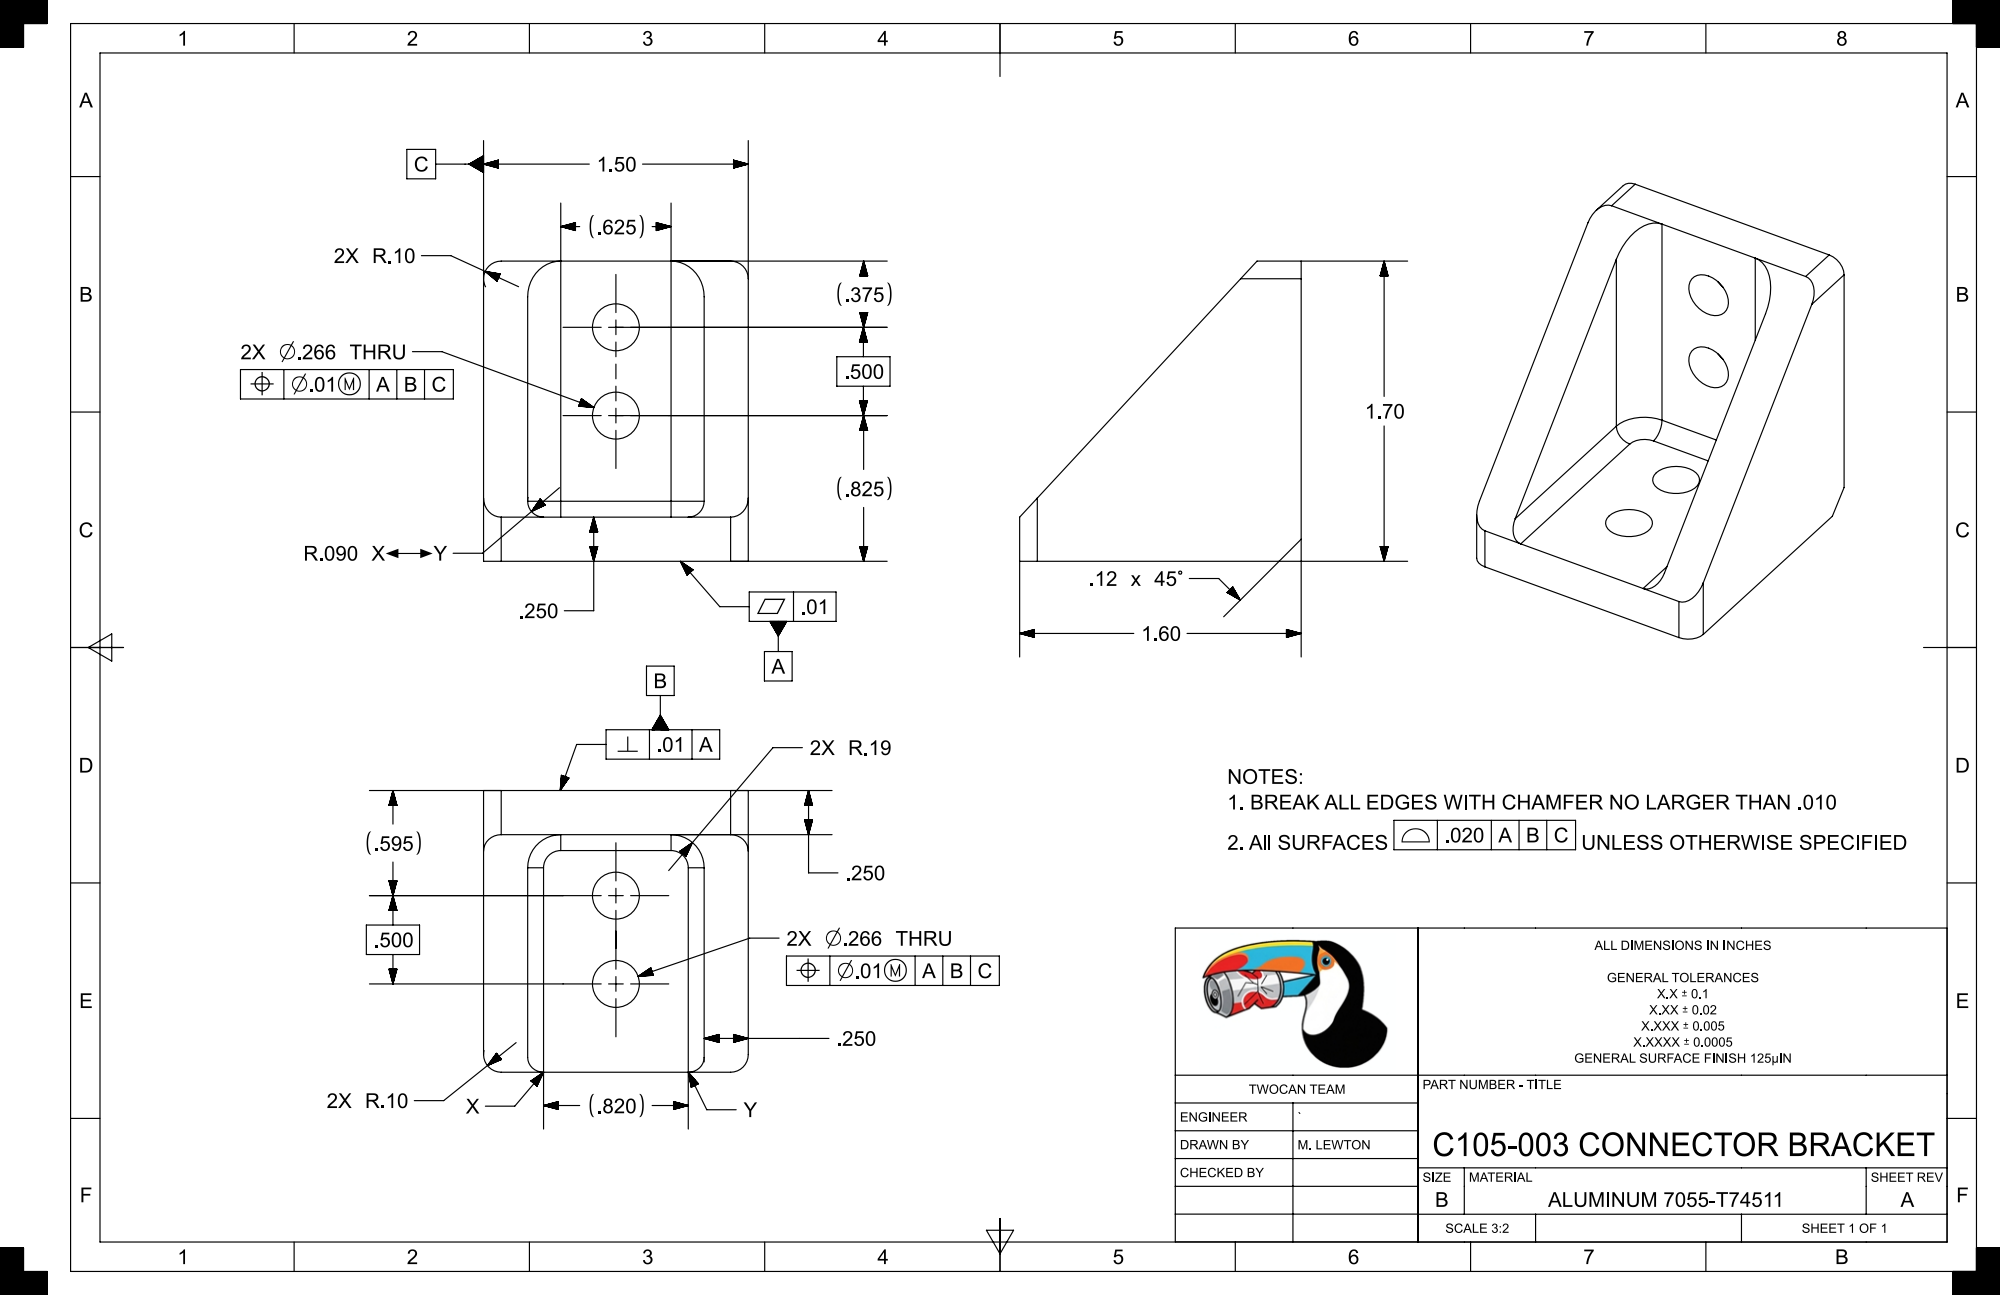
[picture p92: page 1]
