matt-lewton9/ME-463-Can-Crusher/PRE-RELEASE DWG/C106-001 PULLEY_dwg1_PRE-RELEASE.pdf

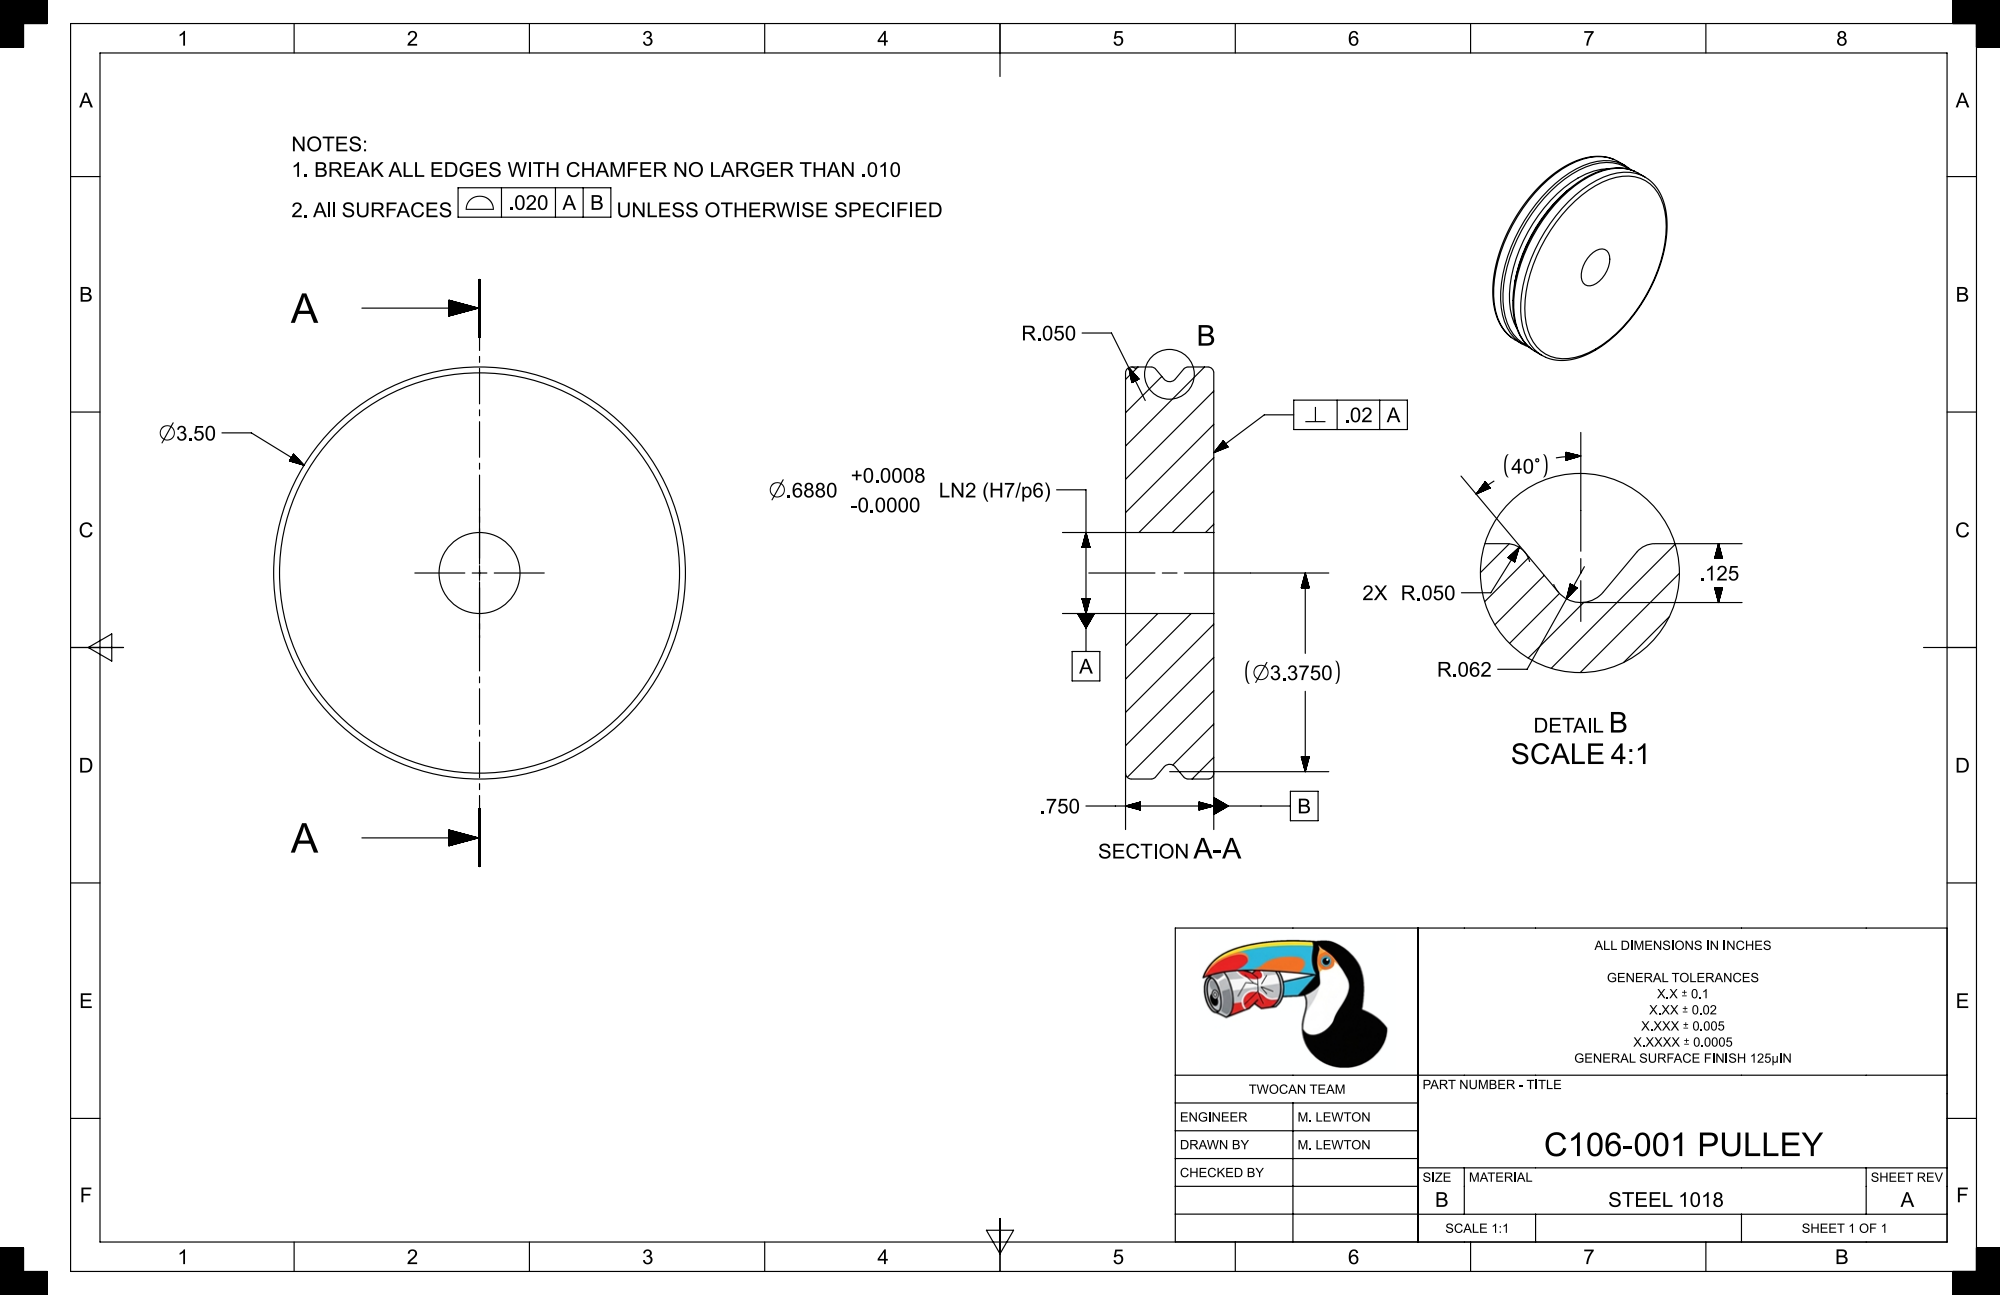
[picture p93: page 1]
