matt-lewton9/ME-463-Can-Crusher/PRE-RELEASE DWG/C106-002 PULLEY PLATE_dwg1_PRE-RELEASE.pdf

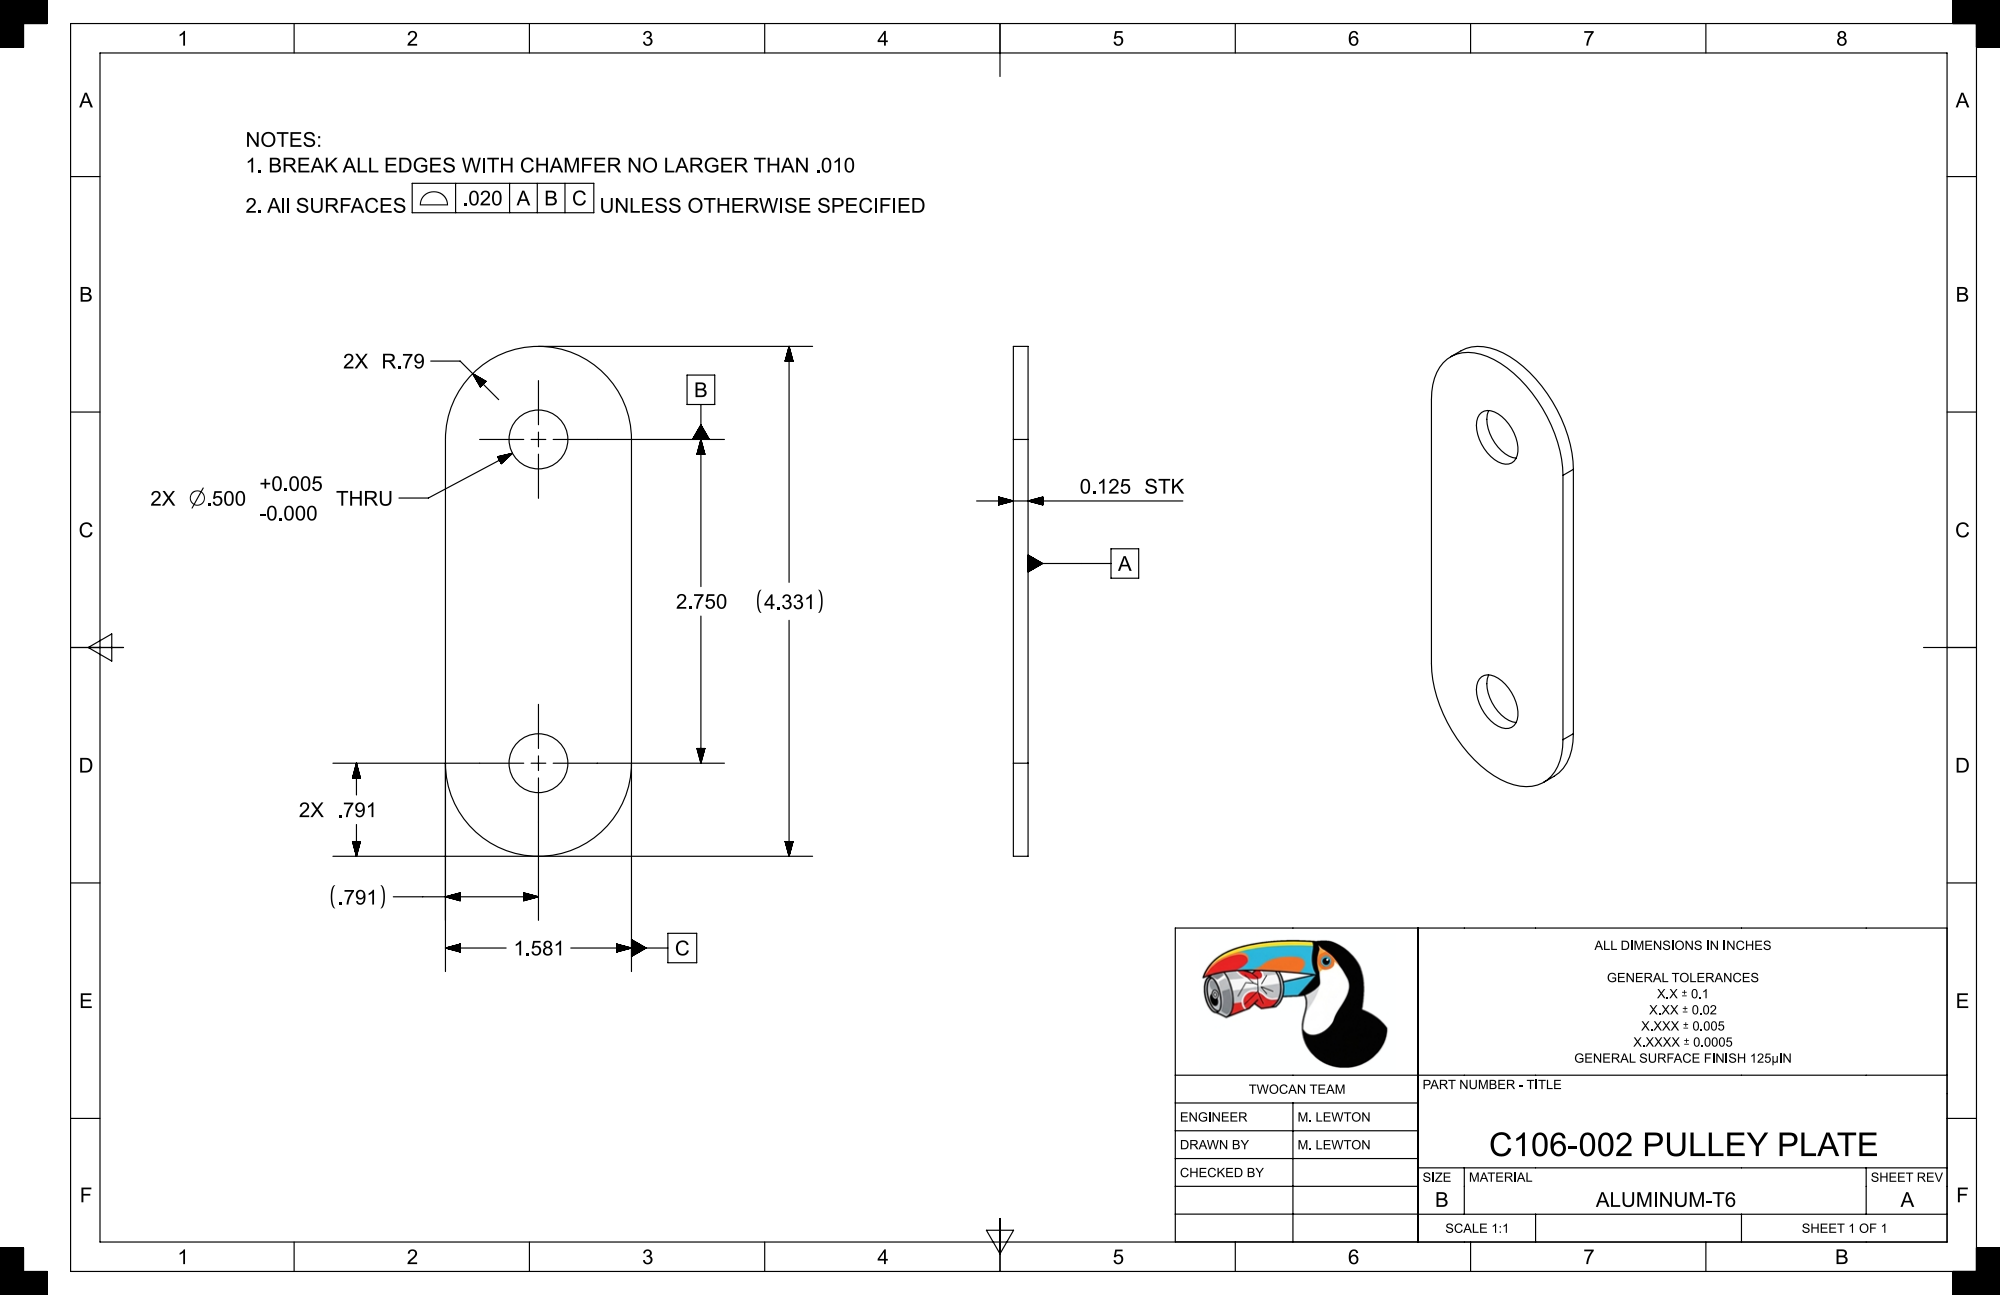
[picture p94: page 1]
