matt-lewton9/ME-463-Can-Crusher/PRE-RELEASE DWG/C103-003 CYLINDER BOTTOM CAP.pdf

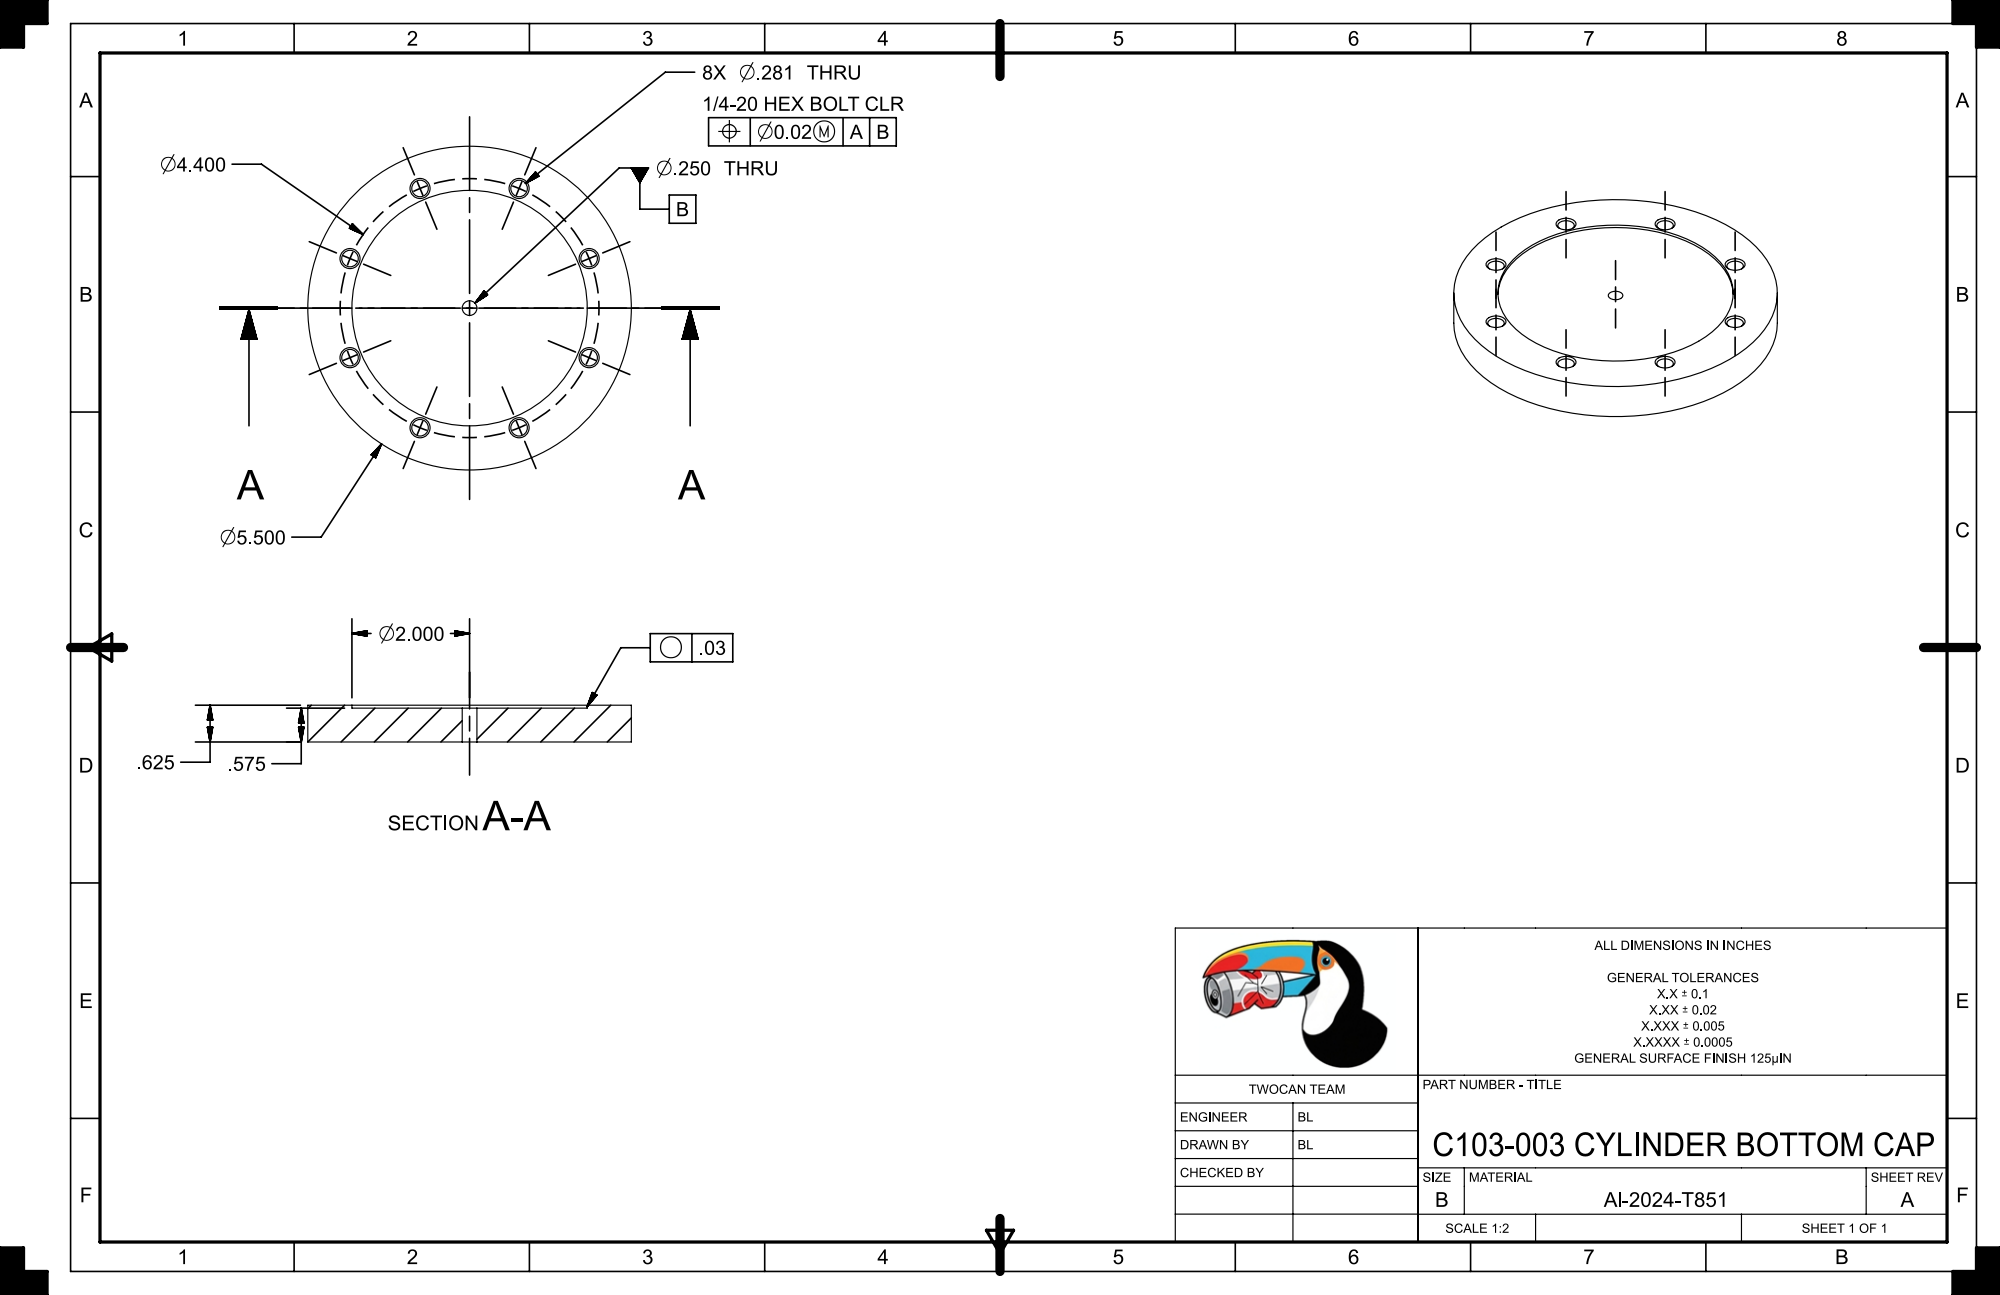
[picture p95: page 1]
