matt-lewton9/ME-463-Can-Crusher/Controller/PT testing for real/test_ert_rtw/MW_target_hardware_resources.h

#ifndef PORTABLE_WORDSIZES
#ifdef __MW_TARGET_USE_HARDWARE_RESOURCES_H__
#ifndef __MW_TARGET_HARDWARE_RESOURCES_H__
#define __MW_TARGET_HARDWARE_RESOURCES_H__

#define MW_MULTI_TASKING_MODE 0
#include "MW_ArduinoHWInit.h"
#include "arduinoAVRScheduler.h"

#define MW_USECODERTARGET 1
#define MW_TARGETHARDWARE Arduino Mega 2560
#define MW_EXTMODEPROTOCOLINFO_XCPONSERIAL_HOSTINTERFACE Simulink
#define MW_EXTMODEPROTOCOLINFO_XCPONSERIAL_LOGGINGBUFFERAUTO 1
#define MW_EXTMODEPROTOCOLINFO_XCPONSERIAL_LOGGINGBUFFERSIZE 500
#define MW_EXTMODEPROTOCOLINFO_XCPONSERIAL_LOGGINGBUFFERNUM 3
#define MW_EXTMODEPROTOCOLINFO_XCPONSERIAL_MAXCONTIGSAMPLES 10
#define MW_EXTMODEPROTOCOLINFO_XCPONTCPIP_HOSTINTERFACE Simulink
#define MW_EXTMODEPROTOCOLINFO_XCPONTCPIP_LOGGINGBUFFERAUTO 1
#define MW_EXTMODEPROTOCOLINFO_XCPONTCPIP_LOGGINGBUFFERSIZE 500
#define MW_EXTMODEPROTOCOLINFO_XCPONTCPIP_LOGGINGBUFFERNUM 3
#define MW_EXTMODEPROTOCOLINFO_XCPONTCPIP_MAXCONTIGSAMPLES 10
#define MW_EXTMODEPROTOCOLINFO_XCPONWIFI_HOSTINTERFACE Simulink
#define MW_EXTMODEPROTOCOLINFO_XCPONWIFI_LOGGINGBUFFERAUTO 1
#define MW_EXTMODEPROTOCOLINFO_XCPONWIFI_LOGGINGBUFFERSIZE 500
#define MW_EXTMODEPROTOCOLINFO_XCPONWIFI_LOGGINGBUFFERNUM 3
#define MW_EXTMODEPROTOCOLINFO_XCPONWIFI_MAXCONTIGSAMPLES 10
#define MW_CONNECTIONINFO_XCPONSERIAL_BAUDRATE codertarget.arduinobase.registry.getBaudRate
#define MW_CONNECTIONINFO_XCPONSERIAL_COMPORT codertarget.arduinobase.internal.getExternalModeMexArgs('Serial')
#define MW_CONNECTIONINFO_XCPONSERIAL_VERBOSE 0
#define MW_CONNECTIONINFO_XCPONTCPIP_IPADDRESS codertarget.arduinobase.internal.getExternalModeMexArgs('Ethernet')
#define MW_CONNECTIONINFO_XCPONTCPIP_PORT 17725
#define MW_CONNECTIONINFO_XCPONTCPIP_VERBOSE 0
#define MW_CONNECTIONINFO_XCPONWIFI_IPADDRESS codertarget.arduinobase.internal.getExternalModeMexArgs('Wifi')
#define MW_CONNECTIONINFO_XCPONWIFI_PORT 17725
#define MW_CONNECTIONINFO_XCPONWIFI_VERBOSE 0
#define MW_EXTMODE_CONFIGURATION XCP on Serial
#define MW_EXTMODE_COMPORTBAUD 115200
#define MW_EXTMODE_TARGETPOLLINGTIMEMODE 0
#define MW_EXTMODE_TARGETPOLLINGTIME 2
#define MW_EXTMODE_USEREALTIMESTAMPLOGGING 0
#define MW_EXTMODE_RUNNING on
#define MW_RTOS Baremetal
#define MW_SCHEDULER_INTERRUPT_SOURCE 0
#define MW_RUNTIME_BUILDACTION 1
#define MW_RUNTIME_DISABLEPARALLELBUILD 0
#define MW_RUNTIME_FORCEBUILDSTATICLIBRARY 0
#define MW_RUNTIME_VERBOSEOUTPUT 0
#define MW_HOSTBOARDCONNECTION_APPDOWNLOAD_PORT_SOURCE 1
#define MW_HOSTBOARDCONNECTION_APPDOWNLOAD_COMPORT_SELECT -1
#define MW_HOSTBOARDCONNECTION_APPDOWNLOAD_COMPORT_SPECIFY /dev/tty.usbmodemfa131
#define MW_HOSTBOARDCONNECTION_APPDOWNLOAD_BAUD 0
#define MW_HOSTBOARDCONNECTION_APPDOWNLOAD_BAUD_SPECIFY 
#define MW_HOSTBOARDCONNECTION_CONNECTEDIO_SERIAL_PORT 0
#define MW_HOSTBOARDCONNECTION_CONNECTEDIO_PORT_SOURCE1 1
#define MW_HOSTBOARDCONNECTION_CONNECTEDIO_PORT_SOURCE2 0
#define MW_HOSTBOARDCONNECTION_CONNECTEDIO_COMPORT_SELECT -1
#define MW_HOSTBOARDCONNECTION_CONNECTEDIO_COMPORT_SPECIFY /dev/tty.usbmodemfa131
#define MW_HOSTBOARDCONNECTION_CONNECTEDIO_BAUD 1
#define MW_HOSTBOARDCONNECTION_CONNECTEDIO_BAUD_SPECIFY 
#define MW_HOSTBOARDCONNECTION_EXTERNALMODE_SERIAL_PORT 0
#define MW_HOSTBOARDCONNECTION_EXTERNALMODE_PORT_SOURCE1 1
#define MW_HOSTBOARDCONNECTION_EXTERNALMODE_PORT_SOURCE2 0
#define MW_HOSTBOARDCONNECTION_EXTERNALMODE_COMPORT_SELECT -1
#define MW_HOSTBOARDCONNECTION_EXTERNALMODE_COMPORT_SPECIFY /dev/tty.usbmodemfa131
#define MW_HOSTBOARDCONNECTION_EXTERNALMODE_BAUD -1
#define MW_HOSTBOARDCONNECTION_EXTERNALMODE_BAUD_SPECIFY 
#define MW_HOSTBOARDCONNECTION_PIL_SERIAL_PORT 0
#define MW_HOSTBOARDCONNECTION_PIL_PORT_SOURCE1 1
#define MW_HOSTBOARDCONNECTION_PIL_PORT_SOURCE2 0
#define MW_HOSTBOARDCONNECTION_PIL_COMPORT_SELECT -1
#define MW_HOSTBOARDCONNECTION_PIL_COMPORT_SPECIFY /dev/tty.usbmodemfa131
#define MW_HOSTBOARDCONNECTION_PIL_BAUD 0
#define MW_HOSTBOARDCONNECTION_PIL_BAUD_SPECIFY 
#define MW_CONNECTEDIO_CONNECTEDIOMODE 0
#define MW_CONNECTEDIO_ACTIONONOVERRUN 0
#define MW_OVERRUNDETECTION_ENABLE_OVERRUN_DETECTION 0
#define MW_OVERRUNDETECTION_DIGITAL_OUTPUT_TO_SET_ON_OVERRUN 13
#define MW_ANALOGINREFVOLTAGE_ANALOG_INPUT_REFERENCE_VOLTAGE 0.000000
#define MW_SERIAL_SERIAL0_BAUD_RATE 8
#define MW_SERIAL_SERIAL0_BAUD_SPECIFY 921600
#define MW_SERIAL_SERIAL0_CONFIG 3
#define MW_SERIAL_SERIAL1_BAUD_RATE 8
#define MW_SERIAL_SERIAL1_BAUD_SPECIFY 921600
#define MW_SERIAL_SERIAL1_CONFIG 3
#define MW_SERIAL_SERIAL2_BAUD_RATE 8
#define MW_SERIAL_SERIAL2_BAUD_SPECIFY 921600
#define MW_SERIAL_SERIAL2_CONFIG 3
#define MW_SERIAL_SERIAL3_BAUD_RATE 8
#define MW_SERIAL_SERIAL3_BAUD_SPECIFY 921600
#define MW_SERIAL_SERIAL3_CONFIG 3
#define MW_I2C_I2C0BUSSPEEDHZ 100000
#define MW_SPI_SPI0_CLOCK_OUT_FREQUENCY 1
#define MW_SPI_SPI0_MODE 0
#define MW_SPI_SPI0_BITORDER 0
#define MW_SPI_SDSLAVESELECT 4.000000
#define MW_SPI_CANCHIPSELECT 9.000000
#define MW_ETHERNET_DISABLE_DHCP_ETHERNET 0
#define MW_ETHERNET_LOCAL_IP_ADDRESS 192.168.0.20
#define MW_ETHERNET_LOCAL_MAC_ADDRESS DE:AD:BE:EF:FE:ED
#define MW_WIFI_WIFI_HARDWARE 0
#define MW_WIFI_WIFI_SSID yourNetwork
#define MW_WIFI_SET_WIFI_ENCRYPTION 0
#define MW_WIFI_WIFI_WEP_KEY D0D0DEADF00DABBADEAFBEADED
#define MW_WIFI_WIFI_WEP_KEY_INDEX 0
#define MW_WIFI_WIFI_WPA_PASSWORD secretPassword
#define MW_WIFI_WIFI_ESP8266_HW_SERIAL_PORT 0
#define MW_WIFI_IP_ADDRESS_ASSIGNMENT 0
#define MW_WIFI_WIFI_IP_ADDRESS 192.168.1.20
#define MW_THINGSPEAK_ENABLE_CUSTOMSERVER 48
#define MW_THINGSPEAK_IP_ADDRESS 184.106.153.149
#define MW_THINGSPEAK_PORT 80
#define MW_CAN_CANBUSSPEED 10
#define MW_CAN_CANOSCILLATORFREQUENCY 1
#define MW_CAN_INTERRUPTPIN 2.000000
#define MW_CAN_ALLOWALLFILTER 0
#define MW_CAN_BUFFER0IDTYPE 0
#define MW_CAN_ACCEPTANCEMASK0_NOR 0
#define MW_CAN_ACCEPTANCEFILTER0_NOR 255
#define MW_CAN_ACCEPTANCEFILTER1_NOR 255
#define MW_CAN_ACCEPTANCEMASK0_EXT 0
#define MW_CAN_ACCEPTANCEFILTER0_EXT 255
#define MW_CAN_ACCEPTANCEFILTER1_EXT 255
#define MW_CAN_BUFFER1IDTYPE 0
#define MW_CAN_ACCEPTANCEMASK1_NOR 0
#define MW_CAN_ACCEPTANCEFILTER2_NOR 255
#define MW_CAN_ACCEPTANCEFILTER3_NOR 255
#define MW_CAN_ACCEPTANCEFILTER4_NOR 255
#define MW_CAN_ACCEPTANCEFILTER5_NOR 255
#define MW_CAN_ACCEPTANCEMASK1_EXT 0
#define MW_CAN_ACCEPTANCEFILTER2_EXT 255
#define MW_CAN_ACCEPTANCEFILTER3_EXT 255
#define MW_CAN_ACCEPTANCEFILTER4_EXT 255
#define MW_CAN_ACCEPTANCEFILTER5_EXT 255
#define MW_MODBUS_MODBUS_COMMS 0
#define MW_MODBUS_MODBUS_MODE 0
#define MW_MODBUS_MODBUS_SLAVEID 1
#define MW_MODBUS_MODBUS_CONFIGCOIL 49
#define MW_MODBUS_MODBUS_COILADDR 0
#define MW_MODBUS_MODBUS_COILNUM 1
#define MW_MODBUS_MODBUS_CONFIGINPUT 49
#define MW_MODBUS_MODBUS_INPUTADDR 0
#define MW_MODBUS_MODBUS_INPUTNUM 1
#define MW_MODBUS_MODBUS_CONFIGHOLDINGREG 49
#define MW_MODBUS_MODBUS_HOLDINGREGADDR 0
#define MW_MODBUS_MODBUS_HOLDINGREGNUM 1
#define MW_MODBUS_MODBUS_CONFIGINPUTREG 49
#define MW_MODBUS_MODBUS_INPUTREGADDR 0
#define MW_MODBUS_MODBUS_INPUTREGNUM 1
#define MW_MODBUS_MODBUS_MASTERTIMEOUT 100
#define MW_RS485_RS485_SERIAL 1
#define MW_RS485_RS485_BAUD 9600
#define MW_RS485_RS485_CONFIG 3
#define MW_RS485_RS485_DEPIN 8
#define MW_RS485_RS485_REPIN 9
#define MW_DISPLAY_ENABLECODEGEN 0
#define MW_DISPLAY_APPLAUNCHBUTTON 
#define MW_IOBLOCKSMODE deployed
#define MW_DATAVERSION 2016.02
#define MW_DASHBOARDCODEGENINFO_ENABLECODEGEN 0
#define MW_DASHBOARDCODEGENINFO_CIRCULARGAUGE_CODEGEN 1
#define MW_DASHBOARDCODEGENINFO_CIRCULARGAUGE_BLOCKCLASS codertarget.targetHiddenBlkInsert.internal.circularGauge
#define MW_DASHBOARDCODEGENINFO_CIRCULARGAUGE_REGFCN codertarget.arduinobase.blocks.registerDashboardBlk
#define MW_DASHBOARDCODEGENINFO_CIRCULARGAUGE_VALIDATEFCN codertarget.targetHiddenBlkInsert.internal.isDashboardBlockCodegenEnabled
#define MW_DASHBOARDCODEGENINFO_DISPLAYBLOCK_CODEGEN 1
#define MW_DASHBOARDCODEGENINFO_DISPLAYBLOCK_BLOCKCLASS codertarget.targetHiddenBlkInsert.internal.lcdTextDisplay
#define MW_DASHBOARDCODEGENINFO_DISPLAYBLOCK_REGFCN codertarget.arduinobase.blocks.registerDashboardBlk
#define MW_DASHBOARDCODEGENINFO_DISPLAYBLOCK_VALIDATEFCN codertarget.targetHiddenBlkInsert.internal.isDashboardBlockCodegenEnabled
#define MW_DASHBOARDCODEGENINFO_PUSHBUTTON_CODEGEN 1
#define MW_DASHBOARDCODEGENINFO_PUSHBUTTON_BLOCKCLASS codertarget.targetHiddenBlkInsert.internal.pushButton
#define MW_DASHBOARDCODEGENINFO_PUSHBUTTON_REGFCN codertarget.arduinobase.blocks.registerDashboardBlk
#define MW_DASHBOARDCODEGENINFO_PUSHBUTTON_VALIDATEFCN codertarget.targetHiddenBlkInsert.internal.isDashboardBlockCodegenEnabled

#endif /* __MW_TARGET_HARDWARE_RESOURCES_H__ */

#endif

#endif
