matt-lewton9/ME-463-Can-Crusher/Controller/PT testing for real/test_ert_rtw/ert_main.c

#include "test.h"
#include "rtwtypes.h"
#include "xcp.h"
#include "ext_mode.h"
#include "MW_target_hardware_resources.h"

volatile int IsrOverrun = 0;
static boolean_T OverrunFlag = 0;
void rt_OneStep(void)
{
  extmodeSimulationTime_T currentTime = (extmodeSimulationTime_T) 0;

  /* Check for overrun. Protect OverrunFlag against preemption */
  if (OverrunFlag++) {
    IsrOverrun = 1;
    OverrunFlag--;
    return;
  }

#ifndef _MW_ARDUINO_LOOP_

  sei();

#endif;

  currentTime = (extmodeSimulationTime_T) (test_M->Timing.clockTick0+
    test_M->Timing.clockTickH0* 4294967296.0);
  test_step();

  /* Get model outputs here */

  /* Trigger External Mode event */
  extmodeEvent(0, currentTime);

#ifndef _MW_ARDUINO_LOOP_

  cli();

#endif;

  OverrunFlag--;
}

extern void rtIOStreamResync();
volatile boolean_T stopRequested;
volatile boolean_T runModel;
int main(void)
{
  float modelBaseRate = 0.1;
  float systemClock = 0;
  extmodeErrorCode_T errorCode = EXTMODE_SUCCESS;

  /* Initialize variables */
  stopRequested = false;
  runModel = false;
  init();
  MW_Arduino_Init();
  rtmSetErrorStatus(test_M, 0);

  /* Set Final Simulation Time in Ticks */
  errorCode = extmodeSetFinalSimulationTime((extmodeSimulationTime_T) -1);

  /* Parse External Mode command line arguments */
  errorCode = extmodeParseArgs(0, NULL);
  if (errorCode != EXTMODE_SUCCESS) {
    return (errorCode);
  }

  test_initialize();
  cli();
  sei();

  /* External Mode initialization */
  errorCode = extmodeInit(test_M->extModeInfo, (extmodeSimulationTime_T *)
    rteiGetPtrTFinalTicks(test_M->extModeInfo));
  if (errorCode != EXTMODE_SUCCESS) {
    /* Code to handle External Mode initialization errors
       may be added here */
  }

  if (errorCode == EXTMODE_SUCCESS) {
    /* Wait until a Start or Stop Request has been received from the Host */
    extmodeWaitForHostRequest(EXTMODE_WAIT_FOREVER);
    if (extmodeStopRequested()) {
      rtmSetStopRequested(test_M, true);
    }
  }

  cli();
  configureArduinoAVRTimer();
  runModel =
    !extmodeSimulationComplete()&& !extmodeStopRequested()&&
    !rtmGetStopRequested(test_M);

#ifndef _MW_ARDUINO_LOOP_

  sei();

#endif;

  XcpStatus lastXcpState = xcpStatusGet();
  sei();
  while (runModel) {
    /* Run External Mode background activities */
    errorCode = extmodeBackgroundRun();
    if (errorCode != EXTMODE_SUCCESS && errorCode != EXTMODE_EMPTY) {
      /* Code to handle External Mode background task errors
         may be added here */
    }

    stopRequested = !(
                      !extmodeSimulationComplete()&& !extmodeStopRequested()&&
                      !rtmGetStopRequested(test_M));
    runModel = !(stopRequested);
    if (stopRequested)
      disable_rt_OneStep();
    if (lastXcpState==XCP_CONNECTED && xcpStatusGet()==XCP_DISCONNECTED)
      rtIOStreamResync();
    lastXcpState = xcpStatusGet();
    MW_Arduino_Loop();
    MW_Modbus_Slave_Poll();
  }

  /* Terminate model */
  test_terminate();

  /* External Mode reset */
  extmodeReset();
  cli();
  return 0;
}
