matt-lewton9/ME-463-Can-Crusher/Controller/PT testing for real/test_ert_rtw/test.h

/*
 * test.h
 *
 * Academic License - for use in teaching, academic research, and meeting
 * course requirements at degree granting institutions only.  Not for
 * government, commercial, or other organizational use.
 *
 * Code generation for model "test".
 *
<<<<<<< Updated upstream
 * Model version              : 1.5
 * Simulink Coder version : 25.1 (R2025a) 21-Nov-2024
 * C source code generated on : Fri Nov 14 08:23:29 2025
=======
<<<<<<< HEAD:Controller/PT Testing/testing_ert_rtw/testing.h
 * Model version              : 1.8
 * Simulink Coder version : 25.1 (R2025a) 21-Nov-2024
 * C source code generated on : Thu Nov 13 14:03:39 2025
=======
 * Model version              : 1.5
 * Simulink Coder version : 25.1 (R2025a) 21-Nov-2024
 * C source code generated on : Fri Nov 14 08:23:29 2025
>>>>>>> d8fe93d0735132b4394d298923e49b5c596820f4:Controller/PT testing for real/test_ert_rtw/test.h
>>>>>>> Stashed changes
 *
 * Target selection: ert.tlc
 * Note: GRT includes extra infrastructure and instrumentation for prototyping
 * Embedded hardware selection: Atmel->AVR
 * Code generation objectives: Unspecified
 * Validation result: Not run
 */

#ifndef test_h_
#define test_h_
#ifndef test_COMMON_INCLUDES_
#define test_COMMON_INCLUDES_
#include "rtwtypes.h"
#include "rtw_extmode.h"
#include "sysran_types.h"
#include "rtw_continuous.h"
#include "rtw_solver.h"
#include "MW_I2C.h"
#endif                                 /* test_COMMON_INCLUDES_ */

#include "test_types.h"
#include <string.h>
#include "MW_target_hardware_resources.h"

/* Macros for accessing real-time model data structure */
#ifndef rtmGetFinalTime
#define rtmGetFinalTime(rtm)           ((rtm)->Timing.tFinal)
#endif

#ifndef rtmGetRTWExtModeInfo
#define rtmGetRTWExtModeInfo(rtm)      ((rtm)->extModeInfo)
#endif

#ifndef rtmGetErrorStatus
#define rtmGetErrorStatus(rtm)         ((rtm)->errorStatus)
#endif

#ifndef rtmSetErrorStatus
#define rtmSetErrorStatus(rtm, val)    ((rtm)->errorStatus = (val))
#endif

#ifndef rtmGetStopRequested
#define rtmGetStopRequested(rtm)       ((rtm)->Timing.stopRequestedFlag)
#endif

#ifndef rtmSetStopRequested
#define rtmSetStopRequested(rtm, val)  ((rtm)->Timing.stopRequestedFlag = (val))
#endif

#ifndef rtmGetStopRequestedPtr
#define rtmGetStopRequestedPtr(rtm)    (&((rtm)->Timing.stopRequestedFlag))
#endif

#ifndef rtmGetTFinal
#define rtmGetTFinal(rtm)              ((rtm)->Timing.tFinal)
#endif

#ifndef rtmGetTPtr
#define rtmGetTPtr(rtm)                (&)
#endif

/* Block signals (default storage) */
typedef struct {
  uint8_T I2CRead2_o1;                 /* '<Root>/I2C Read2' */
  uint8_T I2CRead2_o2;                 /* '<Root>/I2C Read2' */
  uint8_T I2CRead1_o1;                 /* '<Root>/I2C Read1' */
  uint8_T I2CRead1_o2;                 /* '<Root>/I2C Read1' */
  uint8_T I2CRead_o1;                  /* '<Root>/I2C Read' */
  uint8_T I2CRead_o2;                  /* '<Root>/I2C Read' */
} B_test_T;

/* Block states (default storage) for system '<Root>' */
typedef struct {
  codertarget_arduinobase_inter_T obj; /* '<Root>/I2C Read2' */
  codertarget_arduinobase_inter_T obj_i;/* '<Root>/I2C Read1' */
  codertarget_arduinobase_inter_T obj_ib;/* '<Root>/I2C Read' */
  codertarget_arduinobase_int_j_T obj_j;/* '<Root>/I2C Write' */
  boolean_T objisempty;                /* '<Root>/I2C Write' */
  boolean_T objisempty_j;              /* '<Root>/I2C Read2' */
  boolean_T objisempty_b;              /* '<Root>/I2C Read1' */
  boolean_T objisempty_h;              /* '<Root>/I2C Read' */
} DW_test_T;

/* Parameters (default storage) */
struct P_test_T_ {
  uint8_T Constant_Value;              /* Expression: 0x01
                                        * Referenced by: '<Root>/Constant'
                                        */
};

/* Real-time Model Data Structure */
struct tag_RTM_test_T {
  const char_T *errorStatus;
  RTWExtModeInfo *extModeInfo;

  /*
   * Sizes:
   * The following substructure contains sizes information
   * for many of the model attributes such as inputs, outputs,
   * dwork, sample times, etc.
   */
  struct {
    uint32_T checksums[4];
  } Sizes;

  /*
   * SpecialInfo:
   * The following substructure contains special information
   * related to other components that are dependent on RTW.
   */
  struct {
    const void *mappingInfo;
  } SpecialInfo;

  /*
   * Timing:
   * The following substructure contains information regarding
   * the timing information for the model.
   */
  struct {
    uint32_T clockTick0;
    uint32_T clockTickH0;
    time_T tFinal;
    boolean_T stopRequestedFlag;
  } Timing;
};

/* Block parameters (default storage) */
extern P_test_T test_P;

/* Block signals (default storage) */
extern B_test_T test_B;

/* Block states (default storage) */
extern DW_test_T test_DW;

/* Model entry point functions */
extern void test_initialize(void);
extern void test_step(void);
extern void test_terminate(void);

/* Real-time Model object */
extern RT_MODEL_test_T *const test_M;
extern volatile boolean_T stopRequested;
extern volatile boolean_T runModel;

/*-
 * The generated code includes comments that allow you to trace directly
 * back to the appropriate location in the model.  The basic format
 * is <system>/block_name, where system is the system number (uniquely
 * assigned by Simulink) and block_name is the name of the block.
 *
 * Use the MATLAB hilite_system command to trace the generated code back
 * to the model.  For example,
 *
 * hilite_system('<S3>')    - opens system 3
 * hilite_system('<S3>/Kp') - opens and selects block Kp which resides in S3
 *
 * Here is the system hierarchy for this model
 *
 * '<Root>' : 'test'
 */
#endif                                 /* test_h_ */
