matt-lewton9/ME-463-Can-Crusher/Controller/PT testing for real/test_ert_rtw/rtmodel.h

/*
 * rtmodel.h
 *
 * Code generation for Simulink model "test".
 *
 * Simulink Coder version                : 25.1 (R2025a) 21-Nov-2024
<<<<<<< Updated upstream
 * C source code generated on : Fri Nov 14 08:23:29 2025
=======
<<<<<<< HEAD:Controller/PT Testing/testing_ert_rtw/rtmodel.h
 * C source code generated on : Thu Nov 13 14:03:39 2025
=======
 * C source code generated on : Fri Nov 14 08:23:29 2025
>>>>>>> d8fe93d0735132b4394d298923e49b5c596820f4:Controller/PT testing for real/test_ert_rtw/rtmodel.h
>>>>>>> Stashed changes
 *
 * Note that the generated code is not dependent on this header file.
 * The file is used in cojuction with the automatic build procedure.
 * It is included by the sample main executable harness
 * MATLAB/rtw/c/src/common/rt_main.c.
 *
 */

#ifndef rtmodel_h_
#define rtmodel_h_
#include "test.h"
#endif                                 /* rtmodel_h_ */
