matt-lewton9/ME-463-Can-Crusher/(commit log)

2025-09-20 acutator layout
    [C101-000 BOTTOM LAYOUT.prt, C103-000 ACTUATOR LAYOUT.prt]
2025-09-20 put actuator in-line with eye bolt on strutsarchitecture
    [C100-000 LAYOUT.prt, C101-000 BOTTOM LAYOUT.prt, C103-000 ACTUATOR LAYOUT.prt]
2025-09-20 struts in there
    [C100-000 LAYOUT.prt, C101-000 BOTTOM LAYOUT.prt, C103-000 ACTUATOR LAYOUT.prt]
2025-09-21 design updates for today
    [C100-000 LAYOUT.prt, C101-000 BOTTOM LAYOUT.prt]
2025-09-23 bottom structure cad
    [C100-000 LAYOUT.prt, C100-501 CAN CRUSHER ASSEMBLY.prt, C101-000 BOTTOM LAYOUT.prt, C101-001 STRUT.prt, C101-002 HUB.prt, C101-501 BOTTOM STRUCTURE ASSEMBLY.prt, C102-000 TOP LAYOUT.prt, C102-501 TOP STRUCTURE ASSEMBLY.prt]
2025-09-24 Added customer parts
    [C100-000 LAYOUT.prt, C100-501 CAN CRUSHER ASSEMBLY.prt, C101-000 BOTTOM LAYOUT.prt, C104-000 FLUIDS PANEL LAYOUT.prt, C105-000 CUSTOMER HARDWARE LAYOUT.prt, C105-001 CUSTOMER AIRFRAME.prt, C105-002 CUSTOMER CONNECTOR.prt, C105-003 CONNECTOR BRACKET.prt]
2025-09-25 Add files via upload
    small tweaks - threads in cad. will work w/ mcm slot cutter
    [C103-000 ACTUATOR LAYOUT.prt]
2025-09-25 some top str stuff
    [C102-000 TOP LAYOUT.prt]
2025-09-25 top structure done
    [C100-000 LAYOUT.prt, C100-501 CAN CRUSHER ASSEMBLY.prt, C101-001 STRUT.prt, C101-001M10 STRUT WATERJET.prt, C101-001M10 STRUT.prt, C101-002 HUB.prt, C101-501 BOTTOM STRUCTURE ASSEMBLY.prt, C102-000 TOP LAYOUT.prt]
2025-09-25 a lot of str stuff
    [C100-000 LAYOUT.prt, C101-000 BOTTOM LAYOUT.prt, C101-001 STRUT.prt, C101-001M10 STRUT WATERJET.prt, C101-002 HUB.prt, C101-501 BOTTOM STRUCTURE ASSEMBLY.3mf, C102-000 TOP LAYOUT.prt, C102-001 TOP STRUT.prt]
2025-09-25 All cable hardware
    [3014T491_Steel Eyebolt with Shoulder - for Lifting.STEP, 60355K185_Ball Bearing.STEP, 60645K141_Ball Joint Rod End.STEP, 8-24_SPHERICAL_ROD.prt, 97245A331_Zinc-Plated 1004-1045 Carbon Steel Clevis Pin.STEP, 98306A554_1004-1045 Carbon Steel Clevis Pin.STEP, 98306A923_1004-1045 Carbon Steel Clevis Pin.STEP, C100-000 LAYOUT.prt]
2025-09-27 update pulley dia
    [C100-501 CAN CRUSHER ASSEMBLY.prt, C101-000 BOTTOM LAYOUT.prt, C101-001 STRUT.prt, C101-001M10 STRUT WATERJET.prt, C101-002 HUB.prt, C101-501 BOTTOM STRUCTURE ASSEMBLY.prt, C106-001 PULLEY.prt, C106-002 PULLEY PLATE.prt]
2025-09-27 fix broken mcm links
    [C100-000 LAYOUT.prt, C101-000 BOTTOM LAYOUT.prt, C102-000 TOP LAYOUT.prt, C105-000 CUSTOMER HARDWARE LAYOUT.prt, C105-002 CUSTOMER CONNECTOR.prt, C105-003 CONNECTOR BRACKET.prt, C106-001 PULLEY.prt, C106-501 PULLEY CHAN ASSEMBLY.prt]
2025-09-27 pulley cad
    [8947T18_Oval-Shaped Threaded Connecting Link.STEP, C100-000 LAYOUT.prt, C100-501 CAN CRUSHER ASSEMBLY.prt, C101-000 BOTTOM LAYOUT.prt, C101-001 STRUT.prt, C101-002 HUB.prt, C102-000 TOP LAYOUT.prt, C102-001 TOP STRUT.prt]
2025-09-27 broke out layout into PN
    RE: Layout files
    https://preview.redd.it/6sfha4wsu5x11.png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
    [C103-000 ACTUATOR LAYOUT.prt, C103-001 CYLINDER TOP CAP.prt, C103-002 CYLINDER WALL.prt, C103-003 CYLINDER BOTTOM CAP.prt, C103-006 CABLE NUT.prt, C103-105 CYLINDER SHAFT.prt, C104-004 CYLINDER PISTON.prt]
2025-09-27 unfucked NX versions
    [C103-000 ACTUATOR LAYOUT.prt, C103-001 CYLINDER TOP CAP.prt, C103-002 CYLINDER WALL.prt, C103-003 CYLINDER BOTTOM CAP.prt, C103-004 CYLINDER PISTON.prt, C103-005 CYLINDER SHAFT.prt, C103-006 CABLE NUT.prt]
2025-09-27 ok like fr this time
    extended shaft ~0.3". created 501. unfucked datums. unfucked c103-006 (missing all part data)
    [C103-001 CYLINDER TOP CAP.prt, C103-002 CYLINDER WALL.prt, C103-003 CYLINDER BOTTOM CAP.prt, C103-004 CYLINDER PISTON.prt, C103-005 CYLINDER SHAFT.prt, C103-006 CABLE NUT.prt, C103-501 ACTUATOR ASSEMBLY.prt]
2025-09-27 extended shafts to clear struts
    [C103-000 ACTUATOR LAYOUT.prt, C103-501 ACTUATOR ASSEMBLY.prt]
2025-09-27 e/D correction for plates
    [C103-000 ACTUATOR LAYOUT.prt]
2025-09-28 Prelim Single Stepper Controller
2025-09-29 Fixed powerpoint arrows, started regulator mount, added stepper COTS
    [17HS15-1504S-Nema 17 Stepper Motor.STEP, C101-000 BOTTOM LAYOUT.prt, C104-000 FLUIDS PANEL LAYOUT.prt]
2025-09-29 push small cad interface changees
    [C100-000 LAYOUT.prt, C100-501 CAN CRUSHER ASSEMBLY.prt, C101-001 STRUT.prt, C101-001M10 STRUT WATERJET.prt, C101-002 HUB.prt, C101-501 BOTTOM STRUCTURE ASSEMBLY.prt, C102-000 TOP LAYOUT.prt, C102-001 TOP STRUT.prt]
2025-09-29 Small strut updates, FEM GEOM export
    [C100-000 LAYOUT.prt, C100-501 CAN CRUSHER ASSEMBLY.prt, C101-000 BOTTOM LAYOUT.prt, C101-001 STRUT.prt, C101-002 HUB.prt, C105-000 CUSTOMER HARDWARE LAYOUT.prt, C105-001 CUSTOMER AIRFRAME.prt, C105-002 CUSTOMER CONNECTOR.prt]
2025-09-30 worked on regulatorstepper motor
    [C104-000 FLUIDS PANEL LAYOUT.prt]
2025-10-01 chunkify the hub
    [C100-000 LAYOUT.prt, C100-501 CAN CRUSHER ASSEMBLY.prt, C101-000 BOTTOM LAYOUT.prt, C101-002 HUB.prt, R101 BOT STR FEA EXPORT.prt, R101 BOT STR FEA EXPORT_stp.prt, R101 CHUNKY_HUB.stp, R101 CHUNKY_HUB_stp.prt]
2025-10-01 structure Optimize for p05 FEM
    [C100-000 LAYOUT.prt, C100-501 CAN CRUSHER ASSEMBLY.prt, C101-000 BOTTOM LAYOUT.prt, C101-001 STRUT.prt, C101-001M10 STRUT WATERJET.prt, C101-002 HUB.prt, C102-000 TOP LAYOUT.prt, C102-001 TOP STRUT.prt]
2025-10-01 working on fluids
    [C104-000 FLUIDS PANEL LAYOUT.prt]
2025-10-01 backup push before I reattach regulator and stepper sketches
    [C100-000 LAYOUT.prt, C104-000 FLUIDS PANEL LAYOUT.prt]
2025-10-01 Revert "backup push before I reattach regulator and stepper sketches"
    This reverts commit 7e4f2630110d1c8547aeefbc044e69c055031d31.
    [C100-000 LAYOUT.prt, C104-000 FLUIDS PANEL LAYOUT.prt]
2025-10-01 fluids panel layout moved
    [C100-000 LAYOUT.prt, C104-000 FLUIDS PANEL LAYOUT.prt]
2025-10-01 regulator spinner is ready for first test prints
    [C100-000 LAYOUT.prt, C104-000 FLUIDS PANEL LAYOUT.prt]
2025-10-02 worked on fluids panel
    [C100-000 LAYOUT.prt, C104-000 FLUIDS PANEL LAYOUT.prt]
2025-10-02 Update C104-000 FLUIDS PANEL LAYOUT.prt
    [C104-000 FLUIDS PANEL LAYOUT.prt]
2025-10-02 Oh no I saved the layout
    [C100-000 LAYOUT.prt, C105-000 CUSTOMER HARDWARE LAYOUT.prt]
2025-10-02 bracket update
    [C100-000 LAYOUT.prt, C105-000 CUSTOMER HARDWARE LAYOUT.prt, C105-003 CONNECTOR BRACKET.prt, R101 BOT STR FEA EXPORT.prt]
2025-10-03 bracket wall thickness
    [C100-000 LAYOUT.prt, C101-000 BOTTOM LAYOUT.prt, C105-000 CUSTOMER HARDWARE LAYOUT.prt, C105-002 CUSTOMER CONNECTOR.prt, C105-003 CONNECTOR BRACKET.prt, C105-501 CUSTOMER HARDWARE ASSEMBLY.prt, R101 BOT STR FEA EXPORT.prt]
2025-10-07 bracket change
    [C105-000 CUSTOMER HARDWARE LAYOUT.prt]
2025-10-07 top cap (the thickening)
    thickened top cap
    added countersinks
    reclocked bolts
    added NPT port
    added lower vent
    [C103-001 CYLINDER TOP CAP.prt]
2025-10-07 Update top plate
    [C103-000 ACTUATOR LAYOUT.prt]
2025-10-07 Revert "Update top plate"
    This reverts commit beb8040243b328491a5bb32fe6227d4d5ce4c54a.
    [C103-000 ACTUATOR LAYOUT.prt]
2025-10-07 Top Cap Bolts Clcokec
    [C103-000 ACTUATOR LAYOUT.prt, C103-001 CYLINDER TOP CAP.prt, C103-501 ACTUATOR ASSEMBLY.prt]
2025-10-08 7055 hubs
    [C100-000 LAYOUT.prt, C101-000 BOTTOM LAYOUT.prt, C101-001 STRUT.prt, C101-002 HUB.prt, C103-000 ACTUATOR LAYOUT.prt, C105-000 CUSTOMER HARDWARE LAYOUT.prt, R101 BOT STR FEA EXPORT.prt, R101 BOT STR FEA EXPORT.stp]
2025-10-08 added retention fasteners w/ strut to top cap
    also reclocked vessel bolts to line them up w/ strut neatly
    [C103-000 ACTUATOR LAYOUT.prt]
2025-10-09 Redo actuator assembly for nema 23
    [23HS22-2804S-Nema 23 Stepper Motor.STEP, C104-000 FLUIDS PANEL LAYOUT.prt]
2025-10-09 yes it is actually that bad
    [C100-000 LAYOUT.prt, C102-000 TOP LAYOUT.prt]
2025-10-09 pulley hardware change
    [5905K502_Needle-Roller Bearing.STEP, 60355K185_Ball Bearing.STEP, 60645K141_Ball Joint Rod End.STEP, 60645K161_Ball Joint Rod End.STEP, 97245A331_Zinc-Plated 1004-1045 Carbon Steel Clevis Pin.STEP, 98306A554_1004-1045 Carbon Steel Clevis Pin.STEP, 98306A923_1004-1045 Carbon Steel Clevis Pin.STEP, 98306A951_1004-1045 0.5in Carbon Steel Clevis Pin.STEP]
2025-10-09 working on making CAD better
    [C104-000 FLUIDS PANEL LAYOUT.prt]
2025-10-09 10/9 team note updates
    [94846A207-thin-jam-nut.prt, C103-000 ACTUATOR LAYOUT.prt, C103-005 CYLINDER SHAFT.prt, C103-006 CABLE NUT.prt, C103-501 ACTUATOR ASSEMBLY.prt]
2025-10-09 pulley updates
    [C100-000 LAYOUT.prt, C100-501 CAN CRUSHER ASSEMBLY.prt, C101-000 BOTTOM LAYOUT.prt, C101-002 HUB.prt, C101-501 BOTTOM STRUCTURE ASSEMBLY.prt, C102-000 TOP LAYOUT.prt, C102-001 TOP STRUT.prt, C102-501 TOP STRUCTURE ASSEMBLY.prt]
2025-10-09 remembering to save is hard
    [C103-000 ACTUATOR LAYOUT.prt]
2025-10-09 cycle updates in acutator
    [C100-000 LAYOUT.prt, C100-501 CAN CRUSHER ASSEMBLY.prt, C101-000 BOTTOM LAYOUT.prt, C101-001 STRUT.prt, C101-002 HUB.prt, C102-000 TOP LAYOUT.prt, C102-001 TOP STRUT.prt, C102-501 TOP STRUCTURE ASSEMBLY.prt]
2025-10-09 Revert "Merge branch 'main' of https://github.com/matt-lewton9/ME-463-Can-Crusher"
    This reverts commit e775e641d6bbd5cb5fd47636087457ecf3d820ca, reversing
    changes made to 85cdd42f97ae832ef3ad59e28afc8bfc088898ab.
    [C103-000 ACTUATOR LAYOUT.prt]
2025-10-09 z fighting isnt real and cant hurt you
    ^ that is a lie.
    [C103-000 ACTUATOR LAYOUT.prt]
2025-10-09 moved fluids panel to feature groups
    [C104-000 FLUIDS PANEL LAYOUT.prt]
2025-10-12 fix feature groups, name all features
    [C104-000 FLUIDS PANEL LAYOUT.prt]
2025-10-12 Create and wave link regulator/stepper parts
    C104-001 REGULATOR PLATE
    C104-002 STEPPER PLATE
    C104-003 FRAME
    C104-004 COG
    [C104-000 FLUIDS PANEL LAYOUT.prt, C104-001 REGULATOR PLATE.prt, C104-002 STEPPER PLATE.prt, C104-003 FRAME.prt, C104-004 COG.prt]
2025-10-12 create fluids panel assembly
    [C104-501 FLUIDS PANEL ASSEMBLY.prt]
2025-10-13 Pneumatic FEA assembly
    [R201 Pneumatic FEA Assembly.prt]
2025-10-13 add COTS stepper to C104-500 FLUIDS PANEL ASSEMBLY
    [C104-000 FLUIDS PANEL LAYOUT.prt, C104-501 FLUIDS PANEL ASSEMBLY.prt]
2025-10-15 Digital Twinning
    [90128A242__1-4-20_Zinc-Plated Alloy Steel Socket Head Screw.STEP, 90128A365_1-4-28_Zinc-Plated Alloy Steel Socket Head Screw.STEP, 90128A844_1-2-20_Zinc-Plated Alloy Steel Socket Head Screw.STEP, 92844A147_1-2_Stainless Steel Washer for Soft Material.STEP, 94744A516_1-4_WASHER_Zinc-Plated Steel Washer for Soft Material.STEP, 94846A210_1-2-20_JAM_NUT_Medium-Strength Steel Thin Hex Nut.STEP, 94846A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]
2025-10-15 why do I still have changes
    [C100-000 LAYOUT.prt, C102-000 TOP LAYOUT.prt, C106-000 PULLEY CHAIN LAYOUT.prt]
2025-10-15 XXXXXXXXX XXXXX XXXXXXX "digital twin"
    [C103-000 ACTUATOR LAYOUT.prt, C103-501 ACTUATOR ASSEMBLY.prt, MCM_92865A250_PNE_MAIN_BOLT.prt]
2025-10-15 add fasteners to fluids panel
    [92010A118_Passivated 18-8 Stainless Steel Phillips Flat Head Screw.STEP, 92196A268_18-8 Stainless Steel Socket Head Screw.STEP, C104-000 FLUIDS PANEL LAYOUT.prt, C104-001 REGULATOR PLATE.prt, C104-003 FRAME.prt, C104-004 CYLINDER PISTON.prt, C104-501 FLUIDS PANEL ASSEMBLY.prt, MCM_92196A268_10-32_7-16_SOCKET_HEAD_SCREW.prt]
2025-10-15 digital twin pneumatics
    to paraphrase brian herbert's aptly named book butlerian jihad: man im tired of computers
    [C103-000 ACTUATOR LAYOUT.prt, C103-501 ACTUATOR ASSEMBLY.prt, MCM_92865A250_PNE_MAIN_BOLT.prt, MCM_95505A601_PNE_MAIN_NUT.prt, MCM_98023A115_PNE_MAIN_WASHER.prt]
2025-10-15 changed hubs to orange
    [C100-501 CAN CRUSHER ASSEMBLY.prt]
2025-10-16 jam nuts
    [C103-501 ACTUATOR ASSEMBLY.prt]
2025-10-16 model regulator
    [C104-000 FLUIDS PANEL LAYOUT.prt, C104-002 STEPPER PLATE.prt, C104-004 COG.prt, C104-501 FLUIDS PANEL ASSEMBLY.prt, R00-01R Regulator.prt]
2025-10-16 color fluids panel
    [C104-002 STEPPER PLATE.prt, C104-003 FRAME.prt, C104-004 COG.prt, C104-501 FLUIDS PANEL ASSEMBLY.prt, R00-01R Regulator.prt]
2025-10-17 FEA assembly Pneumatic
    [R201 Pneumatic FEA Assembly.prt]
2025-10-17 Initial Fluid Panel Design
    [C103-000 ACTUATOR LAYOUT.prt, C104-000 FLUIDS PANEL LAYOUT.prt, C104-005 Panel.prt, C104-006 Manifold.prt, C104-007 Regulator.prt]
2025-10-18 fluids pannel added
    [C104-000 FLUIDS PANEL LAYOUT.prt, C104-001 REGULATOR PLATE.prt, C104-002 STEPPER PLATE.prt, C104-003 FRAME.prt, C104-004 COG.prt, C104-005 Panel.prt, C104-006 Manifold.prt, C104-007 Regulator.prt]
2025-10-18 added mounting holes to manifold
    [C104-000 FLUIDS PANEL LAYOUT.prt]
2025-10-20 Fluids panel Progress
    [C100-501 CAN CRUSHER ASSEMBLY.prt, C104-001 REGULATOR PLATE.prt, C104-005 Panel.prt, C104-006 Manifold.prt, C104-501 FLUIDS PANEL ASSEMBLY.prt, R00-01R Regulator.prt, R00-02R union.prt]
2025-10-21 fix fluids panel
    - Fixed fluids panel layout feature ordering
    - Added fluids panel mounting holes to one frame part
    - Split frame into FRAME BASE and FRAME MOUNTING
    - Recolored assembly
    [C104-001 REGULATOR PLATE.prt, C104-002 STEPPER PLATE.prt, C104-003 FRAME MOUNTING.prt, C104-003 FRAME.prt, C104-009 FRAME BASE.prt, C104-501 FLUIDS PANEL ASSEMBLY.prt, R00-01R Regulator.prt]
2025-10-22 Jam Nuts in pulley system
    [94846A209_NUT-1-2-13_THIN.STEP, C100-000 LAYOUT.prt, C100-501 CAN CRUSHER ASSEMBLY.prt, C105-000 CUSTOMER HARDWARE LAYOUT.prt, C105-002 CUSTOMER CONNECTOR.prt, C105-003 CONNECTOR BRACKET.prt, C106-000 PULLEY CHAIN LAYOUT.prt, C106-001 PULLEY.prt]
2025-10-22 fluids panel done
    [C104-005 Panel.prt]
2025-10-22 strut hole update
    [C101-000 BOTTOM LAYOUT.prt, C101-001 STRUT.prt]
2025-10-23 fix regulator
    [C104-501 FLUIDS PANEL ASSEMBLY.prt, R00-01R Regulator.prt]
2025-10-23 move union part so it loads
    [R00-02R union.prt]
2025-10-23 color parts
    [C100-000 LAYOUT.prt, C100-501 CAN CRUSHER ASSEMBLY.prt, C101-001 STRUT.prt, C101-002 HUB.prt, C101-501 BOTTOM STRUCTURE ASSEMBLY.prt, C102-001 TOP STRUT.prt, C103-001 CYLINDER TOP CAP.prt, C103-002 CYLINDER WALL.prt]
2025-10-23 color assembly
    [94846A207-thin-jam-nut.prt, C100-501 CAN CRUSHER ASSEMBLY.prt, C101-002 HUB.prt, C103-001 CYLINDER TOP CAP.prt, C103-002 CYLINDER WALL.prt, C103-003 CYLINDER BOTTOM CAP.prt, C103-005 CYLINDER SHAFT.prt, C103-006 CABLE NUT.prt]
2025-10-23 put screenshots in report
    [C100-501 CAN CRUSHER ASSEMBLY.prt, C101-001 STRUT.prt, C101-501 BOTTOM STRUCTURE ASSEMBLY.prt, C103-001 CYLINDER TOP CAP.prt, C103-004 CYLINDER PISTON.prt, C103-005 CYLINDER SHAFT.prt, C104-004 COG.prt, C105-001 CUSTOMER AIRFRAME.prt]
2025-10-23 small changes
    [C100-501 CAN CRUSHER ASSEMBLY.prt, C104-501 FLUIDS PANEL ASSEMBLY.prt, R00-01R Regulator.prt, SO_23HS22-2804S_NEMA23.prt]
2025-10-23 color manifold
    [C104-006 Manifold.prt]
2025-10-24 hub and customer AF dwgs
    [C100-000 LAYOUT.prt, C100-501 CAN CRUSHER ASSEMBLY.prt, C101-000 BOTTOM LAYOUT.prt, C101-001 STRUT_dwg1.prt, C101-002 HUB.prt, C101-002 HUB_dwg1.prt, C101-501 BOTTOM STRUCTURE ASSEMBLY.prt, C105-001 CUSTOMER AIRFRAME_dwg1.prt]
2025-10-24 exploded view
    [C100-501 CAN CRUSHER ASSEMBLY.prt, C104-001 REGULATOR PLATE.prt, C104-002 STEPPER PLATE.prt, C104-003 FRAME MOUNTING.prt, C104-006 Manifold.prt, C104-009 FRAME BASE.prt, C104-501 FLUIDS PANEL ASSEMBLY.prt, MCM_92196A268_10-32_7-16_SOCKET_HEAD_SCREW.prt]
2025-10-25 All Matt's dwgs
    [C100-000 LAYOUT.prt, C101-001 STRUT_dwg1.prt, C101-002 HUB_dwg1.prt, C102-000 TOP LAYOUT.prt, C102-001 TOP STRUT.prt, C102-001 TOP STRUT_dwg1.prt, C102-002 PULLEY PLATE.prt, C105-001 CUSTOMER AIRFRAME_dwg1.prt]
2025-10-27 Drawing stuff
    [C102-001 TOP STRUT_dwg1.prt, C103-001 CYLINDER TOP CAP.prt]
2025-10-27 spruce up for jensen
    [C101-001 STRUT_dwg1.prt, C101-001M10 STRUT WATERJET.prt, C101-002 HUB_dwg1.prt, C102-001 TOP STRUT_dwg1.prt, C105-002 CUSTOMER CONNECTOR_dwg1.prt, C105-003 CONNECTOR BRACKET_dwg1.prt, C106-001 PULLEY_dwg1.prt]
2025-10-27 fixe cable nut pattern
    [C100-501 CAN CRUSHER ASSEMBLY.prt, C103-501 ACTUATOR ASSEMBLY.prt]
2025-10-27 add frame mounting holes
    [C100-501 CAN CRUSHER ASSEMBLY.prt]
2025-10-27 start drawings
    [C100-000 LAYOUT.prt, C100-501 CAN CRUSHER ASSEMBLY.prt, C104-001 REGULATOR PLATE.prt, C104-001 REGULATOR PLATE_dwg1.prt, TEMPLATE.prt]
2025-10-27 drwaings pdf
    [C103-001 CYLINDER TOP CAP.prt, C103-003 CYLINDER BOTTOM CAP.prt, C103-004 CYLINDER PISTON.prt]
2025-10-27 revision 1 of many
    [C103-001 CYLINDER TOP CAP.prt, C103-003 CYLINDER BOTTOM CAP.prt]
2025-10-27 drawing revision2 out of infintity
    [C100-501 CAN CRUSHER ASSEMBLY.prt, C103-001 CYLINDER TOP CAP.prt, C103-003 CYLINDER BOTTOM CAP.prt]
2025-10-27 drawing revision
    [C103-001 CYLINDER TOP CAP.prt]
2025-10-28 audrey feedback changes
    [C101-001 STRUT_dwg1.prt, C101-002 HUB_dwg1.prt, C102-001 TOP STRUT_dwg1.prt, C105-001 CUSTOMER AIRFRAME_dwg1.prt, C105-002 CUSTOMER CONNECTOR_dwg1.prt, C105-003 CONNECTOR BRACKET_dwg1.prt, C106-001 PULLEY_dwg1.prt]
2025-10-28 drawing/fluids panel
    [C103-001 CYLINDER TOP CAP.prt, C104-501 FLUIDS PANEL ASSEMBLY.prt]
2025-10-28 CAP DWGS
    [C103-000 ACTUATOR LAYOUT.prt, C103-001 CYLINDER TOP CAP.prt, C103-003 CYLINDER BOTTOM CAP.prt]
2025-10-28 added fluids panel mounting holes
2025-10-28 Update C101-001 STRUT_dwg1.prt
    Checked and Approved
    [C101-001 STRUT_dwg1.prt]
2025-10-28 fix frames, add frame drawing
    [C104-003 FRAME MOUNTING.prt, C104-003 FRAME MOUNTING_dwg1.prt, C104-009 FRAME BASE.prt, TEMPLATE.prt]
2025-10-28 Update C102-001 TOP STRUT_dwg1.prt
    CHECKED AND APPROVED
    [C102-001 TOP STRUT_dwg1.prt]
2025-10-29 Update C105-001 CUSTOMER AIRFRAME_dwg1.prt
    [C105-001 CUSTOMER AIRFRAME_dwg1.prt]
2025-10-29 Update C101-002 HUB_dwg1.prt
    [C101-002 HUB_dwg1.prt]
2025-10-29 CHECKED AND APPROVED
    [C105-002 CUSTOMER CONNECTOR_dwg1.prt]
2025-10-29 shaft dwg approve
    [C103-005 CYLINDER SHAFT_dwg.prt]
2025-10-29 ADDED APPROVAL
    [C103-003 CYLINDER BOTTOM CAP.prt]
2025-10-29 drwaings, starting estop
    [C104-001 REGULATOR PLATE.prt, C104-001 REGULATOR PLATE_dwg1.prt, C104-003 FRAME MOUNTING_dwg1.prt, C107-000 ESTOP BOX LAYOUT.prt, FW-LOCK-NUT.prt, TEMPLATE.prt, YW-CN(-N).prt, YW-Exx(R).prt]
2025-10-29 fix fluids panel cog not working in drawing
    [C104-001 REGULATOR PLATE_dwg1.prt, C104-002 STEPPER PLATE.prt, C104-002 STEPPER PLATE_dwg1.prt, C104-004 COG.prt, C104-004 COG_dwg1.prt, C104-501 FLUIDS PANEL ASSEMBLY.prt, TEMPLATE.prt]
2025-10-29 fluid panel
    [C104-005 Panel.prt]
2025-10-29 REVISION 1 FLUIDS PANEL
    [C104-005 Panel.prt]
2025-10-29 fix drawings
    [C104-001 REGULATOR PLATE_dwg1.prt, C104-002 STEPPER PLATE_dwg1.prt, C104-003 FRAME MOUNTING_dwg1.prt, C104-004 COG.prt, C104-004 COG_dwg1.prt, TEMPLATE.prt]
2025-10-29 PUSH FLUIDS
    [C104-005 Panel.prt]
2025-10-29 Trevor's 3d print drawings approved
    [C103-004 CYLINDER PISTON.prt, C104-001 REGULATOR PLATE_dwg1.prt, C104-002 STEPPER PLATE_dwg1.prt, C104-003 FRAME MOUNTING_dwg1.prt, C104-004 COG_dwg1.prt]
2025-10-29 piston dwg
    [TEMPLATE_cyl.prt]
2025-10-29 rename to C103-004 PISTON PRE-RELEASE
    [C103-004 PISTON PRE-RELEASE.prt]
2025-10-29 git hub
    [C103-004 PISTON PRE-RELEASE.prt]
2025-10-29 many folds or something idk man
    [C103-006 MANIFOLD.prt]
2025-10-29 added e-stop box
    [C107-000 ESTOP BOX LAYOUT.prt]
2025-10-29 rev to dims
    [C103-006 MANIFOLD_PRE-RELEASE.prt]
2025-10-29 removed duplicate dims
    [C103-006 MANIFOLD_PRE-RELEASE.prt]
2025-10-29 fixed mount scew dims
    [C103-006 MANIFOLD_PRE-RELEASE.prt]
2025-10-29 rev 1.1 fixed mount holes again
    [C103-006 MANIFOLD_PRE-RELEASE.prt]
2025-10-29 rev 2
    [C103-006 MANIFOLD_PRE-RELEASE.prt]
2025-10-30 panel push
    [C104-005 Panel.prt]
2025-10-30 work on estop
    [C107-000 ESTOP BOX LAYOUT.prt]
2025-10-31 working assy drawings
    [TEMPLATE.prt]
2025-10-31 pulley changes
    [C103-002 CYLINDER WALL PRE-RELEASE.prt, C103-004 PISTON PRE-RELEASE.prt, C103-006 MANIFOLD_PRE-RELEASE.prt, C106-000 PULLEY CHAIN LAYOUT.prt, C106-001 PULLEY.prt, C106-001 PULLEY_dwg1.prt, STRUT_DXF.dxf]
2025-10-31 man
    plug walk
    [C103-002 CYLINDER WALL PRE-RELEASE.prt, C103-004 PISTON PRE-RELEASE.prt, C103-006 MANIFOLD_PRE-RELEASE.prt]
2025-10-31 assy drawings done in prt file
    [C103-501 ACTUATOR ASSEMBLY.prt, TEMPLATE.prt]
2025-10-31 preliminary assembly drawing pdfs
2025-10-31 Approve julian's drawings
    [C103-006 MANIFOLD_PRE-RELEASE.prt]
2025-10-31 assembly prerelease drawings
2025-10-31 oops, repush
    [C103-002 CYLINDER WALL PRE-RELEASE.prt, C103-004 PISTON PRE-RELEASE.prt, C103-006 MANIFOLD_PRE-RELEASE.prt]
2025-11-01 WORKING ON EXPLOSIONS
    [TEMPLATE.prt]
2025-11-01 SOME FLUIDS PANEL
    [C104-005 Panel.dwg, C104-005 Panel.prt, C104-006 Manifold.prt, C104-007 Tube2_Manifold_to_R2.prt, C104-008 Tube4_NC_To_Manifold.prt, C104-009 NC VALVE.prt, C104-501 FLUIDS PANEL ASSEMBLY.prt]
2025-11-01 Panel Assembly
    [C104-001 REGULATOR PLATE.prt, C104-003 FRAME MOUNTING.prt, C104-007 NC TO MANIFOLD TUBE.prt, C104-008 MANIFOLD TO RV1.prt, C104-010 MANIFOLD TO RV2.prt, C104-011 MANIFOLD TO RV3.prt, C104-501 FLUIDS PANEL ASSEMBLY.prt, MCM_91251A346_10-32_7_8.prt]
2025-11-01 BROKEN ASSEMBLY DRAWINGS
2025-11-02 added .stl files, modified cog, updated dwg
    [C104-001 REGULATOR PLATE.stl, C104-002 STEPPER PLATE.stl, C104-003 FRAME MOUNTING.stl, C104-004 COG.prt, C104-004 COG.stl, C104-004 COG_dwg1.prt]
2025-11-02 add protection for stepper mounting screw pokey bits
2025-11-02 slightly embiggen stepper shaft hole
2025-11-02 update stls
    [C104-004 COG.stl]
2025-11-02 fix stepper plate, update drawing to add pokey-bit protection
    [C104-002 STEPPER PLATE.prt, C104-002 STEPPER PLATE_dwg1.prt, C104-004 COG.prt]
2025-11-03 add estop layout to C100-000 LAYOUT, add estop box drawing
    [C100-000 LAYOUT.prt, C101-000 BOTTOM LAYOUT.prt, C102-000 TOP LAYOUT.prt, C104-003 FRAME MOUNTING.prt, C107-000 ESTOP BOX LAYOUT.prt, C107-001 ESTOP LID.prt, C107-001 ESTOP LID_dwg1.prt, C107-002 ESTOP BOX.prt]
2025-11-05 e-stop box work, stls
    [C104-001 REGULATOR PLATE.prt, C104-001 REGULATOR PLATE.stl, C104-001 REGULATOR PLATE_0_DEG.stl, C104-001 REGULATOR PLATE_22-5_DEG.stl, C104-002 STEPPER PLATE.prt, C104-003 FRAME MOUNTING.prt, C104-003 FRAME MOUNTING.stl, C104-004 COG.stl]
2025-11-06 Add XT-60 connector to E-stop box, update e-stop box drawings
    [C107-000 ESTOP BOX LAYOUT.prt, C107-001 ESTOP LID.prt, C107-001 ESTOP LID_dwg1.prt, C107-002 ESTOP BOX.prt, C107-002 ESTOP BOX_dwg1.prt]
2025-11-06 fix piston dwg
    [C103-002 CYLINDER WALL PRE-RELEASE.prt, C103-004 PISTON PRE-RELEASE.prt]
2025-11-06 Valve added
    [C104-501 FLUIDS PANEL ASSEMBLY.prt]
2025-11-06 Update C107-001 ESTOP LID_dwg1.prt
    [C107-001 ESTOP LID_dwg1.prt]
2025-11-06 jig update
    [R00-003 Customer Jig Connector.3mf, R00-003 Customer Jig Connector.prt]
2025-11-12 Fix acutator dwgs
    [C103-000 ACTUATOR LAYOUT.prt, C103-002 CYLINDER WALL PRE-RELEASE.prt, C103-002 CYLINDER WALL.prt, C103-004 PISTON PRE-RELEASE.prt, pulley_plates.dxf]
2025-11-15 code for trevor
    [R00-003 Customer Jig Connector.3mf, R00-003 Customer Jig Connector.prt, R00-003 Customer Jig Connector.stl]
2025-11-16 code to read PT in arduino and send to matlab over serial
    ard.ino is arduino sketch that waits until it receives a signal over serial, then reads the PT and sends pressure over serial
    read_from_arduino.m sends a signal to arduino to read pressure, then receives result
2025-11-16 stepper stepper
2025-11-16 stepper testing
2025-11-18 controller / gui
    [customer_inputs.xlsx]
2025-11-18 PT box
    [C108-000 PT BOX LAYOUT.prt]
2025-11-18 add PT reading
    [customer_inputs.xlsx]
2025-11-18 arduino server changes
2025-11-19 steppers working with stepper server
2025-11-19 update PT box
    [C108-000 PT BOX LAYOUT.prt]
2025-11-19 resize cog
    Tighten fit of cog on stepper shaft, re-export to print in PLA
    [C104-004 COG.3mf, C104-004 COG.prt]
2025-11-19 working on PT box lid and strain gauge box
    [C108-000 PT BOX LAYOUT.prt, C109-000 SG BOX LAYOUT.prt]
2025-11-19 update controller to add direction inputs for motors
2025-11-19 update drive steppers.m to include direction and clip values sent
2025-11-19 controller ready for testing?
    [customer_inputs.xlsx]
2025-11-19 stepper driver mount
    [C110-000 DRIVER 8020 MOUNT.prt]
2025-11-20 fix server code to get all 3 motors running
    [arduino_server.ino]
2025-11-20 Finish box for strain gauges
    [C109-000 SG BOX LAYOUT.prt]
2025-11-20 updated with the calibration values for each SG
2025-11-21 update customer input files
    [customer_inputs.xlsx, customer_inputs_CUSTOMER_0_DEG.xlsx, customer_inputs_CUSTOMER_180_DEG .xlsx, customer_inputs_MX_BEND_0_DEG.xlsx, customer_inputs_MX_BEND_180_DEG.xlsx, customer_inputs_MX_COMP_0_DEG.xlsx]
2025-11-21 after first test
    remove outliers when plotting
    [Force_commanded.csv, PT_readings.csv, SG_readings.csv, Steps_commanded.csv]
2025-11-21 add logic to zero strain gauges, put PT math inside sensors_read
    zero strain gauge readings by taking readings of strain when unloaded
    move logic to convert from raw PT to PSI to inside sensors_read.m for consistency
2025-11-21 testing code
    [Force_commanded.csv, PT_readings.csv, SG_readings.csv, Steps_commanded.csv]
2025-11-21 1st test
    [Force_commanded.csv, PT_readings.csv, SG_readings.csv, Steps_commanded.csv, customer_inputs_MX_COMP_0_DEG.xlsx]
2025-11-22 pushypushhy pweeze
    [Force_commanded.csv, PT_readings.csv, SG_readings.csv, Steps_commanded.csv, customer_inputs_CUSTOMER_0_DEG.xlsx, customer_inputs_CUSTOMER_180_DEG .xlsx, customer_inputs_CUSTOMER_180_DEG.xlsx, customer_inputs_MX_BEND_0_DEG.xlsx]
2025-11-22 updated SG calibration values
2025-11-22 rename folder so it can be pulled on windows
    folder had ?! in it, which can't be used in filenames on windows
    [Force_commanded.csv, PT_readings.csv, SG_readings.csv, Steps_commanded.csv]
2025-11-25 making sum plots
    [Force_commanded.csv, PT_readings.csv, SG_readings.csv, Steps_commanded.csv]
2025-11-29 bryce does data
    [Force_commanded.csv, PT_readings.csv, SG_readings.csv, Steps_commanded.csv]
2025-11-30 bryce plotter
    [PT_readings.csv, SG_readings.csv]
2025-12-01 test data and updated plotters
    [Force_commanded.csv, MX_BEND_180_DEG.xlsx, PT_readings.csv, SG_readings.csv, Steps_commanded.csv, customer_inputs_MX_BEND_0_DEG.xlsx, customer_inputs_MX_BEND_120_DEG.xlsx, customer_inputs_MX_BEND_180_DEG.xlsx]
2025-12-03 fea model
    [R103 INTEGRATED FEA EXPORT.prt]
2025-12-06 Add estop box assembly drawing (in pre-release folder)
    [C107-000 ESTOP BOX LAYOUT.prt, C107-501 ESTOP BOX ASSEMBLY.prt]
2025-12-12 Updated drawings
    [C101-001 STRUT_dwg1.prt, C103-001 CYLINDER TOP CAP.prt, C103-002 CYLINDER WALL PRE-RELEASE.prt, C103-003 CYLINDER BOTTOM CAP.prt, C103-004 PISTON PRE-RELEASE.prt, C103-005 CYLINDER SHAFT_dwg.prt, C103-006 MANIFOLD_PRE-RELEASE.prt, C104-001 REGULATOR PLATE_dwg1.prt]
2025-12-12 Update E100-001 ELECTRICAL SCHEMATIC.pdf
